mattvenn/ook-asic-radio/README.md

  

# 433 MHz OOK radio on Tiny Tapeout (sky130, ttsky26d)



A mixed-signal Tiny Tapeout project: two demo boards with the same chip talk over the air with
bare-wire dipole antennas and no external components. It should get to roughly 80 m in good conditions (estimate: the bench path loss plus the new transmitter's simulated power).

- **TX:** an on-chip ring oscillator at ~433 MHz, keyed on and off (OOK), with antiphase drivers into a dipole.
- **RX:** a 6-stage NMOS differential-pair limiting chain with a successive-detection log detector, and one comparator with an averaged, trimmed threshold. A digital Gold-code correlator detects the transmitter's code and toggles an LED.

> **Radio regulations.** This is an experimental, uncertified transmitter. Its free-running ring oscillator is not tuned: it can land anywhere in about 330–560 MHz (~448 MHz typical), mostly outside the narrow 433.05–434.79 MHz licence-exempt band, and its square-wave output has strong harmonics. That range includes frequencies used by aviation, emergency services and the 406 MHz distress beacons. Power is low (about +3 dBm, 2 mW, into the dipole), but transmitting over the air may need an amateur radio licence (the 70 cm band is 420–450 MHz in the US, 430–440 MHz in the UK and much of Europe), and where the chip lands outside the amateur band it may not be legal at all. Measure the frequency with an SDR first, keep transmissions short, and prefer the cabled link test ([docs/bringup.md](docs/bringup.md)). Receiving is fine. You are responsible for following your local rules.

Docs:
- [Interactive explainer](https://mattvenn.github.io/ook-asic-radio/docs/explainer.html): click through the link, TX and RX chains with simulated waveforms ([source](docs/explainer)).
- [docs/how_it_works.md](docs/how_it_works.md): **start here**: theory, specs, schematics and layout.
- [docs/verification.md](docs/verification.md): testing and verification, with links to every test.
- [PLAN.md](PLAN.md): the design plan and the measurements behind each decision.
- [docs/slicer.md](docs/slicer.md): how the receiver's comparator and trim servo work.
- [docs/info.md](docs/info.md): the datasheet (short test instructions).

## Layout of this repo
Follows the TT analog template flow used for `mattvenn/tt08-analog-r2r-dac-3v3`:

| Path | Contents |
|---|---|
| `info.yaml`, `docs/info.md`, `src/project.v` | TT project files; `src/project.v` is the LVS stub |
| `mag/` | Magic layout and the `make start / drc / lvs` flow (2x2 + VAPWR template) |
| `gds/`, `lef/` | Layout outputs |
| `xschem/`, `sim/` | Analog schematics, testbenches, ngspice runs |
| `verilog/rtl`, `verilog/test` | Digital macro `radio_digital` and its cocotb tests (vectors from the model) |
| `openlane/radio_digital` | Hardening config for the digital macro |
| `model/` | Bit-exact Python model and the RX performance studies |
| `bench/`, `stim/` | Phase-0 bench tools, measurements and recorded RF stimuli |
| `tools/osic` | Runs IIC-OSIC-TOOLS commands headless from this repo |

## Resources
- [Analog specs](https://tinytapeout.com/specs/analog/)
- [Tiny Tapeout](https://tinytapeout.com)
- [Zero to ASIC courses](https://zerotoasiccourse.com)
