mattvenn/ook-asic-radio/docs/sim_learnings.md

# xschem + ngspice (sky130) simulation learnings

Collected from asic-radio (ttsky26d) and mini-mosbius-configurator. These were
found the hard way; each one cost time at least once. Tool versions:
IIC-OSIC-TOOLS `hpretl/iic-osic-tools:2026.05` (ngspice 46, xschem 3.4.x),
sky130A, run headless in Docker.

## Speed

- **`.spiceinit` is read only from ngspice's current directory.** Keep one
  tracked file and copy it to wherever ngspice runs (for example `build/`). A
  wrapper script that does the copy on every run stops it drifting.
  ```
  set skywaterpdk
  set ng_nomodcheck
  set num_threads=8
  option noinit
  ```
- **`option klu` breaks `.noise`** in ngspice 46 ("Noise simulation is not
  (yet) supported with 'option KLU'"). Keep it out of the shared `.spiceinit`;
  put `.options klu` only in decks that are big transients with no noise
  analysis.
- **Never `set ngbehavior=hsa`.** It changes the default element scale
  factor. Bin selection then fails for the binned HV FET models
  (`sky130_fd_pr__nfet_g5v0d10v5` / `pfet_g5v0d10v5`, which the TT pad model
  uses), with "could not find a valid modelname".
- **Loading the model library is a fixed cost for every ngspice process.**
  The sky130 combined lib parse is ~15–25 s here and ~2 min reported elsewhere
  ([IIC-OSIC-TOOLS#262](https://github.com/iic-jku/IIC-OSIC-TOOLS/issues/262)).
  So sweep inside one process:
  ```
  foreach w 10 20 40
    alterparam w_dp = $w
    reset
    ac lin 1 433.92e6 433.92e6
    ...
    destroy all
  end
  ```
  `alterparam` needs `reset` to take effect. `destroy all` stops plots piling
  up in memory.
- **Don't run several ngspice processes in parallel blindly.** Each one starts
  `num_threads` OpenMP threads. Six processes on 8 cores gave a load average
  of 48, and nothing finished in 48 min. Run in sequence, or cut
  `num_threads`. Check with `uptime`.
- **`.save` only the vectors you measure in long transients.** For example,
  3 µs at 50 ps is 60k points × every node. With `.save v(det) v(out_p)
  v(out_n)` and one process at a time, it ran in ~47 s per case.
- **Floating nodes make it slow.** A node with no DC path made the operating
  point re-solve at every sweep point: 123 s against 25 s. Check that every
  node has a DC path to a source. Gates and capacitors don't count; MOSFET
  D-S-B and inductors do.
- **Avoid extreme resistor ratios.** 1e-12 Ω / 1e12 Ω ties hung ngspice for
  50+ min; 1 Ω / 1e9 Ω ran in seconds. ngspice also silently swaps a 0 Ω
  resistor for 1e-12.
- **"memory required ... is more than memory available" is about *free* RAM, not available RAM.** ngspice doesn't count the page cache. With 19 GiB available but 0.4 GiB free, an 80 ns / 2 ps transient saving every node died. `.save` only the measured vectors (it applies to `op` too, so list the ones the op echoes read).
- **Small probe first:** time a short run (e.g. 0.2 µs instead of 3 µs) and
  extrapolate before committing to a long one. **But the probe has to cover
  the hardest regime.** A 2 µs probe with the carrier still off predicted
  2.5 h per 400 µs. Once the carrier was on, the limiting stages switched
  hard and the run went ~5–10× slower.
- **Long runs: keep the PC awake and detach.** The PC suspended overnight;
  the job survived but made no progress. Use
  `systemd-inhibit --what=sleep:idle ...` around the job (asic-radio:
  `tools/longrun <name> <cmd>`, detached, logged, with a done marker).
- **`write` only happens at the end of a batch run:** a killed or crashed
  long run leaves nothing. Split very long runs into pieces when you can.

- **A failed `op` silently becomes a "transient op".** When gmin and source stepping both fail, ngspice ramps the sources in a pseudo-transient and reports whatever the circuit holds at the end: slow nodes (big RC) are unsettled and supply currents include charging current, with no error. Grep the log for `Transient op started` / `singular matrix` before trusting an op. In extracted netlists the usual cause is nets with only parasitic C (unconnected pin stubs): tie them to ground through 1 GΩ.
- **An `op` can also "converge" with KCL unbalanced at one node, and no warning.** On the 53k-node rc tile, the off op at tt 10 °C stopped with the TX enable NAND's output `ring` at 1.78125 V (VDD 1.8) and 4.1 µA in each of its on pull-ups that no device sinks: the supply current read 9.11 µA, true 0.908 (fs 50 °C: 1.517, true 0.945). Signs: the node on a 1/512 V grid, the only node far from its neighbours' run (the same netlist at 27 °C is fine), and tighter tolerances giving another impossible answer (`ring` above VDD, negative supply current). Find it by diffing all node voltages against a good run (another temperature, or the c-mode netlist), save the suspect devices' `@m…[id]`, and confirm with `.nodeset` on the node. `tb_tile.py` now nodesets `ring` and warns if it isn't at VDD ([verify_lna_lo.md](verify_lna_lo.md), follow-up 2026-11-08).
- **Getting values out of an op in `.control`:** `reset` reloads the circuit and drops `save` commands given before it, so `save` after `reset`. A deck's `.save` list limits both `write … all` and `$&v(…)` in `echo`: add the node there. One invalid vector in `save` (e.g. `@m…[ib]` on the sky130 BSIM4 fets) makes `write` fail with "no writable vector found" and leaves an old raw in place.

## Watching a running ngspice

- **Batch mode reports progress.** ngspice writes `Reference value : <x>`
  (sim time, or frequency for AC) with carriage returns. Log to a file, don't
  pipe to grep, then:
  ```
  tr '\r' '\n' < run.log | grep Reference | tail -1
  ```
  No Reference line yet means it's still loading models.
- `ps -o etime,time,pcpu,rss -C ngspice` shows CPU time and memory. Flat RSS
  says nothing about progress when you aren't saving many vectors.
- **Killing jobs:**
  - `pkill -f "<pattern>"` also matches the shell running the pkill if the
    pattern is in its command line. Kill by PID.
  - A Docker container outlives a killed wrapper shell: `docker ps`, then
    `docker kill <id>`.
- **Don't edit a shell script while it's running.** Bash reads scripts from
  disk as it goes. A killed child returns control, and bash carries on at the
  old byte offset in the *new* file. Here that re-launched the whole Docker
  job.

## xschem

- Netlist headless: `xschem -n -s -q -o build tb.sch`. **Check the netlist
  for `IS MISSING`**; the exit code doesn't tell you.
- **Property values can't contain `{}`.** Use ngspice `'expr'` quoting:
  `value='rl_dp'`, `W='w*(1+mm/2)'`.
- **A double quote inside a code block (`value="..."`) truncates the block**
  in the netlist. The usual sign is ngspice's "Missing .endc". Write `echo`
  without quotes: `echo $p $&avg`.
- **Subcircuit parameters:**
  - In the symbol, set `format="@name @pinlist @symname w=@w rl=@rl"` and
    `template="name=x1 w=20 rl=4k"`.
  - xschem puts the template defaults on the `.subckt` line. Instances
    override them (`w='w1'` can refer to a testbench `.param`).
  - Inside the subcircuit, use `'w'`.
- Ports and labels connect by name (`lab=`). A port symbol needs no wire.
- **No dots in top-level net names:** they clash with ngspice's `x1.node`
  hierarchy syntax.
- sky130 MOS symbols:
  - `W` is the *total* width (split over `nf` fingers); `mult` multiplies the
    device.
  - Narrow fingers carry noticeably less current per µm.
  - **Mirror ratios across fingers of different W:** each finger W is its own model bin
    (4.55 µm fingers give ~12 % more current per µm than 2 µm ones at L 2). Under
    `.spiceinit`'s `set skywaterpdk`, `W` total + `nf` also bins differently from the same
    fingers written as `W` per finger × `mult` (which is how magic extracts them): write
    folded devices that way. Run device sweeps from `build/`, so `.spiceinit` is read.
  - Instance names get the `X` spiceprefix: `M1` becomes `XM1`, and internal
    nodes are `x1.node`.
- Corners: put `corner.sym` in the schematic and rewrite the `.lib ... tt`
  line in the generated netlist to sweep `ss/ff/sf/fs`. That leaves the
  committed schematics at tt.

## ngspice control language traps

- **`print -i(v1) v(a)` merges into one expression** (`-i(v1) - v(a)`). Use
  `let x = -i(v1)` and print plain names.
- **Vectors belong to a plot.** After a new analysis, the old plot's vectors
  are no longer visible. Echo or compute what you need before running the
  next analysis.
- **Noise plot names count up** across analyses (`noise1` … `noise4`), so
  `setplot noise1` breaks. After `noise ... dec ...`, the current plot is the
  integrated one, so use `setplot previous` for the spectrum. A single-point
  `noise ... lin 1 f f` makes no integrated plot: the spectrum is already
  current.
- **`if $var = string` doesn't work** for string compares. Structure the loop
  so you don't need it (`alterparam $what = $&val` works).
- **Join echo output onto one line:** `echo "$a" NOEOL`, then
  `sed -z "s/ NOEOL\n/ /g"` on the output.
- **Temperature in a control loop:** `option temp = 60` *after* `reset`.
  `set temp = 60` is silently ignored, and an `option temp` before `reset`
  gets reset.
- **`meas ... rise=N` counts from the first saved point** (`tstart` of
  `tran`). Make sure edge N falls inside the run.
- **`destroy all` deletes vectors, including `meas` results.** Keep values
  you need later in control variables: `let x = vth` then `set xs = $&x`,
  then use `$xs` (even inside `alter @v[pulse] = [ $lo $hi ... ]`).
- **`write x_$v.raw` reads a variable called `v.raw`** ("no such variable", no file). `{$v}` fixes it in plain decks, but braces break xschem property values, so unroll the cases in a generated code block instead.
- `$&vec` puts a vector's value into a string; `{$t}` puts a loop variable
  into a node name: `v({$t}p)`.
- **Switch AC sources in one run instead of separate decks:**
  ```
  alter @vant_p[acmag]=0
  alter @vcmi[acmag]=1      * then: common-mode run, PSRR run, ...
  ```
- **Measures:** `meas tran x pp v(a) from= to=`; also `avg`, `rms`,
  `find v(a) at=`. An AC measure needs `let g = db(...)` first.
- **`trnoise` + clocked sources = "timestep too small"** when a source edge
  lands on trnoise's sample grid (a breakpoint every NT, e.g. 50 ps): two
  breakpoints a rounding error apart. Offset every pulse/PWL edge by NT/2
  (e.g. `pulse(0 1.8 25p ...)`). Also: a hard ternary in a B-source (`a ? 1
  : -1`) is better written as `tanh(k*x)` at ps timesteps.
- **`.options interp`** + `tran <tstep> ... <tmax>` saves output only on the
  tstep grid while the solver still steps at tmax. That's how 400 µs at 50 ps
  steps gives a 2 MB raw file.
- **`trnoise` isn't repeatable:** `.options seed`, `set rndseed` in .control
  and rndseed in .spiceinit were all ignored. For repeatable transient noise
  (so a signal can be found by difference), generate PWL sources in Python
  from a fixed seed. Per-sample σ = d / √(2T) for one-sided density d at
  sample period T.
- **ngspice-44.2** (`iic-osic-tools:2025.07`) has a bogus fatal error,
  `Pclm ... is not positive`; ngspice 46 (`2026.05`) is fine. Pin the image
  tag; `:latest` can resolve to an old cached image.
- The OSDI load errors from the image's global spiceinit are harmless.
- **ngspice 47 exits with status 1 after a Verilator/d_cosim run** (at the cosim teardown) even though the run
  finished: the log and the raw are complete. Judge such runs by the raw file and the log's last lines, not
  the exit code.
- **Parallel runs that share a generated file race.** Scripts that write a fixed netlist name (`build/tb_tx.spice`,
  xschem's `build/tb_radio_analog.spice`, a tied-off tile netlist) and then read it back can pick up another run's
  half-written copy: run them one at a time, stagger the starts, or write per-run names (and rewrite a shared file
  only when its content changes).
- **Extract a block in its surroundings before trusting its parasitic loss.** In asic-radio the same magic
  settings on the stand-alone `lna_chain` + `log_det` and on the whole tile gave chain gains 3.6 dB apart at
  434 MHz: the stand-alone flow put 4–20 fF more on each stage node. A block bench driven from an ideal source
  (−0.3 dB) showed neither; only the chain with the real loads did.
- **Near threshold, a mixed run's detection count depends on the burst's timing against the RTL's sample clock**
  (2026-11-06, asic-radio `lna-lo-shunt` item 5). `gen_det.py` starts every burst at the same instant (`LEAD`),
  and the slicer scores only 4 of the 8 sample alignments of a chip. So every seed at one level gets the same luck,
  and the count can be non-monotonic in level: low gain gave −88 dBm 7/20 but −90 dBm 16/20.
  - `sim/mixed/replay_corr.py` replays the RTL's detection from a finished run at all 8 alignments. At the RTL's 4 it
    matched the event pin 60/60; the other 4 are a burst 13 µs later. Averaged: 90 / 68 / 40 % at −86 / −88 / −90.
  - **Rule:** near threshold, quote detection averaged over burst timing (the replay's both parities, or bursts
    started at several offsets), not one fixed-timing seed set.
- **d_cosim (Verilator) can lose a slow analog edge at an `adc_bridge`** (ngspice 47, 2026-11-05, asic-radio
  `lna-lo-shunt`). The comparator output `comp` reached the RTL through `adc_bridge(in_low=0.6 in_high=1.2)`. In
  low gain the comparator has only 0.2–0.5 mV of input and lingers mid-swing (0.1–1.0 V) at a clock tick.
  After such a tick the RTL read `comp_in = 0` for ~2.3 ms (≈170 servo ticks) while `v(comp)` sat at 1.8 V, and
  the trim servo ran from 176 to 0. That can't happen on silicon.
  - ngspice's stock `scripts/src/verilator_shim.cpp` ignores UNKNOWN inputs (`if (val == UNKNOWN) return;`),
    which is a likely part of it.
  - It isn't fully root-caused: a single 0.9 V threshold alone still failed 5 of 15 runs.
  - Adding a `dac_bridge` probe on the digital node (`acprobe [comp_in] [comp_in_a] d2a`) cured 15 of 15 runs,
    and digital and analog then never disagreed. So it looks like a simulator event-handling artefact.
  - `sim/mixed/gen_mixed.py` now uses the single threshold and the probe.
  - **Rule:** when a slow analog net feeds d_cosim, save the digital node through a d2a and check it against the
    analog one.
  - **TODO:** make a minimal reproducible case for an ngspice bug report / PR. That means a tiny d_cosim model
    (a counter that steps up on 1 and down on 0, like the trim servo), a slow ramp or noisy near-threshold
    source into an `adc_bridge`, and the same deck with and without the probe. Start from `build/repro_dcosim/`
    on sim-0, which is not in git:
    - `mixed_-88_s3_lo_orig.cir` is the failing deck, with the first runaway at 3.66 ms.
    - `_th` is the 0.9 V threshold only, still failing.
    - `_lofx` and `_lofxp` are the fixed variants.
    - `det_-88_s3_lo.inc` is the det waveform. Run the decks from a directory one level below it, as the
      `.include ../det_…` line expects, with `radio_digital.so` (`sim/mixed/build_so.sh`).
    - Confirm the disagreement directly by re-running `_orig` with `comp_in` saved through a d2a only at
      `.save` time, if that doesn't itself cure it.

## Noise analysis recipes

- **Comparator/amp decision noise = `onoise_total` / DC gain**, not
  `inoise_total`. `inoise_total` integrates the input-referred density over
  the whole sweep. Above the amp's pole the gain is tiny, so that density
  explodes, and band-limiting looks like it *adds* noise (0.31 mV → 1.85 mV
  here, where the real figure went 83 µV → 28 µV).
- After `noise ... dec ...`, the *current* plot holds the totals
  (`onoise_total`, `inoise_total`); `setplot previous` is the spectrum.

- **NF from the noise analysis:**
  `NF = 10·log10(onoise² / (|G|² · 4kT·Rs))`. G is the AC gain from source
  EMF to the output; T = 300.15 K (ngspice's default 27 °C). The source
  resistor's own noise is included in onoise.
- **For a symmetric differential circuit fed by two antiphase sources**,
  `inoise_spectrum` referred to *one* of them equals the noise per volt of
  differential EMF. That gives a one-line NF inside a sweep.
- **Per-device noise contributions:** a summary on a single point,
  `noise v(out) vsrc lin 1 f f 1`, then `print all`.
  - The entries are `onoise_<dev>` in V/√Hz (square them to add).
  - MOSFETs give a total `onoise.m.x1.xm1.msky130...` plus sub-terms (`.id`
    thermal, `.1overf` flicker, `.rbpb`, ...). Don't sum the total and the
    sub-terms.
- **sky130 `nfet_01v8` flicker noise is still significant at hundreds of
  MHz** in the models (~40 % of a min-L input pair's noise at 434 MHz);
  `pfet_01v8` shows almost none. Even so, a wider or higher-current NMOS pair
  beat a PMOS pair on NF at RF.
- **Monte Carlo mismatch in sky130:** `.lib … sky130.lib.spice tt_mm` (also `ss_mm`, `fs_mm`, …) sets
  `MC_MM_SWITCH=1`: Vt (and R, MIM C) get an `AGAUSS` per device, scaled 1/sqrt(W·L·mult). Each
  `reset` in a control loop redraws. To find which devices matter, zero one type's term after the .lib:
  `.param sw_mm_vth0_sky130_fd_pr__pfet_01v8_lvt=0`. A_Vt in this PDK: nfet 3.4, nfet_lvt 5.5, pfet 5.9,
  **pfet_lvt 10.9 mV·µm**.
- **Monte Carlo draws repeat across processes unless seeded (ngspice 47).** Without a seed every ngspice
  run starts from the same AGAUSS sequence, so N parallel jobs give N copies of the same samples
  (asic-radio phase 2: "200" comparator samples were 8 × 25). `set rndseed` and `option seed` in .control
  are ignored; `.options seed=N` in the netlist works, but every `reset` re-seeds to N, so a reset loop then
  repeats one sample. What works: one sample per ngspice process, each with its own `.options seed`
  (`sim/comp_ct/tb_comp_ct.py`). Check for duplicate rows after any MC run.
- **A `meas` result lives in its analysis's plot.** After the next analysis, `$&off0` is gone ("no such
  variable"); copy it first with `set o0 = "$&off0"`. `$&` takes a vector name only: `let d = v(a)-v(b)`
  then `$&d`, not `$&v(a)-v(b)`.
- **trnoise doesn't repeat between runs in ngspice 47.** `.options seed=1`,
  `set rndseed=1` (in the deck or `.spiceinit`) and `setseed 1` all give
  different noise on each run. To share noise between runs (e.g. an on / off
  pair), write it once with numpy and read it with an XSPICE filesource:
  `anz %v([nzp nzn]) nzsrc` + `.model nzsrc filesource (file="nz.txt" ...)`
  (columns: time, then one per output), then `E` sources put it in series.
  The source doesn't add breakpoints, so cap the step (`tran ... tmax`) at the
  sample spacing.

## Python side

- Read raws with a small binary/ASCII raw reader (asic-radio
  `tools/rawread.py`). Keep plotting in the host venv (numpy, matplotlib),
  not the container.
- NumPy 2: `np.trapz` is gone, use `np.trapezoid`.
- Generate schematics from Python (asic-radio `tools/xsch.py`): place
  symbols, then put `lab_pin`s exactly on pin coordinates. It's repeatable,
  diffable, and parameter sweeps don't need GUI edits.

## Silicon vs sim (ring oscillators)

- **tt08/ttsky25b ring** (18 × inv_2 + nand2_2, extracted): 598 MHz at tt
  extracted, measured 518 MHz, so ×0.866. That's between tt (598) and ss
  (495). It isn't temperature (+0.5 % from 27 to 60 °C at 1.8 V) and it isn't
  VDD (good on the demoboards). Use it as the empirical sim → silicon factor
  for new rings.
- **Same chip, ring 2** (36 × inv_2 + nand2_2): ~285 MHz measured. Both rings
  re-extracted alone with magic 8.3.642 R+C (`layout/pex.sh` flow) give
  611 / 337 MHz tt, so silicon / extracted = 0.843 / 0.847: one factor at both
  lengths. Match the kind of extraction: 0.866 is against the whole-tile
  extraction (598, ring + wiring to the driver), ~0.845 against the ring cell
  alone.

## Silicon vs sim (mini-mosbius)

- The chip measured was an **ss** part: ring 11 % slow, inverter gain 17 %
  high, both explained by the corner. Fitting the corner took **both**
  circuits:
  - an inverter's trip point pins the N/P strength ratio (fs/sf);
  - a ring's frequency pins speed (barely separates fs from tt).
- Routed parasitics matter: real bus-wire capacitance took a ring from
  ~93 MHz down to ~38 MHz (measured ~30 MHz).
