mattvenn/ook-asic-radio/docs/layout.md

# Layout flow (KLayout pcells → DRC/LVS → PEX → re-simulation)

Developed on `tx_drv` first; the same steps apply to every analog block.

## Steps
1. **One-time setup:** `tools/osic bash tools/kpcell_setup.sh`.
   - The sky130 KLayout pcells in the PDK (Mabrains, `libs.tech/klayout/python/cells`) need gdsfactory 8.x, but the tools image has 9.x.
   - This installs gdsfactory 8.5 into `build/pyold`, which `layout/gen/lay.py` puts first on `sys.path`. The pip copy of `klayout` is removed so KLayout's own module wins.
2. **Generate:** `tools/osic klayout -b -r layout/gen/<block>.py` writes `layout/<block>.gds`.
   - `layout/gen/lay.py`:
     - `Fet` wraps a pcell (W total, split over nf) and reads its terminals from the geometry: met1 S/D strips, gate pads, guard ring outer/hole, diffusion;
     - `Block.via` fills DRC-safe cut arrays (per-axis enclosure for narrow strips);
     - `Block.stack` builds metal stacks; `Block.pin` adds pins.
3. **Check:** `tools/osic bash layout/check.sh <block>` (~10 s) runs:
   - magic DRC (full), the KLayout `sky130A_mr.drc` deck (feol + beol);
   - magic antenna check (flattened, own session) and a per-layer metal density report;
   - netgen LVS of the magic extraction against the xschem netlist (`top_subckt`, `lvs_netlist`).
   - Results in `build/lvs/<block>/`.
4. **Extract:** `tools/osic bash layout/pex.sh <block>` (magic, flattened; extresist + C to 0 fF).
   - `layout/pexfix.py` reorders the ports to the schematic's `.subckt` order (instances connect by position) and ties any substrate port to VSS.
   - Output: `layout/pex/<block>.spice`.
5. **Re-simulate:** `tools/pexswap.py` `swap(deck, [blocks])` removes the schematic subckt from a netlist and includes the extracted one.
   - `sim/tx/tb_tx.py --pex <corners>` does this for `tx_drv`; outputs are tagged `_pex`.

## Checklist (every block, and the top level)
From the IIC-JKU guides and our own lessons:
- the circuit designer's etiquette: <https://github.com/iic-jku/analog-circuit-design/blob/main/content/appendix/_app_circuit_designers_etiquette.qmd>
- the layout chapter: <https://github.com/iic-jku/design-complex-ic/blob/main/content/layout/_sec_layout.qmd>

**Before drawing**
- [ ] **Floorplan first, top-down** (their "common mistake": lots of cells, then a mess at assembly). Each block gets a target outline, pin sides and rail heights from the floorplan.
- [ ] **Unit devices in the schematic for anything matched:** same W and L, a ratio from multiples of a unit. Fix it in the schematic, not in layout.
- [ ] **Digital controls into analog blocks are buffered locally**, by an inverter on the block's own supply (`sc_phi1/2`, `rx_en`, `dbg_en`, `trim[7:0]`).
- [ ] **A defined off state:** no floating nodes when powered down. The block testbench covers off and start-up, not just on.

**Supplies, grounds, noise**
- [ ] **Noisy and quiet are separate.** TX (VAPWR + its VSS) and RX get their own supply/ground routing, joined only at the met4 straps / met5 PDN.
  - Guard rings and substrate ties of the RX go to the RX's own quiet ground, never to a TX return.
  - TX far from the RX input.
- [ ] **VDD and VSS run as a pair** (small loop): each met4 strap of one net next to a strap of the other, on both the left and the right of the tile.
- [ ] **Decouple to the right potential,** and check the bond-wire L + on-chip C resonance (`sim/chain/stability.sh`).
- [ ] **Hot spots:** the TX drivers dissipate ~50 mW. Keep matched devices far away or on a symmetry line through the hot spot.

**Devices**
- [ ] **PMOS grouped, NMOS grouped** (rows): the diffusion-to-nwell spacing is large.
- [ ] **Series devices of equal W share a diffusion** (multi-finger pcell, e.g. the NAND's series NMOS).
- [ ] **RF gates:** each gate finger's resistance < 1/gm. Watch finger width, and contact both ends for the LNA chain if needed.
- [ ] **Matching:**
  - identical units, the same orientation and the **same current direction** (no snaking);
  - dummies at the edges, **tied to a defined potential, never floating**;
  - common centroid for pairs, symmetric wiring parasitics;
  - no low-level metal over sensitive devices;
  - matched PMOS away from nwell edges (well-proximity effect).
- [ ] **Matched R and C arrays:** unit elements at a constant pitch, dummies tied off, common centroid for ratios.

**Wiring**
- [ ] **Measure the currents** in the block testbench, then size widths and **cut counts** (≥ 2× the tech-LEF limits; table below). The generator prints the cut check.
- [ ] **Label internal nets** (`Block.label`), so LVS and PEX name them (`y4`, not `a_4018_655#`).
- [ ] **No met5** (TT PDN). Power pins: met4, ≥ 1.2 µm, full height.
- [ ] **Good neighbour on density:** TT adds fill after submission, but the PDK rule is ≥ 40 % clear area per layer (li, met1–met3), so stay **well under 60 % metal** in any region.
  - No needless solid plates; rails only as wide as the current needs.
  - Mind the decaps: MIM fills met3/met4 over its whole area. `check.sh` reports density per layer and flags > 50 %.

**Checks (`layout/check.sh`)**
- [ ] Magic DRC 0, KLayout `sky130A_mr` DRC 0.
- [ ] **Antenna 0** (Magic `antennacheck`, flattened, in its own session; verified to catch a deliberate violation).
- [ ] LVS match, with pins equivalent.
- [ ] Density per layer under 50 %.
- [ ] PEX + block testbench: the extracted result is close enough to the schematic.

**Extraction for the final end-to-end run**
- Full RC per block is fine (~2 min). A full-chip RC run will be slow. Consider coupling-C-only for most of the chip, with RC only on the RF path.
- KLayout-PEX (`kpex`, sky130A supported) can cross-check magic's extraction.

## Verification policy: block tests, one end-to-end at the end
- **Per block, a small dedicated testbench** (`tb_<block>`): ideal stimulus, the block's real load, and measurement of just what the block must do.
  - Run it on the schematic and on the extracted layout (`pexswap`) and check the layout is close enough. That's seconds to minutes, not the whole chain.
- **Don't re-run the end-to-end testbenches (`tb_tx`, the joined RX, `tb_radio_analog`) per block.**
- **One end-to-end run on the fully extracted design right at the end**, after top-level integration.

## Pcell facts (sky130 g5v0d10v5, Mabrains)
- **Finger width:** the pcell's `w` is per finger. S/D strips sit at a 0.8 µm pitch (L 0.5); each is li + mcon + a 0.23 µm met1 strip.
- **Strips need widening for via1:** at 0.23 µm they're too narrow. Widen to 0.29 µm (via1 0.15 µm + 0.07 µm each side; 0.085 µm along the strip).
- **Gate pads:** met1, on one side (`gate_con_pos` top/bottom). From nf ≥ 2 they're staggered on two heights; finger 0 is nearest the diffusion.
- **Guard ring (`bulk='guard ring'`):** tap + li only, no metal. Add mcon + met1 yourself.
- **Wells and markers:** each pcell carries its own nwell/hvi. Draw one nwell over the PMOS row and one hvi over everything so neighbours merge (`nwell.9` needs the hv marker to cover the HV nwell).

## Power: how the TT PDN connects (checked 2026-10-08)
Sources: <https://tinytapeout.com/specs/analog/#power-pins>, tt-multiplexer `ol2/tt_top/pdn.tcl` + `build.py`, tt-support-tools `precheck/pin_check.py`.
- **Top-level grid:** horizontal **met5** stripes, 8.75 µm wide with 2.25 µm spacing, set pitch 57.12 µm (= branch pitch / 5).
  - Nets: vdpwr, vgnd, vapwr. Each set probably holds one stripe of each net; the order hasn't been confirmed.
  - The macro grid is `add_pdn_connect -layers met4 met5` on the `tt_um_*` macros. **Any met4 power-pin shape that crosses a same-net met5 stripe gets via4s automatically.**
- **Our power pins** (precheck + spec):
  - **met4**, ≥ 1.2 µm wide, vertical;
  - each rectangle starts within 10 µm of the bottom edge and reaches within 10 µm of the top (so it crosses every stripe);
  - **several pins per net are allowed**, with different sizes;
  - pins must not overlap or abut each other.
- **No met5 in our design** (reserved for the PDN). The 3.3 V supply needs the `_3v3` template and `uses_vapwr: true` (done).
- **The templates start with the straps on the left.** That's a convention, not a rule: **put VAPWR/VGND (and VDPWR) straps on both the left and the right of the tile**, and more if useful, for a lower-impedance connection to the PDN.
- **IR drop:** about 20 mA gives ~0.1 V drop through the PDN (spec). The TX takes ~11 mA average (two arms) from VAPWR in ~50% bursts, so strap count and width matter here.

### Block convention (so the top level is easy)
- **Rails:** every block has full-width horizontal rails: VAPWR (or VDPWR) along the top and VSS along the bottom, stacked **met1 + met2 + met3** with via arrays. Rail height is 2.5 µm for the TX driver.
- **Top level:** full-height vertical met4 straps (the power pins) on the tile's left and right edges, plus a mid strap if needed. They meet the blocks' met3 rails with via3 arrays where they cross, or through short met3 spurs.
- **Signal pins:** met2/met3 at block edges, the TX output on met3 (2.5 µm).

## Current limits: EM and IR (sky130, from the tech LEF)
Source: `$PDK_ROOT/sky130A/libs.ref/sky130_fd_sc_hd/techlef/sky130_fd_sc_hd__nom.tlef` (`DCCURRENTDENSITY` / `ACCURRENTDENSITY`, Tj = 90 °C; at ≤ 50 °C the lifetime is far longer, but keep ~2× margin anyway).

| layer | DC avg | AC RMS |
|---|---|---|
| met1, met2 | 2.8 mA/µm | 6.1 mA/µm |
| met3, met4 | 6.8 mA/µm | 14.9 mA/µm |
| met5 | 10.17 mA/µm | 22.34 mA/µm |
| mcon | 0.36 mA per cut | |
| via1 | **0.29 mA per cut** | |
| via2, via3 | 0.48 mA per cut | |
| via4 | 2.49 mA per cut | |

- **Vias are the weak point.** A 1 mA path through one via1 is 3.5× over. Size every layer change in a current path by cut count: cuts ≥ 2 × I / limit.
  - Use the RMS current for AC nets and the average for supply nets; the LEF only gives DC per cut, so treat it as the limit for both.
- **Sheet resistance:** met1/met2 ~0.125 Ω/□, met3/met4 ~0.047 Ω/□. Wide met3 is cheap and strong, so stack big currents onto met3.
- **Measure the currents with the block testbench** (0 V ammeters in the schematic subckt), then size. Don't guess.

### tx_drv currents (tb_tx_drv, tt, ideal 434 MHz drive, per arm)

| path | avg | RMS | peak |
|---|---|---|---|
| stage 5 PMOS source / VAPWR | 6.65 mA (DC) | 9.45 mA | 18.4 mA |
| stage 5 NMOS source / VSS | 2.29 mA | 3.62 mA | 11.9 mA |
| out | ~0 (AC) | 9.8 mA | 16.9 mA |
| y4 (stage 4 drains → stage 5 gates) | | ~1.45 mA each side | 7.4 mA |
| y3 and earlier | | ≪ 1 mA | |

### v1 layout lessons (one column per stage)
- **Under-sized connections:**
  - **Gate links** land with a single via1 on a 0.37 µm met1 riser, so y4 sees 5× over the via1 limit.
  - **Source strips:** the stage 5 PMOS inner source strips at 0.29 µm met1 are rated 0.81 mA and carry ~0.95 mA average.
  - **Output bar:** the 2 µm met2 out bar has too little RMS margin.
- **Measured cost:** the extracted layout loses 0.46 dB, edges are +30 ps and the in→out delay is +26 % (+5.35 vs +5.81 dBm).
- **Floorplan waste:** one column per stage makes every small stage as tall as the 10 µm-finger output stage. The empty space was filled with met1 plates to the rails.
  - Better: pack the PMOS and NMOS rows separately, with finger heights chosen so the rows are the same length.
  - Use one guard ring per row, and a met3 horizontal / met2 vertical routing channel between the rows.

## Simulation gotchas (layout-specific)
- **Save only what you measure** on extracted netlists. Thousands of R nodes × timepoints overflow ngspice's output memory ("memory required … more than memory available"). Use a `save` list in `.control` before `tran`.
- **Subckt source names:** in `meas`, use `let` to make vectors first: `meas` won't take expressions. Sources inside subckts are named `v.<inst>.<name>`, e.g. `i(v.xdp.vd5p)`.
- **xschem top-level subckt:** outside LVS mode it writes `**.subckt` / `**.ends` (commented) even with `top_subckt 1`. With `lvs_netlist 1` they're real.
- **Edge thresholds:** under the pad + dipole load, `out` doesn't reach 80 % of 3.3 V. Measure 20–80 % of the actual swing.

### v2 (current, 2026-10-08): packed rows + routing channel
- **Floorplan:** PMOS row (fingers ≤ 8 µm) and NMOS row (≤ 4.5 µm), one shared guard ring each (the PDK `guard_ring_gen` pcell, met1), a met3-track / met2-stub channel between them, rails 3 µm.
  - Per-net stub/track widths and drain-bar heights come from the measured currents; the generator prints a via1/via2 count check against 2× margin.
- **Result:** 40.9 × 27.6 µm (1129 µm², −19 % vs v1). DRC/LVS clean. Block test (tt) vs schematic: −0.32 dB, edges +30 ps, delay +35 %.
- **Left on the table** (not worth it yet): the NMOS row has a gap (each N is aligned under its P), and the small PMOS devices still hang from tall source straps. Possible fixes:
  - stack NAND/inv1/inv2 as a mini-cell in the top-left corner;
  - pack the NMOS row tight.

### v2 lessons
- **Magic interprets each GDS cell on its own.** A tap only becomes an HV n-well tap when nwell + hvi are in the same cell. The ring pcell has no well, so flatten it into the cell that has the wells (`lay.ring` does).
  - Symptoms: nwell.4 "nwells must contain N+ taps", LU.3, nwell.8 "HV to LV nwell".
- **Ringless (`bulk='None'`) nfet pcells leave notches in hvntm** (hvntm.2), and neighbours sit closer than its 0.7 µm spacing. Draw one hvntm rectangle over the whole NMOS row.
- **Overlapping via arrays from two `stack()` calls** (a bar running into a riser) give via2.1a/via2.2 errors in KLayout. Magic doesn't flag them, so let shapes abut instead of overlap.
- **A riser spanning rail to rail shorts `out` to both supplies.** LVS shows it as "(no pin, node is out)" for VAPWR/VSS.
- **Narrow met2 stubs:** via2 needs 0.04 µm met2 enclosure on two sides and 0.085 µm on the other two. That fits a 0.28 µm stub, with the track (met3) extended 0.1 µm past the end stubs.
- **Magic DRC locations:** `check.sh` now prints them in µm (`cif scale out`). Magic's `what -list` needs a `select area` first.
- **Magic's `antennacheck` can silently report nothing.** It is only trustworthy:
  - on a **flattened** cell: on the hierarchy it misses pcell gates driven by metal in the parent;
  - in a **fresh session**: after the LVS extraction in the same session it found nothing;
  - with **`antennacheck debug`**: otherwise violations only go to the feedback list.
  - Verified with a deliberate violation (`layout/gen/ant_test.py`: a 0.5 × 0.42 µm g5 gate on 300 µm² of met1, ratio 1033 > 400).
- **Net labels:** text on the metal's label purpose (e.g. 70/5) without a pin shape names the net in magic's extraction without making it a port.

## Row builder (`layout/gen/rows.py`) and the TX level shifters (2026-10-08)
- **`rows.build(block, P, N, nets, ...)`** is `tx_drv` v2's machinery made generic. A block generator just lists its devices (`Dev`: FET, strip roles, gate groups, drain net, rail) and nets (`Net`: stub/track widths, RMS current, io `L`/`R`/`riser`).
  - **Segments:** devices are grouped by oxide (thin / g5) and rail into columns. Each column gets its own rings, nwell, hvi/hvntm (HV only) and rail section.
  - **Segment gap:** 4.7 µm between columns, diffusion to diffusion (rings, wells, HV/LV nwell spacing 2.0 µm).
- **Channel routing lesson:** a P stub (going down to its track) and an N stub (going up) at the same x short in met2 if the P net's track is below the N net's. `tx_drv` avoided this by luck; `tx_ls` hit it (LVS: A shorted to ctrl_n).
  - Fix: plan every stub's x first, add a vertical constraint (P net above N net) for each overlapping pair, and assign tracks with the constrained left-edge algorithm. Nets still share tracks when allowed.
  - `tx_drv` got 0.45 µm shorter from the better sharing.
- **Parameter variants:** a generator writes `layout/ref/<variant>.spice` (the xschem netlist with the parameters substituted and evaluated). `check.sh` and `pex.sh` use it when present.
  - Even the default variant needs one: netgen can't evaluate `W='0.42*kn'` and reports "property errors".
- **Viewer links:** `python3 tools/gds_links.py` rewrites `layout/README.md` with a TT GDS viewer link per block (they work once pushed).

| block | size | DRC / antenna / LVS | block test (tt), schematic → extracted |
|---|---|---|---|
| `tx_drv` | 40.9 × 26.7 µm | clean | −0.32 dB into the dipole |
| `tx_ls` (kn 10, kp 4, wpi/wni 9/3) | 13.8 × 19.0 µm | clean | A edges ~100 → ~190 ps; in→A rise 392 → 660 ps; **A duty 37.3 → 28.4 %** |
| `tx_ls_en` (all ~minimum) | 12.9 × 12.5 µm | clean | delay 1.1 → 3.4 ns (irrelevant: the enables switch at chip rate) |

- **Fixed (mostly): the main shifter's duty cycle.** The slow path was in → ctrl → **ctrl_n** (dac_drive's tiny hvt P 1 / N 0.42 inverter driving M10's thick gate + the ctrl_n wiring). kp 6 didn't help (extracted 27.8 %).
  - **M8/M7 upsized to 4 / 1.68** (`xschem/gen/tx.py`). tt extracted: A duty 28.4 → **35.8 %** (schematic 41.8 %); arm output duty 38.6 / 43.7 % (schematic 44.1 / 47.6 %), about −0.4 dB of fundamental vs schematic.
  - Judge the rest in `tx_top`, with the shifter right against the drivers' inputs.
- **`tx_ring`** (`layout/gen/tx_ring.py`): std cells (PDK GDS copied in): one row of 22 `inv_2` + `nand2_2` + 4 taps, 34.5 × 4.2 µm.
  - Stage straps on met1 (mcon on the li pins), the `out` return on met2, `en` on met3 from the left edge. Block rails 1 µm (m1–m3) over the cells' rails.
  - **LVS with std cells:** `check.sh` loads the hd spice library on the schematic side (netgen tcl).
  - The reference (`layout/ref/tx_ring.spice`) drops the schematic's `cw` caps: they're a wiring estimate, not devices.
  - **Block test** (`sim/tx/tb_tx_ring.py`, into the main level shifter, tt): schematic (cw 3.2 fF) 485.4 MHz → **extracted 508.5 MHz** (+4.8 %, less wiring than the ttsky25b calibration). Silicon estimate ×0.866 → **~440 MHz** (target 433.92), out duty 47.9 %. Keep 22 inverters.
  - Density reads 51–55 % on m1–m3, because the 4.2 µm-tall block is half rails; it averages out inside `tx_top`.
  - **Folded (v2, 2026-10-08):** two rows that share the middle VDD rail. Row 0 has inv 1–12 left → right. Row 1 is rotated R180 (`pya.DTrans.R180` placed at `(x + w, 2H)`) and has inv 13–22 + nand right → left.
    - With a tap at each end, the pins line up vertically: inv12 Y / inv13 A at the turn, and nand Y / inv1 A at the left. Both crossings are short met2 verticals.
    - The middle rail is m1 + m3, with m2 only between the two verticals. The VSS rails (bottom, top) are joined by a met2 strap at the right edge. `out` and `en` pins are on met3 at the left edge.
    - Result: 17.9 × 7.0 µm (was 34.5 × 4.2). `out` 10.6 → 3.3 fF, `en` 11.5 → 1.6 fF.
    - **Frequency:** extracted tt 508.5 → **529.9 MHz** (~459 MHz on silicon; the long `out` wire had been acting as ~7 fF of load). Within the untrimmed spread the RX band covers. To get back to ~433, use 24 inverters (~422).
- **`r2r`** (trim DAC, **reused** from tt08-analog-r2r-dac-3v3): the magic sources are copied unchanged into `layout/src/r2r/`; `layout/gen/r2r.sh` writes `layout/r2r.gds`. 71.8 × 54.1 µm (3,882 µm²; the area estimate had 3,866), pins on met1 along the bottom (b0..b7, out, VGND).
  - Clean against `xschem/r2r.sch`, which was drawn to match the layout device for device: DRC 0, antenna 0, LVS match. Density m1 27 %.
  - **Block test** (`sim/dac/tb_r2r.py`, tt): extracted output error ≤ 0.021 LSB; Rout 10.65 kΩ (schematic 10.64); the 127→128 carry into 1 pF settles to 0.1 LSB in 30.6 ns (schematic 24.6), irrelevant at the servo's µs steps.
  - `check.sh`'s "feedback N" counts magic's extraction warnings too (2 here, from flattening); the antenna count is the 'Antenna violation' lines.
- **Row builder: pass devices.** A strip role can now be any net name, so both sides of a transmission gate can be signals.
  - With several strip nets on a device, all its stubs are packed side by side in natural x order across the device, up to DGAP/2 into the gaps. Bars and straps extend to their stubs.
  - Single-drain devices keep the old placement (`tx_ls` identical; in `tx_drv` only the NAND's in/en tracks swapped).
  - `build()` leaves `b.rows` (rails, tracks, track x spans) for generators that add more (caps, wiring).
- **`lay.write_ref(name, sch, params, drop)`:** a parameter-substituted LVS/PEX reference from any xschem cell (netgen can't evaluate `W='wcs'`, `m='nca'`).
- **`avg_sc`** (`layout/gen/avg_sc.py`; v2 77.4 × 30.4 µm = 2.35k µm², v1 74.5 × 43.6 = 3.25k):
  - **Why v2:** in steady state, any charge a clock leaves on `cs` or `out` per cycle shifts the average by ΔQ/Cs. Cavg doesn't dilute it, and Cs is only 0.1 pF. v1's phi/phib wiring imbalance (~0.19 fF on both `cs` and `out`) × 1.8 V / Cs ≈ 3.4 mV: the ±4 mV static offset seen in its block test.
  - **Symmetric channel** (fixed track order, `rows.build(order=...)`), top to bottom: `phi2b phi1b | shield (VDD) | in out cs | shield (VSS) | phi1 phi2`.
    - phib (P gates) on top, phi (N gates) at the bottom, mirrored. Each TG's P and N stubs sit at the same x, so a signal stub crosses phib going up exactly as its partner crosses phi going down. Gate stubs cross no signal track.
    - The shields stop sideways coupling from phi1b into `in`, and from phi1/phi2 into `cs`. They rise to VDD and VSS right of the ring.
    - **Nothing crosses the channel.** `cs` and `out` leave on met4 risers right of the ring, where only the `in`/`out`/`cs` tracks reach. The phi pins rise on met4 at the left end, over the inverters, where only clock tracks run. (v1's `cs` and `out` risers crossed the phi tracks.)
    - phi2's inverter is flipped, so its rail strip, not its phi2b drain, faces S1's `in` strip.
  - **Extracted clock coupling, v1 → v2:**

    | Node | phi − phib imbalance, v1 | v2 |
    |---|---|---|
    | `cs`, phi1 − phi1b | +0.197 fF | −0.002 fF |
    | `cs`, phi2 − phi2b | −0.042 | +0.011 |
    | `out`, phi2 − phi2b | −0.194 | +0.004 |

    - Expected offset from wiring: ~0.1–0.2 mV (was ~3–4).
    - `in` still sees phi2 0.42 against phi2b 0.11 fF. That's harmless for the offset: phi2 only switches while S1 is open, and `in` is the LPF's continuously driven node, so it's a ~0.2 mV ripple decaying with the LPF τ (11 µs), not a held charge. (v1: phi2b 0.63 / phi2 0.11.)
    - Device charge injection, which the TGs balance only roughly (N 0.5 / P 1), isn't in these numbers. That needs the block test.
  - **Floorplan:** the Cavg pair is on the left, full height. The switch column is at the right with Cs hanging under its VSS rail (the plate abuts the rail). The VSS rail's met3 runs left into both Cavg bottom plates (bridging the 2 µm gap is DRC-clean in magic and KLayout). The `out` met4 strip runs along the bottom of the Cavg plates. The switches don't go under the caps: the row builder's tracks and rails are met3, the bottom-plate layer.
  - **Pins:** `phi1` and `phi2` on the top edge (met4). `in` and `out` on the right edge (met3), adjacent, for `comp_ct` (`inn`, `inp`, both on its left edge). Mirror or rotate the cell at the top level as the floorplan needs. Keep top-level clock wiring off the Cavg top plates (`out`).
  - Checks: DRC (magic and KLayout) 0, antenna 0, LVS match; m3 density 84 % (the MIM plates, now with no empty area around them).
  - **Block test** (`sim/avg_sc/tb_avg_sc.py --pex`, tt; `OSIC=$PWD/tools/osic-mac` on the Mac), schematic → v1 → v2:

    | Quantity | Schematic | v1 extracted | v2 extracted |
    |---|---|---|---|
    | τ | 0.458 ms | 0.434 ms | 0.423 ms |
    | hold drift, 20 cycles | −0.015 mV | ±1.7–1.9 mV | **+0.070 mV** |
    | static offset (drift / (1 − (1 − a)^20) ≈ drift / 0.46) | — | ~4 mV | **~0.15 mV** |

    - τ is 2.5 % shorter than in v1: `cs` carries a little more wiring C (the riser and track extension).
- **`comp_ct`** (`layout/gen/comp_ct.py`, v2 2026-10-08: **73.5 × 42.0 µm, 3.08k µm²**; v1 was 100.5 × 49.9, 5.0k):
  - **Matching:** the input pair, trim pair and PMOS mirror are split into halves placed A B B A (1D common centroid, same orientation), with rail-tied dummies either side.
  - **N row order:** core first (main pair, then the trim pair on the same d1/d2), then bias, stage 2, inverter. Mp3/Mip sit over Mn3/Min (`Dev.xmin`), so o2/out only exist at the right end of the channel.
    - v1 had the trim pair at the far right: d1/d2 ran ~90 µm and paralleled out/o2. Extracted **d2–out 7.4 fF and d1–o2 6.2 fF**, both positive feedback. v2: 0 / 0 fF.
  - **Bias devices folded into 4.55 µm fingers** (the row height) instead of 2 µm units: Mt1 4 × 4.55 (was 10 × 2), Mn3 2 × 4.55 (was 5 × 2); Mta stays 2 × 2 µm each.
    - Different W bin from Mb's 2 µm: 4.55 µm fingers give ~12 % more current per µm, so the total W is 0.91 × the units'. Against 10 / 5 units: +0.2 % tt, +3.5 % ss, −3.0 % ff, −3.4 % sf, +3.9 % fs.
    - **Schematic as W per finger × mult** (`W='0.455*mt1' mult=4`), the way magic extracts it. **W total with `nf` simulates differently under `.spiceinit`'s `set skywaterpdk`**: W 18.2 nf 4 gave 10.6 µA, not 9.8 (trim step 0.0590 instead of 0.0650). A finger sweep run without `.spiceinit` hid this.
  - **Dummies in the schematic too:** `Mdn*`/`Mdp*` in `xschem/gen/comp.py`, every terminal on the rail. Netgen doesn't ignore layout dummies.
  - **Passives: a band below the VSS rail, as wide as the rows (18.8 µm tall):**
    - Rdeg (30 × 9.0 µm xhigh) and Rr1+Rr2 (32 × 8.5 µm; a multiple of 4 so the middle link, `vref`, is a bottom one) in one p-tap ring.
    - Cl (now **2 × 22 × 11**, `MF=2`, same area) and Cref (10²) **over the ring**; their VSS met3 bottom plates shield the resistors. Order: Cl_a | risers | Cref | Cl_b.
    - Resistor ends run on **met2 lanes under the caps** to one column of met4 risers (sa, sb, VDD, vref) at x ≈ 24–27, where the sa/sb/vref tracks already are. Cref's top plate joins the vref riser on met4. Cl's two top plates rise straight to `d2`.
  - **Checks:** DRC (magic + KLayout) 0, antenna 0, LVS match; density ≤ 33 % per layer (m3, the MIM plates).
  - **Block test** (`sim/comp_ct/tb_comp_ct.py [--pex]`, tt): offset +0.795 → +0.560 mV, trim 0.0649 → 0.0656 mV/LSB, ±1 mV response 1.12/0.07 → 0.76/0.15 µs (schematic → extracted). v1 extracted: +0.56 mV, 0.0655, 0.71/0.16. The faster extracted rise isn't the out→d2 coupling (now 0); not chased.
  - **v3, trim redesign H135 (2026-10-13, [verify_supply_mc.md](verify_supply_mc.md) 2.2): same footprint and pins except inp.**
    Mirror halves 2/1 → 4/2 (Mp1/Mp2 W 8 L 2), trim halves W 1 → 4 (M3/M4 W 8), Rdeg 0.85 MΩ (30 × 3.8 µm), vref
    tap `links[15]` → `links[7]` (1.35 V: lref1 68 / lref2 204; the generator asserts a bottom link).
    - **`rows.build` lines each N device up behind the P device in the same list position**, so a longer P
      device pushes the rest of the N row. L 2 edge dummies on the mirror pushed the whole block 1 µm east: the
      mirror dummies are W 4 **L 1** (schematic `Mdp1` too).
    - **Same-net stubs side by side:** with the L 2 mirror pitch a P drain stub (d1 / d2) comes down right
      beside the N drain stub going up to the same track: met2 0.1 apart, via2 cuts 0.05–0.15 apart.
      `merge_stubs()` bridges them on met2 and keeps one cut. (Its first version also cleared the second cut
      of a pair on one merged stub; `Block.clear` takes cuts within 0.1, so it took both: LVS open.)
    - The resistor band keeps its old depth (lanes 14.65 below the rail): the shorter Rdeg would otherwise
      lift the bottom edge, and trim / ibias / out are placed from the bbox's lower-left.
    - **inp pin:** the met4 riser now runs straight up over the VDD rail to a met4 pin on the N edge (own x
      16.70), instead of turning east on met3 to x 37.85 through a gap in the rail. The router tags every metal
      polygon touching a pin as that pin, so `avg` had landed on the near end of the met3 run and left ~22 µm
      of it as a dead-end stub (STATUS 5a). Route `avg` 12.2 → 7.6 µm.
    - Checks: DRC (magic + KLayout) 0, antenna 0, LVS match. **Block test** (CM 1.0 V, sch → pex): balance code
      183.9 → 184.1 (tt), step 0.1344 → 0.1359 mV/LSB, within 1 code / 1.2 % at tt / ss / ff / sf / fs; ±1 mV
      response 0.36–0.46 µs. Extracted with magic 8.3.642.
    - The committed v2 GDS's bottom edge was −30.915; regenerated (v2 or v3) it is −30.925: the guard-ring
      pcell in the 2026.09 image draws 0.01 µm wider.
- **Row builder additions (for `comp_ct`):**
  - **`rows.dummy(fet, rail)`:** all strips and the gate on the rail. The gate strap joins the ring at a row end, or a met1 jumper in the gap to a neighbouring dummy (so dummies go at row ends or in adjacent pairs).
  - **Strip groups:** a run of one net's strips with no other signal net between gets its own bar and stub. A pair half `tail | d | tail` has two tail groups; one tail bar across `d` had shorted tail, d1 and d2.
  - **`b.rows['xs']`** spans and the `land()` pattern (in comp_ct.py): extend a track to a riser only where no other net on that track is near.
- **`lay.write_ref`** understands SPICE suffixes (`L='rdeg/7.37k'`).
- **ngspice:** element names are case-insensitive, so `VD` (supply) and `Vd` (a differential source) collide: "device already exists, bail out".
- **Earlier note on the duty cycle:** Its skewed core (weak cross-coupled PMOS pull-up) is sensitive to the ~4.7 fF of wiring on A/B, comparable to its devices' own capacitance.
  - The schematic at kp 6 gives 36.3 %; the extracted run is pending.
  - What matters is the duty at the arms' outputs, so judge it with the level shifter + drivers together, not A alone.

## bias_gen (2026-10-08)
`layout/gen/bias_gen.py`, 80.2 × 49.1 µm. DRC (magic + KLayout), antenna, LVS clean. Block test `sim/bias/tb_bias_gen.py [--pex]` (the tb_bias deck): extracted ib_chain −0.08 %, ib_det / ib_comp / vcm within 0.01 % of the schematic at VDD 1.7 / 1.8 / 1.9 V and 10 / 27 / 50 °C; start-up and re-enable identical; en = 0 leakage 0.24 → 0.50 nA.
- **Floorplan:** two bands.
  - **Bottom:** small devices (rows.py), a transition zone (met3 tracks → met2 lanes, the vcm riser and vref drop on met4), the resistors (p-tap ring on VSS) under the first Cvref unit, the second Cvref unit.
  - **Top:** the mirror array sitting on the middle VDD rail, under Cc + 2 × Cvcm.
  - **Rails:** VSS at the bottom **and the top** (the MIM bottom plates abut them, joined by a met1 strap on the left edge), VDD in the middle (the small block's rail). Not the usual "VDD on top"; the top level must land a VDD strap on the middle rail (met3, x 0–27.7).
  - Pins: en (left, met3), ib_chain / ib_det / ib_comp (right, met2), vcm (right, met3).
- **Mirror array:** 3 rows × 20 slots ABBA (A = pr, B = ib_chain; one drain strip = 2 units), point-symmetric, so the two centroids coincide; ib_det (1 slot) and ib_comp (1 finger) at the end of row 2. met1/met2 only, so MIMs can sit over it:
  - pr (diode) drain strips run straight into the met1 gate bar; rows 1 and 2 face each other and share a gate bar.
  - Sources into met1 VDD bars that join the n-tap ring; output drains to met2 buses; met2 spines join them.
  - Rows 1 / 2 pads must be 0.75 apart (poly heads poly.2 / npc.2), not 0.3.
- **Dummies are devices to netgen.** The array-end dummy fingers (all terminals on VDD) aren't dropped by netgen. They are now in the schematic (`Mdum`, m = 5), as `comp_ct` did. Magic's antenna run reports one "feedback" entry per dummy (no violation).
- **A poly resistor split into segments gets one pair of contact heads per segment.** The fitted R(L) = 526 Ω + 470.9 Ω/µm · L (high_po 0p69) is per device. Rref as two segments of one 10 kΩ device extracted **5 % high** (all currents −5 %). Now two 5 kΩ halves in the schematic. Doesn't matter for xhigh (ends ≈ 0) or a ratio of equal segments.
- **0p69 segments side by side:** the rpm marker is 1.27 wide around a 0.91 psdm. Markers must merge (pitch ≤ 1.27) or sit 0.84 apart (pitch ≥ 2.11), and at the wide pitch magic flags a 0.18 µm rpm sliver (rpm.1). Used pitch 1.2 with one psdm rectangle over both segments (psdm.1).
- **Same-net stubs:** rows.py doesn't merge two met2 stubs of one net that come within 0.14 (met2.2 in both DRCs). Mirroring M1/M2's strip roles moved them apart.
- **Area / density:** met3 is 73 % (five MIM plates). The resistors could move under the top caps (~550 µm² less) if area gets tight.
- **Shrink option (not taken, 2026-10-08):** the block is cap-limited (the 5 MIM units are ~3k of 3.9k µm²). The mirror is big because a 60 µA reference is copied 1:1 to the chain in 1 µA units (123 fingers). A 10 µA reference (Rref ~60 kΩ high_po, same tracking) with 10 / 2 / 1 µA outputs (23 units; the chain's local mirror takes the ×6) plus smaller caps (Cc has PM 90°; Cvcm / Cvref poles have room) could bring bias_gen to ~1.5–2k µm² and save ~100 µA. Needs bias_gen + lna_chain schematic changes and re-verification. Only shrinking both caps and mirror saves area.

## log_det (2026-10-09; compacted to 2 x 3, 2026-10-08)
- **`layout/gen/log_det.py`:** two rows of three `det_cell`s plus an end column. The cells are another agent's, copied in via `copy_tree` and unchanged.
  - **Rows:** the top row (t1 t2 t3) is as drawn. The bottom row (t4 t5 t6) is mirrored in y, so both rows share one VSS rail (met1–3) in the middle.
    - The inputs face out: the top row's along the top edge, the bottom row's along the bottom. t1 and t6 sit on opposite corners.
  - **Bus joins (end column):** the out/vb buses (met2) of both rows run on into the column.
    - out is joined by a met2 riser, which carries on down to Rdet's bottom end and the Cdet drop.
    - vb is joined by a met1 riser, because it crosses the out buses.
  - **End section** (bottom of the column, own p-tap ring, met1 + psdm bridged to t6's ring):
    - Mbias as a diode, its drain up to the bottom vb bus in met2;
    - **Rs_b drawn exactly like the cells' Rs** (high-po 0.35, 2 segments), so the vb replica matches;
    - Rdet (0.69, 3 segments, one RPM).
  - **Cdet** (22²) is over the column, top-aligned, its bottom plate 1.2 µm clear of the cells' met3 (their rail ends at the column).
    - Its top plate drops on a met4 strip to a met3 island 1.2 µm below the bottom plate, over the end section.
    - The bottom plate's met3 continues as a 1.2 µm strip down the right edge: the **VDD pin** (via3 from the top level, outside capm). Rdet's top end reaches it in met2.
  - **Pins:** `det` / `ibias_det` on the top row's buses at the left edge; VSS on the shared rail (met3) at the left edge.
- **Size:** **87.3 × 31.0 µm (2.7k µm²)**, was 137.4 × 39.0 (5.4k bbox, an L shape with ~2.5k µm² empty above the cells).
- **Tiling:** neighbouring cells' ring implants end 0.2 µm apart (KLayout psdm.1); `log_det` bridges psdm across each boundary in both rows. The rows' rings are 1.2 µm apart across the shared rail, so no bridge is needed there.
- **Checks:** DRC (magic + KLayout) 0, antenna 0, LVS match. The reference strips the `det_cell` instances' parameters, since netgen compares instance properties otherwise.
  - met3 density is 50 % (flagged): the 12 Cc plates + Cdet in a tight box. It's inherent to the cap content; there's no needless metal.
- **Block test** (`sim/logdet/tb_log_det.py`, tt): idle det 1.5197 → 1.4888 V; 100 mV on t6: −1.56 → −1.46 mV. This is the same as the 1 × 6 layout (1.4890 V, −1.46 mV).
- **Open:** the high-po fits have a per-device end term (0.35: 963 Ω, 0.69: 526 Ω). With Rs in 2 segments and Rdet in 3, the layout's Rs/Rdet are ~10 % high, which is the idle shift.
  - Harmless (the averaging reference absorbs it). For an exact match, draw them in the schematic as series segments.

## lna_chain (U fold, 2026-10-09)
- **`layout/gen/lna_chain.py`:** the chain folded in two for the tile floorplan. **145.36 × 70.47 µm**, placed **R180 at (13.14, 6.5)** (`layout/floorplan/pins.md`).
  - **Front row** (tile bottom): the input section as before, then amp_dp (st1) and amp_dpc (st2). The stages are mirrored top-bottom, so their in / out wiring runs along the moat.
    - Cin_p / Cin_n's pad-side tabs sit right over ua[0] / ua[1] (`TILE_RIGHT`, `UA`).
    - The drop columns from the Cin top plates go to amp_dp's lower / upper input by pin height.
    - The input section's VSS rail stops short of amp_dp's VDD rail; a met1 link takes it up to amp_dp's VSS.
  - **Moat** (14 µm): a p-tap ring tied to VSS only at the VSS column, with an n-well / n-tap stripe on VDD inside it. The rows' own rails don't touch it.
  - **Back row** (tile top): st3–st6 rotated 180, flowing back. Their in / out wiring and the taps are on the log_det edge. st5 / st6 sit across the moat from the Cin plates; st3 / st4 from st2 / st1.
  - **Turn** (tile-west end): o2 runs ~35 µm on met2 from st2's outputs to st3's inputs. nb runs beside it, and the o1 tap comes along the moat. Then the VSS (met1) and VDD (met3) columns: the only places the two rows' rails meet, under the tile's VDPWR / VGND straps.
- **Checks:** DRC (magic + KLayout) 0, antenna 0, LVS match.
- **Isolation (extraction):** 0 aF from out / o5 / o4 (wires and stage internals) into inp / inn / g1 / o1 / stage 1; o3 → o1 12 aF (its budget is ~5 fF). The budget is ≤ 0.1 fF from the output (ss 10 °C); see docs/history.md.
- **Gain and stability** (`sim/chain/stability.sh`, 2 nH, no Ccpl, the whole chain extracted). The straight chain is re-extracted with today's `pex.sh` as the reference:

| | straight: 434 MHz / peak | folded: 434 MHz / peak | kick growth |
|---|---|---|---|
| tt | 76.65 / 77.83 dB | **76.21 / 77.46 dB** | 2e-9 |
| ss 10 °C | 80.78 / 81.89 dB | **80.31 / 81.48 dB** | 3e-9 |

  - The −0.44 / −0.47 dB is the turn: o2 carries +6 fF (st2: 12.84 → 12.44 dB). The o1 tap adds +14 fF on st1's 1 kΩ (−0.09 dB). Stages 3–6 are unchanged.
- **Fold variants tried** (per-stage gain at 434 MHz, tt; total vs straight):
  - **v1:** both rows' wiring on the outer edges. Turn ~50 µm, −0.83 dB.
  - **v2:** both rows' wiring along the moat. Turn ~21 µm, but each back-row tap needs a ~17 µm met4 drop to the log_det edge (+5.5 fF each, with p–n coupling between the drops), so −1.32 dB.
  - **v3 (kept):** front row along the moat, back row on the outer edge. −0.44 dB.
- **Top level:** the tap wires to log_det load the stages the same way.
  - Tap x positions in the tile: o1 / o2 at ~17, o3 52, o4 85, o5 117, out 149.
  - log_det wants t1/t4 at ~69–80, t2/t5 ~90–101, t3/t6 ~111–122.
  - o2 → t2 (~75 µm) and o3 → t3 (~60 µm) would each cost st2 / st3 a few tenths of a dB. Worth a look when the tile is assembled (log_det orientation, or tap order).
- **ua[2]** (debug, x 98) comes up under Cin_n: route it outside the chain, not across it. A floating debug wire over st5 and Cin_n would bridge output to input.

## Pin moves for the floorplan (layout 5, 2026-10-09)
Every block re-laid out to `layout/floorplan/pins.md` (circuits unchanged; each DRC / antenna / LVS clean and its `tb_<block> --pex` unchanged or better). Where the pins went, and how:

| block | pins | how |
|---|---|---|
| lpf_rc | in S (met2), out E top corner (met3) | in drops through a gap in the VSS rail's met2 |
| dbg_tg | a, b S; en E | b's met2 bar on down through the rail; a down the W edge on met3 (x 1.0 vs 3.7: en's track runs east and blocks a drop further in) |
| log_det | det S (met2), ibias_det E (met2) | det hops the bottom row's vb bus on met3, then met2 down the edge (met3 there breaks capm.11 next to t4's Cc) |
| bias_gen | ib_chain, ib_det N (met2); vcm N (**met4**); ib_comp E top corner; en S (met2) | met2 through gaps in the top VSS rail's met2; vcm straight up from the Cvcm top-plate strip; ib_comp hops ib_det's column on met1 |
| comp_ct (MYR90) | inp, inn N (met3); ibias, trim E (**met4**); out S east corner (**met4**) | met4 risers from the input tracks, met3 under the VDD rail; out / trim / ibias tracks run east to three met4 columns (outermost stops first, so nothing crosses) |
| avg_sc | in S (met2) | down the E edge on met2 (met3: out's track and Cs's capm; met4: out's riser); phi1/2 were already on N |
| ctrim_1p (new) | trim S + E (met4), VGND W + N (met3) | one 22.035 µm MIM; L of met4 strips to the top plate (12 % met4, not a sheet) |
| r2r | none | placed MYR90 instead: out can't reach the N edge on met1 (a VGND rail) |

Lessons:
- **Draw the whole floorplan with every net before moving pins.** Two of these blocks (comp_ct, r2r) were better flipped than re-routed, and the engine's net list had comp inp/inn swapped and Ctrim in series: check nets against `xschem/gen/top.py`.
- **`Block.clear(layers, box)`** (`lay.py`) cuts a gap in a rail for a pin to drop through: whole cuts within 0.1 µm of the box are removed (no slivers), and the metal's **pin shapes** too. **Magic reads a pin shape (datatype 16) as metal**: a rail's pin box left over a cleared gap gave met3 spacing errors KLayout didn't see.
- **Clear before you draw** in the gap: `clear()` cuts everything already drawn there, including your own new wire.
- **`rows.py` `Net(io='L'/'R', pin=False)`:** the track still runs to its edge (and reserves the span in the channel), but gets a label, not a pin, so the generator can route on to a pin elsewhere. A track only exists from its stubs to the edge: a via further in needs `land()` (comp_ct) or its own met3.
- **capm.11:** unrelated met3 within 1.34 µm of a capm is a magic error. Near MIM caps, drop pins on met2 (under the plate) or met4, not met3.
- **`tools/floorplan_blocks.py`** now prefers a label sitting on a pin shape: generators label internal wires with the pin's name (for readable extraction), and the first-found label used to win.
- Committed extracted netlists can be stale: re-extract the old GDS with today's `pex.sh` before calling a difference a regression (dbg_tg: the committed PEX gave −78.9 dB isolation, the old GDS today −73.6, the new one −73.5).

## TX corner re-floorplanned, tx_ls kn 14 / kp 8 (2026-10-10, branch tx-ls-swap)
- **Simulate a driving block with its real load extracted.** tx_ls and tx_drv were each fine on their own (`tb_tx_ls --pex`, `tb_tx_drv --pex` −0.32 dB); together in the tile, ~9-13 fF on a / b cost 1.5 dB because the shifter's A rise had no margin. `sim/top/tb_tile_tx.py` drops / keeps extracted C per net to find which net it is.
- **Cross-coupled level shifter sizing has a window:** the pull-ups (kp) set the rising edge; too strong and it latches (fs corner first), too weak a pull-down (kn) relative to kp skews it at ss 10 °C. Check every corner for "not switching", not only P / duty.
- **Placement** (`floorplan.json`): ring 17.5, 140.5 R270 (out on top), xls 26.5, 141.0 MYR90 (18.5 × 15.85), xlse_n 13.0, 124.0 R270, xlse_p 39.5, 124.0 MYR90 (2.5 µm from xdbg). tx_ls kn 14 / kp 8 folds into nearly the old footprint (19.0 × 14.25 → 18.5 × 15.85).

| net | old route | new route | extracted C old → new |
|---|---|---|---|
| ring | 30 µm | 22 µm | 10.9 → 8.6 fF |
| a / b | 8 / 29 µm | 34 / 35 µm | 8.9 / 12.9 → 13.5 / 13.7 fF |
| enh_p / enh_n | 35 / 4 µm | 6 / 4 µm | 11.6 / 7.0 → 7.1 / 7.0 fF |

## Top level (2026-10-09)
Flow: `tools/osic-mac klayout -b -r layout/gen/decap.py` (only when the decaps change) →
`tools/osic-mac klayout -b -r layout/gen/top.py` (writes `build/top/tt_um_mattvenn_radio_place.gds`, `build/top/pins.json`)
→ `tools/osic-mac python3 layout/gen/route.py [net ...]` (writes `build/top/tt_um_mattvenn_radio.gds`,
`build/top/route_report.json`; ~35 s for all nets) → `tools/osic-mac bash layout/check_top.sh [precheck klayout magic antenna lvs]`
(KLayout DRC ~15 s; magic DRC + LVS ~5 min; antenna ~2 min). History and numbers: `docs/history.md` "Top level".

**Router (`layout/gen/route.py`)**
- A* on a 0.2 µm grid over met1–met4. Obstacles are the real placed geometry, bloated per net by half its width plus
  the spacing, so routes are DRC-clean by construction. Via pads are checked on both layers; met3/met4 pads are
  blocked at 0.5 µm because a stack's middle pad must meet the 0.24 µm² min area.
- Every shape has a tag: a block pin's polygon is `inst.pin`, a strap `NET@w|m|e`, a route its net name. A net may
  touch only its own tags.
- Per net (`layout/gen/top_nets.py`): width, layers, preferred directions, keep-out boxes, `avoid` (cost near other
  nets), `follow` (pairs), ordered waypoints (with a layer), `anchors` / `late` (power trees), and `cell` (draw into
  tx_top).
- **Lessons (each one was a DRC or LVS failure first):**
  - **MIM bottom plates (capm.2b_a / capm.11):** other met3 stays 1.2 µm from `capm ∩ met3` grown by 0.14. The halo
    is a keep-out for every net, the plate's own too: a wire that runs near its plate without touching it fails.
    Near a pin that *is* a plate, a 1.3 µm carve lets its net come in on met3.
  - **No via2 within 0.1 µm of a capm (capm.8, magic only), and no via3 within 0.08 µm of a capm edge (capm.5).**
    KLayout's deck missed both; magic caught them.
  - **capm under a top plate is a keep-out (`~cap`) passable only by the top plate's net, never a terminal.**
    Otherwise another net drops a via3 onto the bottom plate between the top-plate strips.
  - **Keep-outs aren't metal:** a route can "end" on a halo and leave an open. Terminals come only from real pin
    shapes, and a wire end must lie inside the pin (a sliver otherwise: m3.1 / m4.1).
  - **Metal wider than 3 µm needs 0.4 µm spacing (m3.3cd / m4.5ab).** A rail merged with a supply wire becomes
    "wide": every net keeps 0.4 µm from wide foreign metal.
  - **Same-net notches** (a via pad beside a wire or a pin): close them by growing and shrinking the net with its own
    pins, then drop any fill that's under minimum width once clipped against foreign metal.
  - **Fixed geometry (the TT bus) is checked against foreign metal**, and placed first so the maze-routed nets avoid
    it. Its first version shorted uio_oe[7] to the west VGND strap.
  - **A power tree must not start at its own terminals** (0-length "routes": the RX supplies were never drawn).
    Use `anchors` (straps) and connect each terminal to the nearest point.
  - **Nets drawn inside a subcell (tx_top) reach the strap last (`late`),** so the subcell is connected on its own
    and matches hierarchically.
- **Antenna:** long top-level met3 into the macro's input gates (TT inputs, comp_in) needs a met4 jumper just before
  the macro (x 274–275.4, west of the mid straps).

**TT bus:** 42 wires from the top-edge pins to the macro's west edge.
- Only met2 is free over a MIM decap, so a single-layer staircase must be planar.
- The working layout is a two-layer channel above xdeca part 2 (y 213.75–225.4):
  - the 24 western pins: met4 drop, met2 track (0.48 pitch), met2 column over the MOS-only top of xdeca part 1,
    met3 into the pin;
  - the 18 eastern ones: met3 tracks (0.65 pitch, for the via3 pads), met4 columns. The 6 whose macro pins are level
    with the channel run straight in.
- The enables leave the macro below the TT pins and run west along the bottom of xdeca part 2, below the bus.

**Decaps (`layout/gen/decap.py`):**
- MOS rows on comb met1 rails, MIM over them (a VGND met3 sheet, met4 top-plate bus); via stacks only in the edge
  bands, so met2 stays free for crossing routes.
- **A met4 bus must not cross a strap of another net:** it shorted VAPWR/VDPWR/VGND in the first try. Found with a
  metal-connectivity trace of the placed tile.

**Extraction for the end-to-end decks:** `layout/pex_tile.sh {lvs|c|rc}`.
- It flattens first (otherwise each block's substrate `VSUBS` floats in ngspice) and strips the macro.
- It labels the macro-pin wire ends with the `radio_analog` port names, so the result drops into
  `tb_radio_analog` (`sim/top/tb_tile.py`).
- rc takes 11 s: 85k R, 18k C.
