mattvenn/ook-asic-radio/docs/power.md

# Power delivery: benchmark of the routed tile (2026-10-09)

What the supplies look like from each block, measured on the routed tile as of the 20:00 build
(`build/top/tt_um_mattvenn_radio.gds`), before any power changes. Scripts: `sim/power/`
(how to re-run: bottom of this page). Proposals: last section.

## How TT feeds the tile (from tt-multiplexer)
Source: github.com/TinyTapeout/tt-multiplexer, `ol2/tt_top/` (`pdn.tcl`, `build.py`,
`odb_power.py`, `odb_route.py` ModulePowerStrapper), `py/tt/elements.py`, `pg/sky130/`.
Model: `sim/power/pdn.py`.
- **VDPWR and VAPWR are switched** by full-height power-gate cells on the tile's **west** side:
  `tt_pg_1v8_*_2` (9.2 µm) and `tt_pg_3v3_2` (13.8 µm, next to the tile). Each gate's output
  (met4 column) feeds **two met5 stripes drawn across the tile** to our met4 pins: one 8.75 µm at
  mid ± 5.5 µm, one 19.75 µm at mid ∓ 57.12 µm. Every same-net met4 pin they cross gets via4s.
  Which supply gets which pair (pin order) and whether the tile sits N or FS are not known: case A
  = VDPWR at y 118.4 / 55.8, VAPWR at 107.4 / 170.0; case B swapped.
- **VGND** comes from the global met5 grid: 8.75 µm stripes at y 27.2 / 84.3 / 141.4 / 198.6 (the
  middle stripe of each vdpwr / vgnd / vapwr set; the switched stripes take the gaps).
- **Gate on-resistance** (ngspice, the gates' power PMOS, tt, 20 mA, 10–50 °C,
  `sim/power/pg_rdson.spice`): 1v8 hp 0.76–0.78 Ω (ll 0.89–0.91 Ω), **3v3 1.93–2.17 Ω**.
- **Assumed** (not from TT): package + bond wire 0.5 Ω + 2 nH per supply, 1 nF of chip grid C at
  each gate input (`common.UP`).
- So the VAPWR east straps and the macro's stripes get their current along ~500 µm of met5 from
  the west, and each VDPWR / VAPWR strap has only **two** landings.

## Method (and why not magic's rc extraction)
magic's `extresist` (the rc mode of `layout/pex_tile.sh`) is not usable for the supply nets: it
builds its resistor network toward device terminals only and folds large parts of the net into the
port node (avg_sc's and comp_ct's ground terminals came out on the VGND port itself, the straps came
out ideal). No tolerance / threshold / simplify setting changes it, and its FastHenry export is the
same network. Other magic traps on the way (all handled in `sim/power/pdn_gds.py`): several
differently named ports on one net make it write the whole net once per port; same-name labels
short the strap ends together; the std cells' substrate labels and the p-taps merge VGND with an
ideal substrate; a KLayout-flattened GDS crashes ext2spice.

So:
1. **Extraction copy** (`pex_power.sh` / `pdn_gds.py`): the tile without the macro, plus the gates'
   output columns, the met5 stripes and via4s, one port per supply. magic rc gives the devices,
   the signal parasitics, every C on the supplies, and each device terminal's position.
2. **Supply mesh** (`mesh.py`): KLayout traces each supply net (li … met5, mcon … via4), rasterized
   at 0.5 µm; R between cells from the PDK sheet R, cut R × cut count between layers.
3. **ngspice** solves everything: DC R per block (`r_mesh.py`), IR drop with the real currents
   (`ir_rx.py`), and the AC runs on a **stitched** tile (`stitch.py`: magic's devices + C, the
   mesh at 1 µm, the PDN model) (`z_ac.py`).
- **Probe points:** a block's local supply = the mesh nodes at its devices' current-carrying supply
  terminals (MOS drain / source, R / C ends; not bulk), assigned to the block by position.
- **Mesh check:** 0.5 vs 1 µm agree within ~5 % except the long thin RX ground route, where 1 µm
  is ~30 % low (avg_sc 47 vs 67 Ω): the coarse cells bridge neighbouring wires. DC numbers are 0.5 µm;
  the AC runs (1 µm) are that much optimistic on RX ground.
- **Cross-check:** `tools/power_r.py` (same idea, straps ideal) agrees once the straps / met5 / gate
  path is added (RX VGND avg_sc 61 → 67, comp_ct 55 → 57, bias 27 → 31 Ω).
- Not modelled: substrate coupling (the substrate is one node tied to the VGND port), the macro.

## Benchmark (case A)
R: from the block's device terminals to its gate output (VDPWR, VAPWR) / the VGND grid, mean over
terminals, 0.5 µm mesh; add the gate (0.77 / 2.0 Ω). IR: RX operating point (3.0 mA VDPWR), drop
below the gate output / rise above the grid. |Z|: between the block's local VDD and VSS, 1 µm mesh
with the decaps, device C and PDN. TX→RX: |ΔV| between the RX block's local VDD and VSS per A drawn
at a TX driver at 434 MHz.

| block | R VDD (Ω) | R VSS (Ω) | IR VDD / VSS (mV) | \|Z\| 77 kHz | \|Z\| 434 MHz | TX→RX at 434 MHz (Ω) |
|---|---|---|---|---|---|---|
| chain | 6.0 | 7.1 | 15.6 / 20.4 | 22.6 | 20.8 | 0.025 |
| log_det | 28.7 | 13.6 | 2.3 / 0.5 | 52.2 | 50.9 | **0.59** |
| avg_sc | 27.7 | **66.8** | 2.1 / 3.5 | 74.5 | 64.7 | 0.038 |
| comp_ct | 26.6 | **56.8** | 2.1 / 3.5 | 81.0 | 71.1 | 0.037 |
| bias | 13.6 | 30.9 | 2.5 / 3.1 | 56.2 | 46.9 | 0.034 |
| r2r | – | 35.2 | – / 6.2 | | | |
| dbg_tg | 31.7 | 26.2 | 14.4 / 0.4 | 63.7 | 62.6 | 0.58 |
| tx_ring | 7.3 | 1.9 | | 17.9 | 16.9 | |
| tx_drv_p | 3.0 (VAPWR) | 2.5 | | 12.0 | 10.8 | |
| tx_drv_n | 1.6 (VAPWR) | 2.1 | | 10.2 | 8.9 | |
| VAPWR decap | 10.9 (worst 19.9) | 7.5 | | | | |
| VDPWR decap | 18.7 | 10.0 | | | | |

- **TX IR (both arms, 6.65 mA average / 18.4 mA peak each on VAPWR):** tx_drv_p VAPWR drop 29 mV
  average, 79 mV peak (+ 27 / up to 75 mV in the 3v3 gate); VGND rise 9.5 / 49 mV. tx_drv_n:
  19 / 53 mV. Both arms at peak at once is pessimistic (they alternate).
- **The supply impedance at every block is resistive and flat to 500 MHz**: |Z| ≈ R VDD + R VSS.
  The decaps sit behind 10–20 Ω of mesh, so they do almost nothing at the blocks.
- **TX → RX:** per A drawn at a driver, log_det's supply moves 0.59 Ω × 9.45 mA RMS ≈ **5.5 mV at
  434 MHz** (the detector rectifies its supply too); the chain, comp_ct, avg_sc ≤ 0.04 Ω (≤ 0.4 mV).
  The arms are in anti-phase, so the 434 MHz supply current partly cancels: the keyed transient
  will give the real figure.

**Case B** (the stripe pairs swapped) changes little: VGND identical; RX VDPWR R +0.7 Ω (chain 6.0
→ 7.9 Ω), RX VDPWR IR drop 2 → 5 mV (chain 15.6 → 21.3 mV); the TX drivers' VAPWR R 3.0 / 1.6 →
2.5 / 1.1 Ω, TX average drop 29 / 19 → 22 / 13 mV. The benchmark uses case A (worse for the TX).

### TX keyed (transient, `tran_tx.py`)
tx_en keyed at 5 ns, RX biased on as well, 30 ns, last 10 ns, case A:

| block | local VDD−VSS p-p (mV) | of which 434 MHz (mV) |
|---|---|---|
| tx_drv_p | 63.2 | 6.3 |
| tx_drv_n | 37.3 | 1.8 |
| log_det | 11.6 | 0.50 |
| dbg_tg | 11.9 | 0.47 |
| tx_ring | 8.9 | 0.29 |
| chain / avg_sc / comp_ct / bias | 6.6–7.2 | 0.19–0.26 |

- The arms' anti-phase currents cancel most of the 434 MHz on the shared supply: the RX blocks see
  0.2–0.5 mV at 434 MHz (the AC run's per-arm estimate, 5.5 mV at log_det, is the no-cancellation
  bound). The p-p is mostly the keying step ringing.
- The whole chip rings ~355 mV p-p against the board ground (vdpwr, vapwr and VGND together): the
  assumed 2 nH package with 1 nF of chip grid C, undamped; common mode, not across any block.
  Depends on the package assumptions, not on our layout.

### EM (`em.py`, both arms at their average current, 0.5 µm mesh, case A)
| path | worst | limit | |
|---|---|---|---|
| **via4, west VAPWR strap (x 2.5) at the y 107 stripe** | **5.2 mA/cut** | 2.49 | **2.1× over** |
| **met4, west VAPWR strap (1.2 µm)** | **13.8 mA/µm** | 6.8 | **2.0× over** |
| **met3, VAPWR_TX at the drivers (54, 120)** | 10.5 mA/µm | 6.8 | 1.5× over |
| via3 at the west VAPWR strap | 0.53 mA/cut | 0.48 | 1.1× over |
| mcon (VAPWR) | 0.24 mA/cut | 0.36 | 67 % |
| VGND worst: via3 at (30.5, 120) | 0.30 mA/cut | 0.48 | 62 % |

Most of the TX's VAPWR current enters through the west strap's single via4 column under one met5
stripe and runs along the 1.2 µm met4 strap. These are average currents: the RMS (9.45 mA per arm)
is higher. (Partly covered mesh cells at a 1.2 µm strap's edges read high; the strap as a whole
carries ~13 mA, ~11 mA/µm, so the overstress is real.)

## Proposals (for Matt to pick; estimates, not yet simulated)
The weak spots, in order: **(1) TX VAPWR EM at the west strap (a reliability fail), (2) RX ground
57–67 Ω and RX VDPWR 27–32 Ω (flat to 500 MHz), (3) the decaps doing nothing at the blocks.**

| # | change | effect (estimate) |
|---|---|---|
| 1 | **West VAPWR strap 1.2 → ≥ 4 µm** (2 via4 columns per landing), VAPWR_TX met3 at the drivers ≥ 3 µm, more via3 there | EM: via4 2.6 mA/cut → still over; with the strap ≥ 6 µm (3 columns) ~1.7 mA/cut (68 %); met4 ~2.8 mA/µm. TX VAPWR R −1 Ω (~−13 mV avg). **Needed.** |
| 2 | **Wider RX trunks** (VDPWR_RX / VGND_RX 1 → 4 µm, met3 + met4 stacked where free) | The trunks are most of the RX R: avg_sc / comp_ct VGND 57–67 → ~15–20 Ω, VDPWR 27 → ~8–10 Ω; chain IR 36 → ~12 mV. |
| 3 | **Extra met4 VDPWR / VGND strap pair in the middle of the analog** (a met4-free column, e.g. x ~150, between log_det and Ctrim) | Halves the trunk length for log_det / comp_ct / avg_sc / bias: ~−50 % on their R (with 2: ~−75 %). Needs the met5 stripes to land on it (they cross the whole tile: free). |
| 4 | **Join the RX side to the mid straps** across decap parts 1 / 3 below the macro-pin band | comp_ct / bias / r2r get a second, short path: their R ~−40 %. |
| 5 | **Decap at the load**: wire each decap part straight to the block it serves (TX: the VAPWR decap rails onto VAPWR_TX at the drivers; RX: VDPWR decap onto the chain / det rails) | Today \|Z\| at the blocks is the mesh R (flat). A 20 pF part within ~1 Ω of tx_drv: \|Z\| at 434 MHz 11 → ~6 Ω at the driver. For RX, only useful with 2 or 3 (otherwise the decap sits behind the same R). |
| 6 | **More via cuts** on the RX trunks' layer changes | Small (vias are a few Ω of the 30–60); do with 2. |

Suggested set: **1 (must) + 2 + 3**, then 5 for the TX. Each can be checked on this flow before the
top-level session commits it (the mesh run takes ~30 min per supply set).

## What-ifs (2026-10-10, case A, 0.5 µm mesh, the extraction copy only)
`pex_power.sh` takes `VAR=<tag> STRAP_W='{"<old x0>": [x0, x1]}'` (straps widened in the copy, kept
0.3 µm from other nets' met4 / via3 / MIM; check `magic.log` for "shorted" before simulating); `mesh.py`
takes `IDEAL=1` (strap R = 0) and `TRUNK=k` (top-level routing outside the blocks ×k), `MESH_TAG`.
- **W**: west VAPWR 0.3–5.3, VDPWR 5.8–10.5, VGND 12.0–15.1 (10.8 shorts VDPWR in the copy), east
  VAPWR 481.0–489.22. **ideal**: W with every strap ideal. **W+trunk3**: W with the routing ×3.

| block (R mean, Ω) | VDPWR base / W / ideal / W+trunk3 | VGND base / W / ideal / W+trunk3 |
|---|---|---|
| chain | 6.0 / 5.7 / 5.5 / 5.6 | 7.1 / 7.0 / 6.7 / 7.0 |
| log_det | 28.6 / 27.9 / 27.4 / 23.2 | 13.6 / 13.5 / 13.3 / 11.7 |
| avg_sc | 27.7 / 28.5 / 28.0 / 21.6 | 66.8 / 67.3 / 66.0 / 64.7 |
| comp_ct | 26.6 / 25.6 / 25.1 / 18.6 | 56.8 / 56.4 / 55.1 / 54.0 |
| bias | 13.6 / 13.4 / 12.8 / 11.0 | 30.9 / 31.0 / 29.6 / 29.3 |
| tx_drv_p (VAPWR) | 3.0 / 2.4 / 2.1 / 1.9 | 2.5 / 2.4 / 2.2 / 1.8 |
| tx_drv_n (VAPWR) | 1.5 / 0.8 / 0.6 / 0.8 | 2.0 / 2.0 / 1.8 / 1.5 |

TX average VAPWR drop at tx_drv_p: 29 → 20 (W) → 16 (ideal) → 17 mV (W+trunk3). Chain IR unchanged
(~15 / 20 mV). EM with W: west strap via4 210 → 62 %, met4 202 → 51 %; still over: **VAPWR_TX met3
at (56.5, 120.5) 18.7 mA/µm = 275 %** (285 % with the routing ×3): that point is inside tx_drv_p's
outline, its top met3 VAPWR rail where the route feeds in, so wider routes don't help: feed the rail
at several points along it or widen / stack it there (cells at a rail edge read somewhat high, but it
is far from 2× margin). Also via3 at the west strap 107 %.

**Findings**
- **Wider straps fix the TX** (VAPWR R and the strap / via4 EM) but **do nothing for the RX**: even
  ideal straps leave avg_sc / comp_ct at 55–66 Ω to VGND.
- **The RX ground resistance is in the path, not in any one wire**: the lowest-R path from avg_sc to
  the grid winds through other blocks' rails (bias met3 ~14 Ω, decap part 3 met1 ~10 Ω, the chain,
  comp_ct) and the 1 µm routes (~55 Ω), ~150 Ω in series (67 Ω with the parallel paths). Scaling the
  top-level routes ×3 doesn't help VGND (its R is inside block bboxes: rails used as the trunk).
- **No full-height column for a new strap in the RX area**: every x in 16–239 hits block met4 / MIM.
  Removing decap frees full-height columns only in decap part 1 (x 239.5–242.5 for 3 µm, 251.5–273.5
  for 6 µm), next to the mid straps the RX already reaches: small gain.

**Recommendation**
1. **TX (do):** west VAPWR strap ≥ 5 µm (as W); feed tx_drv_p's (and tx_drv_n's) top VAPWR rail at
   several points along it (or widen / stack it where the route enters); ≥ 2× the via3 at the west
   strap; west VDPWR / VGND as wide as W.
2. **RX (do):** a **dedicated VGND_RX (and VDPWR_RX) trunk**, ≥ 4 µm, met3 + met4 stacked where free,
   from the mid VGND / VDPWR straps straight to avg_sc, comp_ct, lpf, log_det, Ctrim / r2r, so their
   current no longer runs through bias / decap rails. Make room by trimming decap (parts 1, 3, 4).
   Not yet simulated: needs the route geometry (top-level session), then this flow re-runs on it.
3. A strap in decap part 1 (x ~251–273, 6 µm): only if 2 can't reach the mid straps.

## After the fix (2026-10-10, branch power-fix, case A, 0.5 µm mesh)
The routed tile with the fixes from `docs/handoff_power_fix.md` (steps 1 and 2), branch `power-fix`
(final: `VDPWR_TX` widened, see below). Picture of the new power routing: `docs/images/power_fix_routing.png`
(`tools/power_routing_draw.py`). DRC 0, LVS match, precheck pass; magic reported no shorts in the
extraction copy. Raw results: `sim/power/results/2026-10-10/*_A_fix*`.
- **Straps:** west VAPWR 0.3–5.3, VDPWR 5.8–10.5, VGND 12.0–15.1, east VAPWR 481.0–489.22.
- **TX feeds (fixed geometry in tx_top):** before, xdrv_p's current ran up xdrv_n's 3 µm rail and into
  xdrv_p's rail at its top corner (the met3 hot spot), and `VGND_TX` landed on xdrv_n's VSS rail at
  one end. Now each driver's rails are fed along their length. `VAPWR_TXF`: xdrv_n from a met3 sheet
  with via3 into the 5 µm strap; xdrv_p from a met3 bar under the west straps, a met4 bus (y
  99.4–106.2) and a met4 strip over its rail. `VGND_TXF`: a met4 bus straight off the west VGND
  strap (y 106.8–112.8) across both VSS rails, via3 onto them, met4 strips over their upper halves.
- **RX trunks:** one net per block (`VGND_RX_<block>`, `VDPWR_RX_<block>`), 3–4 µm (Ctrim VGND and bias
  VDPWR 2 µm) from the mid straps; dbg_tg's (2 µm) from the west straps. Another block's rail is
  foreign to each, so no block's current runs through another block. The mid VGND trunks start from
  `VGND_RXL`, a met4 bar off the mid VGND strap's top end and a 6 µm met4 column down xdeca part 1's
  MOS-only top (a wide via doesn't fit on the 1.2 µm mid strap). No decap removed.

| block | R VDD (Ω) base → fix | R VSS (Ω) base → fix | RX IR VDD / VSS (mV) base → fix |
|---|---|---|---|
| chain | 6.0 → 5.7 | 7.1 → 7.0 | 15.6 / 20.4 → 14.9 / 19.9 |
| log_det | 28.7 → 17.9 | 13.6 → 10.7 | 2.3 / 0.5 → 1.1 / 1.5 |
| avg_sc | 27.7 → **11.9** | 66.8 → **14.2** | 2.1 / 3.5 → 0.7 / 1.4 |
| comp_ct | 26.6 → **8.9** | 56.8 → **8.2** | 2.1 / 3.5 → 0.8 / 1.3 |
| bias | 13.6 → 5.2 | 30.9 → 23.6 | 2.5 / 3.1 → 0.9 / 2.5 |
| r2r | – | 35.2 → 24.1 | – / 6.2 → – / 6.4 |
| dbg_tg | 31.7 → 15.4 | 26.2 → 19.1 | |
| tx_drv_p | 3.0 → **0.77** (VAPWR) | 2.5 → **0.81** | |
| tx_drv_n | 1.6 → **0.36** (VAPWR) | 2.1 → **0.86** | |
| tx_ring | 7.3 → **1.8** | 1.9 → 2.5 | |
| tx_ls | 16.7 → **3.5** | 2.7 → 1.8 | |
| tx_lse_n / _p | 16.1 / 15.5 → 3.2 / 3.4 | 3.0 / 3.9 → 2.9 / 3.9 | |
| VAPWR decap | 10.9 → 8.5 | 7.5 → 3.8 | |

- **TX IR (both arms):** VAPWR drop at tx_drv_p 29 → 5.6 mV average, 79 → 16 mV peak (tx_drv_n 19 →
  2.8 / 53 → 7.9); VGND rise 9.5 → 2.9 mV average, 49 → 15 mV peak.
- **tx_ring / tx_ls VDPWR:** moving dbg_tg to its own trunk took away a parallel path they had through
  the old 1 µm `VDPWR_RX` net (tx_ring 7.3 → 12.8 Ω in between); `VDPWR_TX` widened 0.8 → 2 µm fixes it
  and more (tx_ring 1.8 Ω, tx_ls 3.5 Ω).
- bias VGND, r2r and log_det VDPWR improved less: their trunks are short, so most of what is left is
  in the blocks' own rails.

**|Z| (`z_ac.py`, 1 µm mesh, Ω between the block's local VDD and VSS) and TX → RX at 434 MHz (Ω per A
at a driver):**

| block | \|Z\| 77 kHz base → fix | \|Z\| 434 MHz base → fix | TX→RX base → fix |
|---|---|---|---|
| chain | 22.6 → 21.7 | 20.8 → 20.0 | 0.025 → 0.015 |
| log_det | 52.2 → **33.8** (\*) | 50.9 → **32.6** (\*) | 0.59 → **0.068** |
| avg_sc | 74.5 → **24.9** | 64.7 → **23.7** | 0.038 → 0.069 |
| comp_ct | 81.0 → **24.3** | 71.1 → **23.1** | 0.037 → 0.069 |
| bias | 56.2 → 26.8 | 46.9 → 25.6 | 0.034 → 0.069 |
| dbg_tg | 63.7 → 34.7 | 62.6 → 33.7 | 0.58 → 0.27 |
| tx_ring | 17.9 → **14.8** | 16.9 → **13.8** | |
| tx_drv_p / _n | 12.0 / 10.2 → 11.6 / 11.4 | 10.8 / 8.9 → 10.3 / 10.1 | |

(\*) `z_ac.py` probes one terminal per block (the one nearest the middle of its terminals). For log_det
that pick moved between runs (VDD probe `pD_m3_222_91`, then `pD_m0_220_101`, after the re-route): 22.7 Ω
in the previous run, 33.8 now, with its DC R unchanged (17.9 / 10.7 Ω).
Read log_det's |Z| as 23–34 Ω.

- RX |Z| is 2–3× lower; the TX → RX coupling into log_det (the worst path, ~5.5 mV per arm before the
  arms' cancellation) is 8.5× lower (~0.65 mV). avg_sc / comp_ct / bias went 0.04 → 0.069 Ω (they
  share the trunk tree now): still < 0.7 mV without cancellation.
- Still flat to 500 MHz (|Z| ≈ R VDD + R VSS): the decaps sit behind the mesh. Proposal 5 (decap
  at the load) was not part of this fix.

**EM (both arms at their average current):** every line under 50 % except the VAPWR mcon.

| path | base | fix |
|---|---|---|
| VAPWR via4 (west strap) | 210 % | 42 % |
| VAPWR met4 (west strap) | 202 % | 29 % |
| VAPWR met3 (at the drivers) | 155 % | 30 % |
| VAPWR via3 | 110 % | 15 % |
| VGND via3 | 62 % | 7 % |
| VGND met3 | 40 % | 11 % |
| VAPWR mcon (inside tx_drv, (56, 111)) | 67 % | 71 % (real ~9 %) |

The mcon line is a modelling artefact: `em.py` injects each device terminal's current at one mesh
point (here 36 terminals per driver, two in the worst 0.5 µm cell, ~1.5 cuts). In the cell the source
current spreads along the finger: tx_drv's stage-5 PMOS has 22 mcon per source strip, so all 6.65 mA
through its 18 fingers is 0.74 mA per inner strip, ~0.034 mA per cut (~9 %, ~13 % at the RMS).
`em.py` now flags mcon / via1 lines over 50 % as point injection.

**End-to-end deck** (`tb_tile.py sch lvs`, connectivity only, on the final layout): RX 2.99 mA, all off
0.910 µA, det idle 1.49 V, det at −60 dBm 1.097 V, TX 680 MHz / +3.07 dBm: the same as the pre-fix
layout in this mode (1.097 V, 679 MHz; no wiring C, so the ring runs fast and det reads low; with C
they were 1.202 V and 532 MHz). The c / rc runs on the final layout are still to do.

**Open:** optionally a wider mid VGND strap (~3 µm fits: the mid
gap is 8.1 µm below y 162, 6.9 µm above) to replace `VGND_RXL`; decap at the load (proposal 5).

## Re-running
```
tools/osic-mac bash -c 'CASE=A bash sim/power/pex_power.sh'    # extraction copy + magic rc (~30 s)
tools/osic-mac python3 sim/power/mesh.py A 0.5                 # supply meshes (and 1.0 for the AC runs)
python3 sim/power/r_mesh.py A                                  # DC R per block (~25 min, VGND is slow)
python3 sim/power/ir_rx.py A                                   # IR at the RX op and the TX currents
python3 sim/power/z_ac.py A                                    # |Z| per block, TX -> RX (~30 min)
```
