mattvenn/ook-asic-radio/bench/data/baseline_coax_20261007_123910.png

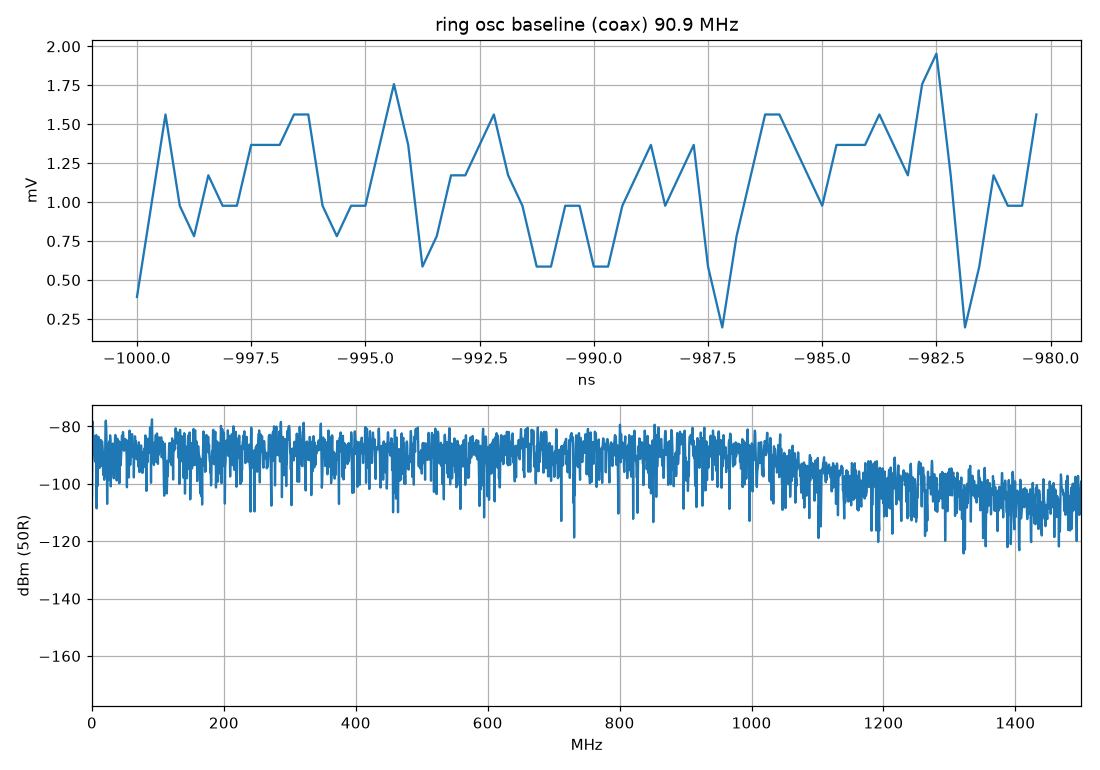
bench/data/baseline_coax_20261007_123910.png
