mattvenn/ook-asic-radio/bench/data/baseline_coax_20261007_125620.png

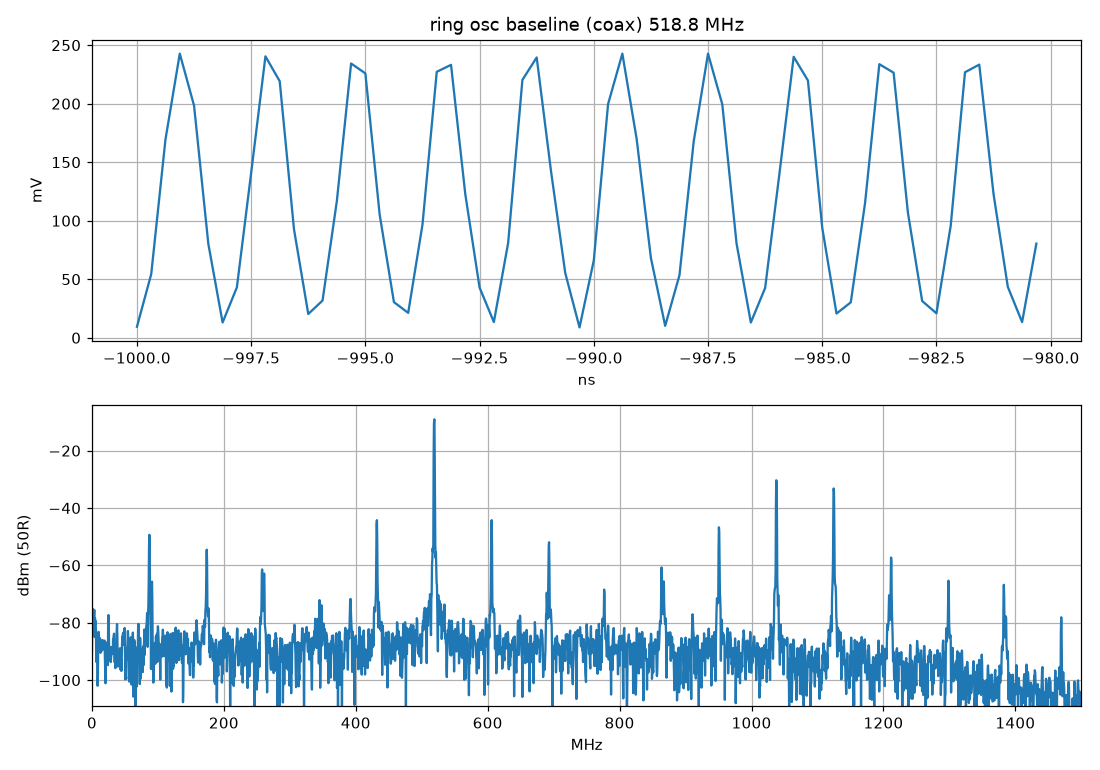
bench/data/baseline_coax_20261007_125620.png
