mattvenn/ook-asic-radio/bench/data/baseline_probe_20261007_123047.png

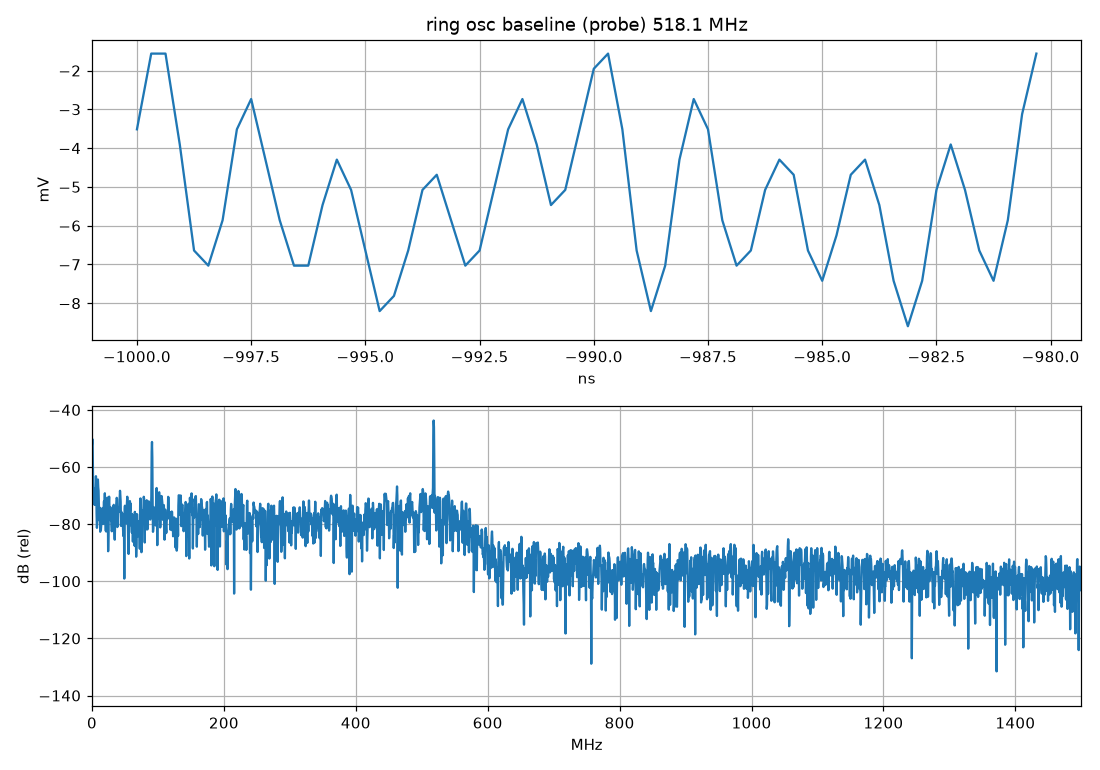
bench/data/baseline_probe_20261007_123047.png
