mattvenn/ook-asic-radio/bench/data/baseline_probe_20261007_123354.png

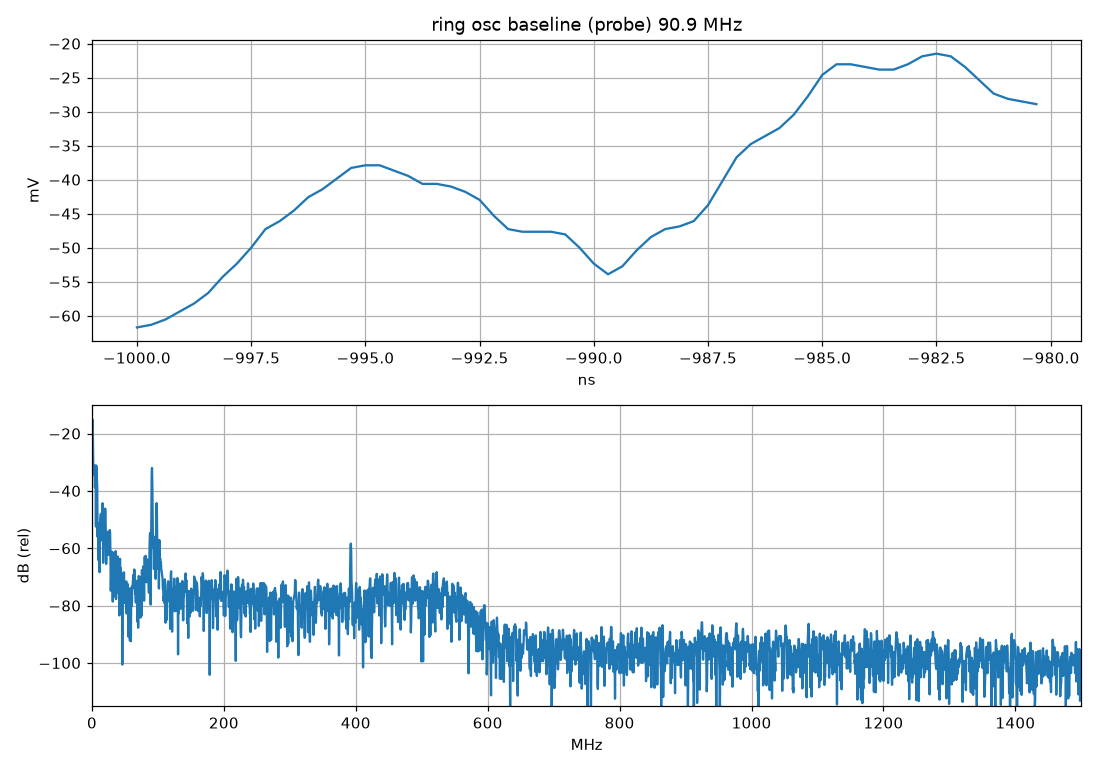
bench/data/baseline_probe_20261007_123354.png
