mattvenn/ook-asic-radio/bench/data/drift_20261007_133134.png

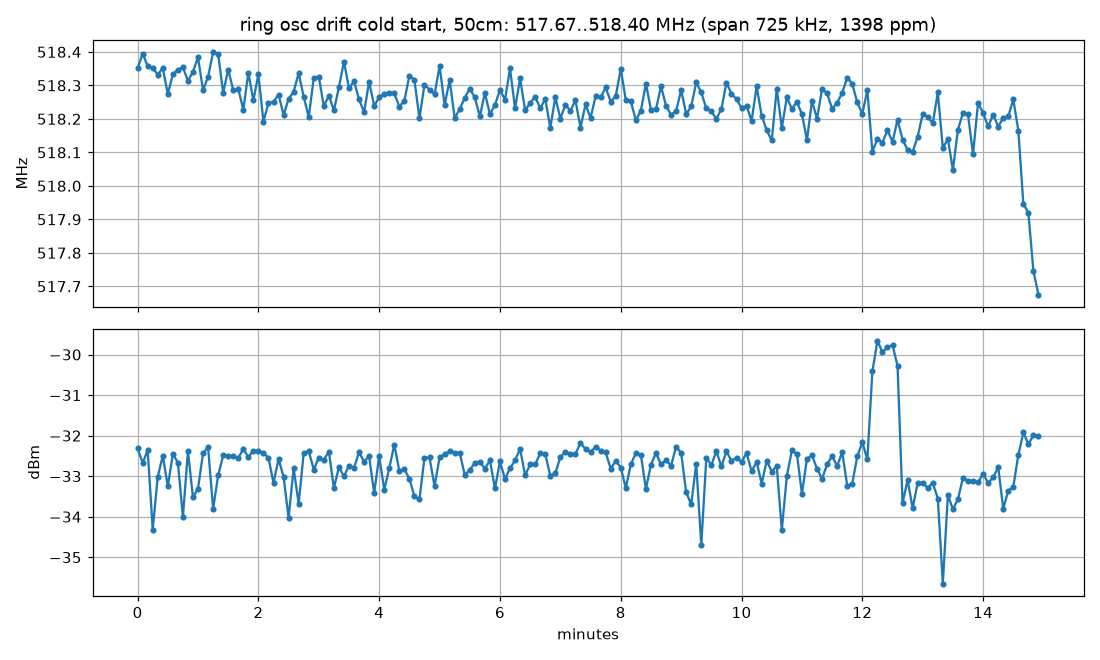
bench/data/drift_20261007_133134.png
