mattvenn/ook-asic-radio/bench/data/drift_20261007_134656.png

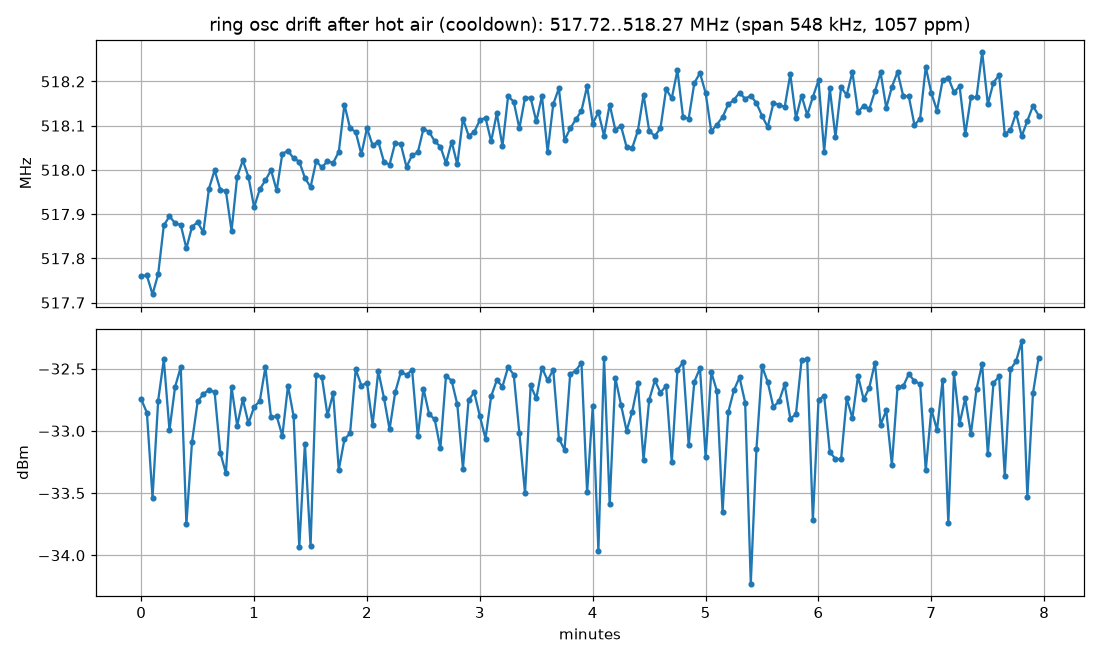
bench/data/drift_20261007_134656.png
