mattvenn/ook-asic-radio/bench/data/drift_combined.png

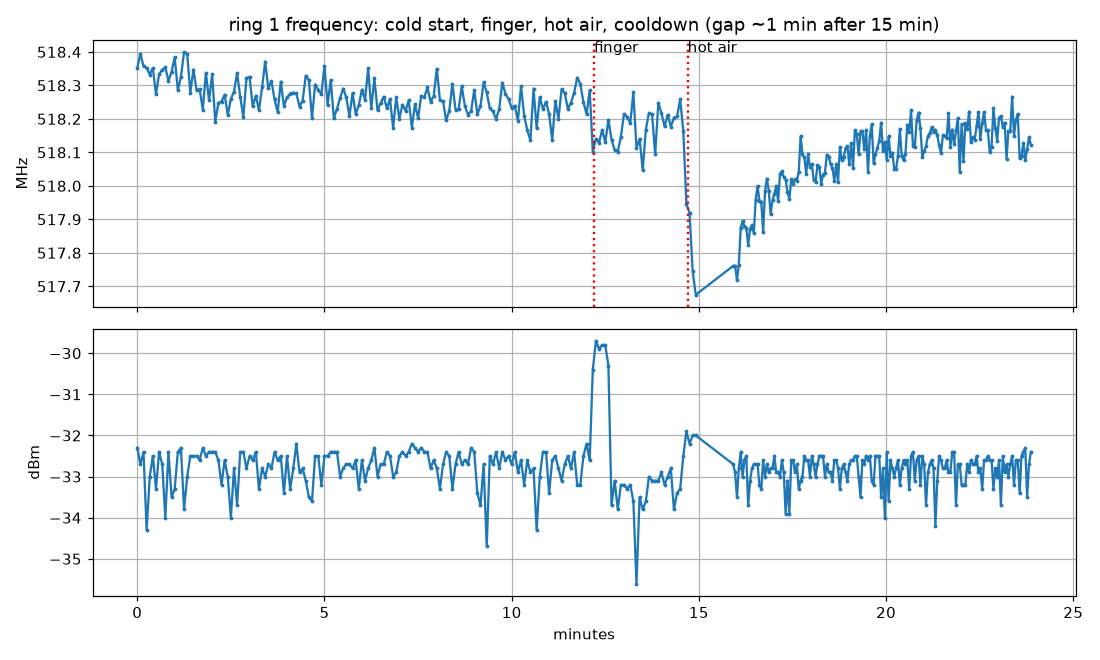
bench/data/drift_combined.png
