mattvenn/ook-asic-radio/bench/data/keying_1000Hz_20261007_140035.png

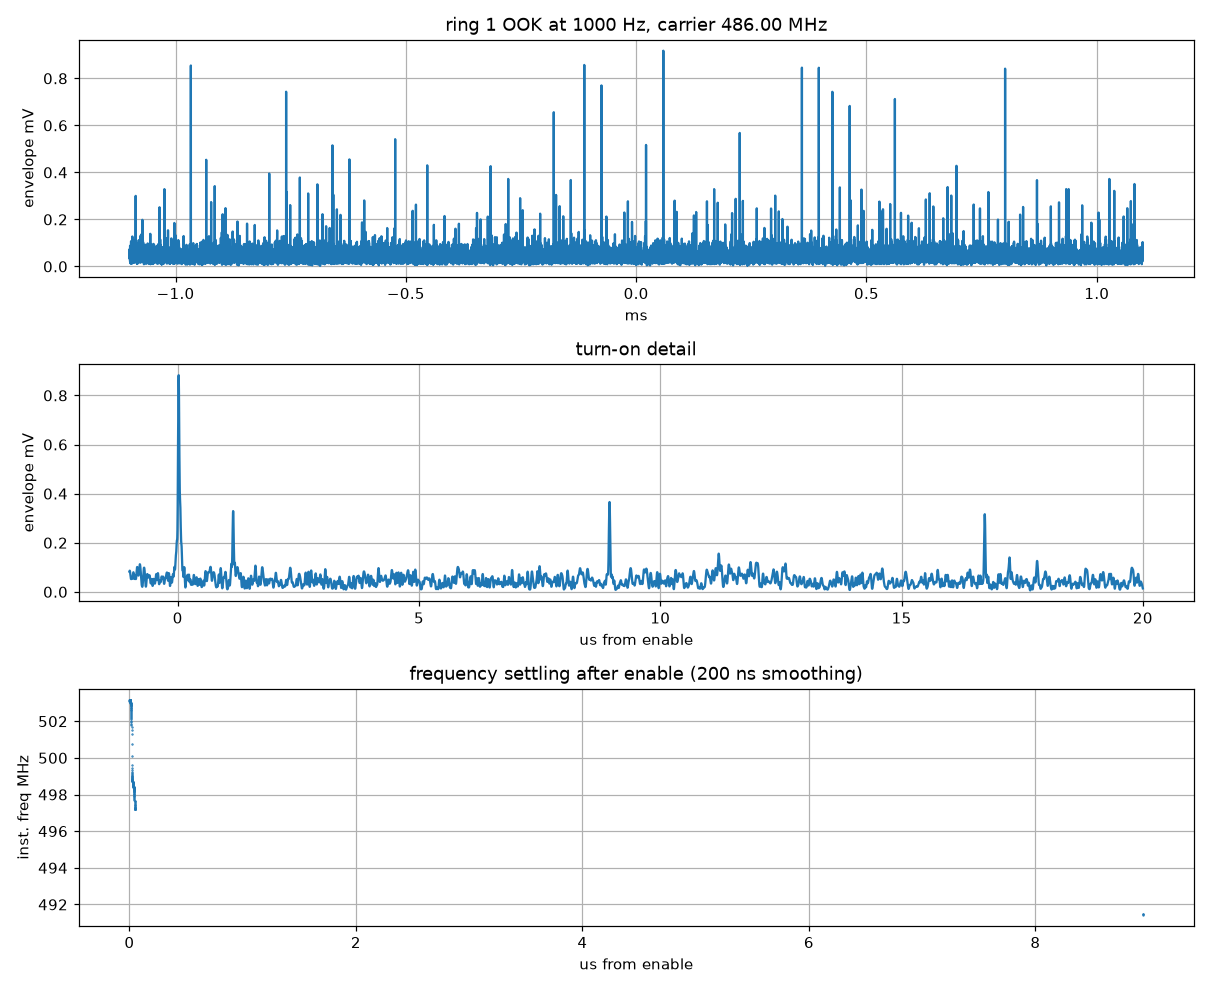
bench/data/keying_1000Hz_20261007_140035.png
