mattvenn/ook-asic-radio/bench/data/keying_turnon_detail.png

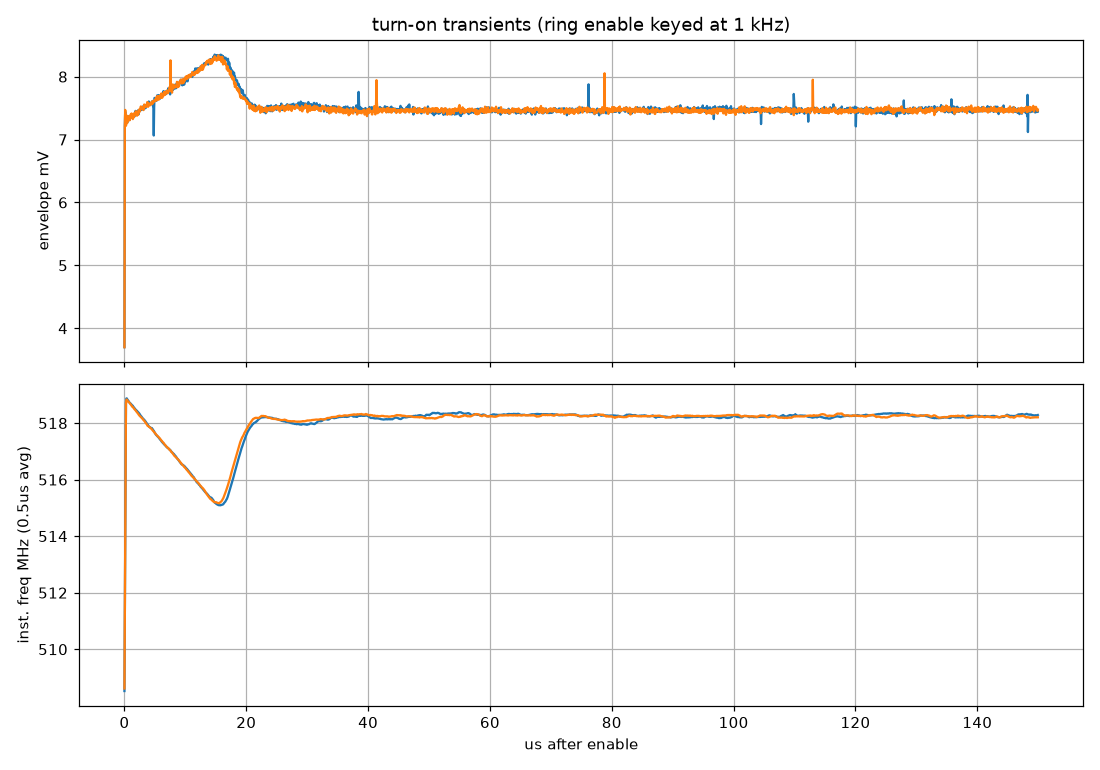
bench/data/keying_turnon_detail.png
