mattvenn/ook-asic-radio/bench/data/ota_150cm_20261007_153728.png

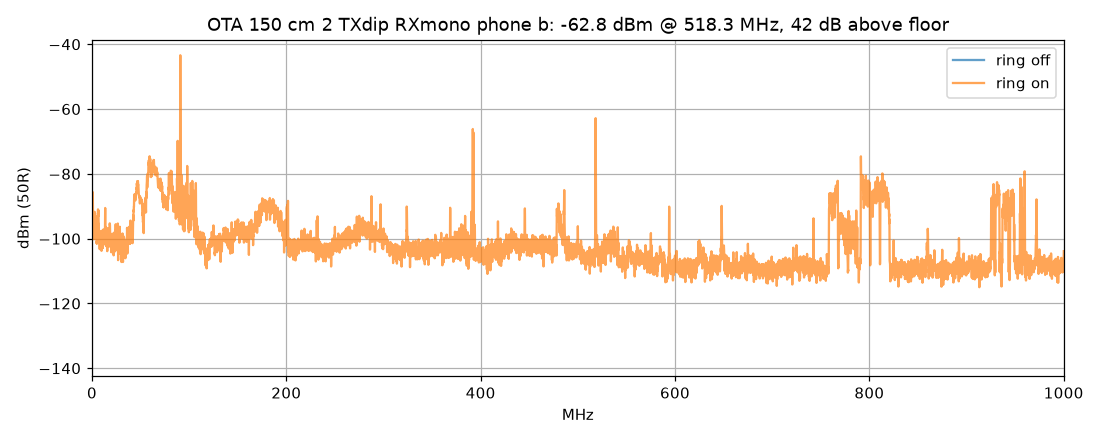
bench/data/ota_150cm_20261007_153728.png
