mattvenn/ook-asic-radio/bench/data/ota_150cm_20261007_154714.png

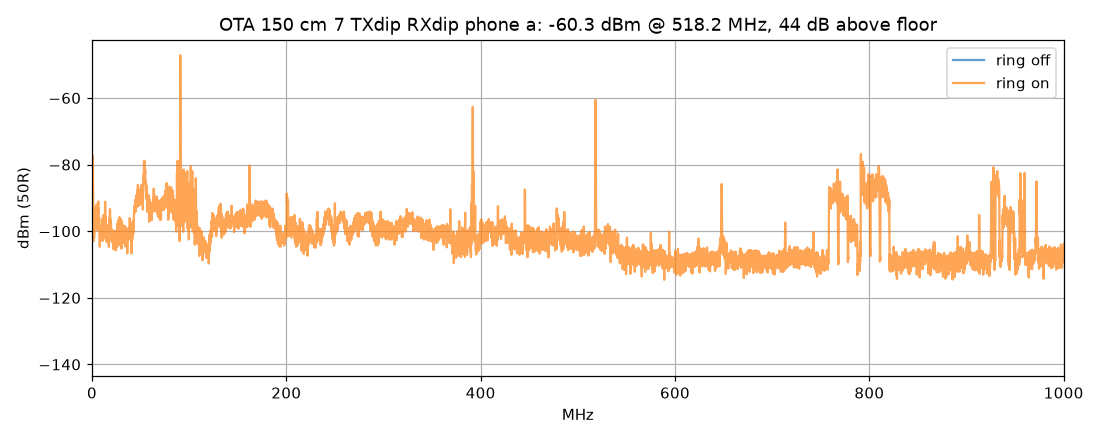
bench/data/ota_150cm_20261007_154714.png
