mattvenn/ook-asic-radio/bench/data/packet_2m_20261007_144253.png

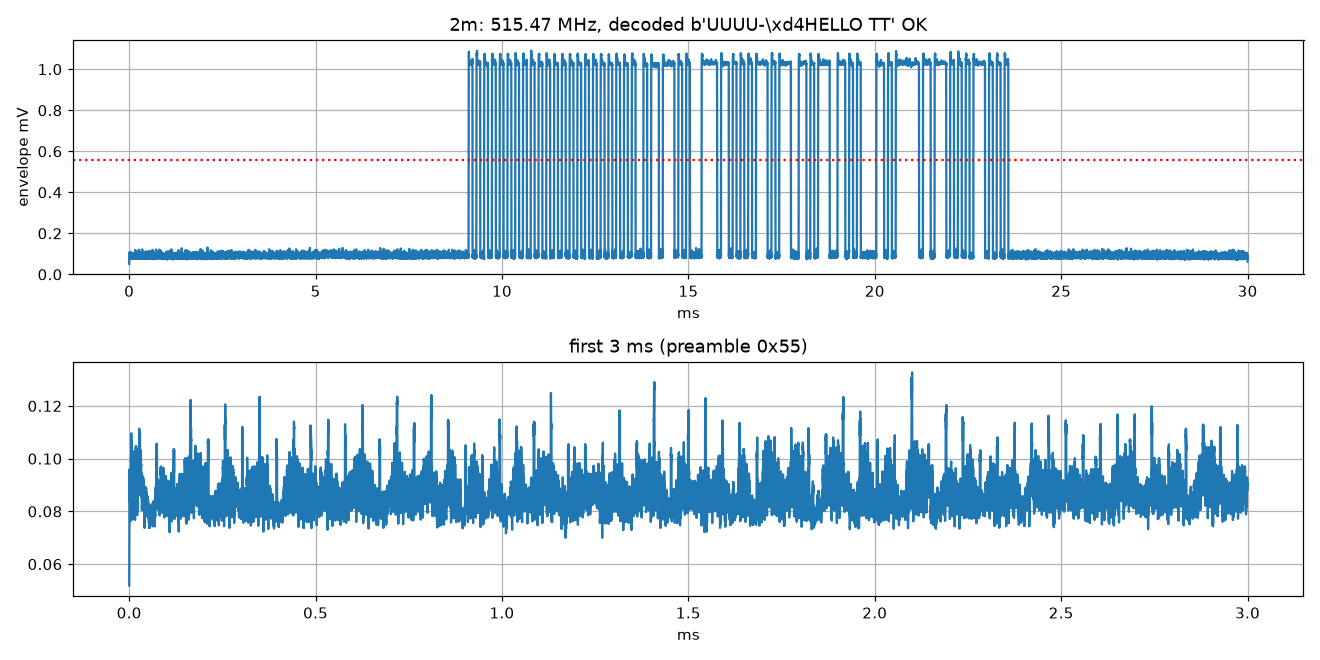
bench/data/packet_2m_20261007_144253.png
