mattvenn/ook-asic-radio/bench/data/packet_4m_20261007_144717.png

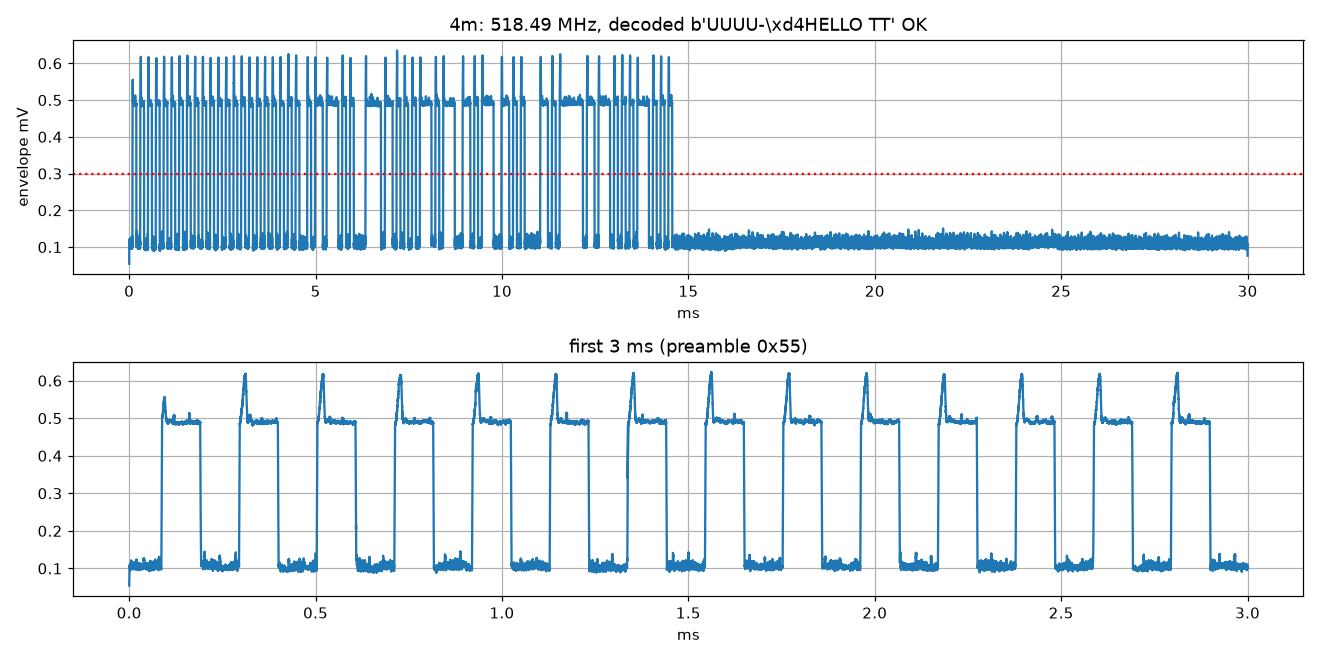
bench/data/packet_4m_20261007_144717.png
