mattvenn/ook-asic-radio/bench/data/packet_50cm_20261007_144053.png

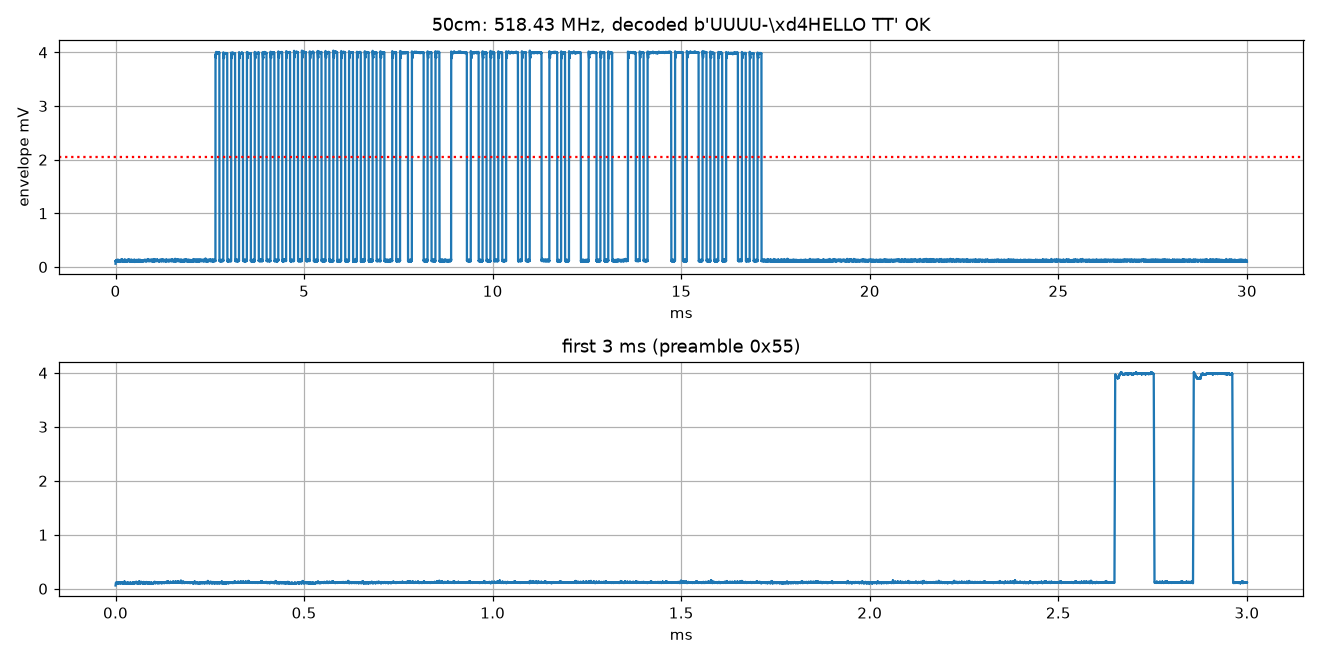
bench/data/packet_50cm_20261007_144053.png
