mattvenn/ook-asic-radio/bench/data/phasenoise_20261007_140315.png

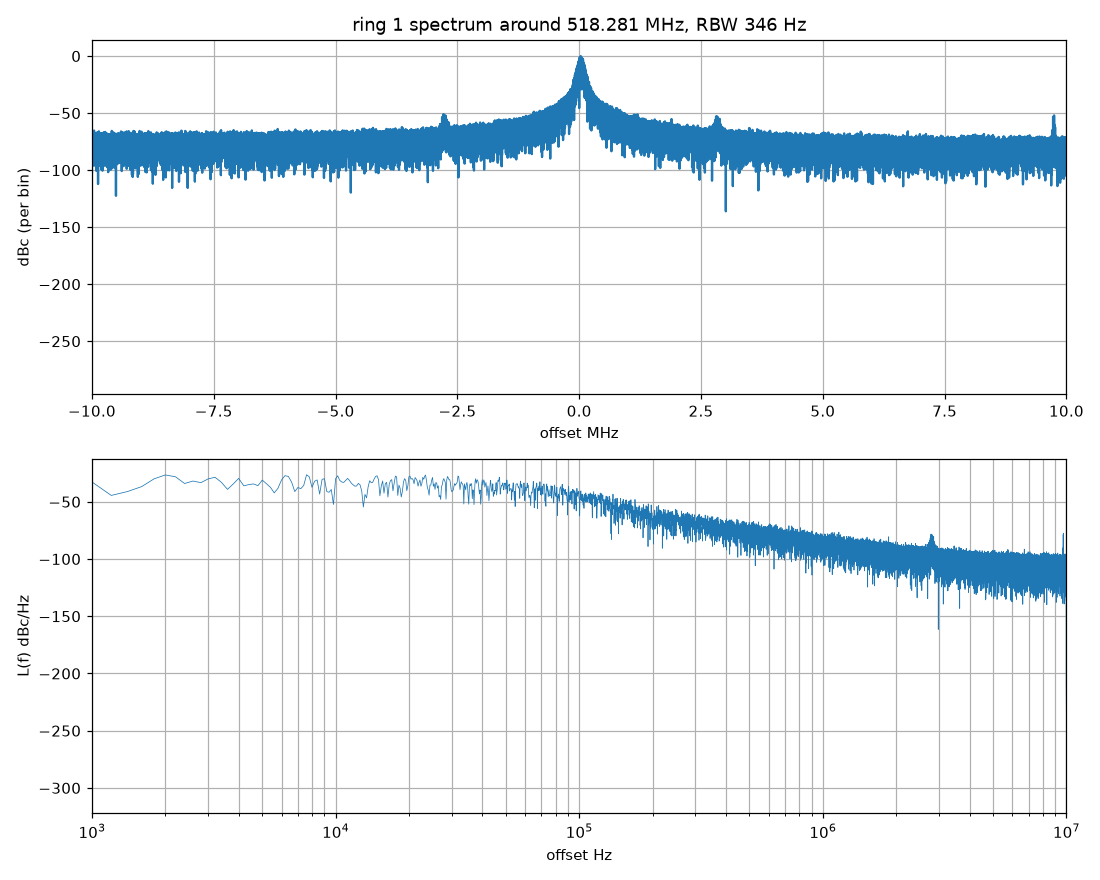
bench/data/phasenoise_20261007_140315.png
