mattvenn/ook-asic-radio/bench/data/rx_model.png

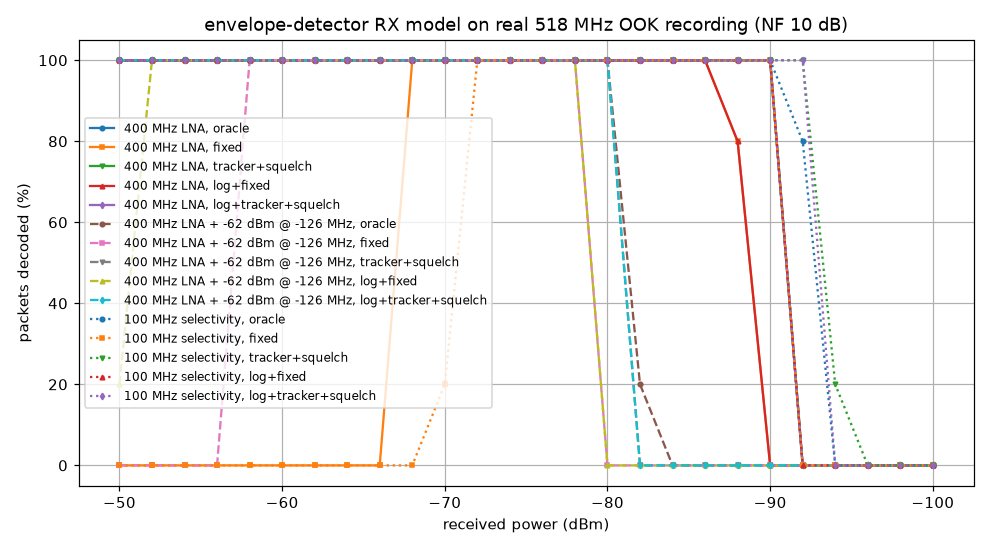
bench/data/rx_model.png
