mattvenn/ook-asic-radio/bench/data/sweep1/ota_20cm_20261007_130621.png

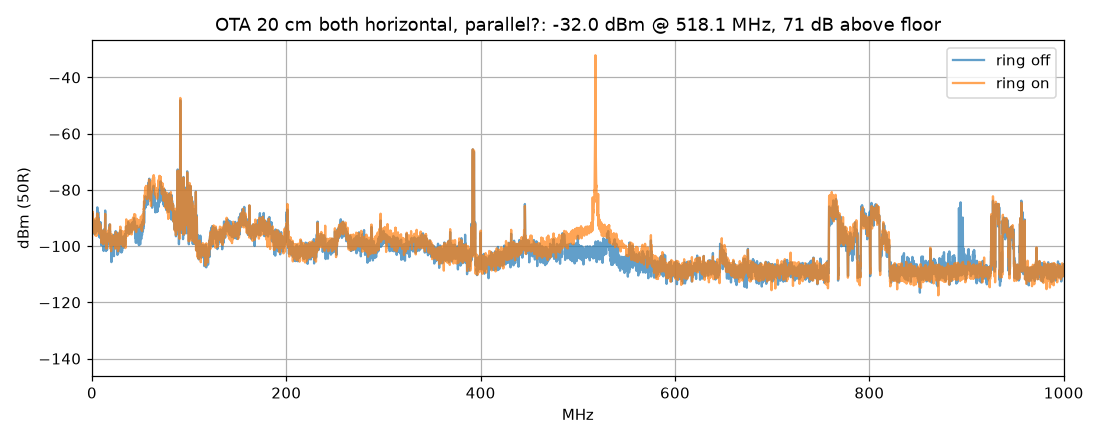
bench/data/sweep1/ota_20cm_20261007_130621.png
