mattvenn/ook-asic-radio/bench/data/sweep1/ota_50cm_20261007_130910.png

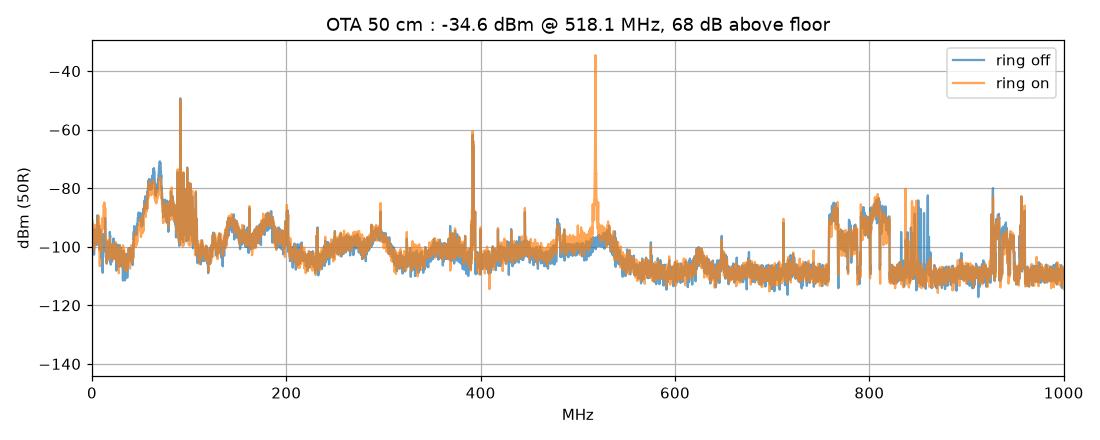
bench/data/sweep1/ota_50cm_20261007_130910.png
