mattvenn/ook-asic-radio/bench/data/sweep1/ota_100cm_20261007_131046.png

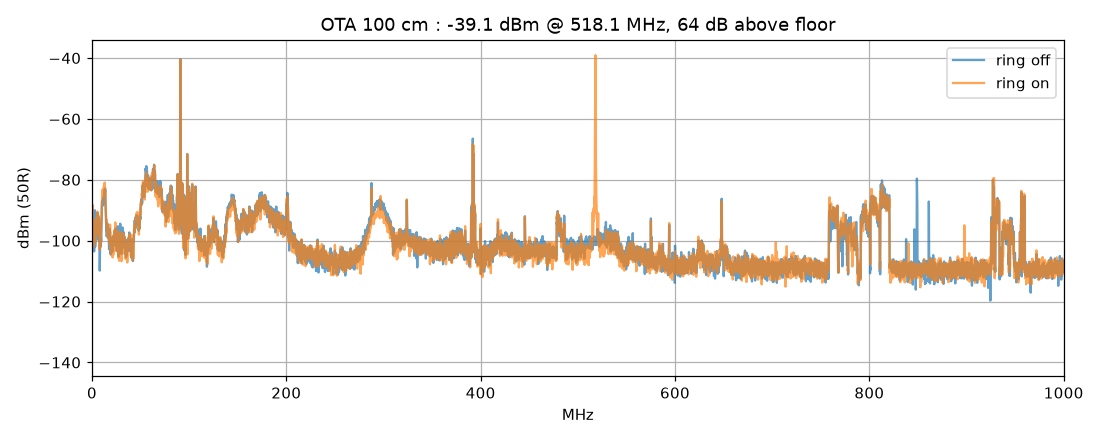
bench/data/sweep1/ota_100cm_20261007_131046.png
