mattvenn/ook-asic-radio/bench/data/sweep1/ota_200cm_20261007_131219.png

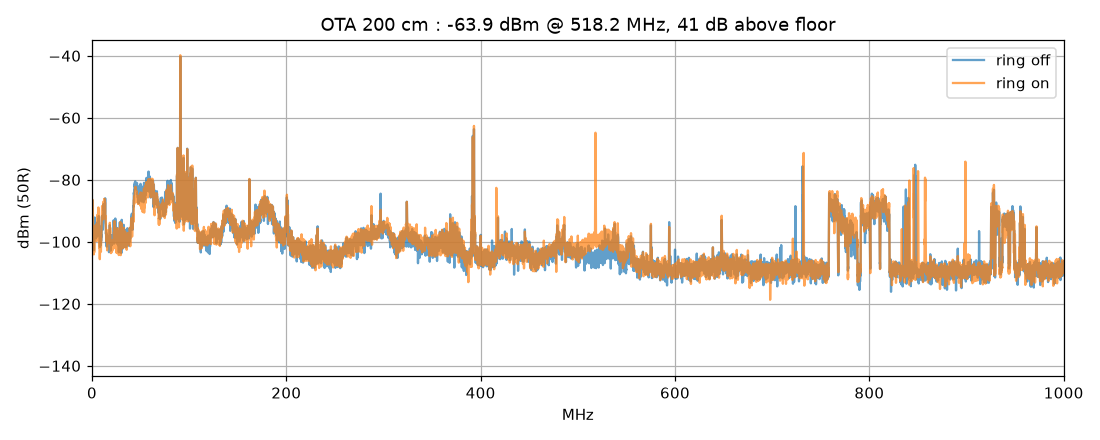
bench/data/sweep1/ota_200cm_20261007_131219.png
