mattvenn/ook-asic-radio/bench/data/sweep2/ota_10cm_20261007_132616.png

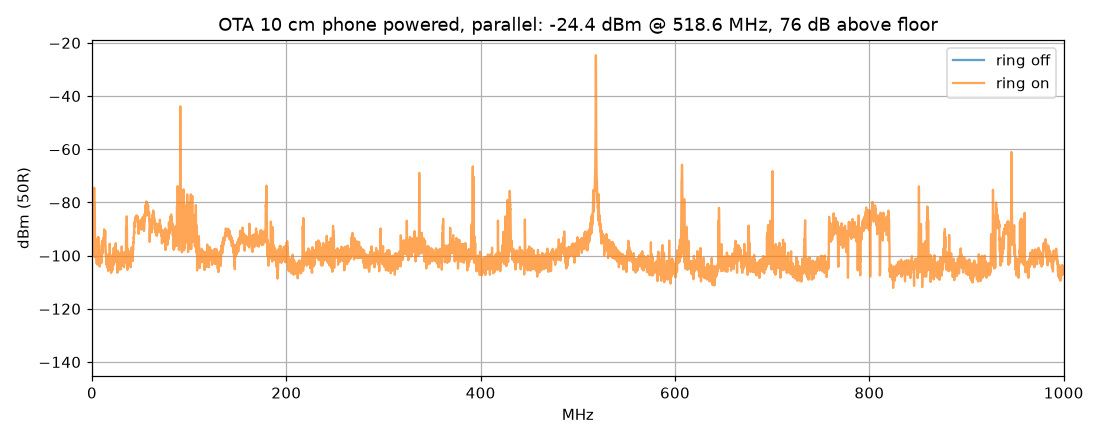
bench/data/sweep2/ota_10cm_20261007_132616.png
