mattvenn/ook-asic-radio/bench/data/sweep2/ota_20cm_20261007_132656.png

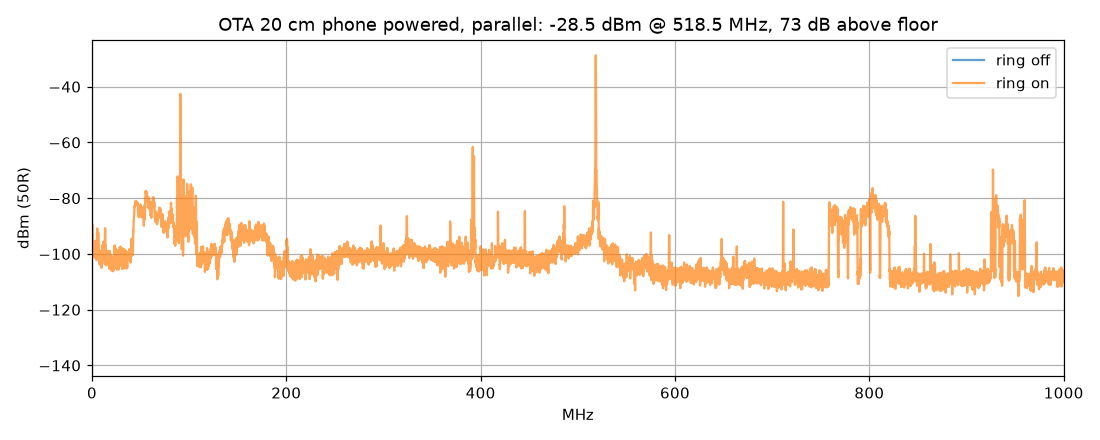
bench/data/sweep2/ota_20cm_20261007_132656.png
