mattvenn/ook-asic-radio/bench/data/sweep2/ota_50cm_20261007_132729.png

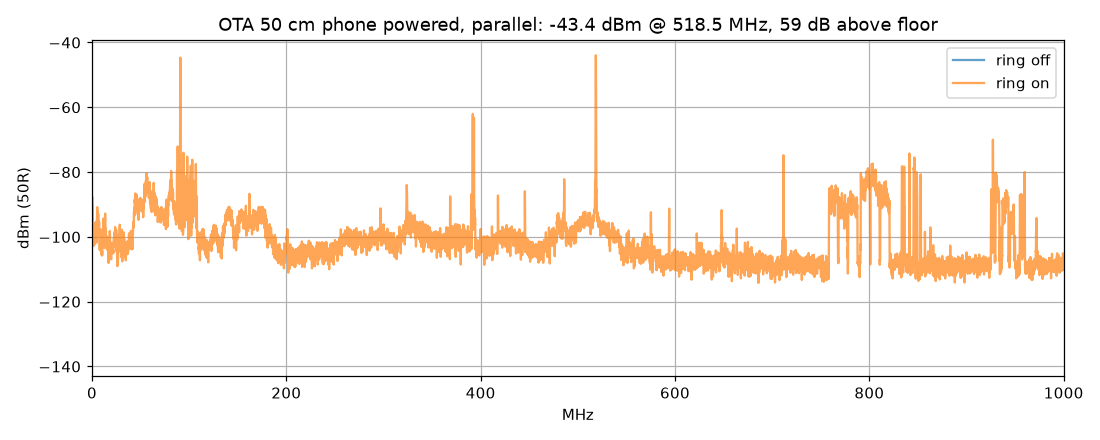
bench/data/sweep2/ota_50cm_20261007_132729.png
