mattvenn/ook-asic-radio/bench/data/sweep2/ota_100cm_20261007_132801.png

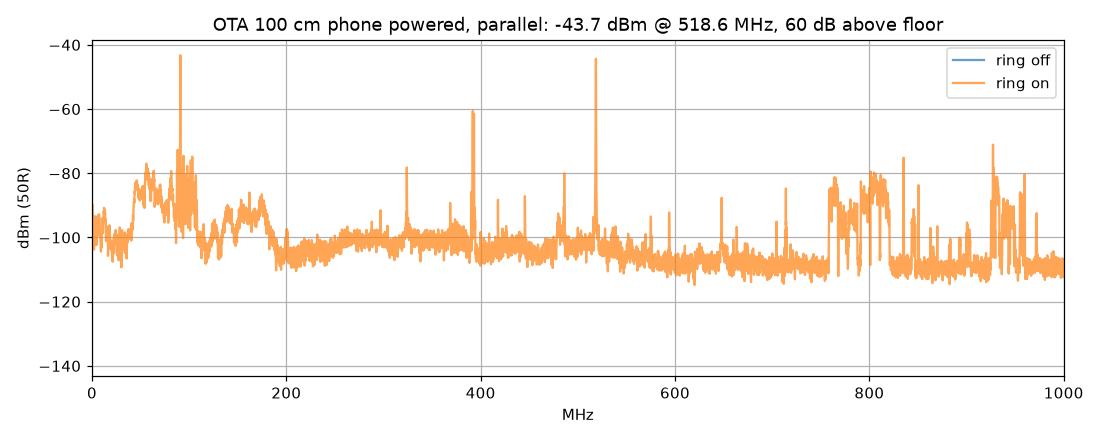
bench/data/sweep2/ota_100cm_20261007_132801.png
