mattvenn/ook-asic-radio/bench/data/sweep2/ota_200cm_20261007_132830.png

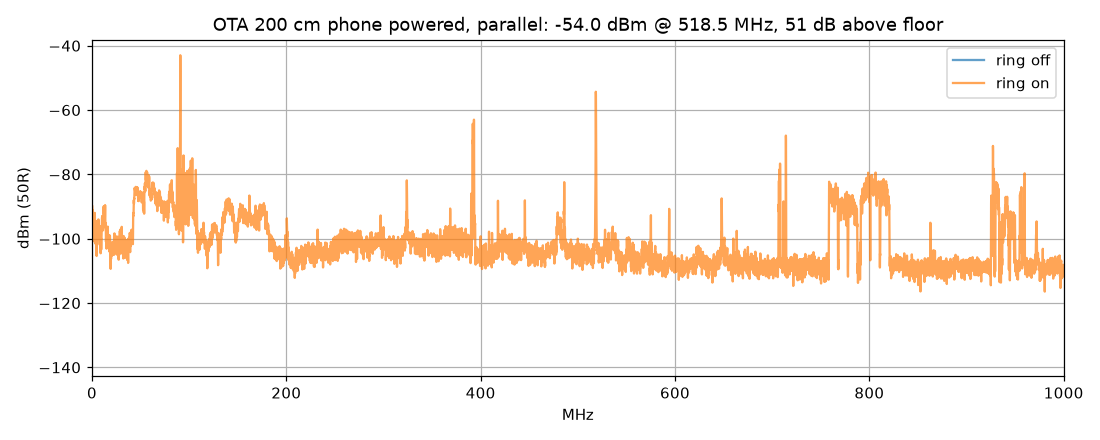
bench/data/sweep2/ota_200cm_20261007_132830.png
