mattvenn/ook-asic-radio/docs/explainer/brand_header.jpg

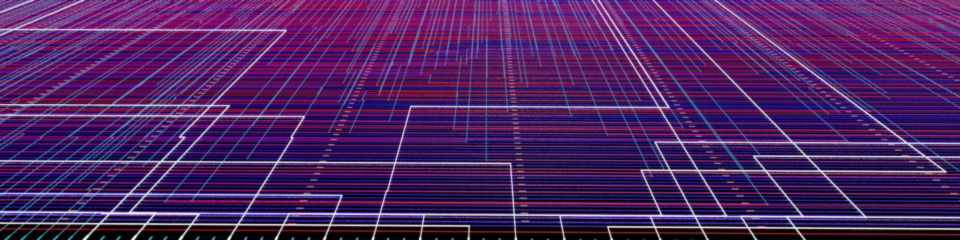
docs/explainer/brand_header.jpg
