mattvenn/ook-asic-radio/docs/explainer/layout.jpg

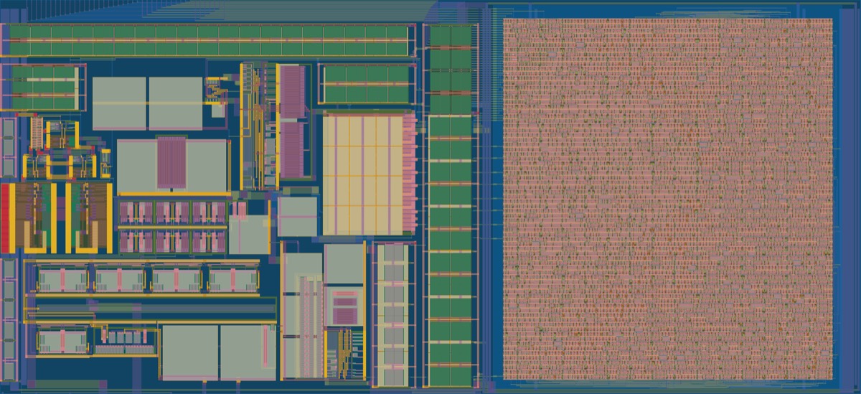
docs/explainer/layout.jpg
