mattvenn/ook-asic-radio/docs/explainer/yt_c53n4mH_RYg.jpg

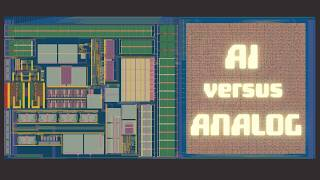
docs/explainer/yt_c53n4mH_RYg.jpg
