mattvenn/ook-asic-radio/docs/explainer/yt_fUDIhpx34Qk.jpg

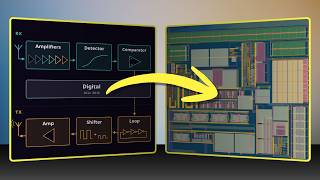
docs/explainer/yt_fUDIhpx34Qk.jpg
