mattvenn/ook-asic-radio/model/e2e_real.png

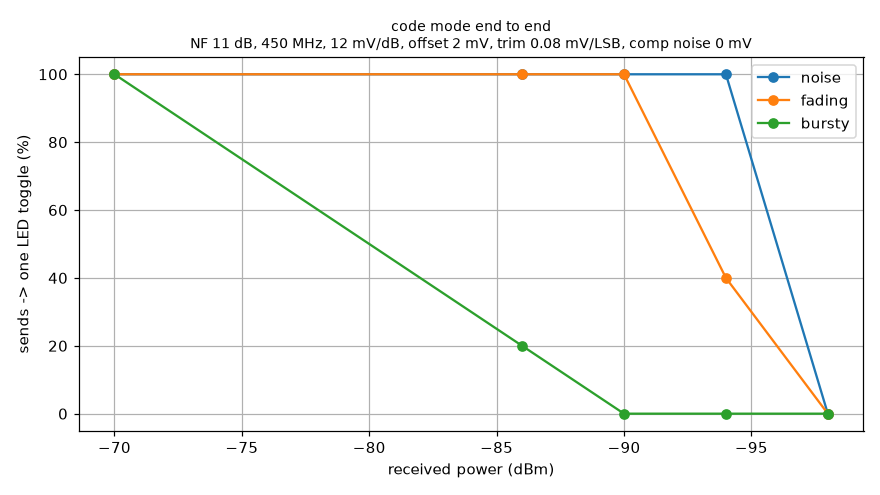
model/e2e_real.png
