mattvenn/ook-asic-radio/sim/plots/mixed_-70.png

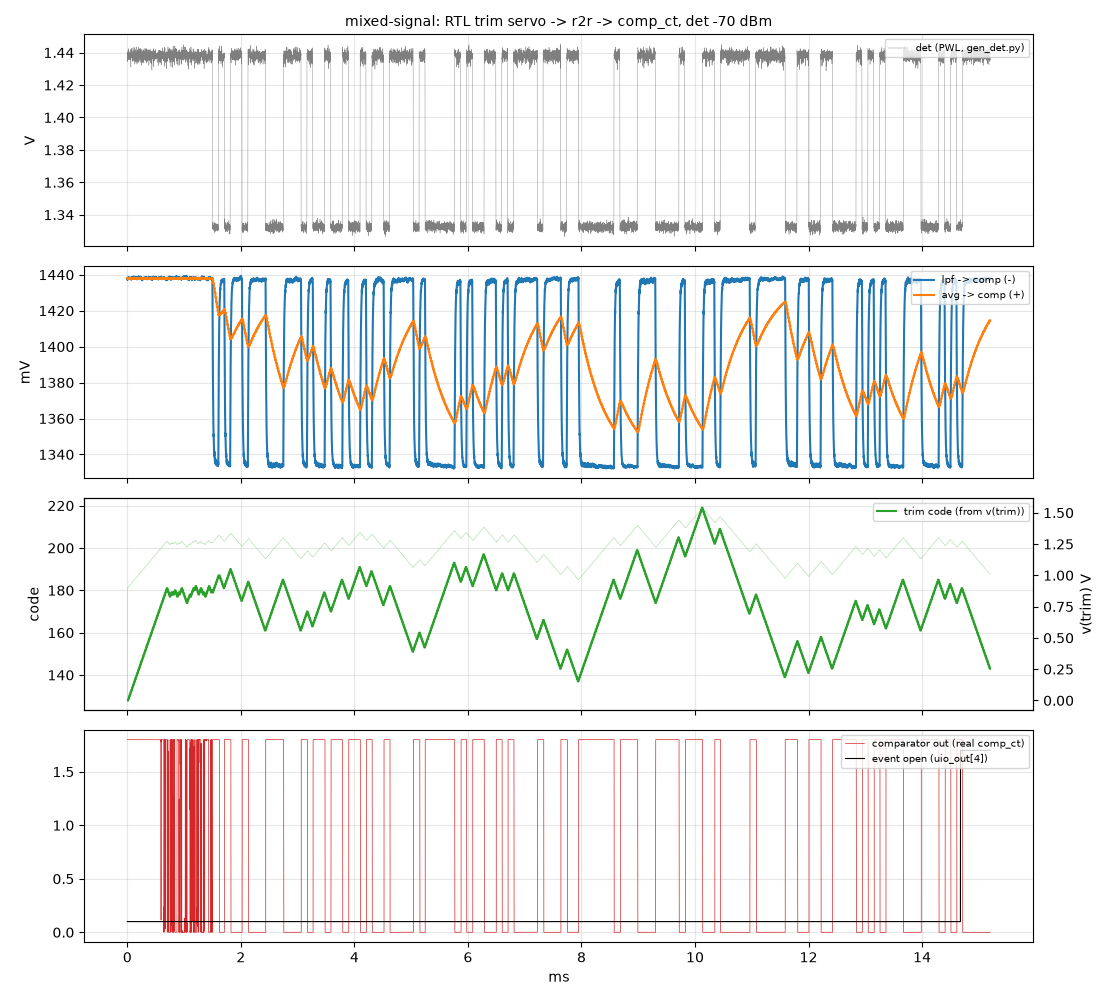
sim/plots/mixed_-70.png
