mattvenn/ook-asic-radio/sim/plots/mixed_-90.png

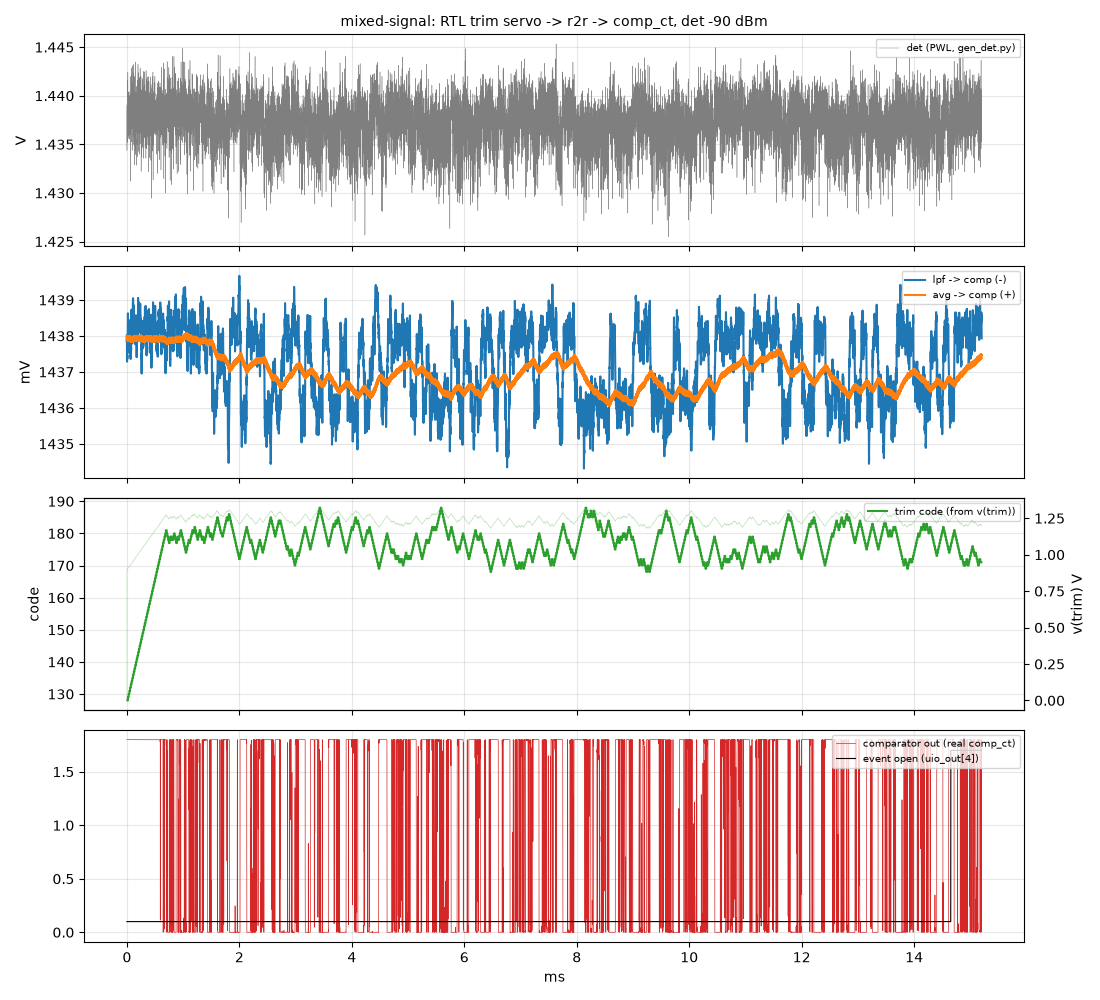
sim/plots/mixed_-90.png
