mattvenn/ook-asic-radio/sim/plots/mixed_-92_pex.png

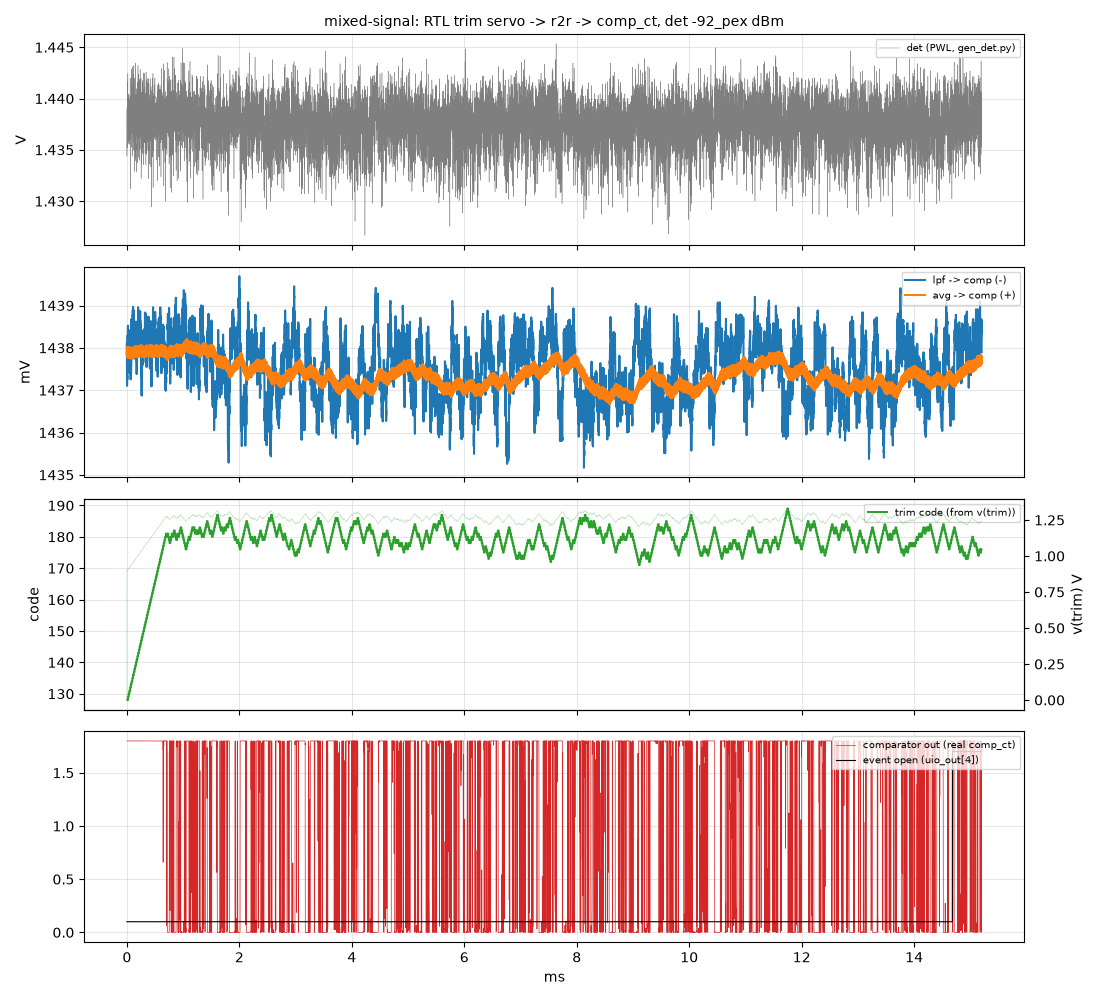
sim/plots/mixed_-92_pex.png
