mattvenn/ook-asic-radio/sim/plots/mixed_-94.png

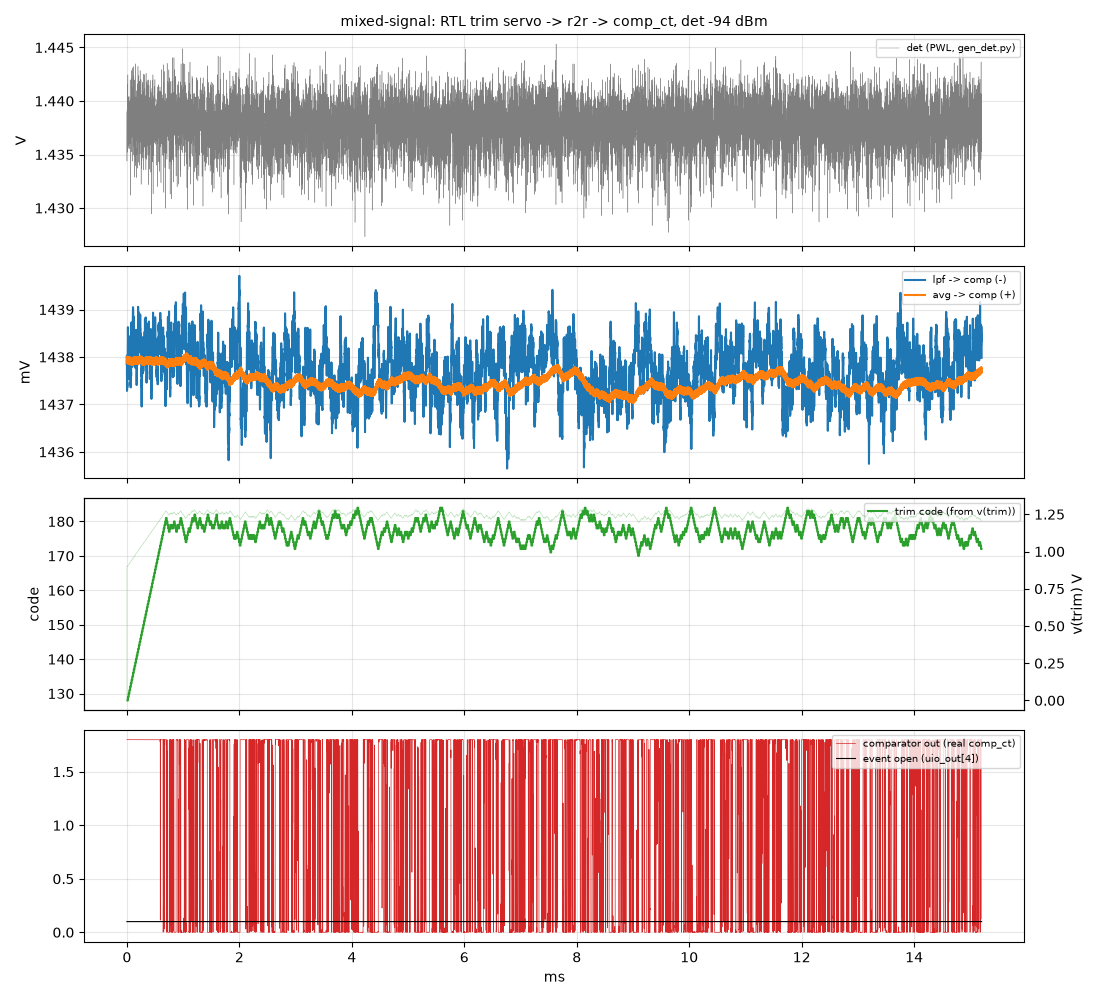
sim/plots/mixed_-94.png
