mattvenn/ook-asic-radio/sim/plots/mixed_-94_pex.png

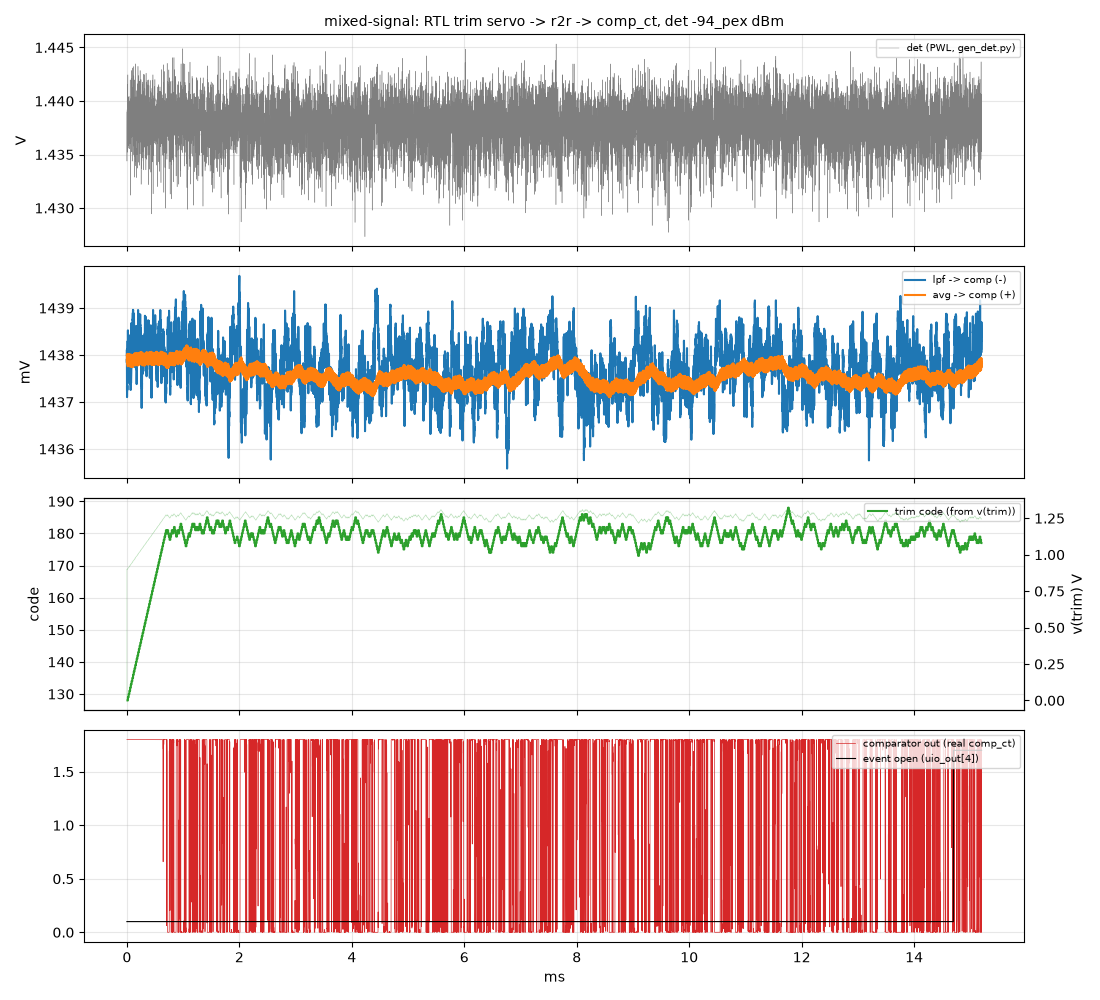
sim/plots/mixed_-94_pex.png
