mattvenn/ook-asic-radio/sim/plots/radio_digital.png

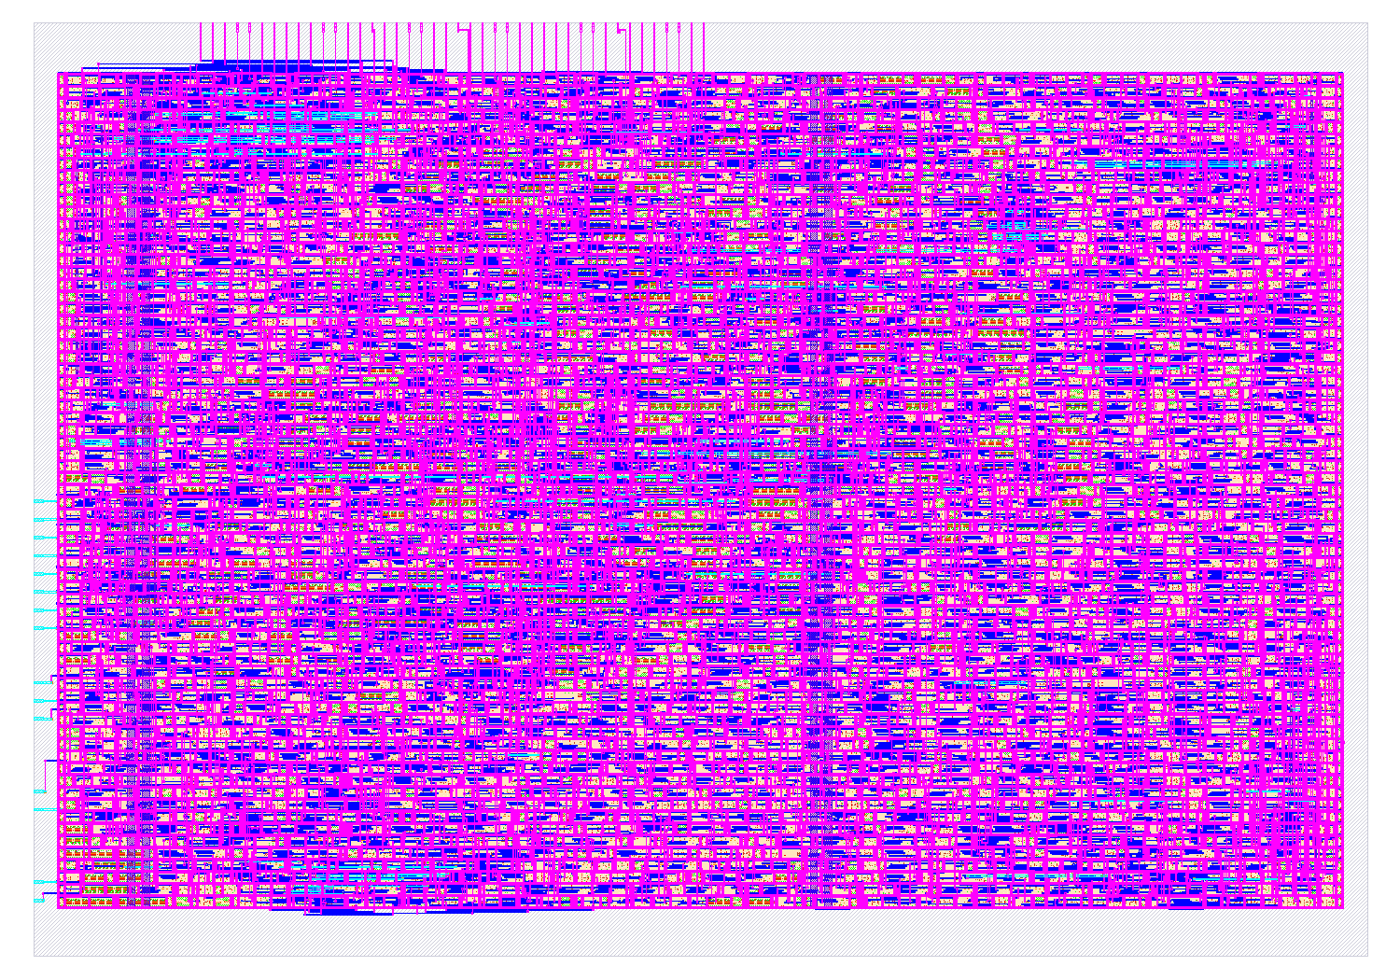
sim/plots/radio_digital.png
