mattvenn/ook-asic-radio/sim/plots/rx_bb.png

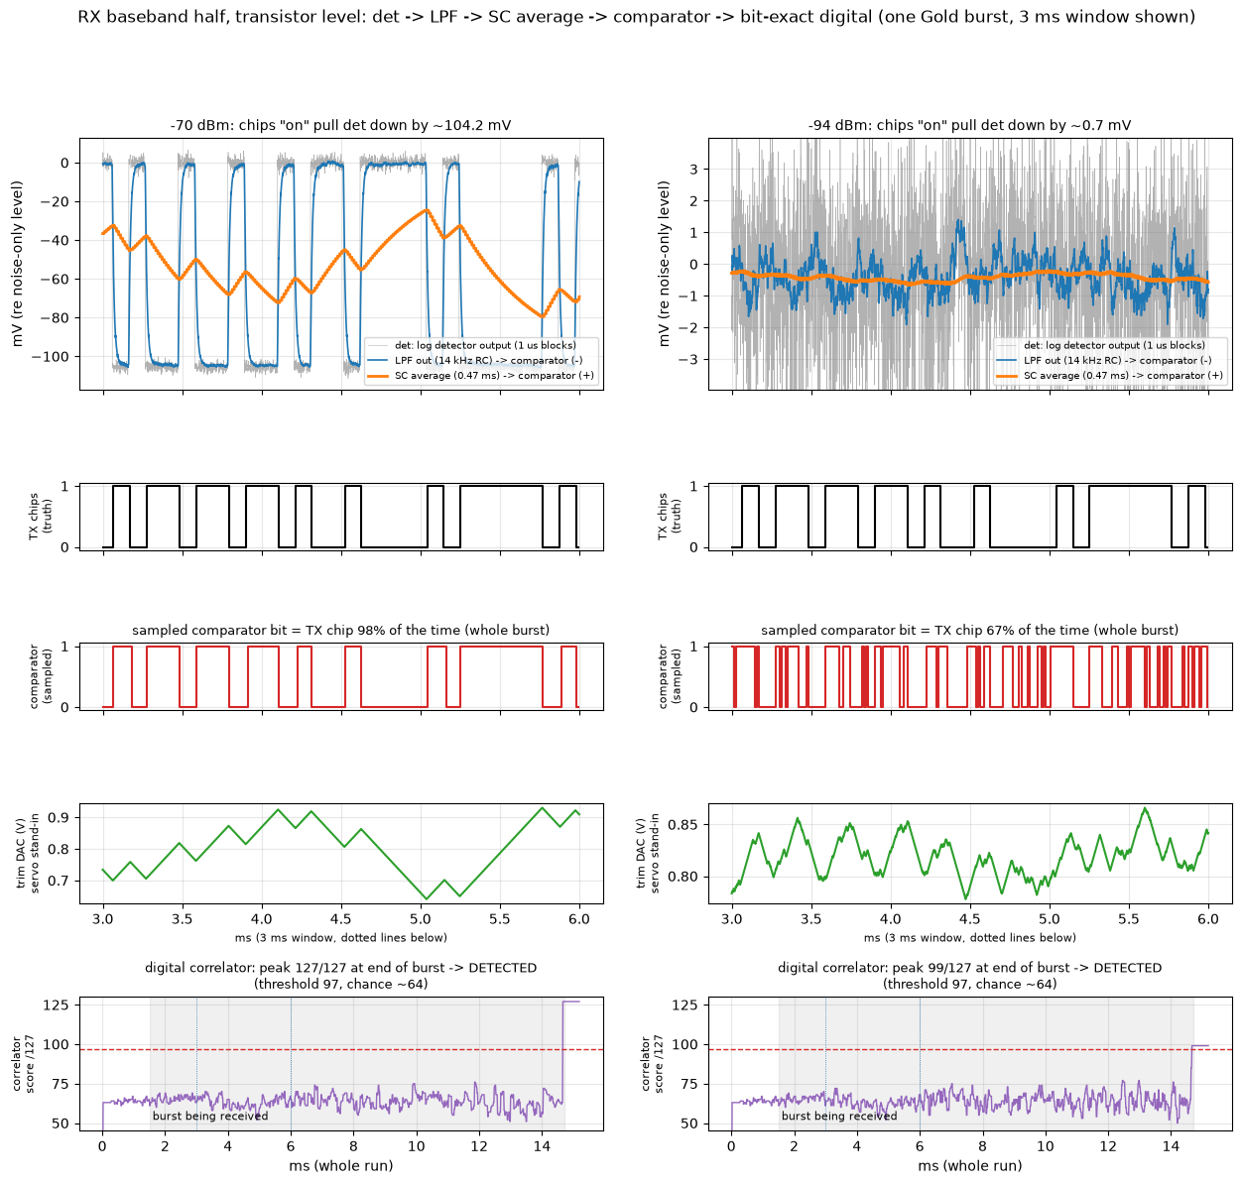
sim/plots/rx_bb.png
