mattvenn/ook-asic-radio/sim/plots/rx_rf.png

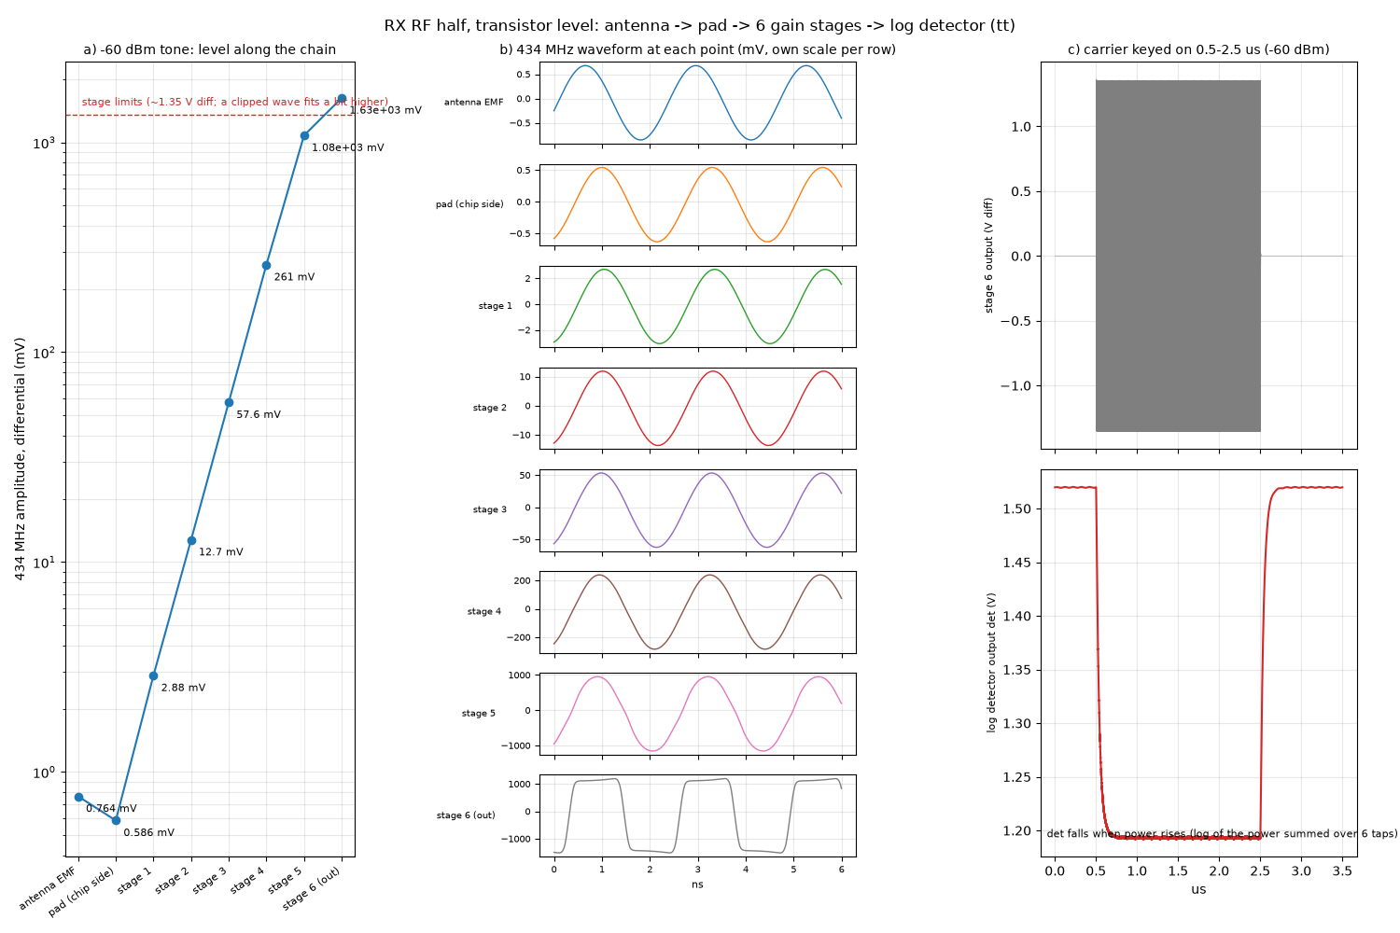
sim/plots/rx_rf.png
