mattvenn/ook-asic-radio/sim/plots/tb_input.png

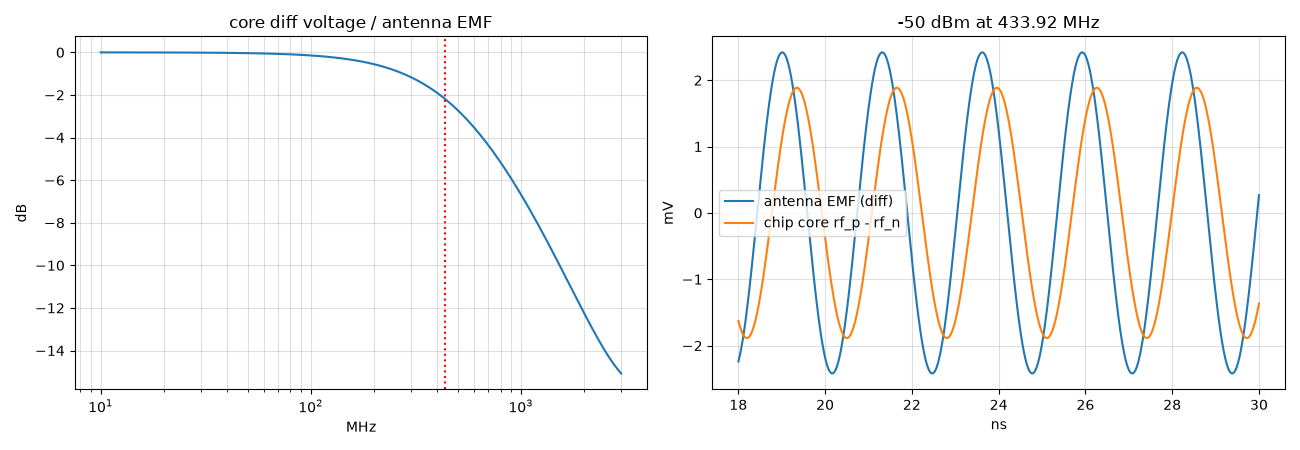
sim/plots/tb_input.png
