mattvenn/ook-asic-radio/sim/plots/tb_lna.png

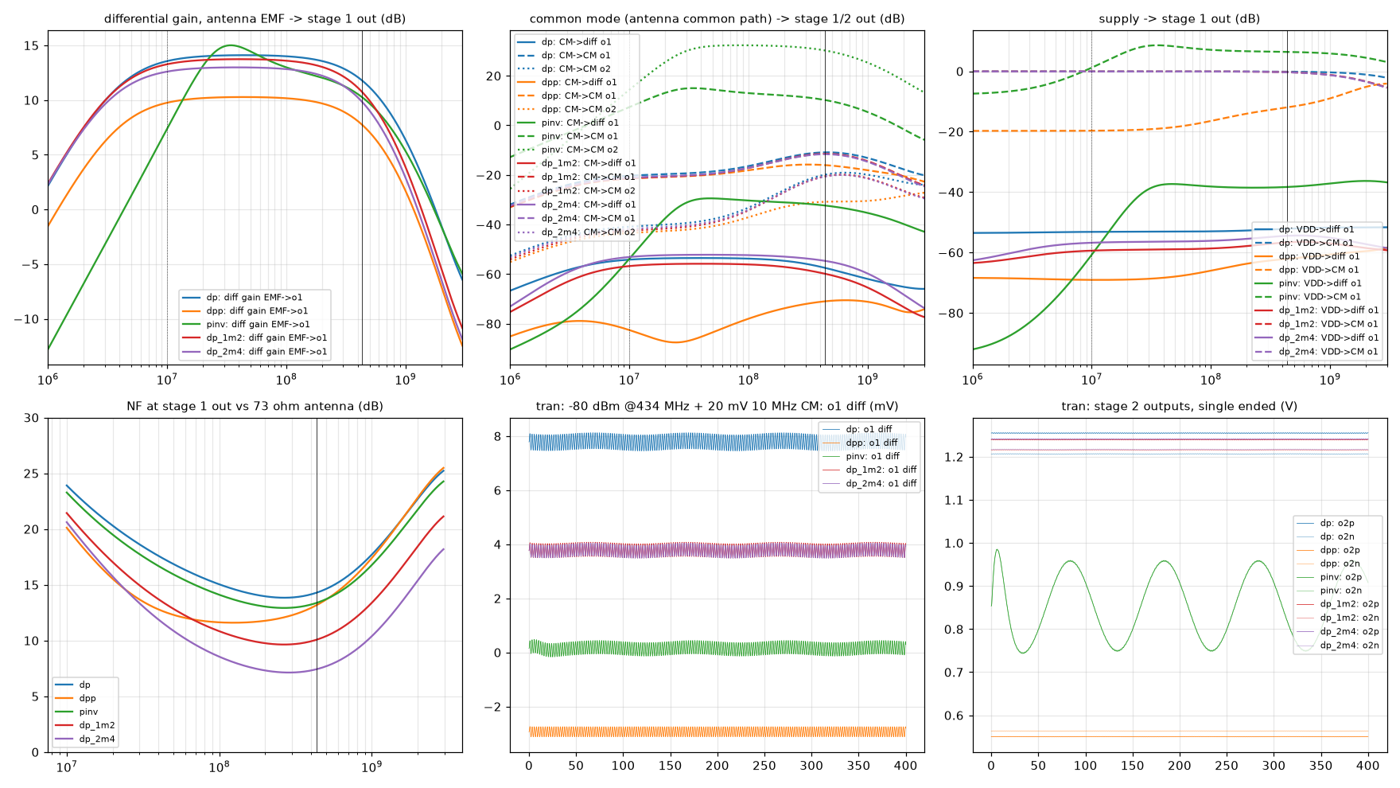
sim/plots/tb_lna.png
