mattvenn/ook-asic-radio/sim/plots/tx_drv_layout.png

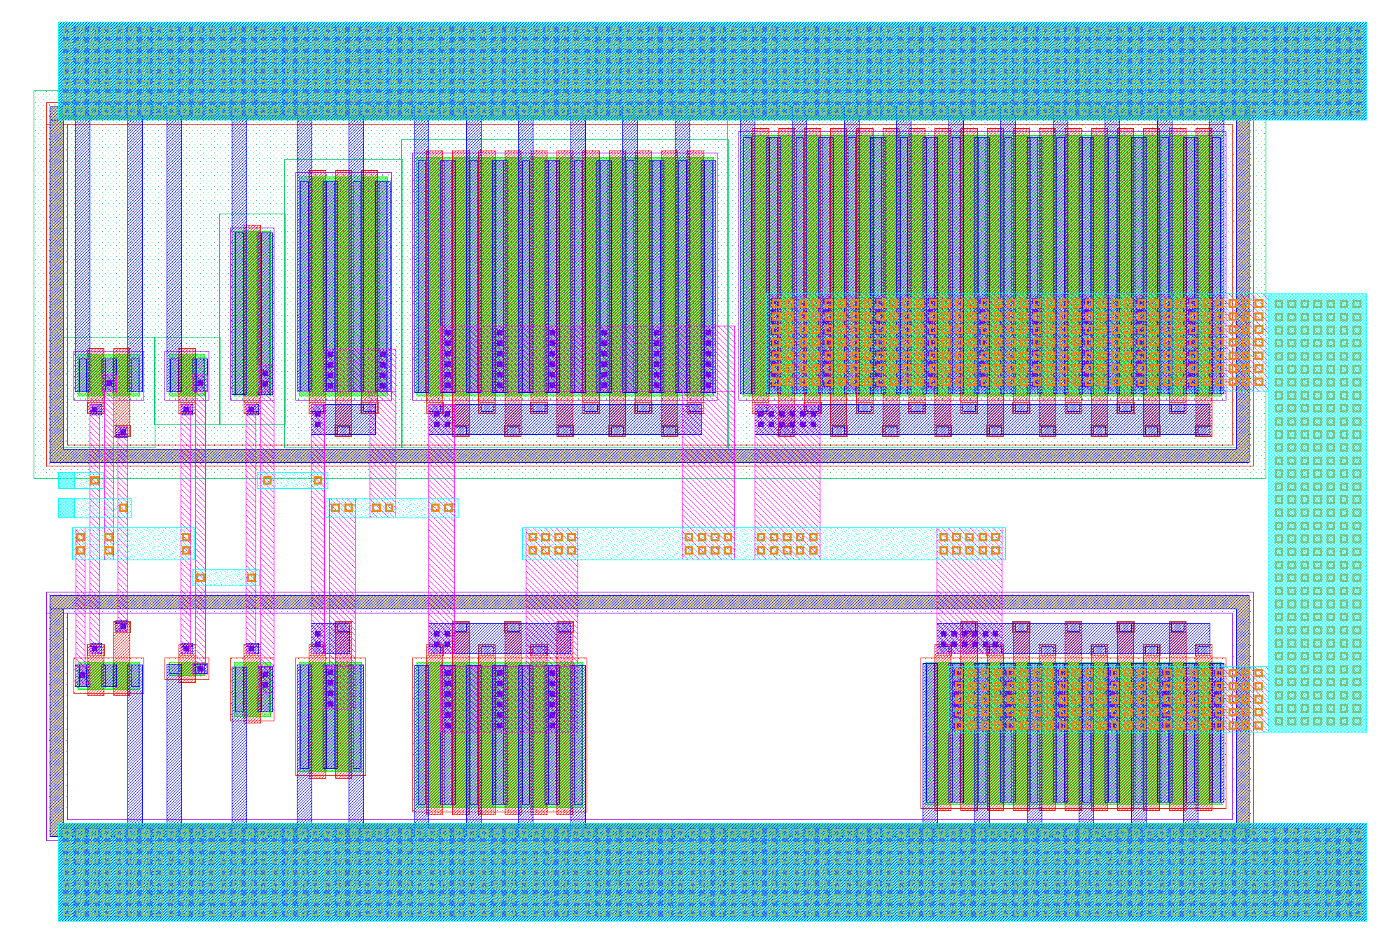
sim/plots/tx_drv_layout.png
