mattvenn/ook-asic-radio/docs/verify_2026-10-13.md

# Full verification, 2026-10-13/14 (sim-0)

Phase 4.2 of [plan_verify_gaps.md](plan_verify_gaps.md): a complete re-run of every check in
[verification.md](verification.md), including the ones added in phases 1–3 (verify_supply_mc.md,
verify_system_2.md), on branch `comp-trim` after the tile rebuild. What changed since the last full run
([verify_2026-10-11.md](verify_2026-10-11.md)):

- **comp_ct trim redesign H135** (finding 1, [verify_supply_mc.md](verify_supply_mc.md) 2.2): mirror
  W 8 L 2, trim pair W 8, Rdeg 0.85 MΩ, vref 1.35 V. Same footprint and pins except inp.
- **inp dead-end stub fixed** (STATUS 5a): inp's met4 riser runs straight to a met4 pin where `avg`
  arrives; three top-level routes move (avg, trim, ib_comp).
- **decap_vapwr parts written flattened** (phase 4.1); geometry identical.

Run on sim-0 (28 CPUs, IIC-OSIC-TOOLS 2026.09, ngspice 47, magic 8.3.642 for every extraction) through a
small job scheduler (`sim/rerun/sched.py`, job list `sim/rerun/jobs_2026-10-13.py`: 267 jobs, ~410
thread-hours, 16:25 → 06:25). **261 jobs OK, 0 failed, 0 skipped**, plus 6 adopted by a restarted
scheduler (checked by their logs). Every result below is compared with 2026-10-11 / -12.

## Summary

| Area | Result |
|---|---|
| Digital (RTL, GL, formal, pinout, TT top level, vectors, e2e model) | ✅ identical: RTL / GL 15/15, TT 4/4 + 4/4, formal PASS (`raw_rx` the intended FAIL), vectors bit-identical, e2e default as documented |
| Layout signoff (tile + 24 blocks) | ✅ tile: TT precheck pass, KLayout + magic DRC 0, LVS match, antenna 7 (in the macro, as before). Every block DRC 0 / LVS match; the decap hvi.5 flags are gone. GitHub: gds, docs and **lvs** (fixed, first passing run) pass |
| Analog blocks, schematic and extracted | ✅ all match, except **amp_dp / amp_dpc extracted −0.23 / −0.45 dB**: their committed netlists (2026-10-08) came from the older image's magic; re-extracted with 8.3.642 (committed now) |
| comp_ct (changed) | ✅ as designed: sch / pex balance code 183.9 / 184.1 at CM 1.0 V, step 0.134 / 0.136 mV/LSB, within 1 code / 1.2 % at 5 corners |
| Comparator Monte Carlo (committed schematic, 8 corners × 200) | ✅ **100 % of chips at −92 dBm at every corner except sf 10 °C CM 1.45 V (99.5 %)**, offset σ 2.1–2.9 mV, no duplicate samples, highest code 238 |
| Corners, temperatures, supply (RX) | ✅ chain, detector and current identical; comparator columns moved by design (step 0.122–0.150 mV/LSB, flat) |
| TX (5 corners, temperature, 9 supply points, extracted) | ✅ identical, incl. the known `tx_ls_en` failures at 1.71 / 3.6 V. Two marginal points at 1.71 / 3.3 V (ss, fs extracted) 0.4 dB lower |
| Mixed signal (RTL servo + transistor baseband) | ✅ **−92 dBm: schematic 6/6, extracted 6/6** (base + 5 seeds). −94 dBm (information): schematic 2/6, extracted 2/6 (was 3/5, 4/5 + base): the cost of H135's coarser step. Servo settles at 0.66–0.69 ms (burst at 1.5 ms). Bit-swap check fails as it must |
| Overload (−10 dBm then −90 dBm) | ⚠️ **new: dead time 0.25–0.3 ms** (was < 0.1 ms): the servo has further to climb back to its new balance (code ~179). Gaps ≥ 0.3 ms detect, at the old times |
| Extracted tile (lvs / c / rc, corners, CW) | ✅ identical (RX 2.985 mA, det idle 1.491 V, −60 dBm 1.206 V, TX +3.13 dBm at 519.3 MHz rc) |
| Joined RX (schematic, −90 / −70 / −10 dBm) | ✅ swing 1.43 / 100.8 / 887.6 mV (model 1.80 / 105.6 / 852.3), as before; −10 dBm comparator edges within 1 µs |
| Extracted-tile pair, −92 dBm | ✅ det off − on 1.41 mV (was 1.36; model 1.14), now at trim code 181 (was 117) |
| Power-up, pad overload, power-off states | ✅ identical |
| Power delivery (R, IR, EM, \|Z\|, TX transient) | ✅ identical; avg_sc VGND R 14.21 → 14.36 Ω |

**Sensitivity: −92 dBm for ≥ 99 % of chips at every corner (was 2/3 to 3/4 of chips); −94 dBm is now a
best case** (typical chip 27/48 in e2e, against 43/48). New finding #13: overload recovery 0.25–0.3 ms.

## Digital

| Check | Result | Expected |
|---|---|---|
| RTL cocotb (`verilog/test`) | 15/15 | 15/15 |
| Gate level (hardened netlist) | 15/15 (16 min) | 15/15 |
| TT top level (`test/`) RTL / GL | 4/4, 4/4 | 4/4, 4/4 |
| Formal `prove` / `raw_rx` | PASS / FAIL (the intended loopback trace) | same |
| Pinout check | OK (30 TT pins, info.yaml = schematic = macro) | OK (the checker now follows wires: commit c7e9eea) |
| `export_vectors.py` | bit-identical to `verilog/test/vectors/` | identical |
| `e2e.py` default | noise −94 5/5, −98 0/5; fading −90 5/5, −94 3/5; bursty −70 5/5, −86 3/5; 0 false toggles | same |
| `e2e.py`, H135 step, tt (0.127 mV/LSB, 48 trials) | −94 27/48, −92 48/48 | (new) |
| `e2e.py`, H135 p95 step at fs 50 °C (0.135) | −94 1/48, −92 45/48 (pass ≥ 44) | (new) |

## Layout signoff

| Check | Result |
|---|---|
| Tile `check_top.sh` (on `build/top` and on `gds/`) | precheck PASS, KLayout 0, magic 0, LVS "Circuits match uniquely", antenna 7 (macro) |
| `check.sh`, all 24 leaf blocks | DRC 0 (magic, KLayout), antenna 0, LVS match. decap_vapwr_p1–p5 clean on their own now |
| `pex.sh`, 14 blocks + comp_ct; `pex_tile.sh` lvs / c / rc | done (magic 8.3.642); tile rc 17,994 C, 84,733 R, no missing ports (was 17,968 C) |
| GitHub actions on `comp-trim` | gds (TT precheck) ✅, docs ✅, **lvs ✅**: the first passing lvs run (it had failed since ≥ 2026-10-07: PDK hash volare didn't have, the TT template's mag/ flow, the pinout parser) |

Re-extracted block netlists that differ only in node names / ordering (same test results) were not
committed. **amp_dp / amp_dpc were**: the committed ones dated from 2026-10-08 (the 2026.05 image's
magic), and with the committed netlists the tests give exactly the 2026-10-11 numbers (15.81 / 14.14 dB).

## Analog per block (tt)

| Block | Schematic | Extracted | 2026-10-11 extracted | |
|---|---|---|---|---|
| amp_dp | 14.74 dB, 1.525 mA | **15.58 dB**, 1.510 mA | 15.81 dB, 1.533 mA | ⚠️ re-extraction |
| amp_dpc | 13.59 dB, 0.723 mA | **13.69 dB**, 0.716 mA | 14.14 dB, 0.720 mA | ⚠️ re-extraction |
| det_cell | idle 1.7498 V, drop 6.64 mV at 100 mV | idle 1.7515 V, 5.57 mV | 1.7515 V, 5.92 mV | ✅ (5.57 with the netlist committed 2026-10-13) |
| log_det | idle 1.5197 V | 1.4888 V, −1.46 mV at 100 mV | 1.4888 V | ✅ |
| lpf_rc | 14.75 kHz, −89.4 dB at 434 MHz | 14.65 kHz, −106.9 dB | same | ✅ |
| avg_sc | τ 0.458 ms, drift −0.015 mV | τ 0.423 ms, +0.070 mV | same | ✅ |
| r2r | 0.000 LSB, 24.6 ns | ≤ 0.021 LSB, 30.6 ns | same | ✅ |
| bias_gen | ib_chain 59.36 µA | 59.31 µA (−0.08 %) | same | ✅ |
| dbg_tg | Ron 0.53 / 4.11 / 1.13 kΩ | 0.57 / 4.14 / 1.15 kΩ, off −73.5 dB | same | ✅ |
| tx_ring | 485.5 MHz | 530.1 MHz | same | ✅ |
| tx_ls | A duty 43.4 %, arms 45.7 / 50.5 % | 36.4 %, 41.4 / 48.3 % | same | ✅ |
| tx_ls_en | delay 1112 / 1380 ps | 3574 / 3808 ps | same | ✅ |
| tx_drv | | P_dip +5.49 dBm | same | ✅ |
| **comp_ct (H135)** | offset −7.51 mV at mid-trim, 0.1344 mV/LSB, code 183.9 | −7.63 mV, 0.1359, code 184.1 | (old design: +0.56 mV, 0.0656) | ✅ as designed |

Also: chain stability (tt, ss 10 °C, ss 10 °C at 1.89 V) stable to 0.1 fF, 1 fF rings (growth ~0.99),
85.2 dB at ss 10 °C 1.89 V; decap AC VAPWR 50.06 pF, VDPWR 29.91 pF, flat to 434 MHz, ±10 %; bias OTA loop
PM 90–91.5°. All as before.

## Corners, temperatures, supply

- **RX** (`rx_corners.sh`, 5 corners × 10 / 50 °C, ideal and real bias, −20 / 27 / 85 °C, VDPWR 1.71 / 1.8 /
  1.89 V): current 2.84–2.91 mA, gain at 434 MHz 73.3–81.2 dB, NF 9.4–12.0 dB, det idle 1.499–1.535 V, slope
  10.0–14.1 mV/dB: identical. **Comparator** (H135): offset at mid-trim −5.7…−9.0 mV (the designed-in
  offset), trim span about −14 / +6…+10 mV, step 0.136–0.147 mV/LSB at 10 / 50 °C (was 0.089–0.130). sf at
  CM 1.55 V still has no threshold (known).
- **Extracted tile, rc, corners** (fs 50 / ss 10 / ff 50 °C): det idle 1.500 / 1.502 / 1.475 V, det at
  −60 dBm 1.236 / 1.178 / 1.261 V, TX 530 / 427 / 588 MHz at +2.91 / +3.45 / +2.29 dBm: identical. rc at
  50 °C +2.67 dBm.
- **TX**: schematic +4.14 / +4.26 / +4.14 / +4.23 / +4.14 dBm (tt ss ff sf fs), single-ended −2.2…−2.6;
  extracted +3.66…+3.85, single-ended −2.6…−3.3; tile TX +4.41…+4.55 dBm at 10 °C, +3.75…+3.89 at 50 °C.
  Supply tables (9 points, schematic and extracted ring + driver) identical to verify_supply_mc 2.1
  (ss 1.71 / 3.6 V fails in both, fs fails extracted), except extracted ss / fs at 1.71 / 3.3 V: +1.79 /
  +1.77 dBm (was +2.22 / +2.21), the marginal `tx_ls_en` points (finding #2). The supply is 1.8 / 3.3 V
  (measured 1.80–1.81 / 3.30 V), so none of the 1.71 V points occur.
- **Analog top over supply** (`tb_tile.py --vdd --vapwr`, 6 points): identical to verify_supply_mc, including
  the ss 1.71 / 3.6 V TX failure.

## Mismatch

| | Result | Before |
|---|---|---|
| comp_ct, committed schematic (`tb_comp_ct.py --mc 200 --step`), tt / ss / fs / ss 10 / fs 50 / ff 50 °C, CM 1.5 | 100 % at ≤ 0.19 mV/LSB, offset σ 2.1–2.5 mV, code 170–182 ± 16–20, max code 238; no duplicate rows | (H135 candidate: same) |
| comp_ct, sf 10 / sf 27 °C, CM 1.45 V | 99.5 % / 100 %, code 135 / 148 | (H135 candidate: 99 %) |
| avg_sc, tt 27 °C | settled offset −0.024 ± 0.143 mV, a 0.0280 | −0.04 ± 0.13 |
| lna_chain (20 samples) | gain 75.9–77.0 dB (nominal 76.7) | 76.3–77.3 |

## Mixed signal

| Level | Schematic | Extracted baseband | Before (sch / pex) |
|---|---|---|---|
| −70 dBm | 14.675 ms | | 14.674 |
| −90 dBm | 14.650 ms | | 14.649 |
| −92 dBm, base + 5 seeds | **6/6** (14.642–14.673 ms) | **6/6** (14.645–14.680 ms) | 6/6, 6/6 |
| −94 dBm, base + 5 seeds (information) | 2/6 | 2/6 | 3/6, 5/6 |
| −70 dBm, trim_out[1:0] swapped | PIN ORDER PROBLEM (as it must) | | same |

Pin order OK in every run. The servo now settles at code 177–180 (dither ±8, σ 2.6–4.6 LSB), reached at
0.66 ms schematic / 0.69 ms extracted, 0.8 ms before the burst. The RTL's reset code (128) stays.

**Overload** (`--overload=<gap>`: a −10 dBm burst, then −90 dBm after the gap):

| gap ms | 0.1 | 0.25 | 0.3 | 0.4 | 0.5 | 1 | 2 | 5 |
|---|---|---|---|---|---|---|---|---|
| weak burst event, ms | **missed** | **missed** | 28.173 | 28.275 | 28.380 | 28.875 | 29.887 | 32.866 |
| before | 27.967 | 28.119 | | | 28.377 | 28.872 | 29.887 | 32.864 |

After the strong burst the servo is pulled down to code ~62 and climbs back at one code per 13 µs to ~179;
until it is close enough the weak burst isn't seen. **Dead time 0.25–0.3 ms, was < 0.1 ms** (finding #13).

## Extracted tile and joined RX

| Run | Result | Before |
|---|---|---|
| `tb_tile.py` lvs | 2.987 mA, TX +3.07 dBm at 680 MHz | 2.99 mA, +3.07, 680 |
| `tb_tile.py` c | 2.987 mA, 0.910 µA off, det 1.4915 V, −60 dBm 1.207 V, +3.38 dBm 537 MHz | identical |
| `tb_tile.py` rc | 2.985 mA, det 1.491 V, −60 dBm 1.206 V, +3.13 dBm 519.3 MHz | identical |
| CW, tile (sch / c / rc), det drop at −100 / −90 / −80 / −70 dBm | sch 0.53 / 5.20 / 41.94 / 173.14; c 0.71 / 6.96 / 52.79 / 172.84; rc 0.72 / 7.00 / 53.05 / 173.36 mV | identical |
| CW, block extractions (`cw_drop.py`) | pex 0.31 / 3.14 / 27.71 / 133.69 mV; log region −2.20…−1.39 dB; lna_chain −0.25, log_det −1.98 dB | identical (finding #5 open) |
| Tile scan | comp flips between codes **180 / 181** | 116 / 117 (old trim) |
| Tile pair −92 dBm, 30 µs, shared noise | det off − on 1.41 mV (2–30 µs), LPF 0.90 mV; model 1.14 | 1.36 / 0.87 |
| Joined RX −90 dBm (schematic) | det swing 1.43 mV, model 1.80 (4.1 h) | ~1.33 |
| Joined RX −70 dBm | 100.8 mV, model 105.6 (4.3 h) | matches the committed plot |
| Joined RX −10 dBm | det 1.4512 → 0.5637 V; comparator rises 60.15 / 269.22 µs, falls 191.26 / 392.65 µs | 0.563 V; 60.34 / 269.29, 190.54 / 392.28 |

The joined runs took ~4 h each on the 28-CPU pod at 2 threads (14.3 h for −70 dBm on the old 8-CPU quota).

## Power-up, pad overload, power-off

- Fast ramp (10 µs, c, tt / ss 10 / ff 50 °C): LPF settled 1.49–1.50 ms after `rx_en`, avg 2.65–2.66 ms,
  |tx_p| 48 / 286 / 16 mV, end current 2.985 / 3.017 / 2.945 mA. Slow ramp (10 ms): vcm 95 % at 6.26 ms, LPF
  0.64–0.67 ms, avg 2.08–2.09 ms (ff 50 °C similar). Schematic fast ramp done. All as 2026-10-12.
- One supply missing: VDPWR only 0.910 / 0.907 / 1.015 µA; VAPWR only ≤ 16 nA, tx_p = tx_n = 3.3 V
  (finding #7, unchanged).
- Pad overload: 0 dBm ±0.296 V at the pads, +6 dBm ±0.59 V (1.156 V differential), 11.65 mA; vcm 1.2012 V
  before and after; det back within 2 mV 0.3 µs after key-off. As before.

## Power delivery (case A)

R per block (VDPWR / VGND, Ω): chain 5.70 / 6.96, tx_drv_p 0.77 / 0.81, comp_ct 8.85 / 8.23, **avg_sc 11.87 /
14.36** (was 14.21: +1 %, the reroute / continuous VDD rail in comp_ct). IR at tx_drv_p VAPWR 5.6 mV avg / 18.7
peak, VGND 2.7 / 16.3. EM: VAPWR via4 42.4 %, met4 28.8 %, mcon 71.2 % (point-injection artefact); VGND
40.1 / 39.8 %. |Z| flat to 500 MHz, TX → log_det 0.068 Ω. TX keyed transient: tx_drv_p 29.21 mV p-p
(1.43 mV at 434 MHz), tx_drv_n 19.55, RX blocks 7.4–7.7 / 0.21–0.22 mV, det 3.47 mV at 434 MHz (was 3.39). All
as power.md "After the fix".

## Open items from this run

- **Finding #13 (new): overload recovery 0.25–0.3 ms** after a −10 dBm burst (was < 0.1 ms), from H135's
  balance point being further from where an overload pulls the servo. A strong nearby transmitter blinds the
  receiver for ~0.3 ms after it stops. Recorded, not fixed (a faster servo after a long one-sided run, or a
  reset code nearer 179, would shorten it; both are RTL changes).
  - **Restated 2026-11-06** (`docs/verify_lna_lo.md`, item 2 overload follow-up): there is no dead time. A replay of
    the detection score shows a gradual ~2–3 dB desensitisation for ~1 ms after the strong burst, recovered by
    ~5 ms. The 0.25–0.3 ms edge was single-run coin flips with the −90 dBm burst at threshold.
- amp_dp / amp_dpc extracted netlists updated to magic 8.3.642 (−0.23 / −0.45 dB in their block tests); the
  block-vs-tile extraction disagreement (finding #5) is otherwise unchanged.
- Not run: the closed loop through the extracted RF chain (finding #8, ~10 000 s per µs).
- Scheduler lessons (in `sim/rerun/sched.py`): `tools/osic`'s exit status is unreliable here (judge by the
  output files); a short job that gates a long one needs a high priority; long jobs need reserved threads;
  scripts that rewrite a shared netlist at start need staggered starts, not locks.
