mattvenn/ook-asic-radio/docs/verify_2026-10-11.md

# Full verification, 2026-10-11 (sim-0)

A complete re-run of every check in [verification.md](verification.md) on `main` @ 91786fa, the tile as
committed: 20-inverter TX ring, power fix merged. Run on sim-0, a k8s pod inside the IIC-OSIC-TOOLS
**2026.09** image. The previous runs used 2026.05. Everything passes except the two items under
"What moved". New checks this time: TX over temperature, the mixed-signal run on the extracted baseband,
overload recovery, the joined RX on the extracted tile, and the post-power-fix TX transient.

## Summary

| Area | Result |
|---|---|
| Digital (RTL, GL, model vectors, e2e) | ✅ all identical to the documented results |
| Layout signoff (tile + every block) | ✅ tile DRC 0 / LVS match / precheck pass. ⚠️ standalone magic DRC flags hvi.5 on 4 decap parts (not in the tile) |
| Analog blocks, schematic and extracted | ✅ all 14 testbenches match the docs |
| Corners and temperatures | ✅ RX matches. TX over temperature (new): +3.75…+4.55 dBm schematic, +2.67…+3.73 dBm extracted tile |
| Mixed signal (RTL + transistor baseband) | ✅ −92 dBm detects on schematic and extracted. ⚠️ −94 dBm schematic no longer detects (ngspice 47, at the edge) |
| Extracted tile (`tb_tile` lvs / c / rc) | ✅ matches the docs. First c / rc runs on the post-power-fix layout |
| Joined RX −90 dBm, schematic | ✅ after diagnosis. The low swing was the plot script's window choice, not the circuit |
| Joined RX on the extracted tile | ✅ 30 µs on/off pair at −92 dBm: det on − off 0.84 mV vs ~1.1 expected (±0.5 mV noise) |
| Overload (−10 dBm) | ✅ new: the comparator follows the keying, no latch-up, ~1.3 ms averager recovery |
| Power (R, IR, EM, \|Z\|, TX transient) | ✅ R / IR / EM / \|Z\| identical to power.md "After the fix". TX transient (first post-fix run): p-p at the drivers halved |

Sensitivity stands at **−92…−93 dBm** (tt), worst case −92 dBm (fs 50 °C). The −94 dBm mixed-signal
pass in the docs was at the edge and should not be quoted.

## Tools and machine

| | 2026.05 image (docs) | 2026.09 image (this run) |
|---|---|---|
| ngspice | (older) | 47 |
| magic | 8.3.642 | 8.3.684 (**not used for extraction**, see below) |
| KLayout | 0.30.x | 0.30.12 |
| netgen | | 1.5.323 |
| Icarus | | 14.0 (devel) |

- **magic 8.3.684 drops node-to-substrate C from `ext2spice`.** For example, tx_drv `out` drops from
  78 to 29 fF, comp_ct `inp` from 28 to 8.7 fF, and lpf_rc `out` loses all 25 fF. magic computes the C
  but doesn't write it. Every extracted result would look better than it is. All extractions in this
  run use magic 8.3.642, built locally (`~/.local/magic642`, `OSIC_MAGIC=<bin dir>`). The bad
  8.3.684 extractions are kept in `build/verify/pex_m684/`. DRC is the same on both (checked on
  decap_vapwr_p1).
- **KLayout 0.30.12:** the rebuilt tile differs from the committed `gds/` only by ≤5 nm slivers in
  lna_chain, comp_ct and bias_gen (rounding). LEF is identical. DRC is clean on both. The export was
  reverted.
- **ngspice 47:** small shifts. RX corner gains are within ±0.6 dB of the documented ranges. The −94 dBm
  mixed-signal run flips from detected to not detected (see below).
- **Wrappers:** inside the image there is no docker. `tools/osic` and `tools/osic-mac` now exec
  `tools/osic-inimage` when `$IIC_OSIC_TOOLS_VERSION` is set. `tools/longrun` falls back to `nohup`
  without systemd. 
- **sim-0 has an 8-CPU quota** (`/sys/fs/cgroup/cpu.max`), although `nproc` says 30. With 8 ngspice
  running, cgroup throttling cut throughput ~10×: the joined runs dropped from ~21 to ~2 µs/h. Keep it
  to **≤ 3 ngspice at once**.

## Digital

| Check | Result | Reference | |
|---|---|---|---|
| RTL cocotb | 15/15 | 15/15 | ✅ |
| Gate level cocotb | 15/15 | 15/15 | ✅ |
| `export_vectors.py` regenerated | bit-identical to `verilog/test/vectors/` | identical | ✅ |
| `e2e.py` default | noise −94 dBm 5/5, −98 0/5; fading −90 5/5, −94 3/5; bursty −70 5/5, −86 3/5; 0 false toggles (75 wrong-code sends, 9 signal-free) | same | ✅ |
| `e2e.py` tt / fs 50 °C | −92 dBm 12/12 / 12/12; −94 dBm 11/12 / 8/12 | STATUS.md | ✅ |

## Layout signoff

| Check | Result | |
|---|---|---|
| Tile build | 111/111 nets routed | ✅ |
| Tile precheck, KLayout DRC, magic DRC | pass, 0, 0 | ✅ |
| Tile LVS | Circuits match uniquely | ✅ |
| Tile antenna (magic) | 7, all on gates inside the digital macro (known) | ✅ known |
| Export vs committed `gds/` / `lef/` | LEF identical; GDS ≤5 nm slivers (KLayout 0.30.12); reverted | ⚠️ benign |
| Every leaf block: `check.sh` LVS, antenna, KLayout DRC | all clean | ✅ |
| Every leaf block: magic DRC | 0, **except decap_vapwr_p1–p4: hvi.5 (96 / 216 / 36 / 36)** | ⚠️ |
| `pex.sh` every block, `pex_tile.sh` lvs / c / rc | done (magic 8.3.642). rc: 17,968 C, 84,733 R, no missing ports | ✅ |

The decap hvi.5 flags (HVI-to-HVI spacing < 0.7 µm, e.g. at (16, 145–156) in p1) only appear when the
part's GDS is checked on its own with `gds maskhints yes`. The tile's magic DRC, run the same way, is 0,
and the TT precheck passes. Magic 8.3.642 reports the same. Likely cause: per-device hvi in the
standalone part that isn't flattened (`lay.py` `write(flatten=True)`, as for the TX blocks in 13c28aa).
The tile is unaffected. verification.md's "every block layout is DRC clean" needs this caveat, or the
decap parts need the flatten.

## Analog per block (tt)

| Block | Schematic | Extracted | Docs | |
|---|---|---|---|---|
| amp_dp | 14.74 dB at 434 MHz, 1.525 mA | 15.81 dB, 1.533 mA | | ✅ |
| amp_dpc | 13.59 dB, 0.723 mA | 14.14 dB, 0.720 mA | | ✅ |
| det_cell | idle 1.7498 V; drop 6.64 mV at 100 mV | 1.7515 V; 5.92 mV | | ✅ |
| log_det | idle 1.5197 V | 1.4888 V | 1.52 → 1.49 V | ✅ |
| lpf_rc | 14.75 kHz; −89.4 dB at 434 MHz | 14.65 kHz; −106.9 dB | | ✅ |
| avg_sc | τ 0.458 ms; drift −0.015 mV / 20 cycles | τ 0.423 ms; +0.070 mV | τ 0.42 ms | ✅ |
| comp_ct | offset +0.795 mV; 0.0649 mV/LSB | +0.560 mV; 0.0656 mV/LSB | +0.56 mV; 0.066 | ✅ |
| r2r | error 0.000 LSB; settles 24.6 ns | ≤ 0.021 LSB; 30.6 ns | ≤ 0.02 LSB | ✅ |
| bias_gen | ib_chain 59.36 µA | 59.31 µA (−0.08 %) | within 0.1 % | ✅ |
| dbg_tg | Ron 0.53 / 4.11 / 1.13 kΩ | 0.57 / 4.14 / 1.15 kΩ; off −73.5 dB at 434 MHz | | ✅ |
| tx_ring | 485.5 MHz | 530.1 MHz (~459 MHz on silicon) | 530 / ~459 | ✅ |
| tx_ls | A duty 43.4 %; arms 45.7 / 50.5 % | 36.4 %; 41.4 / 48.3 % | same | ✅ |
| tx_ls_en | delay 1112 / 1380 ps | 3574 / 3808 ps | | ✅ |
| tx_drv | P_dip +5.81 dBm | +5.49 dBm (−0.32 dB) | −0.32 dB | ✅ |

| Other analog | Result | |
|---|---|---|
| Chain stability (`stability.sh`) | tt stable up to 0.1 fF of coupling, ss 10 °C up to 0.2 fF | ✅ |
| Decaps (`decap_ac.sh`) | VAPWR 50.06 pF, VDPWR 29.91 pF, flat from 1 MHz to 434 MHz, ±10 % scale | ✅ |
| Bias OTA loop | 15 corner/temperature points: PM 90.0–91.5°, DC 28–35 dB, fu 0.76–2.2 MHz | ✅ |

## Corners and temperatures

**RX** (`rx_corners.sh`, 5 corners × 10 / 50 °C): I 2.84–2.91 mA, gain at 434 MHz 73.3–81.2 dB, NF
9.4–12.0 dB, det idle 1.499–1.535 V, slope 10.0–14.1 mV/dB, trim 0.089–0.130 mV/LSB at the DAC ends.
sf at comparator CM 1.55 V has no threshold, as documented in history.md (det stays ≤ ~1.45 V in
operation). e2e at fs 50 °C: −92 dBm 12/12. ✅

**TX corners** (`tb_tx.py`, dipole, antiphase):

| | tt | ss | ff | sf | fs |
|---|---|---|---|---|---|
| f (MHz) schematic | 485.5 | 401.6 | 547.6 | 462.5 | 502.1 |
| P schematic (dBm) | +4.14 | +4.26 | +4.14 | +4.23 | +4.14 |
| P, extracted tx_drv (dBm) | +3.66…+3.85 across the five corners | | | | |

Schematic matches the docs (+4.14…+4.26). With the extracted driver it is ~0.4 dB lower. Single-ended
(monopole) is −2.3…−2.6 dBm schematic, −2.6…−3.3 dBm extracted. Both arms are low when off.

**TX over temperature (new):**

| | 10 °C | 27 °C | 50 °C |
|---|---|---|---|
| schematic, 5 corners (dBm) | +4.41…+4.55 | +4.14…+4.26 | +3.75…+3.89 |
| extracted tile, c (dBm) | +3.73 | +3.38 | +2.89 |
| extracted tile, rc (dBm) | +3.47 | +3.13 | +2.67 |

About −0.03 dB/°C. The frequency barely moves with temperature (tt 483.9 → 487.2 MHz schematic). On the
extracted tile, P-arm duty is 30–32 % and N-arm 45–47 %: the known lopsided level shifter.

## Mixed signal (RTL in ngspice + transistor-level baseband)

| Level | Baseband | Event opens | Pin-order check | Servo (last half) | |
|---|---|---|---|---|---|
| −70 dBm | schematic | 14.674 ms | OK (1169 steps) | mean 104, 69–151 | ✅ same as before |
| −90 dBm | schematic | 14.649 ms | OK (1171) | mean 108, 96–121 | ✅ new |
| −92 dBm | schematic | 14.663 ms | OK (1172) | mean 108, 99–119 | ✅ new |
| −94 dBm | schematic | **no event** | 1173 steps, just outside 1169 ± 3 | mean 108, 100–117 | ❌ was detected (14.67 ms) |
| −94 dBm | **extracted** (new) | 14.694 ms | OK | mean 114.5 | ✅ |
| −92 dBm | **extracted** (new) | 14.672 ms | OK | 103–124 | ✅ |

- −94 dBm is the detection edge. The stimulus is identical (fixed seed). With ngspice 47 the schematic
  comparator path lands just below the edge, while the extracted baseband (comp offset +0.56 mV vs +0.80
  mV schematic) lands just above. The model agrees that −94 dBm is marginal (fading 3/5, fs 50 °C 8/12).
- The extra ladder steps at every level are all ±1: the comparator toggling near clock edges, not
  bit-order errors.
- **Quote −92 dBm for mixed signal.** It passes on both schematic and extracted. Plots:
  `sim/plots/mixed_{-90,-92,-92_pex,-94_pex}.png`. `mixed_-94.png` is kept from the
  earlier run (detected, older ngspice); how_it_works.md now shows −92 dBm.

## Extracted tile (`tb_tile.py`)

| Mode | RX mA | all off µA | det idle V | det −60 dBm V | TX | |
|---|---|---|---|---|---|---|
| sch | 2.974 | 0.908 | 1.521 | 1.206 | +4.14 dBm, 485.5 MHz | ✅ |
| lvs | 2.99 | 0.910 | 1.49 | 1.097 | +3.07 dBm, 680 MHz | ✅ (no wiring C) |
| c | 2.986 | 0.910 | 1.4915 | 1.207 | +3.38 dBm, 537 MHz | ✅ |
| rc | 2.985 | 0.910 | 1.491 | 1.206 | +3.13 dBm, 519.3 MHz | ✅ |
| docs (rc, pre-fix) | 2.985 | 0.910 | 1.491 | 1.203 | +3.18 dBm, 520 MHz | |

These are the first c / rc runs on the post-power-fix layout (power.md listed them as still to do).
Within 0.05 dB and 3 mV of the pre-fix layout.

## Joined RX (whole receiver at transistor level, RF noise)

### −90 dBm, schematic (new level)
`plot_joined.py` reported an on/off LPF swing of 0.63 mV against 1.80 mV from the model. Diagnosis:

1. **Window choice (the cause).** `plot_joined.py` skipped 40 µs after every window start, including
   the first off chip (20–60 µs → empty) and the last (372–400 µs → empty). That left the off level to
   one 64 µs window. Per chip the det swing is **1.81 mV** for chip 1 (model 1.80) and ~1.4 mV for
   chip 2, which sits on a slow +3 mV wander. With 10 µs blocks: 1.28 ± 0.48 mV (1σ). Fixed in
   `plot_joined.py` (df17a26): det now skips 2 µs after each edge, and the LPF settle applies only
   after key edges. It now reads 1.33 mV det swing.
2. **Noise bandwidth:** the chain's ENBW is 407–454 MHz (model 450). Not the cause.
3. **Noise-free CW through the real chain** (det drop vs model):

   | Level | real | model |
   |---|---|---|
   | −100 dBm | 0.55 mV | 0.77 mV |
   | −90 dBm | 5.42 mV | 6.27 mV |
   | −80 dBm | 43.5 mV | 47.3 mV |
   | −70 dBm | 177.0 mV | 175.0 mV |

   Square law holds. The real chain is ~0.6 dB less sensitive at low level. No deterministic drift
   (0.15 mV over 60 µs).
4. **Wander:** two noise-only runs (seeds 777 / 778, 200 ps noise step) give 10 µs det block sd 0.79 /
   0.88 mV and LPF sd 0.51 / 0.65 mV (model ~0.67 / 0.59). The joined run's off-chip sd is 1.37 mV
   (n = 14). Same order, so chip 2's wander is RF noise, not a defect.
5. **Device (flicker) noise**, ngspice `.noise` at det: 35 µV/√Hz at 10 Hz, 5.1 at 1 kHz, 1.9 at
   10 kHz. That is 0.45 mV rms after the LPF and 0.34 mV rms in LPF − average. The model budgets 0.3 mV
   comparator noise. e2e with 0.45 mV: −92 and −94 dBm still 5/5.

**Conclusion:** false alarm. The circuit matches the model within ~0.5 dB, and the e2e sensitivity
(−92…−93 dBm) stands. The committed `rx_joined.png` (−70 dBm) is unchanged.

### Joined RX on the extracted tile (new)
The full 400 µs run on the extracted tile (c mode) ran at ~2 µs/h, about 8 days in total, so it was
stopped. A short replacement was run: two 30 µs runs at **−92 dBm**, keyed on at 1 µs, one with the
signal and one without, with the same noise seed (now `sim/top/tb_tile_joined.py pair`). The on − off
difference in det / LPF shows whether the signal survives the extracted layout at the right size.
30 µs is under a third of one 104 µs chip, so this checks signal level, not detection; the
mixed-signal runs check detection. The comparator can't discriminate here: the LPF falls from 1.49 to
1.42 V as the RF noise floor pulls det down, and the 0.42 ms averager can't follow in 30 µs.

| window | det off − on | LPF off − on |
|---|---|---|
| 1–5 µs | +0.02 mV | +0.11 mV |
| 5–10 µs | +2.37 mV | +0.44 mV |
| 10–20 µs | +0.86 mV | +1.14 mV |
| 20–30 µs | +0.14 mV | +0.90 mV |
| **2–30 µs mean** | **+0.84 mV** | |

**Result: ✅ consistent.** The model expects ~1.1 mV at −92 dBm (1.80 mV at −90 dBm, square law). The
shared seed removes the noise-only term, but the signal × noise cross term remains. (Correction,
2026-10-12: ngspice 47 doesn't repeat trnoise between runs, with `.options seed`, `set rndseed` or
`setseed`, so these two runs probably had independent noise and the ±0.5 mV is optimistic. The `pair`
mode now feeds both runs one noise file; the rerun on 2026-10-12 gives 1.36 mV over 2–30 µs, windows
1.13–1.56 mV: [verify_system_2.md](verify_system_2.md).) It wanders by a
few mV over 5–10 µs, as in the joined runs, so 28 µs gives about ±0.5 mV. The signal reaches det and
the LPF on the extracted tile with the expected sign and size. This is not a precise gain measurement.
The off run hit "timestep too small" at exactly 30 µs, after writing 3000 of 3001 points, so its data
is complete. Analysis: `tb_tile_joined.py --no-run pair -92` (the original `build/` scripts were lost with the pod; rebuilt 2026-10-12).

## Overload, −10 dBm (new)

The joined deck with the same keyed on/off/on stimulus at −10 dBm:
- The comparator follows the keying: rising at 60.34 / 269.29 µs, falling at 190.54 / 392.28 µs (26
  and 20 µs after key-off).
- det saturates at 0.563 V and recovers in ~10 µs. The LPF reaches 0.57 V and recovers in ~45 µs.
- The averager is pulled from 1.439 to 1.304 V over the run, ~70 mV per burst. With τ 0.42 ms it
  recovers in ~1.3 ms, so a weak burst right after a very strong one may need that long before the
  threshold is back (not simulated).
- No latch-up and no stuck state.

## Power delivery (`sim/power/`, case A)

| Check | Result | power.md "After the fix" | |
|---|---|---|---|
| R per block (`r_mesh.py`) | e.g. chain 5.70 / 6.96 Ω, tx_drv_p 0.77 / 0.81, avg_sc 11.87 / 14.21 | identical | ✅ |
| TX IR, both arms | VAPWR at tx_drv_p 5.6 mV avg / 18.7 peak worst; VGND 2.7 / 16.3 | 5.6 / 16 | ✅ |
| EM, VAPWR | via4 42.4 %, met3 29.6 %, met4 28.8 %, mcon 71.2 % (point-injection artefact, real ~9 %) | 42 / 30 / 29 / 71 | ✅ |
| EM, VGND | worst mcon 40.1 %, m1 39.8 % | < 50 % | ✅ |
| \|Z\| (`z_ac.py`) | identical to the table, flat to 500 MHz; TX→RX at log_det 0.068 Ω | identical | ✅ |

**TX keyed transient (`tran_tx.py`), first run after the power fix** (local VDD−VSS, last 10 ns):

| block | p-p (mV) before → now | 434 MHz (mV) before → now |
|---|---|---|
| tx_drv_p | 63.2 → **29.2** | 6.3 → **1.43** |
| tx_drv_n | 37.3 → 19.5 | 1.8 → 0.49 |
| log_det | 11.6 → 7.7 | 0.50 → 0.21 |
| dbg_tg | 11.9 → 9.2 | 0.47 → 0.15 |
| tx_ring | 8.9 → 6.9 | 0.29 → 0.19 |
| chain / avg_sc / comp_ct / bias | 6.6–7.2 → 7.4–7.6 | 0.19–0.26 → 0.21–0.22 |

det sees 3.39 mV at 434 MHz (was 4.89). The LPF removes this (−107 dB at 434 MHz extracted). The whole
chip still rings ~352 mV p-p in common mode against board ground. That comes from the assumed 2 nH
package with undamped grid C, not the layout.

## Open items from this run
- Coverage gaps found in review (supply, mismatch, extracted-chain detection, pinout, ...): [plan_verify_gaps.md](plan_verify_gaps.md).
- Decap parts p1–p4: standalone magic DRC flags hvi.5 (noted in verification.md). Tile signoff is
  unaffected; flatten them next time the layout changes.
- The tile extractions `layout/pex/radio_analog_{lvs,c,rc}.spice` are not committed (derived, ~4 MB;
  `layout/pex_tile.sh` regenerates them with magic 8.3.642).
