mattvenn/ook-asic-radio/sim/logdet/noise_tran_results.txt

RESULT none 1.43904 0.618748
RESULT -100 1.43866 0.620591
RESULT -97 1.43842 0.621748
RESULT -94 1.43797 0.623943
RESULT -91 1.43716 0.627856
RESULT -88 1.43566 0.634997
RESULT -85 1.43287 0.64805
RESULT -80 1.42194 0.69681
RESULT -75 1.39346 0.810365
