mattvenn/ook-asic-radio/docs/handoff_power_fix.md

# Handoff: fix the tile's power delivery (wider straps, TX rail feed, dedicated RX trunks)

Prompt for a new session (written 2026-10-10 by the power-measurement session). Paste it as is.

---

The routed tile has been benchmarked for power delivery (`docs/power.md`). It **fails EM on the TX
supply** and the **RX blocks sit 27–67 Ω from their supplies**. Your job: make the layout changes
below, check them (LVS / DRC first), then re-run the power flow and compare with the saved
baseline. Commit and push as you go (small commits; other sessions push to `main` too).

## Read first
- `docs/agent_start.md` (rules), `STATUS.md`.
- **`docs/power.md`**: the benchmark, the method, the what-ifs and the recommendation. All numbers
  below come from there.
- `docs/handoff_toplevel.md`: how the tile is built (blocks, straps, nets, routing intent).
- `docs/layout.md`: "Power: how the TT PDN connects", "Current limits: EM and IR" (the EM table).

## Rules for this job
- **Work in a separate git worktree on its own branch** (`git worktree add ../ook-asic-radio-power -b
  power-fix`): other sessions share the main checkout. Merge only when Matt says.
- **LVS (and DRC) before any simulation.** A what-if in the power session shorted VDPWR to VGND and
  an hour of runs was wasted. `layout/check_top.sh`; for the power flow's extraction copy also
  `grep shorted build/power/ext_*/magic.log`.
- Don't move blocks or change circuits: if a change needs that, write it down for Matt.
- Run slow jobs in the background and end the turn; one ngspice job at a time. Measured run times
  (not guesses): extraction ~30 s, mesh ~1 min, DC R per variant ~25 min (the VGND mesh), IR ~15 min,
  EM ~10 min. **About 45–50 min per variant.** Say this, not less.

## Where things are
- **Straps:** `layout/floorplan/floorplan.json` "straps" (x, w), generated by
  `layout/floorplan/mk_layout5.js` (don't hand-edit floorplan.json); drawn in `layout/gen/top.py`
  (strap loop and the met3 bars, `STRAP_Y0/Y1`, `BAR`).
- **Supply routes:** `layout/gen/top_nets.py`: `VAPWR_TX` (w 2.5, m3/m4), `VGND_TX` (w 2.0),
  `VDPWR_TX`, `VDPWR_RX` / `VGND_RX` (**w 1.0**, any strap via `STRAPS`), `VAPWR_DEC` / `VGND_DEC`.
  Constants that depend on the west / mid strap positions: `XSTRAP = 15.6` (first met4 drop clear
  of the west VGND strap) and the antenna jumper `XJ0, XJ1 = 274.0, 275.4` (west of the mid straps).
- **Router:** `layout/gen/route.py`. **Decaps:** `layout/gen/decap.py` (parts and rails).
- Build: `tools/osic-mac klayout -b -r layout/gen/top.py`, then `tools/osic-mac python3 layout/gen/route.py`
  → `build/top/tt_um_mattvenn_radio.gds`; checks `layout/check_top.sh`.

## The changes (in this order)

### 1. TX supply: must do (EM fail today)
| item | now | change | evidence (what-if W, docs/power.md) |
|---|---|---|---|
| west VAPWR strap | x 2.5, 1.2 µm | **x 0.3–5.3 (5 µm)**: 3 via4 columns per met5 landing | via4 210 → 62 %, met4 202 → 51 % of the EM limit; tx_drv_p avg drop 29 → 20 mV |
| tx_drv_p / _n top VAPWR rail | fed at one point | **feed it at several points along its length** (or widen / stack it where the route enters) | met3 at (56.5, 120.5), inside tx_drv_p: 275–285 % of the limit; wider routes don't help |
| via3, VAPWR at the west strap | | **≥ 2× the cuts** | 107 % at (4.5, 82.5) |
| west VDPWR / VGND straps | 1.2 µm | VDPWR **x 5.8–10.5**, VGND **x 12.0–15.1** | VGND 10.8 shorted to VDPWR metal in the copy: 12.0 is the limit |
| east VAPWR strap | x 488.02, 1.2 µm | **x 481.0–489.22** | free met4 west of it |
Target: every EM line in `em.py` under 50 % of the limit (≥ 2× margin, `docs/layout.md`).

### 2. RX supply: the real RX improvement
- Now: VGND avg_sc 67 Ω, comp_ct 57, r2r 35, bias 31; VDPWR log_det / avg_sc / comp_ct / dbg_tg
  27–32 Ω; flat to 500 MHz, so the decaps (behind it) do nothing at the blocks.
- Cause: **not the straps** (ideal straps leave it unchanged) **and not just the route width** (routing
  ×3 barely moves VGND): the RX ground current winds through other blocks' rails (bias met3 ~14 Ω,
  decap part 3 met1 ~10 Ω, the chain, comp_ct) and the 1 µm routes, ~150 Ω in series.
- **Change: dedicated VGND_RX and VDPWR_RX trunks, ≥ 4 µm, met3 + met4 stacked where free, from the
  mid straps (x ~278) straight to avg_sc, comp_ct, lpf, log_det, Ctrim / r2r and bias**, so no block's
  current runs through another block's rails. Trim decap parts 1, 3, 4 where the trunks need room
  (Matt agreed decap can go). Avoid met4 over MIM top plates; keep the lpf / avg / trim analog nodes'
  shielding intent from `docs/handoff_toplevel.md`.
- Expected (estimate, not simulated): RX R to roughly a quarter (avg_sc / comp_ct VGND ~15–20 Ω).

### 3. Only if 2 can't reach the mid straps
A 6 µm VGND / VDPWR strap pair in decap part 1 (full-height met4 is free there only if decap goes:
x 251.5–273.5; x 239.5–242.5 for 3 µm). Every other full-height column in the analog hits block
met4 / MIM.

## Verify
1. `layout/check_top.sh`: LVS clean, magic + KLayout DRC 0, power-pin precheck (each strap ≥ 1.2 µm,
   within 10 µm of the tile's top and bottom, no overlaps).
2. Power flow on the new GDS (case A; B only if A changes a lot):
   ```
   tools/osic-mac bash -c 'CASE=A VAR=fix bash sim/power/pex_power.sh'; grep -c shorted build/power/ext_A_fix/magic.log
   tools/osic-mac python3 sim/power/mesh.py A_fix 0.5
   python3 sim/power/r_mesh.py A_fix && python3 sim/power/ir_rx.py A_fix && python3 sim/power/em.py A_fix
   ```
   Compare with the baseline in `sim/power/results/2026-10-10/` (`r_mesh_A.json`, `ir_A.json`,
   `em_A.txt`). Optional: `sim/power/z_ac.py` (|Z| per block, 1 µm mesh, ~30 min) and
   `sim/power/tran_tx.py` (TX keyed, long).
3. The end-to-end decks still pass on the new extraction (`sim/top/tb_tile.py`, the other session's
   flow): bias, det idle, TX power.
4. Write the result into `docs/power.md` (a "After the fix" table next to the benchmark), one line in
   STATUS.md; save the raw results in `sim/power/results/<date>/`.

## Known limits of the power flow
- magic's extresist can't do supply nets (it lumps them into the port); the flow uses its own mesh
  of the traced metal, solved in ngspice. Details in docs/power.md "Method".
- The TT PDN outside the tile is modelled from tt-multiplexer (`sim/power/pdn.py`); the package
  (0.5 Ω, 2 nH, 1 nF chip C) is a guess. Substrate coupling isn't modelled.
- The 1 µm mesh (AC runs) reads RX ground ~30 % low; DC numbers use 0.5 µm.
