mattvenn/ook-asic-radio/docs/images/power_fix_routing.png

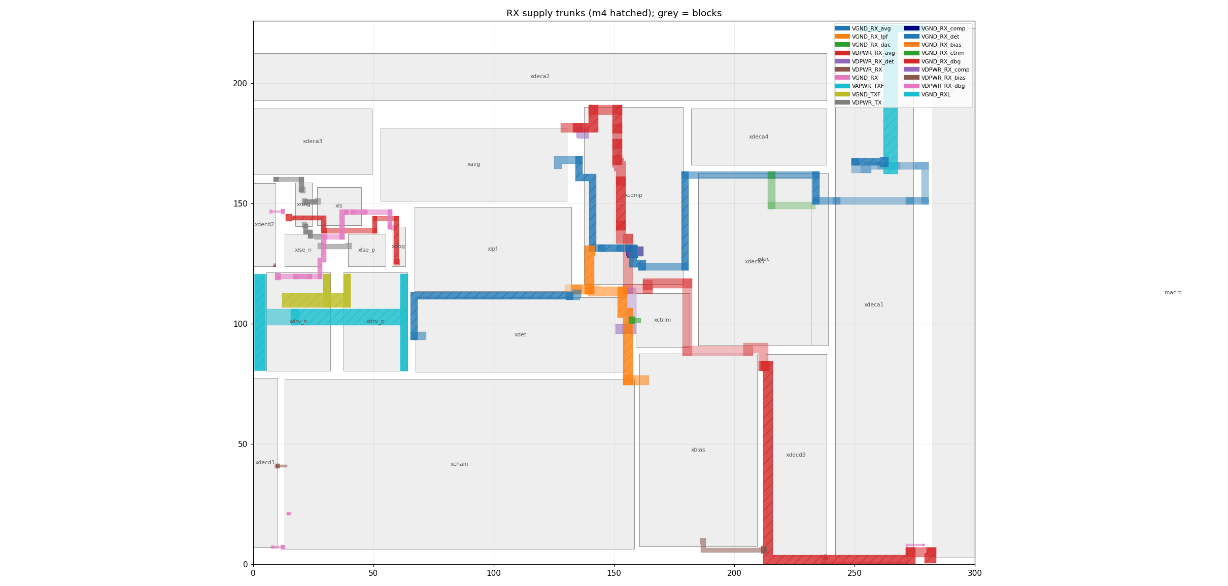
docs/images/power_fix_routing.png
