mattvenn/ook-asic-radio/layout/ref/lna_chain.spice

* lna_chain: xschem/lna_chain.sch with {'w1': 80, 'rl1': 1000.0, 'mt1': 20, 'w2': 20, 'rl2': 4000.0, 'mt2': 6, 'cs': 6e-13, 'cin': 2e-12, 'rb': 20000.0, 'mm': 0} (layout/gen/lna_chain.py)
** sch_path: /Users/mattvenn/asic/ook-asic-radio-shunt/xschem/lna_chain.sch
.subckt lna_chain inp inn ibias vcm lna_lo_n outp outn o1p o1n o2p o2n o3p o3n o4p o4n o5p o5n VDD VSS
*.PININFO VDD:B VSS:B ibias:B vcm:B lna_lo_n:B inp:B inn:B outp:B outn:B o1p:B o1n:B o2p:B o2n:B o3p:B o3n:B o4p:B o4n:B o5p:B
*+ o5n:B
XMref ibias ibias VSS VSS sky130_fd_pr__nfet_01v8 L=0.5 W=6 nf=2
XCin_p g1p inp sky130_fd_pr__cap_mim_m3_1 W=31.1588 L=31.1588
XRb_p g1p vcm VSS sky130_fd_pr__res_high_po_0p35 L=19.1327 mult=1
XCin_n g1n inn sky130_fd_pr__cap_mim_m3_1 W=31.1588 L=31.1588
XRb_n g1n vcm VSS sky130_fd_pr__res_high_po_0p35 L=19.1327 mult=1
xa1 g1p g1n ibias o1p o1n VDD VSS amp_dp
xa2 o1p o1n ibias o2p o2n VDD VSS amp_dpc
xa3 o2p o2n ibias o3p o3n VDD VSS amp_dpc
xa4 o3p o3n ibias o4p o4n VDD VSS amp_dpc
xa5 o4p o4n ibias o5p o5n VDD VSS amp_dpc
xa6 o5p o5n ibias outp outn VDD VSS amp_dpc
xsh o2p o2n lna_lo_n VDD VSS lna_shunt
.ends

* expanding   symbol:  amp_dp.sym # of pins=7
** sym_path: /Users/mattvenn/asic/ook-asic-radio-shunt/xschem/amp_dp.sym
** sch_path: /Users/mattvenn/asic/ook-asic-radio-shunt/xschem/amp_dp.sch


* expanding   symbol:  amp_dpc.sym # of pins=7
** sym_path: /Users/mattvenn/asic/ook-asic-radio-shunt/xschem/amp_dpc.sym
** sch_path: /Users/mattvenn/asic/ook-asic-radio-shunt/xschem/amp_dpc.sch


* expanding   symbol:  lna_shunt.sym # of pins=5
** sym_path: /Users/mattvenn/asic/ook-asic-radio-shunt/xschem/lna_shunt.sym
** sch_path: /Users/mattvenn/asic/ook-asic-radio-shunt/xschem/lna_shunt.sch

* amp_dp: xschem/amp_dp.sch with {'w': 80, 'l': 0.15, 'rl': 1000.0, 'wt': 6, 'mt': 20, 'mm': 0} (lay.write_ref)
** sch_path: /foss/designs/ook/xschem/amp_dp.sch
.subckt amp_dp inp inn nb outp outn VDD VSS
*.PININFO VDD:B VSS:B nb:B inp:B inn:B outp:B outn:B
XRl_p outn VDD VSS sky130_fd_pr__res_high_po_1p41 L=3.13504 mult=1
XMp outn inp tail VSS sky130_fd_pr__nfet_01v8 L=0.15 W=80 nf=4
XRl_n outp VDD VSS sky130_fd_pr__res_high_po_1p41 L=3.13504 mult=1
XMn outp inn tail VSS sky130_fd_pr__nfet_01v8 L=0.15 W=80 nf=4
XMtail tail nb VSS VSS sky130_fd_pr__nfet_01v8 L=0.5 W=6 nf=2 m=20
.ends

* amp_dpc: xschem/amp_dpc.sch with {'w': 20, 'l': 0.15, 'rl': 4000.0, 'wt': 6, 'mt': 6, 'mm': 0, 'cs': 6e-13} (lay.write_ref)
** sch_path: /foss/designs/ook/xschem/amp_dpc.sch
.subckt amp_dpc inp inn nb outp outn VDD VSS
*.PININFO VDD:B VSS:B nb:B inp:B inn:B outp:B outn:B
XRl_p outn VDD VSS sky130_fd_pr__res_high_po_0p69 L=7.37736 mult=1
XMp outn inp sp VSS sky130_fd_pr__nfet_01v8 L=0.15 W=20 nf=4
XMtail_p sp nb VSS VSS sky130_fd_pr__nfet_01v8 L=0.5 W=6 nf=2 m=3
XRl_n outp VDD VSS sky130_fd_pr__res_high_po_0p69 L=7.37736 mult=1
XMn outp inn sn VSS sky130_fd_pr__nfet_01v8 L=0.15 W=20 nf=4
XMtail_n sn nb VSS VSS sky130_fd_pr__nfet_01v8 L=0.5 W=6 nf=2 m=3
XCs_a sn sp sky130_fd_pr__cap_mim_m3_1 W=12.0678 L=12.0678
XCs_b sp sn sky130_fd_pr__cap_mim_m3_1 W=12.0678 L=12.0678
.ends

.subckt lna_shunt a b g VDD VSS
XRh_a sa a VSS sky130_fd_pr__res_high_po_1p41 L=0.62 mult=1
XRh_b b sb VSS sky130_fd_pr__res_high_po_1p41 L=0.62 mult=1
XMsw sb gi sa VDD sky130_fd_pr__pfet_01v8 L=0.15 W=18 nf=6
XRg g gi VSS sky130_fd_pr__res_xhigh_po_0p35 L=2.71039 mult=1
XMcap VDD gi VDD VDD sky130_fd_pr__pfet_01v8 L=5 W=5 nf=1
.ends
