mattvenn/ook-asic-radio/layout/pex/amp_dp.spice

* amp_dp: magic R+C extraction of layout/amp_dp.gds (layout/pex.sh)
.subckt amp_dp inp inn nb outp outn VDD VSS
X0 outn.t5 inp.t9 tail VSS.t86 sky130_fd_pr__nfet_01v8 ad=0.75 pd=5.3 as=0.7375 ps=5.295 w=5 l=0.15
X1 outn.t9 inp.t5 tail VSS.t90 sky130_fd_pr__nfet_01v8 ad=0.75 pd=5.3 as=0.75 ps=5.3 w=5 l=0.15
X2 tail nb.t29 VSS.t21 VSS.t20 sky130_fd_pr__nfet_01v8 ad=0.45 pd=3.3 as=0.45 ps=3.3 w=3 l=0.5
X3 VSS.t75 nb.t2 tail VSS.t74 sky130_fd_pr__nfet_01v8 ad=0.45 pd=3.3 as=0.45 ps=3.3 w=3 l=0.5
X4 tail nb.t19 VSS.t41 VSS.t40 sky130_fd_pr__nfet_01v8 ad=0.45 pd=3.3 as=0.9 ps=6.6 w=3 l=0.5
X5 tail nb.t21 VSS.t37 VSS.t36 sky130_fd_pr__nfet_01v8 ad=0.45 pd=3.3 as=0.45 ps=3.3 w=3 l=0.5
X6 VSS.t3 nb.t38 tail VSS.t2 sky130_fd_pr__nfet_01v8 ad=0.45 pd=3.3 as=0.45 ps=3.3 w=3 l=0.5
X7 VSS.t23 nb.t28 tail VSS.t22 sky130_fd_pr__nfet_01v8 ad=0.45 pd=3.3 as=0.45 ps=3.3 w=3 l=0.5
X8 VSS.t71 nb.t4 tail VSS.t70 sky130_fd_pr__nfet_01v8 ad=0.45 pd=3.3 as=0.45 ps=3.3 w=3 l=0.5
X9 tail nb.t1 VSS.t77 VSS.t76 sky130_fd_pr__nfet_01v8 ad=0.45 pd=3.3 as=0.45 ps=3.3 w=3 l=0.5
X10 tail nb.t11 VSS.t57 VSS.t56 sky130_fd_pr__nfet_01v8 ad=0.45 pd=3.3 as=0.45 ps=3.3 w=3 l=0.5
X11 VSS.t63 nb.t8 tail VSS.t62 sky130_fd_pr__nfet_01v8 ad=0.45 pd=3.3 as=0.45 ps=3.3 w=3 l=0.5
X12 outp.t13 inn.t11 tail VSS.t102 sky130_fd_pr__nfet_01v8 ad=0.75 pd=5.3 as=0.75 ps=5.3 w=5 l=0.15
X13 tail nb.t37 VSS.t5 VSS.t4 sky130_fd_pr__nfet_01v8 ad=0.45 pd=3.3 as=0.45 ps=3.3 w=3 l=0.5
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
R814 VSS.n763 VSS.n121 177.3
R815 VSS.n774 VSS.n121 177.3
R816 VSS.n774 VSS.n116 177.3
R817 VSS.n781 VSS.n116 177.3
R818 VSS.n781 VSS.n109 177.3
R819 VSS.n792 VSS.n109 177.3
R820 VSS.n792 VSS.n104 177.3
R821 VSS.n799 VSS.n104 177.3
R822 VSS.n799 VSS.n97 177.3
R823 VSS.n808 VSS.n97 177.3
R824 VSS.n808 VSS.n92 177.3
R825 VSS.n815 VSS.n92 177.3
R826 VSS.n815 VSS.n83 177.3
R827 VSS.n825 VSS.n83 177.3
R828 VSS.n825 VSS.n78 177.3
R829 VSS.n832 VSS.n78 177.3
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
