mattvenn/ook-asic-radio/layout/pex/amp_dpc.spice

* amp_dpc: magic R+C extraction of layout/amp_dpc.gds (layout/pex.sh)
.subckt amp_dpc inp inn nb outp outn VDD VSS
X0 outn.t0 inp.t1 sp VSS.t32 sky130_fd_pr__nfet_01v8 ad=0.75 pd=5.3 as=0.75 ps=5.3 w=5 l=0.15
X1 sp nb.t7 VSS.t10 VSS.t9 sky130_fd_pr__nfet_01v8 ad=0.45 pd=3.3 as=0.45 ps=3.3 w=3 l=0.5
X2 VSS.t20 nb.t2 sn VSS.t19 sky130_fd_pr__nfet_01v8 ad=0.45 pd=3.3 as=0.45 ps=3.3 w=3 l=0.5
X3 sp inp.t0 outn.t3 VSS.t33 sky130_fd_pr__nfet_01v8 ad=1.5 pd=10.6 as=0.75 ps=5.3 w=5 l=0.15
X4 VSS.t4 nb.t10 sp VSS.t3 sky130_fd_pr__nfet_01v8 ad=0.45 pd=3.3 as=0.45 ps=3.3 w=3 l=0.5
X5 sn nb.t1 VSS.t22 VSS.t21 sky130_fd_pr__nfet_01v8 ad=0.45 pd=3.3 as=0.45 ps=3.3 w=3 l=0.5
X6 sp sn sky130_fd_pr__cap_mim_m3_1 l=12.07 w=12.07
X7 sn nb.t5 VSS.t14 VSS.t13 sky130_fd_pr__nfet_01v8 ad=0.45 pd=3.3 as=0.9 ps=6.6 w=3 l=0.5
X8 sp nb.t9 VSS.t6 VSS.t5 sky130_fd_pr__nfet_01v8 ad=0.45 pd=3.3 as=0.45 ps=3.3 w=3 l=0.5
X9 VDD.t0 outp.t3 VSS.t0 sky130_fd_pr__res_high_po_0p69 l=7.38
X10 VSS.t12 nb.t6 sp VSS.t11 sky130_fd_pr__nfet_01v8 ad=0.9 pd=6.6 as=0.45 ps=3.3 w=3 l=0.5
X11 VSS.t24 nb.t0 sn VSS.t23 sky130_fd_pr__nfet_01v8 ad=0.9 pd=6.6 as=0.45 ps=3.3 w=3 l=0.5
X12 VSS.t16 nb.t4 sn VSS.t15 sky130_fd_pr__nfet_01v8 ad=0.45 pd=3.3 as=0.45 ps=3.3 w=3 l=0.5
X13 sn sp sky130_fd_pr__cap_mim_m3_1 l=12.07 w=12.07
X14 sp nb.t11 VSS.t2 VSS.t1 sky130_fd_pr__nfet_01v8 ad=0.45 pd=3.3 as=0.9 ps=6.6 w=3 l=0.5
X15 VDD.t1 outn.t4 VSS.t29 sky130_fd_pr__res_high_po_0p69 l=7.38
X16 outp.t0 inn.t3 sn VSS.t25 sky130_fd_pr__nfet_01v8 ad=0.75 pd=5.3 as=1.5 ps=10.6 w=5 l=0.15
X17 sn inn.t2 outp.t4 VSS.t26 sky130_fd_pr__nfet_01v8 ad=0.75 pd=5.3 as=0.75 ps=5.3 w=5 l=0.15
X18 sn nb.t3 VSS.t18 VSS.t17 sky130_fd_pr__nfet_01v8 ad=0.45 pd=3.3 as=0.45 ps=3.3 w=3 l=0.5
X19 VSS.t8 nb.t8 sp VSS.t7 sky130_fd_pr__nfet_01v8 ad=0.45 pd=3.3 as=0.45 ps=3.3 w=3 l=0.5
X20 outp.t2 inn.t1 sn VSS.t27 sky130_fd_pr__nfet_01v8 ad=0.75 pd=5.3 as=0.75 ps=5.3 w=5 l=0.15
X21 outn.t2 inp.t3 sp VSS.t30 sky130_fd_pr__nfet_01v8 ad=0.75 pd=5.3 as=1.5 ps=10.6 w=5 l=0.15
X22 sp inp.t2 outn.t1 VSS.t31 sky130_fd_pr__nfet_01v8 ad=0.75 pd=5.3 as=0.75 ps=5.3 w=5 l=0.15
X23 sn inn.t0 outp.t1 VSS.t28 sky130_fd_pr__nfet_01v8 ad=1.5 pd=10.6 as=0.75 ps=5.3 w=5 l=0.15
R0 outp.n2 outp.n0 20.4066
R1 outp.n2 outp.n1 20.1386
R2 outp.n3 outp.t3 11.3995
R3 outp outp.n3 7.78383
R4 outp.n1 outp.t4 3.6005
R5 outp.n1 outp.t0 3.6005
R6 outp.n0 outp.t1 3.6005
R7 outp.n0 outp.t2 3.6005
R8 outp.n3 outp.n2 1.2505
R9 inn.n0 inn.t2 1283.29
R10 inn.n2 inn.t0 1283.29
R11 inn.n0 inn.t3 1058.42
R12 inn.n1 inn.t1 1058.36
R13 inn inn.n2 12.977
R14 inn.n2 inn.n1 0.0609839
R15 inn.n1 inn.n0 0.0609839
R16 nb.n1 nb.t0 408.575
R17 nb.n11 nb.t10 408.567
R18 nb.n9 nb.t8 408.567
R19 nb.n7 nb.t6 408.567
R20 nb.n5 nb.t4 408.567
R21 nb.n3 nb.t2 408.567
R22 nb.n12 nb.t11 341.096
R23 nb.n10 nb.t9 341.087
R24 nb.n8 nb.t7 341.087
R25 nb.n6 nb.t5 341.087
R26 nb.n4 nb.t3 341.087
R27 nb.n2 nb.t1 341.087
R28 nb.n13 nb.n0 3.28141
R29 nb.n7 nb.n6 2.22362
R30 nb.n1 nb.n0 1.5005
R31 nb.n13 nb.n12 1.5005
R32 nb nb.n13 0.412462
R33 nb.n0 nb 0.345258
R34 nb.n3 nb.n2 0.108027
R35 nb.n4 nb.n3 0.108027
R36 nb.n5 nb.n4 0.108027
R37 nb.n6 nb.n5 0.108027
R38 nb.n8 nb.n7 0.108027
R39 nb.n9 nb.n8 0.108027
R40 nb.n10 nb.n9 0.108027
R41 nb.n11 nb.n10 0.108027
R42 nb.n2 nb.n1 0.0992903
R43 nb.n12 nb.n11 0.0992903
R44 outn.n2 outn.n0 20.4065
R45 outn.n2 outn.n1 20.1388
R46 outn.n3 outn.t4 11.4026
R47 outn outn.n3 10.5922
R48 outn.n0 outn.t1 3.6005
R49 outn.n0 outn.t2 3.6005
R50 outn.n1 outn.t3 3.6005
R51 outn.n1 outn.t0 3.6005
R52 outn.n3 outn.n2 1.2505
R53 VDD.n0 VDD.t0 8.00396
R54 VDD.n0 VDD.t1 8.00313
R55 VDD VDD.n0 1.28484
R56 inp.n0 inp.t0 1283.35
R57 inp.n1 inp.t2 1283.29
R58 inp.n2 inp.t3 1058.36
R59 inp.n0 inp.t1 1058.36
R60 inp inp.n2 8.78697
R61 inp.n1 inp.n0 0.0609839
R62 inp.n2 inp.n1 0.0609839
R63 VSS.n239 VSS.n238 585
R64 VSS.n238 VSS.n236 585
R65 VSS.n406 VSS.n405 585
R66 VSS.n407 VSS.n406 585
R67 VSS.n230 VSS.n229 585
R68 VSS.n237 VSS.n230 585
R69 VSS.n418 VSS.n417 585
R70 VSS.n417 VSS.n416 585
R71 VSS.n227 VSS.n226 585
R72 VSS.n415 VSS.n226 585
R73 VSS.n423 VSS.n422 585
R74 VSS.n424 VSS.n423 585
R75 VSS.n219 VSS.n218 585
R76 VSS.n225 VSS.n219 585
R77 VSS.n435 VSS.n434 585
R78 VSS.n434 VSS.n433 585
R79 VSS.n216 VSS.n215 585
R80 VSS.n432 VSS.n215 585
R81 VSS.n440 VSS.n439 585
R82 VSS.n441 VSS.n440 585
R83 VSS.n208 VSS.n207 585
R84 VSS.n214 VSS.n208 585
R85 VSS.n451 VSS.n450 585
R86 VSS.n450 VSS.n449 585
R87 VSS.n205 VSS.n204 585
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
R971 VSS.n781 VSS.n742 11.5205
R972 VSS.n751 VSS.n742 11.5205
R973 VSS.n751 VSS.n750 11.5205
R974 VSS.n750 VSS.n749 11.5205
R975 VSS.n749 VSS.n4 11.5205
R976 VSS.n834 VSS.n4 11.5205
R977 VSS.n409 VSS.n234 11.5205
R978 VSS.n409 VSS.n232 11.5205
R979 VSS.n413 VSS.n232 11.5205
R980 VSS.n413 VSS.n223 11.5205
R981 VSS.n426 VSS.n223 11.5205
R982 VSS.n426 VSS.n221 11.5205
R983 VSS.n430 VSS.n221 11.5205
R984 VSS.n430 VSS.n212 11.5205
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
