mattvenn/ook-asic-radio/layout/pex/comp_ct.spice

* comp_ct: magic R+C extraction of layout/comp_ct.gds (layout/pex.sh)
.subckt comp_ct inp inn trim ibias out VDD VSS
X0 a_12386_n3066# a_12186_n5170# VSS.t71 sky130_fd_pr__res_xhigh_po_0p35 l=8.5
X1 a_11186_n3066# a_11386_n5170# VSS.t47 sky130_fd_pr__res_xhigh_po_0p35 l=8.5
X2 rdeg25 rdeg26 VSS.t0 sky130_fd_pr__res_xhigh_po_0p35 l=3.85
X3 rdeg1 rdeg2 VSS.t11 sky130_fd_pr__res_xhigh_po_0p35 l=3.85
X4 d1 inp.t3 tail VSS.t118 sky130_fd_pr__nfet_01v8_lvt ad=0.75 pd=5.3 as=1.5 ps=10.6 w=5 l=1
X5 a_10386_n3066# a_10186_n5170# VSS.t62 sky130_fd_pr__res_xhigh_po_0p35 l=8.5
X6 rdeg21 rdeg20 VSS.t46 sky130_fd_pr__res_xhigh_po_0p35 l=3.85
X7 a_9186_n3066# a_8986_n5170# VSS.t37 sky130_fd_pr__res_xhigh_po_0p35 l=8.5
X8 rdeg15 rdeg16 VSS.t21 sky130_fd_pr__res_xhigh_po_0p35 l=3.85
X9 a_7986_n3066# vref VSS.t34 sky130_fd_pr__res_xhigh_po_0p35 l=8.5
X10 tail ibias.t11 VSS.t99 VSS.t98 sky130_fd_pr__nfet_01v8 ad=0.6825 pd=4.85 as=1.365 ps=9.7 w=4.55 l=2
X11 d2 inn.t3 tail VSS.t67 sky130_fd_pr__nfet_01v8_lvt ad=0.75 pd=5.3 as=1.5 ps=10.6 w=5 l=1
X12 rdeg11 rdeg10 VSS.t18 sky130_fd_pr__res_xhigh_po_0p35 l=3.85
X13 a_7186_n3066# a_6986_n5170# VSS.t1 sky130_fd_pr__res_xhigh_po_0p35 l=8.5
X14 VDD.t20 VDD.t17 VDD.t19 VDD.t18 sky130_fd_pr__pfet_01v8_lvt ad=1.2 pd=8.6 as=0 ps=0 w=4 l=1
X15 rdeg5 rdeg6 VSS.t15 sky130_fd_pr__res_xhigh_po_0p35 l=3.85
X16 d1 inp.t1 tail VSS.t120 sky130_fd_pr__nfet_01v8_lvt ad=0.75 pd=5.3 as=1.5 ps=10.6 w=5 l=1
X17 sb ibias.t5 VSS.t111 VSS.t110 sky130_fd_pr__nfet_01v8 ad=0.3 pd=2.3 as=0.6 ps=4.6 w=2 l=2
X18 VSS.t101 ibias.t10 tail VSS.t100 sky130_fd_pr__nfet_01v8 ad=0.6825 pd=4.85 as=0.6825 ps=4.85 w=4.55 l=2
X19 rdeg29 sb VSS.t3 sky130_fd_pr__res_xhigh_po_0p35 l=3.85
X20 a_11986_n3066# a_12186_n5170# VSS.t93 sky130_fd_pr__res_xhigh_po_0p35 l=8.5
X21 a_11186_n3066# a_10986_n5170# VSS.t41 sky130_fd_pr__res_xhigh_po_0p35 l=8.5
X22 rdeg25 rdeg24 VSS.t53 sky130_fd_pr__res_xhigh_po_0p35 l=3.85
X23 rdeg1 sa VSS.t12 sky130_fd_pr__res_xhigh_po_0p35 l=3.85
X24 d2 inn.t1 tail VSS.t69 sky130_fd_pr__nfet_01v8_lvt ad=0.75 pd=5.3 as=1.5 ps=10.6 w=5 l=1
X25 a_9986_n3066# a_10186_n5170# VSS.t38 sky130_fd_pr__res_xhigh_po_0p35 l=8.5
X26 rdeg19 rdeg20 VSS.t24 sky130_fd_pr__res_xhigh_po_0p35 l=3.85
X27 rdeg15 rdeg14 VSS.t22 sky130_fd_pr__res_xhigh_po_0p35 l=3.85
X28 VSS.t80 VSS.t77 VSS.t79 VSS.t78 sky130_fd_pr__nfet_01v8_lvt ad=1.5 pd=10.6 as=0 ps=0 w=5 l=1
X29 VSS.t105 ibias.t8 tail VSS.t104 sky130_fd_pr__nfet_01v8 ad=1.365 pd=9.7 as=0.6825 ps=4.85 w=4.55 l=2
X30 d1 vref sa VSS.t49 sky130_fd_pr__nfet_01v8_lvt ad=1.2 pd=8.6 as=1.2 ps=8.6 w=4 l=1
X31 rdeg9 rdeg10 VSS.t19 sky130_fd_pr__res_xhigh_po_0p35 l=3.85
X32 d2 trim.t1 sb VSS.t65 sky130_fd_pr__nfet_01v8_lvt ad=1.2 pd=8.6 as=1.2 ps=8.6 w=4 l=1
X33 rdeg5 rdeg4 VSS.t16 sky130_fd_pr__res_xhigh_po_0p35 l=3.85
X34 VSS.t84 VSS.t81 VSS.t83 VSS.t82 sky130_fd_pr__nfet_01v8_lvt ad=1.2 pd=8.6 as=0 ps=0 w=4 l=1
X35 out.t0 o2 VDD.t1 VDD.t0 sky130_fd_pr__pfet_01v8 ad=0.6 pd=4.6 as=0.6 ps=4.6 w=2 l=0.15
X36 a_9986_n3066# a_9786_n5170# VSS.t39 sky130_fd_pr__res_xhigh_po_0p35 l=8.5
X37 a_8786_n3066# a_8986_n5170# VSS.t35 sky130_fd_pr__res_xhigh_po_0p35 l=8.5
X38 a_7986_n3066# a_7786_n5170# VSS.t58 sky130_fd_pr__res_xhigh_po_0p35 l=8.5
X39 o2 d2 VDD.t3 VDD.t2 sky130_fd_pr__pfet_01v8_lvt ad=1.2 pd=8.6 as=1.2 ps=8.6 w=4 l=1
X40 VDD.t16 VDD.t13 VDD.t15 VDD.t14 sky130_fd_pr__pfet_01v8_lvt ad=1.2 pd=8.6 as=0 ps=0 w=4 l=1
X41 a_6786_n3066# a_6986_n5170# VSS.t29 sky130_fd_pr__res_xhigh_po_0p35 l=8.5
X42 d1 d1 VDD.t11 VDD.t10 sky130_fd_pr__pfet_01v8_lvt ad=1.2 pd=8.6 as=1.2 ps=8.6 w=4 l=2
X43 a_12786_n3066# VSS.t95 VSS.t94 sky130_fd_pr__res_xhigh_po_0p35 l=8.5
X44 a_11986_n3066# a_11786_n5170# VSS.t57 sky130_fd_pr__res_xhigh_po_0p35 l=8.5
X45 rdeg29 rdeg28 VSS.t2 sky130_fd_pr__res_xhigh_po_0p35 l=3.85
X46 VSS.t76 VSS.t73 VSS.t75 VSS.t74 sky130_fd_pr__nfet_01v8_lvt ad=1.5 pd=10.6 as=0 ps=0 w=5 l=1
X47 a_10786_n3066# a_10986_n5170# VSS.t42 sky130_fd_pr__res_xhigh_po_0p35 l=8.5
X48 rdeg23 rdeg24 VSS.t26 sky130_fd_pr__res_xhigh_po_0p35 l=3.85
X49 a_9586_n3066# a_9786_n5170# VSS.t59 sky130_fd_pr__res_xhigh_po_0p35 l=8.5
X50 rdeg19 rdeg18 VSS.t25 sky130_fd_pr__res_xhigh_po_0p35 l=3.85
X51 vref VSS.t50 sky130_fd_pr__cap_mim_m3_1 l=10 w=10
X52 a_8786_n3066# a_8586_n5170# VSS.t31 sky130_fd_pr__res_xhigh_po_0p35 l=8.5
X53 d2 d1 VDD.t9 VDD.t8 sky130_fd_pr__pfet_01v8_lvt ad=1.2 pd=8.6 as=1.2 ps=8.6 w=4 l=2
X54 rdeg13 rdeg14 VSS.t23 sky130_fd_pr__res_xhigh_po_0p35 l=3.85
X55 VSS.t113 ibias.t4 sb VSS.t112 sky130_fd_pr__nfet_01v8 ad=0.6 pd=4.6 as=0.3 ps=2.3 w=2 l=2
X56 a_7586_n3066# a_7786_n5170# VSS.t56 sky130_fd_pr__res_xhigh_po_0p35 l=8.5
X57 VSS.t92 VSS.t89 VSS.t91 VSS.t90 sky130_fd_pr__nfet_01v8 ad=0.6 pd=4.6 as=0 ps=0 w=2 l=2
X58 rdeg9 rdeg8 VSS.t20 sky130_fd_pr__res_xhigh_po_0p35 l=3.85
X59 a_6786_n3066# VDD.t12 VSS.t54 sky130_fd_pr__res_xhigh_po_0p35 l=8.5
X60 tail inn.t0 d2 VSS.t70 sky130_fd_pr__nfet_01v8_lvt ad=1.5 pd=10.6 as=0.75 ps=5.3 w=5 l=1
X61 VDD.t24 VDD.t21 VDD.t23 VDD.t22 sky130_fd_pr__pfet_01v8_lvt ad=1.2 pd=8.6 as=0 ps=0 w=4 l=1
X62 a_12786_n3066# a_12586_n5170# VSS.t64 sky130_fd_pr__res_xhigh_po_0p35 l=8.5
X63 rdeg27 rdeg28 VSS.t28 sky130_fd_pr__res_xhigh_po_0p35 l=3.85
X64 tail ibias.t9 VSS.t103 VSS.t102 sky130_fd_pr__nfet_01v8 ad=0.6825 pd=4.85 as=0.6825 ps=4.85 w=4.55 l=2
X65 a_11586_n3066# a_11786_n5170# VSS.t63 sky130_fd_pr__res_xhigh_po_0p35 l=8.5
X66 rdeg3 rdeg4 VSS.t9 sky130_fd_pr__res_xhigh_po_0p35 l=3.85
X67 rdeg23 rdeg22 VSS.t27 sky130_fd_pr__res_xhigh_po_0p35 l=3.85
X68 a_10786_n3066# a_10586_n5170# VSS.t43 sky130_fd_pr__res_xhigh_po_0p35 l=8.5
X69 a_9586_n3066# a_9386_n5170# VSS.t30 sky130_fd_pr__res_xhigh_po_0p35 l=8.5
X70 rdeg17 rdeg18 VSS.t44 sky130_fd_pr__res_xhigh_po_0p35 l=3.85
X71 o2 ibias.t3 VSS.t115 VSS.t114 sky130_fd_pr__nfet_01v8 ad=0.6825 pd=4.85 as=1.365 ps=9.7 w=4.55 l=2
X72 a_8386_n3066# a_8586_n5170# VSS.t32 sky130_fd_pr__res_xhigh_po_0p35 l=8.5
X73 sa ibias.t7 VSS.t107 VSS.t106 sky130_fd_pr__nfet_01v8 ad=0.3 pd=2.3 as=0.6 ps=4.6 w=2 l=2
X74 tail inp.t0 d1 VSS.t121 sky130_fd_pr__nfet_01v8_lvt ad=1.5 pd=10.6 as=0.75 ps=5.3 w=5 l=1
X75 rdeg13 rdeg12 VSS.t4 sky130_fd_pr__res_xhigh_po_0p35 l=3.85
X76 tail inp.t2 d1 VSS.t119 sky130_fd_pr__nfet_01v8_lvt ad=1.5 pd=10.6 as=0.75 ps=5.3 w=5 l=1
X77 a_7586_n3066# a_7386_n5170# VSS.t55 sky130_fd_pr__res_xhigh_po_0p35 l=8.5
X78 rdeg7 rdeg8 VSS.t13 sky130_fd_pr__res_xhigh_po_0p35 l=3.85
X79 VSS.t109 ibias.t6 sa VSS.t108 sky130_fd_pr__nfet_01v8 ad=0.6 pd=4.6 as=0.3 ps=2.3 w=2 l=2
X80 tail inn.t2 d2 VSS.t68 sky130_fd_pr__nfet_01v8_lvt ad=1.5 pd=10.6 as=0.75 ps=5.3 w=5 l=1
X81 VSS.t88 VSS.t85 VSS.t87 VSS.t86 sky130_fd_pr__nfet_01v8_lvt ad=1.2 pd=8.6 as=0 ps=0 w=4 l=1
X82 a_12386_n3066# a_12586_n5170# VSS.t72 sky130_fd_pr__res_xhigh_po_0p35 l=8.5
X83 d2 trim.t0 sb VSS.t66 sky130_fd_pr__nfet_01v8_lvt ad=1.2 pd=8.6 as=1.2 ps=8.6 w=4 l=1
X84 a_11586_n3066# a_11386_n5170# VSS.t60 sky130_fd_pr__res_xhigh_po_0p35 l=8.5
X85 rdeg27 rdeg26 VSS.t52 sky130_fd_pr__res_xhigh_po_0p35 l=3.85
X86 rdeg3 rdeg2 VSS.t10 sky130_fd_pr__res_xhigh_po_0p35 l=3.85
X87 out.t1 o2 VSS.t6 VSS.t5 sky130_fd_pr__nfet_01v8 ad=0.3 pd=2.6 as=0.3 ps=2.6 w=1 l=0.15
X88 d1 vref sa VSS.t48 sky130_fd_pr__nfet_01v8_lvt ad=1.2 pd=8.6 as=1.2 ps=8.6 w=4 l=1
X89 a_10386_n3066# a_10586_n5170# VSS.t40 sky130_fd_pr__res_xhigh_po_0p35 l=8.5
X90 rdeg21 rdeg22 VSS.t51 sky130_fd_pr__res_xhigh_po_0p35 l=3.85
X91 a_9186_n3066# a_9386_n5170# VSS.t36 sky130_fd_pr__res_xhigh_po_0p35 l=8.5
X92 rdeg17 rdeg16 VSS.t45 sky130_fd_pr__res_xhigh_po_0p35 l=3.85
X93 VSS.t117 ibias.t2 o2 VSS.t116 sky130_fd_pr__nfet_01v8 ad=1.365 pd=9.7 as=0.6825 ps=4.85 w=4.55 l=2
X94 d2 d1 VDD.t5 VDD.t4 sky130_fd_pr__pfet_01v8_lvt ad=1.2 pd=8.6 as=1.2 ps=8.6 w=4 l=2
X95 d1 d1 VDD.t7 VDD.t6 sky130_fd_pr__pfet_01v8_lvt ad=1.2 pd=8.6 as=1.2 ps=8.6 w=4 l=2
X96 a_8386_n3066# vref VSS.t33 sky130_fd_pr__res_xhigh_po_0p35 l=8.5
X97 d2 VSS.t7 sky130_fd_pr__cap_mim_m3_1 l=11 w=22
X98 rdeg11 rdeg12 VSS.t17 sky130_fd_pr__res_xhigh_po_0p35 l=3.85
X99 ibias.t1 ibias.t0 VSS.t97 VSS.t96 sky130_fd_pr__nfet_01v8 ad=0.6 pd=4.6 as=0.6 ps=4.6 w=2 l=2
X100 a_7186_n3066# a_7386_n5170# VSS.t61 sky130_fd_pr__res_xhigh_po_0p35 l=8.5
X101 d2 VSS.t8 sky130_fd_pr__cap_mim_m3_1 l=11 w=22
X102 rdeg7 rdeg6 VSS.t14 sky130_fd_pr__res_xhigh_po_0p35 l=3.85
R0 trim.n0 trim.t1 166.048
R1 trim.n0 trim.t0 165.815
R2 trim trim.n0 1.91105
R3 ibias.n24 ibias.n23 152
R4 ibias.n31 ibias.n30 152
R5 ibias.n17 ibias.n16 152
R6 ibias.n43 ibias.n42 152
R7 ibias.n55 ibias.n54 152
R8 ibias.n67 ibias.n66 152
R9 ibias.n31 ibias.n3 109.918
R10 ibias.n32 ibias.n31 109.918
R11 ibias.n17 ibias.n11 109.918
R12 ibias.n18 ibias.n17 109.918
R13 ibias.n43 ibias.n37 109.918
R14 ibias.n44 ibias.n43 109.918
R15 ibias.n55 ibias.n49 109.918
R16 ibias.n56 ibias.n55 109.918
R17 ibias.n67 ibias.n61 109.918
R18 ibias.n68 ibias.n67 109.918
R19 ibias.n13 ibias.t8 92.6225
R20 ibias.n63 ibias.t2 92.6225
R21 ibias.n24 ibias.n7 87.2466
R22 ibias.n25 ibias.n24 87.2466
R23 ibias.n0 ibias.t0 77.8556
R24 ibias.n39 ibias.t6 61.895
R25 ibias.n51 ibias.t4 61.895
R26 ibias.n0 ibias.t1 57.7449
R27 ibias.n24 ibias.t10 54.828
R28 ibias.n31 ibias.t11 54.828
R29 ibias.n17 ibias.t9 54.828
R30 ibias.n67 ibias.t3 54.828
R31 ibias.n23 ibias.n8 27.1064
R32 ibias.n23 ibias.n6 27.1064
R33 ibias.n30 ibias.n4 27.1064
R34 ibias.n30 ibias.n2 27.1064
R35 ibias.n16 ibias.n12 27.1064
R36 ibias.n16 ibias.n10 27.1064
R37 ibias.n42 ibias.n38 27.1064
R38 ibias.n42 ibias.n36 27.1064
R39 ibias.n54 ibias.n50 27.1064
R40 ibias.n54 ibias.n48 27.1064
R41 ibias.n66 ibias.n62 27.1064
R42 ibias.n66 ibias.n60 27.1064
R43 ibias.n43 ibias.t7 24.1005
R44 ibias.n55 ibias.t5 24.1005
R45 ibias.n33 ibias.n32 23.0645
R46 ibias.n45 ibias.n44 23.0645
R47 ibias.n57 ibias.n56 23.0645
R48 ibias.n69 ibias.n68 23.0645
R49 ibias.n27 ibias.n3 23.0638
R50 ibias.n13 ibias.n11 23.0638
R51 ibias.n19 ibias.n18 23.0638
R52 ibias.n39 ibias.n37 23.0638
R53 ibias.n51 ibias.n49 23.0638
R54 ibias.n63 ibias.n61 23.0638
R55 ibias.n20 ibias.n7 22.3436
R56 ibias.n26 ibias.n25 22.3436
R57 ibias.n8 ibias.n7 11.9359
R58 ibias.n25 ibias.n6 11.9359
R59 ibias.n32 ibias.n2 11.3247
R60 ibias.n4 ibias.n3 11.3247
R61 ibias.n18 ibias.n10 11.3247
R62 ibias.n12 ibias.n11 11.3247
R63 ibias.n44 ibias.n36 11.3247
R64 ibias.n38 ibias.n37 11.3247
R65 ibias.n56 ibias.n48 11.3247
R66 ibias.n50 ibias.n49 11.3247
R67 ibias.n68 ibias.n60 11.3247
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
R754 VDD.n314 VDD.n313 185
R755 VDD.n313 VDD.n312 185
R756 VDD.n1060 VDD.n1059 185
R757 VDD.n1059 VDD.n1058 185
R758 VDD.n317 VDD.n316 185
R759 VDD.n1057 VDD.n317 185
R760 VDD.n1040 VDD.n319 185
R761 VDD.n1056 VDD.n319 185
R762 VDD.n329 VDD.n327 185
R763 VDD.n327 VDD.n318 185
R764 VDD.n1045 VDD.n1044 185
R765 VDD.n1046 VDD.n1045 185
R766 VDD.n328 VDD.n326 185
R767 VDD.n1047 VDD.n326 185
R768 VDD.n1037 VDD.n1036 185
R769 VDD.n1036 VDD.n325 185
R770 VDD.n1035 VDD.n331 185
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
