mattvenn/ook-asic-radio/layout/ref/comp_ct.spice

* comp_ct: xschem/comp_ct.sch with {'w1': 20, 'l1': 1, 'mt1': 10, 'rdeg': 850000.0, 'mta': 2, 'lref1': 68, 'lref2': 204, 'wcl': 22} (lay.write_ref)
** sch_path: /foss/designs/ook-asic-radio/xschem/comp_ct.sch
.subckt comp_ct inp inn trim ibias out VDD VSS
*.PININFO VDD:B VSS:B ibias:B inp:B inn:B trim:B out:B
XMb ibias ibias VSS VSS sky130_fd_pr__nfet_01v8 L=2 W=2 nf=1
XMt1 tail ibias VSS VSS sky130_fd_pr__nfet_01v8 L=2 W=4.55 nf=1 m=4
XM1 d1 inp tail VSS sky130_fd_pr__nfet_01v8_lvt L=1 W=20 nf=4
XM2 d2 inn tail VSS sky130_fd_pr__nfet_01v8_lvt L=1 W=20 nf=4
XMp1 d1 d1 VDD VDD sky130_fd_pr__pfet_01v8_lvt L=2 W=8 nf=1
XMp2 d2 d1 VDD VDD sky130_fd_pr__pfet_01v8_lvt L=2 W=8 nf=1
XM3 d1 vref sa VSS sky130_fd_pr__nfet_01v8_lvt L=1 W=8 nf=1
XMta_sa sa ibias VSS VSS sky130_fd_pr__nfet_01v8 L=2 W=2 nf=1 m=2
XM4 d2 trim sb VSS sky130_fd_pr__nfet_01v8_lvt L=1 W=8 nf=1
XMta_sb sb ibias VSS VSS sky130_fd_pr__nfet_01v8 L=2 W=2 nf=1 m=2
XRdeg sa sb VSS sky130_fd_pr__res_xhigh_po_0p35 L=115.332 mult=1
XRr1 vref VDD VSS sky130_fd_pr__res_xhigh_po_0p35 L=68 mult=1
XRr2 VSS vref VSS sky130_fd_pr__res_xhigh_po_0p35 L=204 mult=1
XCref vref VSS sky130_fd_pr__cap_mim_m3_1 W=10 L=10
XCl d2 VSS sky130_fd_pr__cap_mim_m3_1 W=22 L=11 m=2
XMp3 o2 d2 VDD VDD sky130_fd_pr__pfet_01v8_lvt L=1 W=4 nf=1
XMn3 o2 ibias VSS VSS sky130_fd_pr__nfet_01v8 L=2 W=4.55 nf=1 m=2
XMip out o2 VDD VDD sky130_fd_pr__pfet_01v8 L=0.15 W=2 nf=1
XMin out o2 VSS VSS sky130_fd_pr__nfet_01v8 L=0.15 W=1 nf=1
XMdn1 VSS VSS VSS VSS sky130_fd_pr__nfet_01v8_lvt L=1 W=5 nf=1 m=2
XMdn2 VSS VSS VSS VSS sky130_fd_pr__nfet_01v8_lvt L=1 W=4 nf=1 m=2
XMdn3 VSS VSS VSS VSS sky130_fd_pr__nfet_01v8 L=2 W=2 nf=1
XMdp1 VDD VDD VDD VDD sky130_fd_pr__pfet_01v8_lvt L=1 W=4 nf=1 m=2
XMdp2 VDD VDD VDD VDD sky130_fd_pr__pfet_01v8_lvt L=1 W=4 nf=1
.ends
