mattvenn/ook-asic-radio/layout/pex/det_cell.spice

* det_cell: magic R+C extraction of layout/det_cell.gds (layout/pex.sh)
.subckt det_cell inp inn vb out VSS
X0 a_337_2520# vb.t0 VSS.t1 sky130_fd_pr__res_xhigh_po_0p35 l=6.78
X1 a_737_2520# a_537_760# VSS.t2 sky130_fd_pr__res_xhigh_po_0p35 l=6.78
X2 a_3159_2520# a_3359_760# VSS.t14 sky130_fd_pr__res_xhigh_po_0p35 l=6.78
X3 out.t0 gp sp VSS.t6 sky130_fd_pr__nfet_01v8 ad=0.3 pd=2.6 as=0.3 ps=2.6 w=1 l=0.15
X4 a_2525_2072# VSS.t11 VSS.t10 sky130_fd_pr__res_high_po_0p35 l=4.54
X5 a_3559_2520# vb.t1 VSS.t15 sky130_fd_pr__res_xhigh_po_0p35 l=6.78
X6 a_1371_2072# sp VSS.t3 sky130_fd_pr__res_high_po_0p35 l=4.54
X7 sn gn out.t1 VSS.t7 sky130_fd_pr__nfet_01v8 ad=0.3 pd=2.6 as=0.3 ps=2.6 w=1 l=0.15
X8 gn inn.t0 sky130_fd_pr__cap_mim_m3_1 l=6.965 w=6.965
X9 a_337_2520# a_537_760# VSS.t0 sky130_fd_pr__res_xhigh_po_0p35 l=6.78
X10 a_737_2520# gp VSS.t8 sky130_fd_pr__res_xhigh_po_0p35 l=6.78
X11 a_2525_2072# sn VSS.t9 sky130_fd_pr__res_high_po_0p35 l=4.54
X12 a_3159_2520# gn VSS.t12 sky130_fd_pr__res_xhigh_po_0p35 l=6.78
X13 a_3559_2520# a_3359_760# VSS.t13 sky130_fd_pr__res_xhigh_po_0p35 l=6.78
X14 a_1371_2072# VSS.t5 VSS.t4 sky130_fd_pr__res_high_po_0p35 l=4.54
X15 gp inp.t0 sky130_fd_pr__cap_mim_m3_1 l=6.965 w=6.965
R0 inn inn.t0 0.023984
R1 inp inp.t0 0.023984
R2 out.n1 out.t0 138.561
R3 out.n0 out.t1 138.561
R4 out out.n1 3.09894
R5 out.n0 out 2.94269
R6 out.n1 out.n0 0.313
R7 vb.n24 vb.n19 50.6672
R8 vb.n7 vb.n2 50.6672
R9 vb.n31 vb.n18 17.8167
R10 vb.n14 vb.n1 17.8167
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
R996 VSS.n640 VSS.n639 9.3005
R997 VSS.n641 VSS.n580 9.3005
R998 VSS.n643 VSS.n642 9.3005
R999 VSS.n644 VSS.n579 9.3005
R1000 VSS.n646 VSS.n645 9.3005
R1001 VSS.n647 VSS.n574 9.3005
R1002 VSS.n649 VSS.n648 9.3005
R1003 VSS.n650 VSS.n573 9.3005
R1004 VSS.n652 VSS.n651 9.3005
R1005 VSS.n653 VSS.n568 9.3005
R1006 VSS.n655 VSS.n654 9.3005
R1007 VSS.n656 VSS.n567 9.3005
R1008 VSS.n658 VSS.n657 9.3005
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
