mattvenn/ook-asic-radio/layout/pex/log_det.spice

* log_det: magic R+C extraction of layout/log_det.gds (layout/pex.sh)
.subckt log_det t1p t1n t2p t2n t3p t3n t4p t4n t5p t5n t6p t6n ibias_det det VDD VSS
X0 a_3359_2025# a_3159_265# VSS.t4 sky130_fd_pr__res_xhigh_po_0p35 l=6.78
X1 a_9069_5501# a_8869_3741# VSS.t33 sky130_fd_pr__res_xhigh_po_0p35 l=6.78
X2 a_8869_2025# a_8669_265# VSS.t34 sky130_fd_pr__res_xhigh_po_0p35 l=6.78
X3 det_cell_4.gn t4n.t0 sky130_fd_pr__cap_mim_m3_1 l=6.965 w=6.965
X4 a_5537_5053# det_cell_3.sp VSS.t22 sky130_fd_pr__res_high_po_0p35 l=4.54
X5 a_11691_2025# a_11891_265# VSS.t43 sky130_fd_pr__res_xhigh_po_0p35 l=6.78
X6 det_cell_2.gn a_7325_265# VSS.t29 sky130_fd_pr__res_xhigh_po_0p35 l=6.78
X7 a_4503_5501# a_4703_3741# VSS.t45 sky130_fd_pr__res_xhigh_po_0p35 l=6.78
X8 det_cell_1.gn t3n.t0 sky130_fd_pr__cap_mim_m3_1 l=6.965 w=6.965
X9 VSS.t56 a_10857_713# VSS.t40 sky130_fd_pr__res_high_po_0p35 l=4.54
X10 a_9703_5053# det_cell_1.sp VSS.t37 sky130_fd_pr__res_high_po_0p35 l=4.54
X11 a_3159_5501# a_3359_3741# VSS.t4 sky130_fd_pr__res_xhigh_po_0p35 l=6.78
X12 a_2525_5053# VSS.t17 VSS.t16 sky130_fd_pr__res_high_po_0p35 l=4.54
X13 det_cell_4.gp t4p.t0 sky130_fd_pr__cap_mim_m3_1 l=6.965 w=6.965
X14 a_3559_5501# ibias_det.t2 VSS.t18 sky130_fd_pr__res_xhigh_po_0p35 l=6.78
X15 a_4703_2025# a_4903_265# VSS.t20 sky130_fd_pr__res_xhigh_po_0p35 l=6.78
X16 a_8669_5501# a_8869_3741# VSS.t34 sky130_fd_pr__res_xhigh_po_0p35 l=6.78
X17 a_8869_2025# a_9069_265# VSS.t33 sky130_fd_pr__res_xhigh_po_0p35 l=6.78
X18 VSS.t52 a_6691_713# VSS.t24 sky130_fd_pr__res_high_po_0p35 l=4.54
X19 a_13240_1578# VSS.t60 VSS.t59 sky130_fd_pr__res_high_po_0p35 l=4.54
X20 a_7325_5501# a_7525_3741# VSS.t28 sky130_fd_pr__res_xhigh_po_0p35 l=6.78
X21 ibias_det.t6 a_11891_265# VSS.t42 sky130_fd_pr__res_xhigh_po_0p35 l=6.78
X22 a_7725_5501# ibias_det.t3 VSS.t26 sky130_fd_pr__res_xhigh_po_0p35 l=6.78
X23 a_1371_5053# det_cell_5.sp VSS.t13 sky130_fd_pr__res_high_po_0p35 l=4.54
X24 VSS.t2 a_5537_713# VSS.t1 sky130_fd_pr__res_high_po_0p35 l=4.54
X25 det_cell_3.gn t2n.t0 sky130_fd_pr__cap_mim_m3_1 l=6.965 w=6.965
X26 det_cell_0.gn a_11491_265# VSS.t6 sky130_fd_pr__res_xhigh_po_0p35 l=6.78
X27 det_cell_1.gp t3p.t0 sky130_fd_pr__cap_mim_m3_1 l=6.965 w=6.965
X28 det_cell_0.sn a_10857_713# VSS.t36 sky130_fd_pr__res_high_po_0p35 l=4.54
X29 det_cell_0.sn det_cell_0.gn det.t8 VSS.t35 sky130_fd_pr__nfet_01v8 ad=0.3 pd=2.6 as=0.3 ps=2.6 w=1 l=0.15
X30 ibias_det.t8 a_7725_265# VSS.t26 sky130_fd_pr__res_xhigh_po_0p35 l=6.78
X31 det_cell_2.gp a_4903_265# VSS.t49 sky130_fd_pr__res_xhigh_po_0p35 l=6.78
X32 VSS.t54 a_9703_713# VSS.t38 sky130_fd_pr__res_high_po_0p35 l=4.54
X33 det_cell_1.sn det_cell_1.gn det.t4 VSS.t35 sky130_fd_pr__nfet_01v8 ad=0.3 pd=2.6 as=0.3 ps=2.6 w=1 l=0.15
X34 det_cell_4.sn a_2525_713# VSS.t21 sky130_fd_pr__res_high_po_0p35 l=4.54
X35 det_cell_4.sn det_cell_4.gn det.t6 VSS.t12 sky130_fd_pr__nfet_01v8 ad=0.3 pd=2.6 as=0.3 ps=2.6 w=1 l=0.15
X36 a_11491_5501# a_11691_3741# VSS.t44 sky130_fd_pr__res_xhigh_po_0p35 l=6.78
X37 a_13860_1728# a_14160_266# VSS.t55 sky130_fd_pr__res_high_po_0p69 l=5.29
X38 a_537_2025# a_737_265# VSS.t10 sky130_fd_pr__res_xhigh_po_0p35 l=6.78
X39 det_cell_5.gn t1n.t0 sky130_fd_pr__cap_mim_m3_1 l=6.965 w=6.965
X40 ibias_det.t0 a_4503_265# VSS.t3 sky130_fd_pr__res_xhigh_po_0p35 l=6.78
X41 det_cell_5.sn det_cell_5.gn det.t2 VSS.t12 sky130_fd_pr__nfet_01v8 ad=0.3 pd=2.6 as=0.3 ps=2.6 w=1 l=0.15
X42 a_337_5501# a_537_3741# VSS.t11 sky130_fd_pr__res_xhigh_po_0p35 l=6.78
X43 a_3359_2025# a_3559_265# VSS.t19 sky130_fd_pr__res_xhigh_po_0p35 l=6.78
X44 det_cell_2.sn det_cell_2.gn det.t11 VSS.t0 sky130_fd_pr__nfet_01v8 ad=0.3 pd=2.6 as=0.3 ps=2.6 w=1 l=0.15
X45 a_737_5501# det_cell_5.gp VSS.t9 sky130_fd_pr__res_xhigh_po_0p35 l=6.78
X46 det.t5 det_cell_4.gp det_cell_4.sp VSS.t8 sky130_fd_pr__nfet_01v8 ad=0.3 pd=2.6 as=0.3 ps=2.6 w=1 l=0.15
X47 a_10857_5053# VSS.t41 VSS.t40 sky130_fd_pr__res_high_po_0p35 l=4.54
X48 VSS.t46 a_1371_713# VSS.t14 sky130_fd_pr__res_high_po_0p35 l=4.54
X49 det_cell_3.sn det_cell_3.gn det.t0 VSS.t0 sky130_fd_pr__nfet_01v8 ad=0.3 pd=2.6 as=0.3 ps=2.6 w=1 l=0.15
X50 VDD.t1 a_14160_266# VSS.t53 sky130_fd_pr__res_high_po_0p69 l=5.29
X51 a_6691_5053# VSS.t25 VSS.t24 sky130_fd_pr__res_high_po_0p35 l=4.54
X52 a_4903_5501# det_cell_3.gp VSS.t49 sky130_fd_pr__res_xhigh_po_0p35 l=6.78
X53 det.t1 det_cell_5.gp det_cell_5.sp VSS.t8 sky130_fd_pr__nfet_01v8 ad=0.3 pd=2.6 as=0.3 ps=2.6 w=1 l=0.15
X54 a_7525_2025# a_7325_265# VSS.t28 sky130_fd_pr__res_xhigh_po_0p35 l=6.78
X55 a_13860_1728# det.t12 VSS.t57 sky130_fd_pr__res_high_po_0p69 l=5.29
X56 a_9069_5501# det_cell_1.gp VSS.t32 sky130_fd_pr__res_xhigh_po_0p35 l=6.78
X57 ibias_det.t10 a_337_265# VSS.t7 sky130_fd_pr__res_xhigh_po_0p35 l=6.78
X58 a_5537_5053# VSS.t23 VSS.t1 sky130_fd_pr__res_high_po_0p35 l=4.54
X59 det_cell_0.gp a_9069_265# VSS.t32 sky130_fd_pr__res_xhigh_po_0p35 l=6.78
X60 a_10857_5053# det_cell_1.sn VSS.t36 sky130_fd_pr__res_high_po_0p35 l=4.54
X61 a_4503_5501# ibias_det.t9 VSS.t3 sky130_fd_pr__res_xhigh_po_0p35 l=6.78
X62 det_cell_2.gp t5p.t0 sky130_fd_pr__cap_mim_m3_1 l=6.965 w=6.965
X63 det_cell_4.gn a_3159_265# VSS.t47 sky130_fd_pr__res_xhigh_po_0p35 l=6.78
X64 a_4903_5501# a_4703_3741# VSS.t20 sky130_fd_pr__res_xhigh_po_0p35 l=6.78
X65 a_9703_5053# VSS.t39 VSS.t38 sky130_fd_pr__res_high_po_0p35 l=4.54
X66 a_3159_5501# det_cell_5.gn VSS.t47 sky130_fd_pr__res_xhigh_po_0p35 l=6.78
X67 det_cell_3.gp t2p.t0 sky130_fd_pr__cap_mim_m3_1 l=6.965 w=6.965
X68 ibias_det.t11 a_8669_265# VSS.t30 sky130_fd_pr__res_xhigh_po_0p35 l=6.78
X69 a_2525_5053# det_cell_5.sn VSS.t21 sky130_fd_pr__res_high_po_0p35 l=4.54
X70 a_12848_266# ibias_det.t12 ibias_det.t13 VSS.t58 sky130_fd_pr__nfet_01v8 ad=0.3 pd=2.6 as=0.3 ps=2.6 w=1 l=0.15
X71 a_8669_5501# ibias_det.t4 VSS.t30 sky130_fd_pr__res_xhigh_po_0p35 l=6.78
X72 a_3559_5501# a_3359_3741# VSS.t19 sky130_fd_pr__res_xhigh_po_0p35 l=6.78
X73 det_cell_2.sn a_6691_713# VSS.t5 sky130_fd_pr__res_high_po_0p35 l=4.54
X74 det_cell_0.gp t6p.t0 sky130_fd_pr__cap_mim_m3_1 l=6.965 w=6.965
X75 a_11691_2025# a_11491_265# VSS.t44 sky130_fd_pr__res_xhigh_po_0p35 l=6.78
X76 a_7325_5501# det_cell_3.gn VSS.t29 sky130_fd_pr__res_xhigh_po_0p35 l=6.78
X77 a_11891_5501# ibias_det.t5 VSS.t42 sky130_fd_pr__res_xhigh_po_0p35 l=6.78
X78 det.t7 det_cell_0.gp det_cell_0.sp VSS.t31 sky130_fd_pr__nfet_01v8 ad=0.3 pd=2.6 as=0.3 ps=2.6 w=1 l=0.15
X79 a_7725_5501# a_7525_3741# VSS.t27 sky130_fd_pr__res_xhigh_po_0p35 l=6.78
X80 a_1371_5053# VSS.t15 VSS.t14 sky130_fd_pr__res_high_po_0p35 l=4.54
X81 det_cell_0.gn t6n.t0 sky130_fd_pr__cap_mim_m3_1 l=6.965 w=6.965
X82 det_cell_4.gp a_737_265# VSS.t9 sky130_fd_pr__res_xhigh_po_0p35 l=6.78
X83 det.t3 det_cell_1.gp det_cell_1.sp VSS.t31 sky130_fd_pr__nfet_01v8 ad=0.3 pd=2.6 as=0.3 ps=2.6 w=1 l=0.15
X84 a_4703_2025# a_4503_265# VSS.t45 sky130_fd_pr__res_xhigh_po_0p35 l=6.78
X85 det_cell_2.sp a_5537_713# VSS.t22 sky130_fd_pr__res_high_po_0p35 l=4.54
X86 det_cell_5.gp t1p.t0 sky130_fd_pr__cap_mim_m3_1 l=6.965 w=6.965
X87 a_13240_1578# a_12848_266# VSS.t50 sky130_fd_pr__res_high_po_0p35 l=4.54
X88 ibias_det.t7 a_3559_265# VSS.t18 sky130_fd_pr__res_xhigh_po_0p35 l=6.78
X89 det.t13 VDD.t0 sky130_fd_pr__cap_mim_m3_1 l=22.035 w=22.035
X90 a_11491_5501# det_cell_1.gn VSS.t6 sky130_fd_pr__res_xhigh_po_0p35 l=6.78
X91 det_cell_0.sp a_9703_713# VSS.t37 sky130_fd_pr__res_high_po_0p35 l=4.54
X92 det.t10 det_cell_2.gp det_cell_2.sp VSS.t48 sky130_fd_pr__nfet_01v8 ad=0.3 pd=2.6 as=0.3 ps=2.6 w=1 l=0.15
X93 VSS.t51 a_2525_713# VSS.t16 sky130_fd_pr__res_high_po_0p35 l=4.54
X94 a_11891_5501# a_11691_3741# VSS.t43 sky130_fd_pr__res_xhigh_po_0p35 l=6.78
X95 det_cell_2.gn t5n.t0 sky130_fd_pr__cap_mim_m3_1 l=6.965 w=6.965
X96 det.t9 det_cell_3.gp det_cell_3.sp VSS.t48 sky130_fd_pr__nfet_01v8 ad=0.3 pd=2.6 as=0.3 ps=2.6 w=1 l=0.15
X97 a_7525_2025# a_7725_265# VSS.t27 sky130_fd_pr__res_xhigh_po_0p35 l=6.78
X98 a_337_5501# ibias_det.t1 VSS.t7 sky130_fd_pr__res_xhigh_po_0p35 l=6.78
X99 a_737_5501# a_537_3741# VSS.t10 sky130_fd_pr__res_xhigh_po_0p35 l=6.78
X100 a_537_2025# a_337_265# VSS.t11 sky130_fd_pr__res_xhigh_po_0p35 l=6.78
X101 det_cell_4.sp a_1371_713# VSS.t13 sky130_fd_pr__res_high_po_0p35 l=4.54
X102 a_6691_5053# det_cell_3.sn VSS.t5 sky130_fd_pr__res_high_po_0p35 l=4.54
R0 t6n t6n.t0 0.023984
R1 t6p t6p.t0 0.023984
R2 t5n t5n.t0 0.023984
R3 t5p t5p.t0 0.023984
R4 t4n t4n.t0 0.023984
R5 t4p t4p.t0 0.023984
R6 t3n t3n.t0 0.023984
R7 t3p t3p.t0 0.023984
R8 t2n t2n.t0 0.023984
R9 t2p t2p.t0 0.023984
R10 t1n t1n.t0 0.023984
R11 t1p t1p.t0 0.023984
R12 VDD.n0 VDD.t1 11.6952
R13 VDD.n0 VDD 0.33715
R14 VDD VDD.t0 0.0240052
R15 VDD VDD.n0 0.00196103
R16 det.n1 det.t5 138.561
R17 det.n2 det.t6 138.561
R18 det.n3 det.t10 138.561
R19 det.n4 det.t11 138.561
R20 det.n5 det.t7 138.561
R21 det.n6 det.t8 138.561
R22 det.n14 det.t1 138.561
R23 det.n13 det.t2 138.561
R24 det.n12 det.t9 138.561
R25 det.n11 det.t0 138.561
R26 det.n10 det.t3 138.561
R27 det.n9 det.t4 138.561
R28 det.n0 det 10.9143
R29 det.n7 det.t12 7.24093
R30 det.n5 det 3.09894
R31 det.n3 det 3.09894
R32 det det.n10 3.09894
R33 det det.n12 3.09894
R34 det det.n14 3.09894
R35 det.n1 det.n0 3.03644
R36 det det.n6 2.94269
R37 det det.n4 2.94269
R38 det det.n2 2.94269
R39 det.n9 det 2.94269
R40 det.n11 det 2.94269
R41 det.n13 det 2.94269
R42 det.n7 det.t13 2.35496
R43 det.n8 det 2.29894
R44 det.n8 det.n7 1.44425
R45 det.n6 det.n5 0.313
R46 det.n4 det.n3 0.313
R47 det.n2 det.n1 0.313
R48 det.n10 det.n9 0.313
R49 det.n12 det.n11 0.313
R50 det.n14 det.n13 0.313
R51 det det.n8 0.313
R52 det.n0 det 0.063
R53 ibias_det.n102 ibias_det.t12 415.777
R54 ibias_det.n102 ibias_det.t13 133.436
R55 ibias_det.n106 ibias_det.n105 50.6672
R56 ibias_det.n123 ibias_det.n122 50.6672
R57 ibias_det.n140 ibias_det.n139 50.6672
R58 ibias_det.n157 ibias_det.n156 50.6672
R59 ibias_det.n174 ibias_det.n173 50.6672
R60 ibias_det.n191 ibias_det.n190 50.6672
R61 ibias_det.n7 ibias_det.n2 50.6672
R62 ibias_det.n24 ibias_det.n19 50.6672
R63 ibias_det.n41 ibias_det.n36 50.6672
R64 ibias_det.n58 ibias_det.n53 50.6672
R65 ibias_det.n75 ibias_det.n70 50.6672
R66 ibias_det.n92 ibias_det.n87 50.6672
R67 ibias_det.n117 ibias_det.n116 17.8167
R68 ibias_det.n134 ibias_det.n133 17.8167
R69 ibias_det.n151 ibias_det.n150 17.8167
R70 ibias_det.n168 ibias_det.n167 17.8167
R71 ibias_det.n185 ibias_det.n184 17.8167
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
R600 VSS.n2798 VSS.n2797 585
R601 VSS.n2800 VSS.n679 585
R602 VSS.n679 VSS.n678 585
R603 VSS.n2802 VSS.n2801 585
R604 VSS.n2803 VSS.n2802 585
R605 VSS.n664 VSS.n663 585
R606 VSS.n675 VSS.n664 585
R607 VSS.n2811 VSS.n2810 585
R608 VSS.n2810 VSS.n2809 585
R609 VSS.n2812 VSS.n659 585
R610 VSS.n665 VSS.n659 585
R611 VSS.n2814 VSS.n2813 585
R612 VSS.n2815 VSS.n2814 585
R613 VSS.n646 VSS.n645 585
R614 VSS.n649 VSS.n646 585
R615 VSS.n2823 VSS.n2822 585
R616 VSS.n2822 VSS.n2821 585
R617 VSS.n2824 VSS.n640 585
R618 VSS.n640 VSS.n638 585
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
