mattvenn/ook-asic-radio/layout/pex/tx_ls.spice

* tx_ls: magic R+C extraction of layout/tx_ls.gds (layout/pex.sh)
.subckt tx_ls in A B VDD VAPWR VSS
X0 ctrl_n ctrl VDD.t7 VDD.t6 sky130_fd_pr__pfet_01v8_hvt ad=0.3 pd=2.3 as=0.6 ps=4.6 w=2 l=0.15
X1 B.t2 ctrl_n VSS.t3 VSS.t2 sky130_fd_pr__nfet_g5v0d10v5 ad=0.441 pd=3.24 as=0.882 ps=6.48 w=2.94 l=0.5
X2 B.t0 A.t5 VAPWR.t1 VAPWR.t0 sky130_fd_pr__pfet_g5v0d10v5 ad=0.252 pd=1.98 as=0.504 ps=3.96 w=1.68 l=0.5
X3 A.t1 B.t5 VAPWR.t5 VAPWR.t4 sky130_fd_pr__pfet_g5v0d10v5 ad=0.252 pd=1.98 as=0.504 ps=3.96 w=1.68 l=0.5
X4 VAPWR.t3 A.t4 B.t1 VAPWR.t2 sky130_fd_pr__pfet_g5v0d10v5 ad=0.504 pd=3.96 as=0.252 ps=1.98 w=1.68 l=0.5
X5 VAPWR.t7 B.t4 A.t0 VAPWR.t6 sky130_fd_pr__pfet_g5v0d10v5 ad=0.504 pd=3.96 as=0.252 ps=1.98 w=1.68 l=0.5
X6 ctrl_n ctrl VSS.t9 VSS.t8 sky130_fd_pr__nfet_01v8 ad=0.504 pd=3.96 as=0.504 ps=3.96 w=1.68 l=0.15
X7 VSS.t7 ctrl A.t3 VSS.t6 sky130_fd_pr__nfet_g5v0d10v5 ad=0.882 pd=6.48 as=0.441 ps=3.24 w=2.94 l=0.5
X8 VSS.t5 ctrl_n B.t3 VSS.t4 sky130_fd_pr__nfet_g5v0d10v5 ad=0.882 pd=6.48 as=0.441 ps=3.24 w=2.94 l=0.5
X9 ctrl in.t1 VDD.t5 VDD.t4 sky130_fd_pr__pfet_01v8 ad=0.9 pd=6.6 as=0.45 ps=3.3 w=3 l=0.15
X10 ctrl in.t0 VSS.t1 VSS.t0 sky130_fd_pr__nfet_01v8 ad=0.9 pd=6.6 as=0.9 ps=6.6 w=3 l=0.15
X11 VDD.t3 in.t2 ctrl VDD.t2 sky130_fd_pr__pfet_01v8 ad=0.45 pd=3.3 as=0.45 ps=3.3 w=3 l=0.15
X12 ctrl in.t3 VDD.t1 VDD.t0 sky130_fd_pr__pfet_01v8 ad=0.45 pd=3.3 as=0.9 ps=6.6 w=3 l=0.15
X13 A.t2 ctrl VSS.t11 VSS.t10 sky130_fd_pr__nfet_g5v0d10v5 ad=0.441 pd=3.24 as=0.882 ps=6.48 w=2.94 l=0.5
X14 VDD.t9 ctrl ctrl_n VDD.t8 sky130_fd_pr__pfet_01v8_hvt ad=0.6 pd=4.6 as=0.3 ps=2.3 w=2 l=0.15
R0 A.n3 A.t4 345.05
R1 A.n3 A.t5 277.462
R2 A.n2 A.n0 155.024
R3 A.n2 A.n1 30.5091
R4 A.n0 A.t0 17.0541
R5 A.n0 A.t1 17.0541
R6 A.n4 A.n3 7.07613
R7 A.n1 A.t3 5.81683
R8 A.n1 A.t2 5.81683
R9 A.n4 A.n2 3.63187
R10 A A.n4 0.19179
R11 B.n0 B.t4 345.05
R12 B.n0 B.t5 277.462
R13 B.n3 B.n1 154.357
R14 B.n3 B.n2 31.1758
R15 B.n1 B.t1 17.0541
R16 B.n1 B.t0 17.0541
R17 B.n4 B.n0 6.7145
R18 B.n2 B.t3 5.81683
R19 B.n2 B.t2 5.81683
R20 B.n4 B.n3 3.4105
R21 B B.n4 0.14996
R22 in.n0 in.t2 961.957
R23 in.n2 in.t0 743.442
R24 in.n0 in.t1 737.083
R25 in.n1 in.t3 737.023
R26 in in.n2 3.49886
R27 in.n2 in.n1 2.99947
R28 in.n1 in.n0 0.0609839
R29 VAPWR.n163 VAPWR.n9 247.951
R30 VAPWR.n166 VAPWR.n29 247.951
R31 VAPWR.n104 VAPWR.n56 247.951
R32 VAPWR.n100 VAPWR.n54 247.951
R33 VAPWR.n7 VAPWR.t5 230.542
R34 VAPWR.n198 VAPWR.t7 230.542
R35 VAPWR.n137 VAPWR.t1 230.542
R36 VAPWR.n52 VAPWR.t3 230.542
R37 VAPWR.n54 VAPWR.n53 185
R38 VAPWR.n55 VAPWR.n54 185
R39 VAPWR.n114 VAPWR.n113 185
R40 VAPWR.n113 VAPWR.n112 185
R41 VAPWR.n51 VAPWR.n50 185
R42 VAPWR.n50 VAPWR.t2 185
R43 VAPWR.n119 VAPWR.n118 185
R44 VAPWR.n120 VAPWR.n119 185
R45 VAPWR.n42 VAPWR.n41 185
R46 VAPWR.n121 VAPWR.n42 185
R47 VAPWR.n135 VAPWR.n134 185
R48 VAPWR.n134 VAPWR.n133 185
R49 VAPWR.n39 VAPWR.n38 185
R50 VAPWR.n132 VAPWR.n38 185
R51 VAPWR.n141 VAPWR.n140 185
R52 VAPWR.n141 VAPWR.n36 185
R53 VAPWR.n142 VAPWR.n2 185
R54 VAPWR.n143 VAPWR.n142 185
R55 VAPWR.n196 VAPWR.n3 185
R56 VAPWR.n144 VAPWR.n3 185
R57 VAPWR.n195 VAPWR.n4 185
R58 VAPWR.n145 VAPWR.n4 185
R59 VAPWR.n194 VAPWR.n5 185
R60 VAPWR.n30 VAPWR.n5 185
R61 VAPWR.n153 VAPWR.n6 185
R62 VAPWR.t4 VAPWR.n153 185
R63 VAPWR.n190 VAPWR.n8 185
R64 VAPWR.n154 VAPWR.n8 185
R65 VAPWR.n189 VAPWR.n9 185
R66 VAPWR.n165 VAPWR.n9 185
R67 VAPWR.n100 VAPWR.n99 185
R68 VAPWR.n69 VAPWR.n68 185
R69 VAPWR.n95 VAPWR.n67 185
R70 VAPWR.n102 VAPWR.n67 185
R71 VAPWR.n94 VAPWR.n72 185
R72 VAPWR.n93 VAPWR.n73 185
R73 VAPWR.n75 VAPWR.n74 185
R74 VAPWR.n89 VAPWR.n77 185
R75 VAPWR.n88 VAPWR.n78 185
R76 VAPWR.n87 VAPWR.n79 185
R77 VAPWR.n81 VAPWR.n80 185
R78 VAPWR.n83 VAPWR.n82 185
R79 VAPWR.n62 VAPWR.n61 185
R80 VAPWR.n105 VAPWR.n104 185
R81 VAPWR.n167 VAPWR.n166 185
R82 VAPWR.n166 VAPWR.n165 185
R83 VAPWR.n28 VAPWR.n27 185
R84 VAPWR.n154 VAPWR.n28 185
R85 VAPWR.n152 VAPWR.n151 185
R86 VAPWR.t4 VAPWR.n152 185
R87 VAPWR.n32 VAPWR.n31 185
R88 VAPWR.n31 VAPWR.n30 185
R89 VAPWR.n147 VAPWR.n146 185
R90 VAPWR.n146 VAPWR.n145 185
R91 VAPWR.n35 VAPWR.n34 185
R92 VAPWR.n144 VAPWR.n35 185
R93 VAPWR.n126 VAPWR.n37 185
R94 VAPWR.n143 VAPWR.n37 185
R95 VAPWR.n46 VAPWR.n44 185
R96 VAPWR.n44 VAPWR.n36 185
R97 VAPWR.n131 VAPWR.n130 185
R98 VAPWR.n132 VAPWR.n131 185
R99 VAPWR.n45 VAPWR.n43 185
R100 VAPWR.n133 VAPWR.n43 185
R101 VAPWR.n123 VAPWR.n122 185
R102 VAPWR.n122 VAPWR.n121 185
R103 VAPWR.n49 VAPWR.n48 185
R104 VAPWR.n120 VAPWR.n49 185
R105 VAPWR.n59 VAPWR.n57 185
R106 VAPWR.n57 VAPWR.t2 185
R107 VAPWR.n111 VAPWR.n110 185
R108 VAPWR.n112 VAPWR.n111 185
R109 VAPWR.n58 VAPWR.n56 185
R110 VAPWR.n56 VAPWR.n55 185
R111 VAPWR.n29 VAPWR.n25 185
R112 VAPWR.n171 VAPWR.n24 185
R113 VAPWR.n172 VAPWR.n23 185
R114 VAPWR.n173 VAPWR.n22 185
R115 VAPWR.n157 VAPWR.n20 185
R116 VAPWR.n177 VAPWR.n19 185
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
