mattvenn/ook-asic-radio/macros/radio_digital/radio_digital.nl.v

module radio_digital (clk,
    comp_in,
    dbg_en,
    lna_lo_n,
    rst_n,
    rx_en,
    sc_phi1,
    sc_phi2,
    tx_en,
    tx_en_n,
    trim_out,
    ui_in,
    uio_in,
    uio_oe,
    uio_out,
    uo_out);
 input clk;
 input comp_in;
 output dbg_en;
 output lna_lo_n;
 input rst_n;
 output rx_en;
 output sc_phi1;
 output sc_phi2;
 output tx_en;
 output tx_en_n;
 output [7:0] trim_out;
 input [7:0] ui_in;
 input [7:0] uio_in;
 output [7:0] uio_oe;
 output [7:0] uio_out;
 output [7:0] uo_out;

 wire _0000_;
 wire _0001_;
 wire _0002_;
 wire _0003_;
 wire _0004_;
 wire _0005_;
 wire _0006_;
 wire _0007_;
 wire _0008_;
 wire _0009_;
 wire _0010_;
 wire _0011_;
 wire _0012_;
 wire _0013_;
 wire _0014_;
 wire _0015_;
 wire _0016_;
 wire _0017_;
 wire _0018_;
 wire _0019_;
 wire _0020_;
 wire _0021_;
 wire _0022_;
 wire _0023_;
 wire _0024_;
 wire _0025_;
 wire _0026_;
 wire _0027_;
 wire _0028_;
 wire _0029_;
 wire _0030_;
 wire _0031_;
 wire _0032_;
 wire _0033_;
 wire _0034_;
 wire _0035_;
 wire _0036_;
 wire _0037_;
 wire _0038_;
 wire _0039_;
 wire _0040_;
 wire _0041_;
 wire _0042_;
 wire _0043_;
 wire _0044_;
 wire _0045_;
 wire _0046_;
 wire _0047_;
 wire _0048_;
 wire _0049_;
 wire _0050_;
 wire _0051_;
 wire _0052_;
 wire _0053_;
 wire _0054_;
 wire _0055_;
 wire _0056_;
 wire _0057_;
 wire _0058_;
 wire _0059_;
 wire _0060_;
 wire _0061_;
 wire _0062_;
 wire _0063_;
 wire _0064_;
 wire _0065_;
 wire _0066_;
 wire _0067_;
 wire _0068_;
 wire _0069_;
 wire _0070_;
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
 sky130_fd_sc_hd__decap_3 PHY_EDGE_ROW_70_Left_146 ();
 sky130_fd_sc_hd__decap_3 PHY_EDGE_ROW_70_Right_70 ();
 sky130_fd_sc_hd__decap_3 PHY_EDGE_ROW_71_Left_147 ();
 sky130_fd_sc_hd__decap_3 PHY_EDGE_ROW_71_Right_71 ();
 sky130_fd_sc_hd__decap_3 PHY_EDGE_ROW_72_Left_148 ();
 sky130_fd_sc_hd__decap_3 PHY_EDGE_ROW_72_Right_72 ();
 sky130_fd_sc_hd__decap_3 PHY_EDGE_ROW_73_Left_149 ();
 sky130_fd_sc_hd__decap_3 PHY_EDGE_ROW_73_Right_73 ();
 sky130_fd_sc_hd__decap_3 PHY_EDGE_ROW_74_Left_150 ();
 sky130_fd_sc_hd__decap_3 PHY_EDGE_ROW_74_Right_74 ();
 sky130_fd_sc_hd__decap_3 PHY_EDGE_ROW_75_Left_151 ();
 sky130_fd_sc_hd__decap_3 PHY_EDGE_ROW_75_Right_75 ();
 sky130_fd_sc_hd__decap_3 PHY_EDGE_ROW_7_Left_83 ();
 sky130_fd_sc_hd__decap_3 PHY_EDGE_ROW_7_Right_7 ();
 sky130_fd_sc_hd__decap_3 PHY_EDGE_ROW_8_Left_84 ();
 sky130_fd_sc_hd__decap_3 PHY_EDGE_ROW_8_Right_8 ();
 sky130_fd_sc_hd__decap_3 PHY_EDGE_ROW_9_Left_85 ();
 sky130_fd_sc_hd__decap_3 PHY_EDGE_ROW_9_Right_9 ();
 sky130_fd_sc_hd__tapvpwrvgnd_1 TAP_TAPCELL_ROW_0_152 ();
 sky130_fd_sc_hd__tapvpwrvgnd_1 TAP_TAPCELL_ROW_0_153 ();
 sky130_fd_sc_hd__tapvpwrvgnd_1 TAP_TAPCELL_ROW_0_154 ();
 sky130_fd_sc_hd__tapvpwrvgnd_1 TAP_TAPCELL_ROW_0_155 ();
 sky130_fd_sc_hd__tapvpwrvgnd_1 TAP_TAPCELL_ROW_0_156 ();
 sky130_fd_sc_hd__tapvpwrvgnd_1 TAP_TAPCELL_ROW_0_157 ();
 sky130_fd_sc_hd__tapvpwrvgnd_1 TAP_TAPCELL_ROW_0_158 ();
 sky130_fd_sc_hd__tapvpwrvgnd_1 TAP_TAPCELL_ROW_0_159 ();
 sky130_fd_sc_hd__tapvpwrvgnd_1 TAP_TAPCELL_ROW_0_160 ();
 sky130_fd_sc_hd__tapvpwrvgnd_1 TAP_TAPCELL_ROW_0_161 ();
 sky130_fd_sc_hd__tapvpwrvgnd_1 TAP_TAPCELL_ROW_0_162 ();
 sky130_fd_sc_hd__tapvpwrvgnd_1 TAP_TAPCELL_ROW_0_163 ();
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
