mattvenn/ook-asic-radio/(commit log)

2026-10-07 Phase 0 bench work, models and plan for the TT sky130 radio
    - bench/: demo-board and scope tools, ring-osc OOK measurements (power,
    path loss, drift, keying, phase noise, recorded packets, antenna test)
    - model/: bit-exact Gold-code TX/RX digital model, comparator/slicer
    studies, end-to-end sensitivity check
    - test/vectors/: cocotb vectors and timing contract from the model
    - sim/: first ngspice checks (inverter LNA stage, TX driver strength)
    - docs/slicer.md, PLAN.md
    [antenna_test.csv, drift_20261007_133134.csv, drift_20261007_134656.csv, ota.csv]
2026-10-07 Restructure to the TT analog template (ttsky26d, 2x2 + VAPWR)
    Follow the mattvenn/tt08-analog-r2r-dac-3v3 flow (mag/ make start/drc/lvs,
    lvs workflow, openlane macro, verilog/rtl+test, xschem pad model), updated
    to the current ttsky26d template (workflows @ttsky26d, yaml_version 6,
    uses_vapwr) and the 2x2_3v3 tile definition from tt-support-tools main.
    info.yaml pinout, LVS stub, README and datasheet filled in; cocotb vectors
    moved to verilog/test/vectors.
    [pad_model.sch]
2026-10-07 PLAN.md: record open question on the analog-pin current limit
2026-10-07 PLAN.md: 3.3 V TX driver allowed (4 mA limit is electromigration/RMS); root xschemrc
2026-10-07 PLAN.md: 3.3 V TX driver allowed (4 mA limit is electromigration/RMS)
2026-10-07 tb_input: antenna -> pad_model -> core testbench (xschem, generated)
    Generated xschem testbench in the mini-mosbius style (corner.sym, root
    xschemrc, netlists in build/). Core sees -2.2 dB of the dipole EMF at
    433.92 MHz: ~3.8 mVpp differential at -50 dBm.
    [tb_input.sch]
2026-10-07 STATUS.md handoff; xsch.py MOSFET/symbol/port helpers
2026-10-07 radio_digital RTL + cocotb tests (bit-exact vs model); size ~54% of tile
    From the RTL agent: rd_gold/rd_corr/rd_rx/rd_tx + top, 13 cocotb tests
    matching model vectors exactly. yosys: 716 FFs, ~24.3k um^2 cells
    (~40.5k placed) - needs reduction (clock-gated phase regs, 2 phases).
    Report in verilog/RTL_REPORT.md; STATUS.md updated.
    [pin_order.cfg]
2026-10-07 LNA first-stage experiment: dp vs pinv vs dpp, NF/CM/PSRR, sweeps
    NMOS diff pair chosen (tentative): CM rejection rules out pseudo-diff
    inverters; PMOS pair loses on NF and gain. NF 10.1 dB at 1.26 mA (W 80),
    7.4 dB at 2.5 mA (W 160), tt, pad included.
    [lna_dp.sch, lna_dpp.sch, lna_pinv.sch, tb_lna_dp.sch, tb_lna_dpp.sch, tb_lna_pinv.sch]
2026-10-07 LNA input matching experiment: off-chip series L per arm (~18 nH) gives ~3 dB NF
    On-chip low-Q spiral is a loss; off-chip shunt L ~1 dB. Pad model is rough,
    so the match is a board-level, bench-tuned choice.
2026-10-07 RX gain chain: 5 diff-pair stages, cap-degenerated stages 2-5, 66.6 dB at 434 MHz
    Stage 1 amp_dp (1.2 mA), stages 2-5 amp_dpc (split tail + Cs, DC coupled):
    flat 65-67 dB over 330-560 MHz, FM -23 dB, 10 MHz -96 dB, NF 11 dB,
    2.56 mA. Level sweep shows ~13 dB tap spacing for successive detection.
    write_symbol() gains subckt params; tb front end shared via frontend.py.
    [amp_dp.sch, amp_dpc.sch, lna_chain.sch, tb_chain.sch, tb_lna_dp.sch, tb_lna_dpp.sch, tb_lna_pinv.sch]
2026-10-07 STATUS: upper-side rejection is half pad, half chain; measure before shaping
2026-10-07 Log detector (successive detection) + 6-stage chain; sim speed fixes and learnings doc
    det_cell/log_det: per-tap full-wave rectifiers summed into rdet||cdet;
    CW log-linear -80..-10 dBm at ~12.6 mV/dB; with repeatable PWL noise the
    detector moves 1.07 mV for -94 dBm (~11-14 mV/dB at the noise floor).
    Chain taps exposed; 6th stage moves the noise floor into the log range.
    Tracked .spiceinit (klu, threads, no hsa) copied by tools/osic;
    docs/sim_learnings.md collects xschem/ngspice lessons.
    Claude-Session: https://claude.ai/code/session_01KqF5gVHdyVCY8Do9kTrPsx
    [det_cell.sch, lna_chain.sch, log_det.sch, tb_logdet.sch]
2026-10-07 e2e with the simulated chain: -94 dBm holds; comparator noise budget <= 0.5 mV rms
    model/e2e.py takes NF, RF bandwidth, detector slope and offset/trim/noise in mV;
    AfeModel gains optional comparator noise (default 0, vectors unchanged).
    NF 11 dB / 450 MHz / 12 mV/dB still decodes -94 dBm in noise; 0.6 mV comparator
    noise starts losing it, 1 mV costs ~2-4 dB.
    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
2026-10-07 Post-detection LPF: passive xhigh-poly 1 MOhm + 10.9 pF MIM, 14.4 kHz
    e2e (--bv) shows 10-20 kHz cutoffs perform alike at -94 dBm, so on-chip RC
    spread is fine. lpf_rc + tb_lpf generated from xschem/gen/lpf.py.
    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
    [lpf_rc.sch, tb_lpf.sch]
2026-10-07 Comparator (continuous, trimmed) + switched-cap averaging reference
    comp_ct: lvt NMOS pair + mirror, 1 pF dominant pole, PMOS CS, inverter;
    degenerated trim pair vs on-chip VDD/2. Offset +0.5..1.8 mV over CM
    0.55-1.6 V, trim 0.087 mV/LSB, decision noise 28 uV rms, 0.36 us at 1 mV.
    avg_sc: 0.25 p / 9.1 p MIM on sc_phi1/2, tau 0.47 ms, offset <= 0.04 mV.
    .spiceinit drops KLU (breaks .noise); learnings doc updated.
    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
    [avg_sc.sch, comp_ct.sch, tb_avg.sch, tb_comp.sch]
2026-10-07 Whole-RX transient: RF half + baseband half, transistor level, with plots
    RF: -60 dBm through pad and 6 stages (0.76 mV EMF -> 1.6 V limited), keyed
    carrier -> det step. Baseband: one Gold burst with RF noise through
    lpf_rc -> avg_sc -> comp_ct and a trim-servo stand-in; sampled bits into
    the bit-exact digital. -70 dBm: 98 % chips, score 127; -94 dBm: 67 %,
    score 99/127 (threshold 97) -> detected.
    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
    [tb_rx_bb.sch]
2026-10-07 Ring frequency calibration: ttsky25b ring re-simulated across corners
    Extracted ring 1: tt 598, ss 495, ff 678 MHz; measured 518 -> x0.866 of tt
    (between tt and ss); temperature +0.5 % 27->60 C, VDD good on boards.
    Rule: design the 433 MHz ring to ~500 MHz extracted-tt (~23 std-cell stages).
    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
2026-10-07 Fully joined RX transient (antenna -> comparator, RF noise) set up for an overnight run
    sim/rx/joined.sh: tb_logdet + lpf_rc + avg_sc + comp_ct, keyed chips, trnoise,
    option interp; edges offset 25 ps off the trnoise grid. plot_joined.py compares
    with the split model. Learnings doc: trnoise breakpoint collision, interp.
    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
2026-10-08 tools/longrun: detached long jobs with systemd-inhibit; learnings on probes, suspend, end-only writes
    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
2026-10-08 TX ring sizing: calibrated schematic (3.2 fF/stage = extracted), 22 inv + nand -> 494 MHz tt (~428 MHz silicon)
    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
2026-10-08 TX chain first pass: real ring -> skewed level shifter -> thick buffers -> antiphase drivers -> pad -> dipole
    +3.3..+4.0 dBm into 73 ohm across tt/ss/ff (+4.2 dB over the old 1.8 V driver),
    arm phase within 1.2 deg, on/off in ns, 10 mA on VAPWR, only 0.2 mA step on
    VDPWR (old bench chirp came from 1.8 V droop). Ring 484 MHz tt -> ~419 on silicon.
    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
2026-10-08 Joined RX run matches split model; TX as xschem blocks (tx_ring/ls/drv/top, tb_tx), NAND-gated arms, 5 corners
    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
    [tb_tx.sch, tx_drv.sch, tx_ls.sch, tx_ring.sch, tx_top.sch]
2026-10-08 RTL: tx_en_n arm enable + single-ended strap (uio_in[3] with magic); cocotb 14/14; RX corner sweep scripts
    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
    [pin_order.cfg]
2026-10-08 ua[4] debug: det via debug-only transmission gate (dbg_tg, tb_dbg); dbg_en strap in RTL + test
    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
    [dbg_tg.sch, pin_order.cfg, tb_dbg.sch]
2026-10-08 Real PDK passives in chain + detector; bias_gen (I = VDD/3 / high_po R, tracks the loads); RX corners 10-50 C done
    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
    [amp_dp.sch, amp_dpc.sch, bias_gen.sch, det_cell.sch, lna_chain.sch, log_det.sch, tb_bias.sch]
2026-10-08 Trim DAC: r2r schematic matching the reused tt08 layout, tb_dac (exact transfer, 10.6k Rout, ripple cancels vs VDD/2)
    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
    [r2r.sch, tb_dac.sch]
2026-10-08 VAPWR feed + decap sweep: TX power unaffected; ~50 pF keeps 434 MHz ripple off the 3.3 V net
    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
2026-10-08 Analog top (radio_analog), TT top schematic, radio_digital black box, tb_radio_analog; mm as subckt param
    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
    [lna_chain.sch, radio_analog.sch, tb_chain.sch, tb_logdet.sch, tb_radio_analog.sch, tt_um_mattvenn_radio.sch]
2026-10-08 rd_gold: LFSR steps as wires (Yosys pre-synth check false positive); LibreLane config.json; cocotb 15/15
    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
2026-10-08 Digital re-harden with LibreLane: 300x210 clean (DRC/LVS/antenna 0, timing met); pin order matched to the 3x2 template
    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
    [pin_order.cfg]
2026-10-08 Area estimate from the real radio_analog netlist (per-block max(devices, MIM)); 3x2 with the 300x210 macro is ~120% full
    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
2026-10-08 Cap shrink (LPF 2.95M/3.7p, avg 0.1p/3.7p, cdet 1p; cin kept 2p): re-verified LPF, avg, detector, whole analog; area 98% of the space left beside the digital
    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
    [avg_sc.sch, log_det.sch, lpf_rc.sch, tb_logdet.sch, tb_lpf.sch]
2026-10-08 Mixed-signal analysis: pin-order checks + servo plot (1 ms probe: converges 128 -> ~114 in 0.25 ms)
    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
2026-10-08 Trim rdeg 2 MOhm (step ~0.075-0.107 mV/LSB); decap_vapwr/decap_vdpwr blocks in radio_analog; area 85% of what's left; chain stability script (not run)
    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
    [decap_vapwr.sch, decap_vdpwr.sch, radio_analog.sch]
2026-10-08 STATUS: clock gating + GL 15/15, mixed-signal servo results (-70/-94 detected, pin order verified), next steps
    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
2026-10-08 Layout flow on tx_drv: KLayout pcells -> DRC/LVS -> PEX -> block test; tx_drv v2 clean
    - layout/gen/lay.py: sky130 pcells (Mabrains, gdsfactory 8.5 via tools/kpcell_setup.sh),
    terminal discovery from pcell geometry, DRC-safe via arrays, stacks, row guard rings,
    EM cut counts
    - layout/gen/tx_drv.py v2: packed P/N rows, shared rings, met3/met2 routing channel,
    widths and cuts sized from measured currents; 40.9 x 27.6 um, magic + klayout DRC 0, LVS match
    - layout/check.sh (DRC + LVS), layout/pex.sh + pexfix.py (R+C extraction, schematic port order)
    - tools/pexswap.py: swap a schematic subckt for its extracted layout in any deck
    - sim/tx/tb_tx_drv.py: block testbench (schematic vs --pex):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
2026-10-08 Layout checklist (IIC-JKU guides), antenna + density checks, net labels
    - docs/layout.md: checklist for every block and the top level (floorplan first,
    noisy/quiet separation, paired supplies, matching, EM cut sizing, density as a
    good neighbour, antenna), plus antenna/label lessons
    - layout/check.sh: magic antennacheck (flattened, own session, debug; proven by
    layout/gen/ant_test.py), per-layer density report; LVS optional without a schematic
    - lay.Block.label: net names without pins; tx_drv labels y0..y4 (named in PEX/LVS)
    - tx_drv: antenna 0, density m1 46 % / m2 39 % / m3 33 %, DRC/LVS clean
2026-10-08 Re-verify rdeg 2 MOhm (local trim step 0.062-0.076 mV/LSB all corners, e2e -94 8-11/12), decaps 50/30 pF, chain stability (<=0.1 fF out->in coupling at ss 10C)
    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
    [tb_radio_analog.sch]
2026-10-08 rows.py builder (channel routing with stub constraints, LV/HV columns); tx_ls + tx_ls_en layouts; GDS viewer links
    - layout/gen/rows.py: generic row cell builder from tx_drv v2: segments by oxide/rail
    (LV/HV columns, own rings/wells/rails), stubs planned first, vertical constraints
    (P stub over N stub) + constrained left-edge track assignment
    - tx_drv rebuilt on it (40.9 x 26.7 um), tx_ls (13.8 x 19.0) and tx_ls_en (12.9 x 12.5):
    magic/klayout DRC 0, antenna 0, LVS match (layout/ref/<variant>.spice, params substituted)
    - check.sh / pex.sh take layout/ref/<block>.spice when present
    - sim/tx/tb_tx_ls.py: level shifter block test (schematic vs --pex). tt:
    tx_ls A duty 37.3 % sch -> 28.4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
2026-10-08 Mixed-signal -94 dBm with rdeg 2 MOhm: burst detected, servo dither 0.24 mV
    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
2026-10-08 lpf_rc layout: poly R serpentine under two MIMs; DRC/antenna/LVS clean, PEX matches
    - layout/gen/passives.py: PolyRes (series segments of the PDK res_poly pcell;
    netgen adds series L) and mim (cap_mim_m3_1 with a met4 strip contact
    instead of a full met4 plate)
    - layout/gen/lpf_rc.py: 16 x 25 um xhigh-0.35 segments in a VSS p-tap ring,
    2 x 30x30 MIM over them on separate bottom plates abutting the VSS rail
    (met1+2+3); 65.2 x 35.0 um. Writes layout/ref/lpf_rc.spice (lr/nc substituted)
    - check.sh: magic DRC 0, KLayout DRC 0, antenna 0, LVS match; met3 89 %
    (MIM plates; density to be revisited with the decaps)
    - sim/lpf_rc/tb_lpf_rc.py [--pex] [corner]: schematic vs extracted within 0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
2026-10-08 tx_ls: upsize the ctrl_n inverter (M8/M7 1/0.42 -> 4/1.68); extracted A duty 28 -> 36 %
    The slow edge was in -> ctrl -> ctrl_n -> M10 -> B -> M11 -> A: dac_drive's tiny
    ctrl_n inverter driving M10's thick gate plus the ctrl_n wiring. A stronger
    cross-coupled pull-up (kp 6) didn't help (27.8 %).
    tt, schematic -> extracted: A duty 41.8 -> 35.8 %, arm output duty 44.1/47.6 ->
    38.6/43.7 %. tx_ls / tx_ls_en relaid out: DRC, antenna, LVS clean.
    tb_tx_ls also measures the duty at the arms' outputs.
    Claude-Session: https://claude.ai/code/session_01YTUyXVmLVLiNWv8HEB4Knj
    [tx_ls.sch]
2026-10-08 tx_ring layout (std cells, 34.5 x 4.2 um): clean; extracted 508.5 MHz tt -> ~440 MHz silicon
    - layout/gen/tx_ring.py: one row of 22 inv_2 + nand2_2 + taps (PDK GDS), met1 stage
    straps, met2 'out' return, met3 'en'; 1 um rails; LVS reference without the cw caps
    - check.sh: netgen loads the sky130_fd_sc_hd spice library on the schematic side
    when the reference uses std cells
    - sim/tx/tb_tx_ring.py: ring frequency into the main level shifter, schematic (cw)
    vs extracted: 485.4 -> 508.5 MHz (+4.8 %); x0.866 -> ~440 MHz (target 433.92)
    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
2026-10-08 dbg_tg layout: rows.py cell + own b route; DRC/antenna/LVS clean, PEX compared
    - layout/gen/dbg_tg.py: inverter (en -> enb) and pass pair on rows.py (PMOS row
    over NMOS row, VDD / VSS rails met1+2+3). rows.py routes one signal net per
    device, so a goes through its channel and the generator routes b itself:
    met2 from each pass device's outer strip end, over the ring, to a bar
    outside the rings (the pin); rails extended to the new edge.
    5.7 x 16.3 um; density all layers <= 39 %. Writes layout/ref/dbg_tg.spice.
    - sim/dbg_tg/tb_dbg_tg.py [--pex] [corner]: Ron at 0.2/0.9/1.6 V and off
    isolation pad (b, 50 Ohm) -> det (a, 8k || 5p).
    tt: Ron 0.53/4.11/1.13 k (sch) vs 0.46/4.06/1.01 k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
2026-10-08 r2r: reuse the tt08 layout as a block (layout/src/r2r -> layout/r2r.gds); clean; block test
    - layout/src/r2r/: the tt08-analog-r2r-dac-3v3 magic sources, unchanged (r2r, start/bit/
    end modules, res_high_po_1p41 L 45 unit); layout/gen/r2r.sh writes the GDS
    - check.sh: DRC 0, antenna 0, LVS match vs xschem/r2r.sch; pex extracted
    - sim/dac/tb_r2r.py: DC error <= 0.021 LSB extracted, Rout 10.65 kOhm, 127->128 into
    1 pF settles in 30.6 ns (schematic 24.6)
    - layout/README.md: viewer link
    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
2026-10-08 avg_sc layout (74.5 x 43.6 um): clean; rows.py pass devices; lay.write_ref
    - rows.py: strip roles may be any net (transmission gates); multi-net devices pack
    their stubs side by side; build() exposes b.rows for generators that add caps/wiring.
    tx_ls unchanged, tx_drv only swaps the NAND's in/en tracks (still clean)
    - lay.write_ref: parameter-substituted LVS/PEX reference from any xschem cell
    - layout/gen/avg_sc.py: switches via rows.py, Cs + 2 Cavg MIMs (passives.mim) under
    the VSS rail; DRC/antenna/LVS clean
    - sim/avg_sc/tb_avg_sc.py: 20-cycle short form. tt: tau 0.458 -> 0.434 ms extracted;
    hold drift +-1.8 mV / 20 cycles (phi/phib coupling imbalance, ~4 mV static offset,
    within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
2026-10-08 rows.py: deterministic channel track order (ties by net name)
    assign_tracks sorted nets by span start only; equal starts fell back to set
    order, which follows Python's per-process string hashing. tx_drv came out
    one of two channel variants (~1 run in 4 the other). Ties now go by net
    name. tx_drv, tx_ls, tx_ls_en, dbg_tg and avg_sc regenerate identical to
    the committed GDS (XOR, 2 runs each).
2026-10-08 comp_ct layout: ABBA pairs + dummies, passives below the rail; clean; block test
    - rows.py: rail-tied dummies (rows.dummy); strip groups (a net's contiguous run per
    bar/stub: a pair half tail|d|tail no longer shorts); b.rows['xs'] track spans
    - comp_ct: input pair, trim pair and PMOS mirror split ABBA with dummies; Rdeg and the
    Rr1/Rr2 divider (one serpentine, vref at the middle link) in a p-tap ring, Cl and
    Cref MIMs, all rising on met4 to their tracks. 100.5 x 49.9 um; DRC/antenna/LVS clean
    - xschem: matching dummies in comp_ct (all terminals on the rail) so LVS sees them
    - lay.write_ref: SPICE suffixes in expressions
    - sim/comp_ct/tb_comp_ct.py (tt, sch -> pex): offset +0.80 -> +0.5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
    [comp_ct.sch]
2026-10-08 det_cell layout: MIMs packed over the resistors; DRC/antenna/LVS clean
    - layout/gen/det_cell.py: p half left, n half mirrored right, one p-tap ring
    (VSS); VSS rail at the bottom (met1+2+3); out / vb buses (met2, full width,
    pins both edges for abutting in log_det); Rb 4 x 6.78 um xhigh, Rs 2 x 4.54
    um high-poly, NMOS in the middle; the two ~7x7 um MIMs packed over the
    resistors, top plates dropping (met3) through the gap between them.
    20.8 x 16.1 um; met3 44 %. Writes layout/ref/det_cell.spice.
    - Rs is 2 segments: one more ~963 Ohm model end term than the schematic
    (~10.96k vs 10k, ~-10 % rectified current, inside the poly's +-15 %
    spread). A lone 0.35 um segment fails magic rp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
2026-10-08 bias_gen layout (80.2 x 49.1 um): clean; extracted currents within 0.1 %
    Mirror array (123 PMOS units, 3 rows ABBA common centroid, met1/met2 only)
    under Cc + 2 x Cvcm; small devices via rows.py (pass-device roles for the
    OTA pair and Mn); resistors under one Cvref unit, reached by met2 lanes and
    met1 columns. VSS rails top and bottom (MIM plates), VDD in the middle.
    DRC (magic + KLayout), antenna, LVS clean.
    Block test sim/bias/tb_bias_gen.py [--pex] (tb_bias deck): extracted
    ib_chain -0.08 %, ib_det / ib_comp / vcm within 0.01 % at VDD 1.7-1.9 V,
    10-50 C; start-up / re-enable identical.
    Schematic: Cvcm / Cvref as 2 x 22 um MIM units (<= 30 um, like Cc);
    5 array dummies Mdum; Rref as two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
    [bias_gen.sch]
2026-10-08 amp_dpc layout: mirrored halves, MIMs over the devices; DRC/antenna/LVS clean
    - layout/gen/amp_dpc.py: chain stage 2..6 (w 20 nf 4, Rl 4k high_po_0p69,
    split tails 3 x W6/L0.5 per side, 2 x 0.3 pF MIM). Mirrored about the
    centre: tails + pairs in one p-tap ring, the loads as an adjacent pair in
    the centre (merged RPM: a lone 0.69 segment fails magic rpm.1), one psdm
    over both loads. Each MIM's bottom plate is its half's source (met3 tab to
    a drop column; no via2 under capm); top plates by met4 strips to the far
    edge (one high, one low). met1 channel for in/out tracks, met2 verticals.
    30.5 x 21.2 um; met3 64 % (packed MIMs). Writes layout/ref/amp_dpc.spice.
    - passives.PolyRes: a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
2026-10-08 tx_ring: fold into two rows (17.9 x 7.0 um), no long feedback wire; clean; 529.9 MHz extracted tt
    Row 1 rotated R180 shares the middle VDD rail; the turn and nand->inv1 feedback are short met2
    verticals. out 10.6 -> 3.3 fF. ~459 MHz on silicon (x0.866), within the RX band; 24 inv -> ~422.
    tb_tx_ring.py takes OSIC from the environment.
2026-10-08 amp_dp layout (stage 1): 5 um gate fingers, ABBA pair; clean; tb fingers mode
    - layout/gen/amp_dp.py: pair W 80 drawn as 16 x 5 um fingers per side (the
    schematic's 4 x 20 um fingers would be ~530 Ohm of gate each vs 1/gm ~110
    Ohm), 4 groups of 8 in A B B A; tail 40 x 3 um fingers (the reference
    diode's finger width); Rl 1k high_po_1p41 either side. Bars, links and cuts
    sized for 1.2 mA tail / 0.6 mA per side at 2x the LEF limits (generator
    prints the check). inp / inn leave left on met3, outputs on met3 tracks to
    the right. 36.4 x 20.7 um, every layer <= 37 %.
    - sim/amp_dp/tb_amp_dp.py [--pex | --fingers] [corner]; tb_amp_dpc.py gets
    --fingers too: the schematic with the pair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
2026-10-08 log_det layout on the shared det_cell: 6 cells + vb replica/Rdet/Cdet; clean; block test
    - layout/gen/log_det.py: det_cell x6 (copied in, abutting), end section in the same frame
    (Mbias diode, Rs_b drawn as the cells' Rs so the replica matches, Rdet 0.69 x3 with one
    RPM), Cdet above on a VDD rail with its riser over the end section; psdm bridged across
    the cell boundaries (psdm.1). DRC/antenna/LVS clean
    - sim/logdet/tb_log_det.py (tt, sch -> pex): idle det 1.5197 -> 1.4890 V (high-po per-
    segment end term), 100 mV on t6 -1.56 -> -1.46 mV
    - STATUS / docs/layout.md: log_det done, lna_chain left
    Claude-Session: https://claude.ai/c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
2026-10-08 lna_chain layout: input caps + amp_dp + 5 x amp_dpc in a line; clean
    - layout/gen/lna_chain.py: reads the amp_dp / amp_dpc layouts in as subcells
    (pcell name clashes renamed on read). Input section on the left: Cin_p /
    Cin_n (2 pF, 31.2 um MIMs) side by side, Mref and the Rb pair (single 20k
    segments, side by side) in a p-tap ring under them; the top plates drop on
    met3 to amp_dp's inputs, the pad-side plates are pins on the top edge.
    Then the six stages in a straight line (output far from input), 2 um gaps
    carrying out -> in, nb, the VSS rail and the VDD band; taps o1..o5 pinned
    in the gaps.
    - 268.1 x 35.3 um bounding box (9.5k um2); the stages are 21.2 um tall, the
    input ca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
2026-10-08 rows.py: optional Dev.xmin (P row) to place a device further right without pushing its N partner
    Regenerated avg_sc, dbg_tg, tx_drv, bias_gen, tx_ls, tx_ls_en: XOR 0 against the committed GDS.
2026-10-08 rows.py: optional fixed track order (build/assign_tracks order=), checked against the stub constraints; empty tracks reserved for generator-drawn shields
    Default path unchanged: tx_drv, tx_ls, tx_ls_en, dbg_tg, bias_gen, comp_ct regenerate XOR-identical.
2026-10-08 avg_sc v2: mirrored phi/phib channel with VDD/VSS shields, nothing crossing it; 2.35k um2 (was 3.25k); in/out pins right, phi top
    Extracted clock-coupling imbalance on cs/out 0.19 -> <= 0.011 fF (the ~4 mV offset source).
    DRC (magic, klayout) 0, antenna 0, LVS match. tb_avg_sc --pex not re-run.
2026-10-08 comp_ct v2: 73.5 x 42.0 um (3.08k um2, was 5.0k); trim pair beside the main pair, out/o2 -> d1/d2 coupling 7.4/6.2 fF -> 0
    - N row: core (main + trim pairs) first, then bias / stage 2 / inverter; Mp3/Mip over Mn3/Min (Dev.xmin)
    - Mt1 / Mn3 folded into 4.55 um fingers (W per finger x mult, bin-corrected: 0.91 x the units' W)
    - Cl as 2 x 22 x 11 MIMs + Cref over the resistor ring (30 + 32 segments); ends on met2 lanes to one riser column
    - DRC (magic + KLayout) 0, antenna 0, LVS match; tb_comp_ct tt sch -> pex: +0.795 -> +0.560 mV, 0.0649 -> 0.0656 mV/LSB
    - tb_comp_ct takes OSIC from the environment
    [comp_ct.sch]
2026-10-08 lna_chain: extracted netlist (layout/pex.sh): 200 devices, 8.7k R, 224 C; no late-to-early stage coupling C
    Claude-Session: https://claude.ai/code/session_01T3xf24zE2LZDfcXEryhkgZ
2026-10-08 Floorplan spec for the interactive floorplan page: tile pins from the 3x2 analog DEF, block bboxes + pin labels from the GDS, ranked rules (half-duplex: chain input vs macro first), area budget, star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
2026-10-08 docs/history.md: chain stability with the extracted stages and the laid-out chain
    Budget unchanged at <= 0.1 fF asymmetric out -> in coupling (ss 10 C), for
    the extracted stages as for the schematic; the fully extracted lna_chain is
    stable with no peaking and no late-to-early wiring coupling. Pass criterion,
    decks and caveats (substrate not modelled) recorded.
    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
2026-10-08 Floorplan page: engine, UI, placer and variants A-C
    - layout/floorplan/page/: engine.js (GDS orientations, pins, nets, ranked-rule
    checks, floorplan.json export/import), page.html (the artifact UI: drag,
    rotate/mirror, flylines, live checklist, area, straps, variants in the
    artifact's shared store), place.js (anneals variants A-C, fills decap,
    picks strap lanes), check.js (the same checklist from the command line).
    - tools/floorplan_page.py builds the single-file page; blocks.json gains
    lna_chain and per-cell met4/MIM obstruction boxes (floorplan_blocks.py).
    - layout/floorplan/variants.json: the seeded variants.
    - docs/floorplan_spec.md: the straight lna_chain fits nowhere in the t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
2026-10-09 Floorplan page: full-screen button
    Claude-Session: https://claude.ai/code/session_01EtsNGa6Q78QGdCW4FsyR1N
2026-10-09 Floorplan page: the real straight lna_chain, no fold proposal; real avg_sc pin labels
    lna_chain is one 268.1 x 35.3 um block with its GDS pins and the rule
    zones (input, stage 1, stages 4-6) inside it. avg_sc uses its GDS label
    positions. The variants in the store lose the two fold parts, so the chain
    waits in the parking row; variants.json mirrors the store. The fitted view
    includes the parking row.
    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
2026-10-09 Floorplan page: block diagram view (RX and TX signal paths), toggled with the layout
    Shows how the blocks join: RX pads -> lna_chain stages -> log_det taps -> lpf_rc
    -> avg_sc / comp_ct -> macro, with bias, trim and debug branches; TX from the
    macro through tx_ring, tx_ls, tx_ls_en to tx_drv and ua[0]/ua[1]. Wires carry the
    open variant's Manhattan lengths; clicking a block opens it in the layout.
    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
2026-10-09 Floorplan page: reshape the digital macro at constant area (49,400 um2)
    Width slider / field in the macro's Selection panel (220-480 um, height =
    49400 / width); the top-right corner stays put, the estimated pin spread
    scales with the edges, and floorplan.json carries the new w x h with a
    re-harden note.
    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
2026-10-09 Reassign the analog pins: RX ua[0]/ua[1], debug ua[2], TX ua[3]/ua[4]; trim_out side on the floorplan page
    Pin map (was TX 0/1, RX 2/3, debug 4): info.yaml, xschem/gen/top.py and the
    regenerated tt_um_mattvenn_radio.sch, comments in src/project.v,
    radio_digital.v, test_radio.py and the dbg/lpf/tb_input generators, PLAN,
    STATUS, the floorplan spec and PIN_ORDER.md (its west-edge order was chosen
    for the old map). The floorplan page's nets, pad labels and block diagram
    follow the new map.
    Floorplan page: the macro's r2r trim drive (trim_out[7:0]) can sit on its
    west (as hardened), south, north or east edge per variant; exported as
    macro_pins in floorplan.json (a pin_order.cfg change and re-ha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
    [tb_dbg.sch, tt_um_mattvenn_radio.sch]
2026-10-09 Floorplan page: moved pins (floorplanning), and pinfit.js to put pins on facing edges
    A variant can move any block's pins (v.pins[inst][pin] = {x, y} in the
    block's own frame); moved pins are ringed on the canvas, listed in the
    block's Selection panel with a reset, and exported as pins_moved in
    floorplan.json. pinfit.js moves the interface pins of the macro, bias_gen,
    comp_ct, avg_sc, lpf_rc, r2r, Ctrim, dbg_tg, log_det and the chain's
    vcm / ibias to the edge facing their connections. On Matt layout 2 it
    takes the analog path from 658 to 205 um and bias from 227 to 7 um.
    Claude-Session: https://claude.ai/code/session_01EtsNGa6Q78QGdCW4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
2026-10-09 Floorplan: chosen layout (Matt layout 3, refined) with block positions and pin positions
    layout/floorplan/floorplan.json and pins.md: every block's placement and its
    pins by edge in its own frame (moved pins marked), for the block re-layouts
    and the macro re-harden (450.5 x 109.66, placed MY). From the page's
    'Matt layout 3 (Claude)': log_det MX at 60 um past stage 1, comp_ct and r2r in
    the band, avg_sc / Ctrim at the chain's output end, dbg_tg by ua[2], TX
    spacing fixed, decap refilled, pins on facing edges. Checks: no fails except
    the VAPWR decap area (47 %); rule 1 and 4 warn.
    Tools: page/refine.js (anneal around fixed blocks, facing-pin cost, decap
    refill; --decap-only) and page/pinrepo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
2026-10-09 sim/logdet/taps.py: successive detection tap by tap (tb_logdet, tt)
    0 V probe on each det_cell drain; 434 MHz tone -110..0 dBm. Each cell rises
    over ~15 dB and flattens when its tap limits (out -67.5, o5 -55, o4 -42.5,
    o3 -30, o2 -17.5, o1 -5 dBm), ~21 uA each; sum -13.3 mV/dB from -80 to -10 dBm.
    Plot: sim/plots/logdet_taps.png.
2026-10-09 PLAN.md: stretch goal: shared TX/RX antenna pins (half-duplex)
2026-10-09 Floorplan: MIM-only decap on top of r2r (+7 pF on VAPWR)
    r2r is met1-only, so a 65.3 x 52.1 um cap_mim_m3_1 decap can sit on top of
    it. The page allows a MIM-only decap rectangle on a block flagged for it,
    counts it at 2.06 fF/um2, treats it as a strap obstruction and excludes it
    from the area budget. Matt layout 3 (Claude): VAPWR ~24 -> ~30.6 pF; the
    right-edge straps move to x 488.0 / 489.7 / 491.4 to clear it.
    floorplan.json and pins.md regenerated.
    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
2026-10-09 README: RX is an NMOS diff-pair limiting chain + successive-detection log detector
2026-10-09 Handoff prompt for the pin moves and the macro re-harden; pinfit: facing edges, corners, no crossings
    docs/handoff_pins_reharden.md: instructions for the next session (new DIE_AREA
    and pin_order.cfg for radio_digital, with a trial-harden risk check first;
    per-block pin moves for lna_chain, bias_gen, log_det, lpf_rc, avg_sc, comp_ct,
    r2r, dbg_tg, Ctrim).
    pinfit.js: a pin goes on the edge facing its target, >= 1 um from corners, and
    pins on an edge take the order of what they connect to (no crossed buses: the
    42 TT pins and trim_out[7:0] now run in order). floorplan.json / pins.md
    regenerated.
    Claude-Session: https://claude.ai/code/sess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
2026-10-09 PLAN.md: the shared-antenna stretch goal under the new pin map (RX ua[0]/[1], TX ua[3]/[4])
    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
2026-10-09 Floorplan page: change the digital macro's area, not just its shape
    The macro's Selection panel gets an area field (with the % change against the
    hardened 49,400 um2) and buttons back to 260 x 190 and to the hardened area;
    the width slider keeps the chosen area. The top-right corner stays put and
    moved pins stay on their edges, scaled along them. Stored as est.macro.area;
    floorplan.json carries the new w x h with a re-harden note, and import reads
    it back. pinreport.js reports the area.
    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
2026-10-09 Floorplan page: select and move a group of blocks
    Shift-drag over empty space draws a selection box (blocks and visible decaps
    it touches join the group); shift-click adds or removes one. Dragging any
    member moves the whole group (0.5 um snap); arrows nudge it, the Selection
    panel shows the group outline and a move-by-x/y, Esc clears. Clicks now
    hit-test the block under a flyline, so flylines no longer swallow them.
    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
2026-10-09 Floorplan page: fold the chain (same area, half width) as a per-variant option
    A 'Fold in two' checkbox on lna_chain turns it into a 134.06 x 70.52 um block:
    the input half (input section, stages 1-2) is the top row with the inputs on
    the top edge, and stages 3-6 turn back along the bottom row. Pins, met4 /
    MIM and the rule zones are mapped through the fold; the block is hatched and
    marked as needing a re-layout; floorplan.json carries the fold.
    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
2026-10-09 Floorplan: model the TT pin channel as a staircase of the wires crossing each x
    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
2026-10-09 Floorplan: matt layout 4 (handoff), macro 200x220 at full height, middle strap set; rewrite the handoff prompt
    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
2026-10-09 radio_digital: 200 x 220 die (y-220 size sweep), 2-row top/bottom margins; trial notes in the handoff
    450.5 x 109.66 doesn't route (horizontal congestion, no met5); 220/210/200 x 220
    pass full signoff, 190 fails. pin_order.cfg is the trial's N/S order, to be
    replaced with the east-edge order from the matt layout 4 handoff.
    [pin_order.cfg]
2026-10-09 lna_chain: fold as a U for the tile (145.36 x 70.47 um, R180 over ua[0]/ua[1])
    Front row: input section, st1, st2 (stages mirrored so their wiring runs
    along the moat); a 14 um moat with a p-tap ring (VSS at one point) and an
    n-well stripe; back row: st3..st6 rotated 180, taps on the log_det edge.
    Cin tabs land right over ua[0]/ua[1]; rails of the two rows meet only at
    the VSS/VDD columns under the west straps.
    Clean (DRC, antenna, LVS). Extracted out/o5/o4 -> input zone coupling 0 aF.
    Stable at tt and ss 10 C; gain 0.44/0.47 dB below the straight chain
    (re-extracted with today's pex.sh), from the ~35 um o2 turn.
    Floorplan: blocks.json, floorplan.json, pins.md regenerated (variant
    'matt la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
2026-10-09 docs/future_flow.md: notes on a future analog layout flow (constraints-driven floorplan, generator rework, scripted router)
    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
2026-10-09 lpf_rc: in on the south edge, out at the top of the east edge (floorplan pins)
    in drops on met2 through a gap in the VSS rail's met2. DRC/antenna/LVS clean;
    tb pex tt: f-3dB 14.65 kHz (was 14.76), 434 MHz -106.9 dB (was -106.2).
    tb_lpf_rc / tb_dbg_tg / tb_r2r take OSIC from the environment, as the others do.
2026-10-09 dbg_tg: a / b on the south edge, en on the east edge (floorplan pins)
    b's met2 bar runs on down through the VSS rail (no rail met2 there); a turns down the
    west edge on met3 through a gap in the rail's met3 (x 1.0 vs the 3.7 target, still west
    of b: the en track now runs east and blocks a drop further in); en's track runs east
    over the b bar to the pin. DRC/antenna/LVS clean.
    tb pex tt: Ron 0.57 / 4.14 / 1.15 k, off -85.8 / -73.5 / -73.5 dB. The committed pex was
    stale: the old GDS re-extracted today gives the same (-73.6 dB), so no regression.
    lay.py: Block.clear() (a gap in a rail; also cuts the pin shapes, magic reads them as
    metal). rows.py: Net(pin=False) for an L / R track the generato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
2026-10-09 log_det: det on the south edge, ibias_det on the east edge (floorplan pins)
    det (met2, x 0.2): hops the bottom row's vb bus on met3, then down the left edge on met2
    (a met3 drop breaks capm.11 next to t4's Cc). ibias_det (met2, 87.08 / 24.29): from the
    vb riser up over the end column and right under the VDD strip. DRC/antenna/LVS clean;
    tb pex tt unchanged (idle 1.4888 V, 100 mV at t6: -1.46 mV).
2026-10-09 bias_gen: ib_chain / vcm / ib_det north, ib_comp east (top corner), en south (floorplan pins)
    The north edge is the top VSS rail: met2 pins cross it through gaps in its met2.
    ib_chain rises from the mirror's row-2 bus under the caps; vcm goes up on met4 from the
    Cvcm top-plate strip (pin layer met3 -> met4: met3 can't come within 1.34 of the capm);
    ib_det / ib_comp up the right margin, ib_comp hopping ib_det's column on met1; en drops
    from its track on met2 through the bottom rail. DRC/antenna/LVS clean; tb pex unchanged
    (1.8 V 27 C: ib_chain 59.31, ib_det 1.984, ib_comp 0.994 uA, vcm 1.201 V).
2026-10-09 comp_ct: pins for floorplan layout 5 (placed MYR90)
    inp (avg) / inn (lpf) on the N edge (faces west): met4 risers from the tracks' east ends,
    met3 east under the VDD rail, up through gaps in its met3. out / trim / ibias tracks run
    east and drop on three met4 columns at the east end (no crossings): ibias / trim on the
    E edge (faces south: the corridor west of Ctrim / Ctrim's trim pin), out on the S edge at
    the east corner (faces east, toward the macro). out / trim / ibias pins now met4. The
    channel packs one track tighter: 73.55 x 41.16 (was 73.45 x 41.97).
    DRC/antenna/LVS clean; tb pex tt unchanged: offset +0.560 mV, +0.0656 mV/LSB, 0.75/0.15 us.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
2026-10-09 ctrim_1p: Ctrim laid out (1 pF MIM, shunt cap trim -> VGND)
    22.035 um capm, 22.435 x 22.435 um block. Top plate (trim) contacted by an L of met4 strips
    (12 % met4): trim pins on the S edge near the W corner (placed MX: faces north, to
    comp_ct.trim) and on the E edge (to r2r out). Bottom plate (VGND, met3) pins on W / N.
    DRC/antenna/LVS clean against layout/ref/ctrim_1p.spice.
    Claude-Session: https://claude.ai/code/session_018bqJcUBhVcuyb7QsuMtUrw
2026-10-09 Floorplan layout 5: every block laid out to it; r2r MYR90; engine nets as the schematic
    - r2r flipped to MYR90: its S edge still faces the macro; out lands level with Ctrim's
    E-edge trim pin (straight met2 over r2r). Its N edge is a met1 VGND rail, so out can't
    move there (r2r stays met1-only). Macro trim_out[i] slots re-ordered to match.
    - Pins now come from the GDS (blocks.json regenerated): only the macro has moved pins.
    - engine.js nets as xschem/gen/top.py: comp inp = avg, inn = lpf (were swapped); Ctrim is
    a shunt cap on trim (was modelled in series); the real ctrim_1p cell when laid out.
    - floorplan_blocks.py: a label on a pin shape wins over same-name labels on internal wires.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
2026-10-09 avg_sc: in on the S edge (floorplan layout 5)
    in drops on met2 down the east edge to the S edge (toward lpf_rc out below): met3 can't
    (out's track runs to the edge; Cs's capm keeps met3 away), met4 can't (out's riser). phi1/2
    were already on the N edge (met4, v2). DRC/antenna/LVS clean; tb pex tt unchanged:
    Cs/(Cs+Cavg) 0.0302, tau 0.423 ms, drift +0.070 mV over 20 cycles.
    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
2026-10-09 radio_digital: re-hardened for floorplan layout 5; final views in macros/radio_digital/
    200 x 220 um, all 57 pins on the E edge (faces west, placed MY), met3, level with what
    they connect to: rx_en, comp_in, trim_out[7..0] (level with r2r b7..b0, MYR90), sc_phi2/1,
    dbg_en / tx_en_n / tx_en, then the 42 TT pins. Run l5b_200x220: 0 DRT / Magic DRC / LVS /
    antenna, setup ws 27.05 ns, hold ws 0.107 ns, every pin on its floorplan slot. 245
    max-slew warnings (marginal, as before). GDS / LEF / DEF / netlists copied to
    macros/radio_digital/ (runs/ is ignored); the cocotb GL default netlist points there.
    Claude-Session: https://claude.ai/code/s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
    [pin_order.cfg]
2026-10-09 Docs: blocks + macro done to floorplan layout 5; handoff for the top-level session
    docs/handoff_toplevel.md: the prompt for the next session (tile assembly, first routing
    with the net-by-net intent, DRC / LVS, end-to-end tests on a connectivity-only extraction,
    then full parasitics). STATUS / history / layout.md / floorplan_spec updated.
    tools/floorplan_dump.js + floorplan_draw.py: the tile with every net as a flyline.
    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
2026-10-09 Top level: 3x2 3v3 template, blocks placed from floorplan.json (TX in a tx_top subcell); west VAPWR strap
    layout/gen/top.py builds build/top/tt_um_mattvenn_radio.gds and build/top/pins.json (every
    block pin in tile um). The TX draws ~11 mA from VAPWR 215-270 um from the mid strap, so a
    VAPWR strap goes at x 2.5 (Matt, 2026-10-09).
    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
2026-10-09 Top level: grid router (layout/gen/route.py), check pipeline (check_top.sh, lvs_top_src.py), mid/east power joins
    route.py: A* on a 0.2 um grid over met1-met4, obstacles from the placed geometry bloated per
    net (MIM bottom plates keep a 1.2 um halo), per-net width / layers / costs / keep-outs.
    check_top.sh: TT power-pin precheck, KLayout + magic DRC, antenna, LVS against the xschem
    top with the block refs and the macro's powered netlist (baseline: macro and every block match).
    The mid and east straps are joined by met3 bars under / over the macro; its met4 stripes
    are extended to the bars and are power pins too.
    Claude-Session: https:/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
2026-10-09 Top level: all 93 nets routed, KLayout DRC 0 (first pass, decaps not yet in)
    - TT bus as a fixed two-layer channel above xdeca part 2 (met2 tracks for the west 24 pins,
    met3 for the east 18; columns over the MOS-only top of xdeca part 1)
    - enables leave the macro below the TT pins, cross part 1, go up the x 237-242 columns and
    west along the bottom of part 2; sc_phi over avg_sc and down the x 240 gap
    - tx_n down the chain's west column (4.6 um); tx_p necks to 2 um through a 2.6 um gap
    between the chain's stage MIMs (open point for Matt)
    - the full-width VDPWR bar (y 1.7-2.6) joins every VDPWR strap and feeds bias_gen
    - router: MIM halo (capm.2b_a), via pads, min area, notch closing, wi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
2026-10-09 Top level routing fixes from the first LVS / magic DRC
    - RX supply nets actually route now (the search tree started at their own pins: 0 length)
    - uio_oe[7]'s drop jogs clear of the west VGND strap (was a short); fixed geometry is
    checked against foreign metal
    - TX-internal and TX supply wiring drawn inside tx_top (hierarchical LVS)
    - no via2 within 0.1 um of a MIM (capm.8, magic); MIM halo keep-outs are not metal;
    0.4 um from > 3 um metal; sliver-free patches
    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
2026-10-09 Top level: TX supply nets reach the strap last (tx_top connected on its own); via3 keep-out at MIM edges (capm.5)
    LVS before this: every signal net, the macro and every block match; left are the decaps
    (not laid out yet) and VAPWR west / mid not joined (the decap rails will join them).
    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
2026-10-09 Decaps laid out (8 parts) and placed; their rails join the west / mid VAPWR and VGND straps
    layout/gen/decap.py: MOS-cap rows (thick oxide on VAPWR, thin on VDPWR; L 5, finger width
    fitted to the part) on comb met1 rails, MIM over them where the part allows it (VGND met3
    sheet, met4 top-plate bus); via stacks only in the edge bands, so met2 stays free for the routes
    that cross. Each part DRC / antenna / LVS clean on its own.
    Achieved: VAPWR ~20 pF MOS (6750 um2 g5 gate) + 23.3 pF MIM ~= 43 pF (target 50);
    VDPWR ~8 pF MOS + 2.7 pF MIM ~= 11 pF (target 30). Top of xdeca part 1 MOS only (TT staircase),
    xdecd parts 1/2 MOS only, xdecd part 4 dropped (in the TT channel).
    Tile: 95 / 95 nets routed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
2026-10-09 Decaps: MIM + met4 bus only in the strap-free span next to the supply stack (the bus ran under the VDPWR / VGND straps: short); pex_tile.sh
    Found with a metal-connectivity trace of the placed tile. Routed tile: VDPWR, VAPWR, VGND each
    one net, no merge; KLayout DRC 0. layout/pex_tile.sh extracts the tile minus the macro as a
    drop-in radio_analog for the end-to-end decks.
    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
2026-10-09 Top level: tile LVS clean (Circuits match uniquely), magic + KLayout DRC 0, power-pin precheck pass
    layout/pex_tile.sh flattens before extraction (the substrate becomes VGND, not a floating
    per-block VSUBS); sim/top/tb_tile.py runs tb_radio_analog with radio_analog from the
    schematic or from the extracted tile.
    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
2026-10-09 tools/power_r.py: DC resistance of every block supply pin to the power straps (mesh solve over the tile's traced metal)
    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
2026-10-09 Docs: handoff prompt for a power-delivery measurement session (magic rc + ngspice)
    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
2026-10-09 tb_tile: tie the tile's digital-pin stubs to VGND (1G) in a copy of the extracted netlist
    The c / rc netlists give those stubs (nc_* in the wrapper: the macro isn't extracted) wiring C
    and no DC path, so the op failed (singular matrix) and ngspice fell back to a transient op that
    returned unsettled nodes. That was the c-mode 'anomaly': lpf 0.89 V and the off current 1.59 uA.
    Tied, the c-mode op matches lvs: lpf 1.4915 V, off 0.910 uA, det at -60 dBm 1.204 V (sch 1.206).
    Also maps the deck's probes xana.<net> to xana.x1.<net> for the extracted modes.
    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
2026-10-09 sim/top/tb_tile_tx.py: TX-only runs of the extracted tile with caps dropped / kept per net, extra C or scaled devices (what-ifs)
    Split of the c-mode TX loss (sch 541 MHz +3.68 dBm; c 532 MHz +2.32 dBm, p arm duty 22 %):
    - ring C only: +3.93 dBm (frequency is not the loss); all TX C but the ring dropped: +3.87
    - output C (ua[3]/ua[4], ~80 fF): +0.05 dB; enable path: slow on/off 8 -> 2.5 ns, 0 dB
    - tx_drv internal C: +0.7 dB; ls internals: +0.2 dB
    - a/b (ls -> drv, 9 / 13 fF, about what the block extractions already had): +1.48 dB
    - schematic + 9 / 13 fF on a/b: 3.68 -> 2.86 dBm (duty 38 -> 29 %): the ls's weak A rise
    - extracted, ls PMOS pull-ups x2 (1.68 -> 3.36 um): +3.77 dBm, duty 36 / 52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
2026-10-09 sim/power: power-delivery study, extraction copy with the TT PDN and a supply mesh
    pdn.py: the TT PDN around the tile (tt-multiplexer): switched VDPWR / VAPWR met5 stripes
    from the power gates west of the tile, global VGND stripes, gate on-resistance.
    pdn_gds.py / pex_power.sh: magic rc of the tile with the PDN drawn in (one port per supply;
    substrate labels and p-taps removed so VGND resolves). mesh.py / r_mesh.py: magic's extresist
    lumps the supply nets into their ports, so the supply metal is traced and meshed (KLayout) and
    solved in ngspice: DC R from each block's device terminals to its gate / the VGND grid.
2026-10-09 sim/power/ir_rx.py: IR drop per block at the RX operating point and the TX arm currents (supply meshes in ngspice)
2026-10-09 sim/power: stitched tile (magic devices + C, supply mesh, TT PDN model) and the AC supply-impedance / TX->RX run
2026-10-09 docs/power.md: power-delivery benchmark of the routed tile (case A: R, IR, |Z|, TX->RX), method and TT PDN model; sim/power/tran_tx.py
2026-10-09 docs/how_it_works.md: theory, specs, schematics (xschem viewer), layout; info.md trimmed to test steps with current pins
2026-10-09 Precheck fixes: route.py clips the top cell to the die (bottom-edge pin pads hung to y = -1.6); layout/export_tt.sh writes gds/ + lef/ with USE POWER/GROUND on the supplies
2026-10-09 docs/how_it_works.md: overview uses the floorplan tool's block diagram; fix the dB power/voltage wording
2026-10-09 docs/verification.md: testing and verification (model, RTL, GL, per-block schematic vs layout, mixed signal, system level), linked from how_it_works and README
2026-10-10 Power benchmark: case B, TX-keyed transient, EM (west VAPWR strap 2x over), proposals in docs/power.md; STATUS line
2026-10-10 top_nets: antenna met4 jumpers into the macro (copied, with Matt's OK, from the main checkout's uncommitted working tree; the clean tile was built with them)
    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
2026-10-10 tb_tile_tx: report a variant whose arms stop switching (latched shifter) instead of crashing the sweep
    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
2026-10-10 tx_ls: kn 10 / kp 4 -> 14 / 8 (pull-downs 5.88 um, cross-coupled pull-ups 3.36 um)
    The p arm's duty collapsed (38 -> 22 %, -1.5 dB) under the extracted a / b load. Sized in the
    schematic with 14 fF on a / b (the load of the new TX floorplan) over ss/ff/sf/fs x 10/50 C:
    kn 10 / kp 8 latches at fs; kn 12-16 / kp 8 pass every corner. kn 14 / kp 8: tt +3.58 dBm,
    corners +3.24..+4.02, p duty >= 34.5 %; 18 fF on a / b still +3.49 tt. Layout 18.5 x 15.85 um
    (was 19.0 x 14.25); magic + KLayout DRC 0, antenna 0, LVS match. tx_ls_en unchanged (XOR 0).
    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
2026-10-10 Floorplan: tx_ls on top beside the ring (ring flipped so its out faces up), the two tx_ls_en underneath with an 11 um channel for a / b between them, each A over its driver's en pin
    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
2026-10-10 History: RX current on the new layout is 2.985 mA (as before); RC result confirmed on the regenerated tile
    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
2026-10-10 docs/verification.md: how to run every check (tools wrapper, tile build / extraction, per-block, corners, mixed, joined, tile runners, power); current results (tx_ls kn 14 / kp 8, TX +4.14..+4.26 dBm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
2026-10-10 Interactive explainer: docs/explainer.html, link -> TX/RX chains -> blocks with simulated waveforms, keyboard tour; source and sim script in docs/explainer/, linked via githack from README and how_it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
2026-10-10 Power what-ifs: wider straps (W), ideal straps, routing x3; strap widening options in the extraction copy; faster mesh solves (alter, no re-parse)
    Wider straps fix the TX EM / VAPWR R but not the RX: its ground R is the path through other
    blocks' rails. Recommendation in docs/power.md: wide west straps + VAPWR_TX met3 for the TX,
    dedicated wide RX trunks to the mid straps.
2026-10-10 docs/power.md: the remaining VAPWR met3 EM hotspot is tx_drv_p's own rail entry, not the route
2026-10-10 Docs: the top-level session's uncommitted notes (history / layout "Top level"), handoff_sim.md, STATUS state and next steps brought up to date (sims and power done; power fixes and the open RX runs n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
2026-10-10 sim/power/results/2026-10-10: raw benchmark and what-if results (baseline for the next layout)
2026-10-10 docs/handoff_power_fix.md: handoff for the power fixes (TX strap / rail feed / via3, RX dedicated trunks), how to verify against the 2026-10-10 baseline
2026-10-10 STATUS: power what-if result and pointer to docs/handoff_power_fix.md
2026-10-10 explainer: fixed header grid so the step buttons don't move as the breadcrumb changes
2026-10-10 Floorplan: wider power straps (west VAPWR 0.3-5.3, VDPWR 5.8-10.5, VGND 12.0-15.1, east VAPWR 481.0-489.22), as the power what-if W
    The page's strap check flags the east VAPWR strap as blocked by the macro: it tests the macro's
    bbox; the macro's nearest met4 is at x 480.04-480.37 (0.63 um clear). pins.md / variant_layout5.json
    also catch up with the TX moves of 75011bc (floorplan.json was edited without regenerating them).
2026-10-10 Top level power fix: TX driver VAPWR feed, dedicated RX supply trunks, VGND landing
    - VAPWR_TXF (fixed, in tx_top): each TX driver's VAPWR rail fed along its length, never through
    the other driver's rail (before: xdrv_p's current ran up xdrv_n's 3 um rail into its corner,
    the EM hot spot at (56.5, 120.5)). xdrv_n: met3 sheet + via3 into the 5 um west strap all
    along it; xdrv_p: met3 bar under the west straps, met4 bus, met4 strip over its rail.
    - RX trunks: one net per block (avg, comp, lpf, det, bias, ctrim, dac VGND; avg, comp, det, bias
    VDPWR) from the mid straps, w 4 (w_try necks to 3 / 2 / 1 only where needed); another block's
    rail is a foreign tag, so no block's current runs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
2026-10-10 explainer: LED readout opens the 2-of-3 detail and flags marginal levels, shorter distance slider, header subtitle removed
2026-10-10 Power fix results: docs/power.md "After the fix", raw A_fix results, routing picture
    Case A, 0.5 um mesh, on 08c44d1: the TX VAPWR EM fail is gone (via4 210 -> 42 %, met4 202 -> 29 %,
    met3 155 -> 30 %, via3 110 -> 15 %); RX VGND avg_sc 67 -> 14 ohm, comp_ct 57 -> 8; TX VAPWR drop
    at tx_drv_p 29 -> 6 mV average. Open: VGND_TX (62 % via3), dbg_tg (42 ohm, worse), mcon in tx_drv.
    tools/power_routing_draw.py draws route.py's RDUMP=1 shapes.
    Claude-Session: https://claude.ai/code/session_01RDXcRRAheChTcHDkULqBX4
2026-10-10 explainer: layout stays put as numbers change (fixed-width number slots, readouts never wrap, LED detail as readouts), equal-length dipole arms
2026-10-10 explainer: the link scene is the only navigation (boards, gap, LED, chip strip); bottom button row removed
2026-10-10 explainer: slider sets received power; distance is an estimate (bench fit to the ground-reflection breakpoint, two-ray model beyond); chip strip built with the page so the fit doesn't change on the f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
2026-10-10 explainer: one subject per page; the floorplan tool's system diagram is the chip page and, shrunk with the block lit, the map on each block page (replaces the TX/RX chain pages and split panels)
2026-10-10 Power fix 2: VGND_TX feed, dbg_tg trunks, em.py point-injection note
    - VGND_TXF (fixed, in tx_top): a 6 um met4 bus straight off the west VGND strap across both
    drivers' VSS rails, via3 onto each, met4 strips over their upper halves (VGND_TX landed on
    xdrv_n's VSS rail at one end: via3 62 %, met3 54 % of the EM limit, ~50 mV rise at TX peak).
    VGND_TX now only joins the ring and the level shifters to it.
    - dbg_tg: its own VGND / VDPWR trunks from the west straps (2 um, ~81 um; it was the one RX
    block left on the 1 um nets and got worse in the first fix: 42 / 37 ohm).
    - Router: close_notches uses the wide spacing for wide nets.
    - em.py: mcon / via1 lines over 50 % are flagged as point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
2026-10-10 explainer: block pages drop the close button (breadcrumb and Esc go back)
2026-10-10 explainer: Layout button (3D GDS viewer) next to Schematic; the step counter, caption and URL follow the page however it was reached
2026-10-10 explainer: links sit at the foot of the text column, smaller and on one line; the -94 dBm correlator step comes before the LED
2026-10-10 explainer: drop the repeated correlator step; the tour ends on the LED
2026-10-10 Power fix 2 results: all four power tests (R, IR, EM, |Z|) on 3ae64ca in docs/power.md "After the fix"
    EM every line < 50 % (mcon: point-injection artefact, ~9 % real); TX VGND rise 49 -> 15 mV peak;
    dbg_tg 32 / 26 -> 15 / 19 ohm; RX |Z| 2-3x lower, TX -> RX into log_det 0.59 -> 0.069 ohm.
    Worse: tx_ring / tx_ls VDPWR (7.3 -> 12.8 ohm, |Z| 18 -> 26): VDPWR_TX (0.8 um) to widen.
    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
2026-10-10 explainer: baseband sims at -94..-70 dBm in 4 dB steps (level follows the slider); lna_chain and log_det plots follow the slider; diagram fills the page, 'Radio functional diagram' and a Whole layout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
2026-10-10 explainer: link page counts the bursts (peak and pass/fail per burst, LED box) and the LED lights when the second detection lands; boards stay fully visible at the weakest power and get much closer a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
2026-10-10 explainer: boards centred vertically on the over-the-air box
2026-10-10 explainer: baseband plots show the real detector voltage (V), not the change from the no-signal level
2026-10-10 explainer: power slider greys out on pages it doesn't change (chip, transmitter, bias_gen)
2026-10-10 explainer: radio waves leave the TX at full strength and fade with the path model, more of them as the gap grows (true wavelength count shown), arcs centred on the TX, one per 'on' chip; lna_chain an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
2026-10-10 explainer: baseband sets at -110 and -100 dBm too (nine levels); level buttons show the number, one 'input level (dBm)' label
2026-10-10 explainer: bit slicer page shows the slicer itself: real comparator samples, 8 per bit, and the four phase-offset majority votes (animated); page 2 says a bit is ~45,000 carrier cycles
2026-10-10 explainer: Gold code page has seven DIP switches that build the code live (LFSR 1 xor delayed LFSR 2, as model/gold.py); bit slicer page shows the majority vote close up
2026-10-10 explainer: graphs between simulated levels interpolate the two nearest runs (straight blend for the detector, geometric amplitude for the stage waveforms; sampled bits use the nearest run); level but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
2026-10-10 explainer: Gold code page drops ' (this board)' after the DIP code
    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
2026-10-10 explainer: bit slicer page drops the vote close-up row, its 'n/n right' counts stay put (right-aligned, tabular digits); number keys 1-4 always jump to a page, even with the distance slider focused
    (made in the power session by mistake; template and the built page edited identically, not rebuilt:
    the baseband raws were being re-simulated)
    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
2026-10-10 explainer: lpf_rc page shows the carrier, the detector's rectified output and the filtered envelope at the slider's power; TX on/off times measured from the circuit sim (dipole swing vs enable), benc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
2026-10-10 Power fix 3: VDPWR_TX 0.8 -> 2 um (tx_ring / tx_ls); all four power tests and the lvs end-to-end deck
    tx_ring VDPWR 12.8 -> 1.8 ohm (baseline 7.3), tx_ls 21.2 -> 3.5, tx_lse 3.2 / 3.4; tx_ring |Z| 25.9 ->
    14.8 ohm. Nothing else moved; EM unchanged (every line < 50 %, the mcon point-injection artefact
    aside). tb_tile.py sch lvs: the same as the pre-fix layout in lvs mode (det -60 dBm 1.097 V, TX
    680 MHz). Checks: KLayout + magic DRC 0, LVS match, precheck pass, antenna 7 (macro), 0 shorts.
    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
2026-10-10 docs/power.md: log_det |Z| footnote names the probe nodes instead of guessed coordinates
    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
2026-10-10 explainer: log_det shows the keyed RF going in (as its envelope) with the detector's step, and a 40 ns zoom of the switch-on; text explains the detector's own ~20 MHz low-pass; lpf_rc text corrected 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
2026-10-10 explainer: log_det time plots get a zoom toggle (whole 3.5 us / 40 ns at switch-on) instead of separate zoom plots
2026-10-10 explainer: lpf_rc back to one plot (noisy detector vs filtered); baseband y axis trimmed (fixed top, bottom follows the signal, at least 120 mV); pages 14-15 plots at 70% height; trim page shows the 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
2026-10-10 gds/, lef/: tile re-exported with the power fix (wider straps, TX driver feeds, RX supply trunks)
    Built on main after the power-fix merge (geometry identical to the checked power-fix build):
    KLayout + magic DRC 0, LVS match, power-pin precheck pass, antenna 7 (inside the macro, as before).
    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
2026-10-10 explainer: baseband plots (13-15) share one locked y axis, from the strongest run's lowest point to the no-signal level
2026-10-10 explainer: slimmer header (smaller buttons, larger text, 77 -> 54 px), breadcrumb room widened to match
2026-10-10 explainer: LED page shows only the score plot (the best-score sweep stays on the correlator page)
2026-10-10 explainer: lna_chain stages use the same colours as log_det's taps
2026-10-10 explainer: functional diagram's amplifier stages, tap wires and log_det cells use the shared stage colours
2026-10-10 STATUS: power fix merged and exported; next steps before the shuttle (TX frequency, c / rc tile runs, joined RX on the tile, re-export + precheck, layout sign-offs); two ngspice jobs OK on the Mac
    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
2026-10-10 explainer: no distance label above the boards on the on-off keying and over-the-air pages
2026-10-10 explainer: lpf_rc says why the detector output is noisy (no narrow filter, 330-560 MHz accepted) instead of the model's 450 MHz noise bandwidth
2026-10-10 explainer: link model swept over the slider's whole range (-110 to -26 dBm), so the correlator and LED pages follow it above -60 too
2026-10-10 explainer: best-score plot's marker shows the slider's power instead of 'now'
2026-10-10 explainer: best-score plot's power label sits at the foot of the marker, clear of the curve
2026-10-10 tx_p neck 2 -> 3.4 um: a dog-leg through the chain gap (pinched on alternate sides by the stages' top-plate straps); gds/ re-exported
    tx_p_neck w_try 3.8 .. 2.0 (3.4 fits). Arm R ~1.15 ohm (tx_p) vs ~1.25 (tx_n). Checks: KLayout + magic
    DRC 0, LVS match, precheck pass, antenna 7 (macro).
    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
2026-10-10 explainer: RTL button on the digital pages (Gold code, bit slicer, correlator, 2-of-3 + LED, trim servo) linking their verilog/rtl source
2026-10-12 Full re-verification 2026-10-11 (sim-0, image 2026.09): docs/verify_2026-10-11.md
    Everything rerun against the docs on 91786fa and passing: RTL / GL 15/15, vectors bit-identical, tile + block signoff, all 14 block tests sch + pex, corners, power (R / IR / EM / |Z| identical to 'After the fix'), tb_tile c / rc on the power-fix layout. New: TX at 10 / 50 C, overload at -10 dBm, mixed signal on the extracted baseband, joined RX -90 dBm (matches the model after the plot fix), a 30 us on/off pair on the extracted tile. Moved: mixed -94 dBm (schematic) no longer detects with ngspice 47, so sensitivity is quoted at -92 dBm (how_it_works shows the -92 run). Tool trap: magic 8.3.684 drops substrate C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
2026-10-12 tools/pod_setup.sh: one-shot setup for a fresh pod inside the image
    Sets the repo's git identity and a credential helper that reads $GITHUB_TOKEN (set from a k8s Secret in the pod spec, nothing stored), builds magic 8.3.642 into ~/.local/magic642 (8.3.684 drops substrate C), installs pyvisa, and prints the pod's CPU quota. STATUS.md points to it.
    Claude-Session: https://claude.ai/code/session_01GJQKc9SmxYnVXeM81Rsb6U
2026-10-12 docs/plan_verify_gaps.md: phased plan to close the verification gaps (supply, mismatch, extracted-chain detection, TT pinout, overload, power-up), ring tuning excluded; linked from STATUS and verify_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
    Claude-Session: https://claude.ai/code/session_01BRv3mnQE4fptBU6ZACnJVs
2026-10-12 Revert "explainer: sensitivity -92 dBm": back to -94, which matches the link model's LED (decodes at -94, misses at -96)
    This reverts commit 7f376f9.
2026-10-12 STATUS: comp_ct inp pin is a dead-end stub (avg lands on the top of the inp run via a met4 hop over the VDD rail); fix for the next tile rebuild
2026-10-12 xschem: draw the schematics the classical way (wires, rails, textbook topologies)
    Generators now wire the circuits instead of labelling every pin: VDD / VSS
    rails, diff pairs drawn symmetric with the tail below, mirrors with a gate
    bar and diode wire, PMOS-over-NMOS inverters, side-by-side transmission
    gates, the R-2R ladder, cross-coupled level shifter; hierarchy levels wire
    the signal paths and label supplies / bias / clocks.
    tools/xsch.py: route / bus / rail / port / inv helpers, mos(body=...) uses
    the PDK's 3-terminal symbols (same netlist line), Sch.pin_order keeps the
    ports' netlist order. Every schematic's LVS and sim netlist is unchanged
    (byte-identical apart from the sch_path comme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
2026-10-12 lpf_rc schematic: flip C1 so its long C= text sits right of the cap, clear of R1
2026-10-12 explainer: storyboard order for the video: ambition (with the layout render) -> how weak the signal gets -> trick 1 OOK -> trick 2 the code -> chip -> payoff on the two-board page
    New link-level pages 'intro' and 'code'; the air and OOK pages reworded as the problem and trick 1;
    the two-board page becomes the closing 'Does it get through?' (tour ends at -88 dBm, ~32 m on the
    model, LED toggles). Breadcrumbs use a short name. Tour steps 2-4 pin -94 dBm so a take restarts
    the same. gendata embeds docs/explainer/layout.jpg (gds_render.png from gds run 38240028087);
    all other payload data unchanged.
2026-10-12 explainer: key 1 jumps to the start of the tour again (the two-board page is now the last step); → / Space / next after step 21 wraps to step 1
2026-10-12 explainer: number keys go to that step (two quick digits for 10+); moving between steps leaves the slider where it is (a step's power only applies when the page opens on it); ← / → change the step ev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
2026-10-12 explainer: no intro text on the transmitter / receiver diagram pages (same size as the whole diagram); lna_chain: 80 dB = 10,000x in voltage
2026-10-12 explainer: lna_chain stage plot keeps only the tone transient (the log_det CW sweep matched it within ~1-3 %)
2026-10-12 explainer: the two-board 'Does it get through?' page moves from the end of the tour to step 5, after the two tricks and before the chip
2026-10-12 explainer: the two-board LED keeps its state and flips once per send at the second detection (on, then off on the next send), as rd_rx.v does; it no longer goes dark at every loop. The burst strip sa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
2026-10-12 explainer: the page opens at -68 dBm (~10 m on the path model) whatever the step; tour steps no longer carry their own power
2026-10-12 explainer: page 1 drops the two-board animation (layout image only) and greys out the slider there
2026-10-12 explainer: the words move to docs/explainer/text.md (one section per page, tour order); press e to type into the page, saved through docs/explainer/edit.py
    text.md holds every heading, subtitle, page text and tour caption; template.html keeps the plots, links
    and order. The three texts with simulated numbers use {placeholders} (FILL in template.html). gendata.py
    embeds text.md; edit.py serves docs/ on localhost, gives the page the live file (/text.json), writes
    each edit back (/save) and rebuilds explainer.html in the background. Checked: all 21 slides show the
    same text as before; typing (including shortcut letters) saves to text.md; Enter / Esc leave a field.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
2026-10-12 explainer: distances account for the stronger transmitter (bench path loss + 12 dB: ~-32 dBm at 1 m, -94 dBm at ~90 m); page 2 plot shows the old-TX bench fit dashed and the new-TX line; README range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
    The bench sweep used the ttsky25b ring on a 1.8 V pad (-8.5 dBm into 50 ohm); the new TX gives
    +3.1 (extracted) to +4.1 dBm (schematic) into the 73 ohm dipole model. TX_DB = 12 in template.html.
    The page opens at -56 dBm (~10 m). text.md also carries Matt's own edits to pages 1 and 2.
    Edit mode now sends only the fields edited, and textfile.save merges them, so a stale tab can't
    overwrite other changes to text.md.
2026-10-12 explainer: TX power one value everywhere (TX_DBM +3.5, readout from it; text +3.5; tx_drv +4.1..+4.3 schematic / +3.1..+3.4 extracted per verify_2026-10-11); dipole swing as simulated (2.4 V p-p per 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
2026-10-12 explainer: units spaced (10 MHz, 16.5 cm, −94 dBm) in pages 1 and 2
2026-10-12 explainer: functional diagram: the chain tap labels (o1..out) sit halfway between lna_chain and log_det, clear of the chain's outline
2026-10-12 explainer: bit slicer figure: wider right margin so the 'n/n right' counts aren't cut off
2026-10-12 explainer: proofread: lna_chain uses capacitive degeneration (not interstage coupling caps); tx_drv is a NAND + five inverters to 144 um; carrier ~450-470 MHz (48,000 cycles per bit); ring is 22 inve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
2026-10-12 explainer: breadcrumbs follow the tour: Story › page (steps 1-5), Chip › Transmitter / Receiver › block; Story jumps to step 1; short names Range and Both boards
2026-10-13 plan_verify_gaps: ring dropped -> NINV dependency; <=28 ngspice threads on sim-0
    Claude-Session: https://claude.ai/code/session_013JYCC9QcWEbHXY6SmyF8bN
2026-10-13 Keep NINV 22: ~448 MHz on silicon, calibrated on both ttsky25b rings; no block change, verification gaps run on the current tile
    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
2026-10-13 Verification gaps phase 1: pinout check, TT-level cocotb, ladder-step check, extracted-tile pair mode
    - tools/check_pinout.py: info.yaml <-> top schematic <-> radio_digital macro (GL netlist, LEF);
    runs in the lvs action; --verilog writes the tt_um wrapper for test/
    - test/: tt_um-level cocotb (test_tx_codes, test_raw_and_straps, test_debug_strap through the
    TT pins, plus test_uio_oe vs info.yaml): 4/4 RTL and GL
    - plot_mixed.py: pin-order verdict on step sizes (>1 LSB fails) and missing steps; extra +-1
    steps counted, not failed. -94 dBm schematic: OK (4 extra); trim_out[1:0] swap: 588 steps of 2, fails
    - tb_tile_joined.py pair: the 2026-10-11 stand-in (its build/ scripts were lost),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
2026-10-13 Verification gaps phase 2: supply sweeps and comparator-path Monte Carlo
    Supply (VDPWR 1.71-1.89, VAPWR 3.0-3.6): RX gain/NF/det/comp hold, e2e -92 dBm
    12/12 at all 9 points, chain stable at 1.89 V ss 10 C, real-bias tile tracks.
    TX: tx_ls_en fails at 1.71/3.6 V (ss, fs extracted), weak at 1.71/3.3; extracted
    ring 332-545 MHz on silicon (x0.845), ss 1.71 V at the RX band's bottom edge.
    Mismatch: comp_ct offset sigma ~3 mV (65 % the pfet_lvt mirror); nominal sits at
    the trim knee, so ~26 % (tt/fs) / ~48 % (sf 10 C) of chips get a step > 0.13
    mV/LSB and lose 1-3 dB. avg_sc and lna_chain fine. Open at Gate 2.
    Tooling: VDD/OUT/NT on rx_corners.sh, --vdd/--vapwr/--pex-ring on tb_tx.py,
    --vdd/--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
2026-10-13 Verification gaps phase 3: system level on the extracted chip
    docs/verify_system_2.md: extracted-tile CW sensitivity within 0.5 dB of the model
    (block extractions 2.4 dB lower: open), G3 pair 1.36 mV, seeds -92 dBm 5/5 on schematic
    and extracted baseband, real-bias corners and rc tile at fs/ss/ff, overload (dead time
    < 0.1 ms, +6 dBm at the pads recovers), power-up at 10 us / 10 ms ramps and one supply
    missing. Sensitivity -92 dBm at 10-50 C, -90 dBm for every chip and at 85 C. Findings
    recorded, nothing in the design changed.
    New: sim/chain/cw_drop.py, sim/top/tb_powerup.py, sim/top/tb_pad_overload.py; tb_tile --cw,
    gen_det --seed/--overload, gen_mixed --seed/--tag, joined.sh PEX/NT, rx_co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
2026-10-13 explainer: Open in 3D viewer button under the opening layout image
2026-10-13 Formal: SymbiYosys proof of TX/RX safety, correlator timing and sc clocks
    formal/radio_digital.sby + fv_radio_digital.sv (RTL untouched; internals probed with
    connect -set; chip registers abstracted). prove: PASS. raw_rx: expected FAIL, raw mode
    keys tx_en from uio_in[2] in the RX role. A 1-clock reset can shorten the sc_phi dead
    time to 2 clocks (no overlap). Mutants of each property group fail as they should.
    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
2026-10-13 Comparator Monte Carlo rerun: distinct samples, each chip's own trim step
    The phase 2 MC drew duplicated samples: unseeded ngspice starts every process from the same
    AGAUSS sequence, so --jobs 8 gave 8 copies of 25 chips. tb_comp_ct.py now runs one sample per
    process with its own .options seed, and --step measures each sample's trim step at its
    switching point (vd = +-0.1 mV).
    Rerun at tt / ss / fs 27 C, 200 samples: 66-74 % of chips at -92 dBm, 17-24 % at about -90,
    8-10 % at about -88 dBm (steps up to 0.6 mV/LSB), 1/200 can't trim; the corner barely matters.
    Docs corrected (verify_supply_mc, verify_system_2 finding 1, verification, STATUS); seed trap in
    sim_learnings. avg_sc / lna_chain M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
2026-10-13 Handoff: comparator trim redesign (finding 1) for sim-0
    docs/handoff_comp_trim.md: why the trim is one-sided (the trim pair's sources sit at ~0.3 V, so
    ~1 mV of fine trim below the nominal point), the candidates (vref up, Rdeg 1.0-1.2 M, trim pair W 8),
    the first Monte Carlo (candidate A at tt: 99 % of chips at -92 dBm against 70 %), and the steps
    to a gate for Matt and then the implementation.
    sim/comp_ct/trim_curve.py: the trim transfer and trim-pair op for a comp_ct variant; writes the
    modified subckt for tb_comp_ct.py, which now takes COMP_SUB / COMP_PRM / COMP_TAG.
2026-10-13 comp_ct trim: curve summary and MC binning scripts, --vdd / vdd= on the benches
    trim_summary.py: vref, nominal code, flat step, fine and -92 dBm windows per trim_curve tag.
    mc_bins.py: step bins, can't-trim, code > 242 and duplicate rows per Monte Carlo file.
    tb_comp_ct.py --vdd and trim_curve.py vdd=: bench supply, trim sweep and LSB scale with it
    (default 1.8 V output unchanged).
2026-10-13 comp_ct trim redesign: candidates, Monte Carlo and e2e, gate table (handoff steps 1-6)
    verify_supply_mc.md 2.2: buildable vref taps, 200-sample Monte Carlo of 10 candidates at
    tt/ss/fs, ss 10, fs 50, sf 10 CM 1.45 and VDD 1.71/1.89, e2e at the worst corner. G129
    (Rdeg 0.9 MOhm, mirror W8 L2, trim pair W8, 28-segment vref string at 1.286 V) passes every
    condition; awaiting Matt's pick. New finding #10: comparator at sf 10 C, VDPWR 1.71 V.
2026-10-13 verify_system_2: the sf 1.71 V comparator finding is #12 (10 and 11 were taken)
2026-10-13 comp_ct trim gate: supply is nominal (measured 1.80-1.81 / 3.30 V); fs 50 C e2e at 1.8 V, H135
2026-10-13 comp_ct schematic: trim redesign H135 (Matt's pick at the gate)
    Mirror Mp1/Mp2 W 4 L 1 -> 8 / 2, trim pair M3/M4 W 2 -> 8, rdeg 2 -> 0.85 MOhm,
    vref VDD/2 -> 0.75 VDD (lref -> lref1 68 / lref2 204), dummies Mdn2 / Mdp1 to match.
    trim_curve on the regenerated netlist matches the H135 candidate exactly.
    tb_comp_ct.py and joined.sh params follow (joined.sh still had rdeg 1.4Meg).
2026-10-13 comp_ct layout: H135 trim redesign and the inp dead-end stub fix
    - trim halves W 1 -> 4 (M3/M4 W 8), mirror halves 2/1 -> 4/2 (Mp1/Mp2 W 8 L 2), Rdeg 0.85 MOhm,
    vref tap rr.links[15] -> links[7] (lref1 68 / lref2 204, asserted to be a bottom link)
    - mirror edge dummies W 4 L 1 (not L 2): build() lines each N device up behind the P device in
    the same place, so L 2 dummies pushed the N row and the block 1 um east; schematic Mdp1 follows
    - resistor band kept at its old depth (lanes 14.65 below the rail): footprint and pins unchanged
    (the bottom edge is 0.01 lower than the committed GDS: guard-ring pcell drift in this image,
    the unchanged generator gives the same)
    - merge_stubs: same-net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
2026-10-13 decap: write the VAPWR parts flattened (plan_verify_gaps 4.1)
    Per-device hvi markers merge with the part's own, so magic with gds maskhints (as the TT
    precheck) no longer flags hvi.5 on decap_vapwr_p1-p5 checked on their own. Geometry XOR-identical
    to before for every part; all 8 parts DRC 0 (magic, KLayout) and LVS match.
2026-10-13 Tile rebuild with the H135 comparator, the inp stub fix and flattened decaps; gds/ lef/ re-exported
    - route: avg 12.2 -> 7.6 um, 2 -> 1 vias, landing on inp's new met4 pin (the riser's end): the
    dead-end met3 stub and its VDD-rail gap are gone; lpf / inn unchanged. ib_comp / trim move
    0.2 um (comp_ct's bottom edge is 0.01 lower: guard-ring pcell drift). Everything else identical.
    - check_top: TT precheck PASS, KLayout + magic DRC 0, LVS match; magic antenna 7 (the known ones
    inside the macro)
    - LEF: VDPWR antenna gate area +4 um2 (comp_ct's mirror dummies W 2 -> 4); GDS 9.4 -> 10.5 MB
    (flattened decaps)
    - mixed signal, schematic, -92 dBm: pin order OK, servo 128 -> mean 177.8 (170-18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
2026-10-13 CI lvs: pinout check follows wires; run this repo's tile LVS on gds/
    - check_pinout.py: the top schematic has wires since eb17f19 (2026-10-12); the parser only took
    labels placed on pins and exited. It now joins wire ends and anything lying on a wire (union-find)
    and names each group from its lab_pin / iopin. Agrees with xschem's netlist (--xschem); a crossed
    tx_en / tx_en_n wire pair is caught.
    - lvs.yaml: was the TT template's mag/ flow (no .mag or src/project.v in this repo) with a PDK hash
    volare doesn't have, so it failed at the PDK install since at least 2026-10-07. Now: magic 8.3.684,
    netgen 1.5.323, xschem 3.4.7 built (cached), sky130 1689ac3f via ciel (cached), then
    chec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
2026-10-13 sim/rerun: a CPU-budget job scheduler and the full-rerun job list (plan_verify_gaps 4.2)
    sched.py: jobs with threads / est / deps / lock / stagger; starts the longest ready job while the
    running threads stay within --budget and the load average allows; re-reads the job file when it
    changes; a failed job whose command changed runs again; status in build/rerun/status.json.
    jobs_2026-10-13.py: 236 jobs (layout signoff, digital, per-block sch/pex, corners, supply, mismatch,
    mixed signal incl. seeds / extracted / overload / the bit-swap check, joined RX, extracted tile,
    power-up, pad overload, power delivery), ~410 thread-hours.
2026-10-14 sim/rerun: scheduler fixes found during the 2026-10-13 rerun; job-list fixes
    sched.py: a job that doesn't fit the load limit no longer stops the scan (break -> continue: 12 CPUs
    sat idle); long jobs reserve their threads (an 8-thread job starved behind 4-thread ones); a skipped
    job is requeued once its deps recover; a restart adopts jobs an earlier instance left running (alive =
    still its own session leader; state 'exited', judged by its log) instead of starting duplicates;
    stagger groups. Tested with dummy jobs (kill mid-run, restart, deps, budget).
    jobs: tools/osic exit status ignored where the output files tell (gl_models, netlists); TX bench
    staggered and split per corner; tile_scan / ti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
2026-10-14 Full verification rerun 2026-10-13/14 (plan_verify_gaps 4.2): docs/verify_2026-10-13.md
    261 jobs OK, 0 failed (sim/rerun scheduler, ~10 h on sim-0). Everything matches 2026-10-11/12
    except by design (H135 comparator: -92 dBm 6/6 sch and extracted, MC 99.5-100 % at every corner;
    -94 dBm now a best case) and:
    - new finding #13: overload recovery 0.25-0.3 ms after a -10 dBm burst (was < 0.1 ms)
    - amp_dp / amp_dpc extracted netlists re-extracted with magic 8.3.642 (committed ones were from the
    2026.05 image): block tests -0.23 / -0.45 dB
    - avg_sc VGND R 14.21 -> 14.36 ohm
    Mixed-signal plots updated for the new comparator. STATUS, verification.md, plan_verify_gaps updated.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
2026-10-14 comp_ct schematic: show the vref divider and Rdeg values
    Text notes generated from COMP_PARAMS (Rr1 / Rr2 68 / 204 um -> vref 1.35 V,
    Rdeg 0.85 Meg = 115.3 um), so the parameterised L values are readable on the
    sheet. Title: "trim vs VDD/2" -> "trim vs vref" (stale since H135). Text only,
    netlist unchanged.
2026-10-14 comp_ct schematic: show the main pair's w1 / l1 values
    Text note between M1 and M2 (W = w1 = 20 um, L = l1 = 1 um, nf = 4), generated
    from COMP_PARAMS. Text only, netlist unchanged.
2026-10-14 comp_ct schematic: show Mt1, Mta and Cl values
    Every parameterised device on the sheet now has its value next to it:
    Mt1 W = 0.455 x mt1 = 4.55 um, Mta mult = mta = 2, Cl = 2 x 22 x 11 um
    (0.99 pF). Generated from COMP_PARAMS. Text only, netlist unchanged.
2026-10-14 Schematics: show every parameterised device's value next to it
    tools/xsch.py value_notes(): evaluates each device whose W / L / mult / MF /
    value is a parameter or formula with the sheet's chip values and writes the
    result beside it (fets as 'm x W / L' like the symbol's own label, poly R
    from the fitted R(L) the generators size with, MIM C, a subcircuit's
    parameters inside its box). Per-device offsets where a note landed on
    something; every sheet rendered and checked.
    Sheets: amp_dp, amp_dpc, lna_chain, bias_gen, det_cell, log_det, avg_sc,
    lpf_rc, tx_ls (both uses: tx_ls / tx_ls_en), tx_ring, dbg_tg, the decaps,
    radio_analog (Ctrim). comp_ct already had hand-placed notes.
    amp_dp's symbol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
2026-10-14 tx_ls schematic: say why its value notes have two lines
    Note under the title: the sheet is placed 3 times in tx_top at two sizes,
    xls (ring -> arms) and xlse_p / xlse_n (arm enables), with each size's
    parameters, generated from LS_PARAMS / LS_EN_PARAMS. Text only.
2026-10-14 explainer: Zero to ASIC brand: logo and header art in the top bar, brand palette and font, course link in the footer
    The violet-grey neutrals and cyan accent are sampled from the Zero to ASIC
    header art; trace colours are unchanged. brand_header.jpg is a 37 kB strip of
    that art, embedded by gendata.py in place of /*__BRAND__*/. The footer's
    duplicate 'More details' link is gone (each page has the button).
2026-10-17 LVS: fail on property errors; decap schematics match the layout
    netgen prints "Final result: Circuits match uniquely" even when device
    properties differ, then "Property errors were found". check_top.sh,
    check.sh and the lvs action only looked for the match line, so they would
    pass with W / L / m mismatches. They now fail on property errors too.
    The tile LVS also swapped the schematic's decaps for the layout
    generator's own layout/ref/decap_*.spice, so the decaps were checked
    against themselves. The schematic said n = 100 / 30 units (~50 / ~30 pF);
    the layout has less. xschem/gen/decap.py now lists the laid-out devices
    (4 MOS + 5 MIM sizes on VAPWR, 3 MOS + 1 MIM on VDPWR, ~43 / ~11 pF est.)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
2026-10-17 Tile LVS: schematic side from the top netlist alone; catch subcell property errors
    lvs_top_src.py swapped each laid-out block for layout/ref/<block>.spice, which
    the layout generators write with their own copy of the parameters, and threw
    away the instance parameters in the top schematic. A parameter changed in the
    schematic but not in the layout still passed.
    It now builds the schematic side from the xschem netlist only: every
    parameterised subckt is elaborated per instance (instance values, evaluated in
    the parent's parameters, over the .subckt defaults), and two instances mapping
    to one layout cell must give the same devices. Plain C/R/L wiring estimates
    (tx_ring's cw) are dropped, xlse_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
2026-10-17 Chain stability: use the real VDPWR decap, rerun
    stability.sh put an ideal 30 pF (the planned decap) between chip VDPWR and
    chip ground. The decap that fits is decap_vdpwr, 10.6 pF (decap_ac.sh:
    10.56 pF, ESR 0.18 ohm; VAPWR 42.6 pF), which moves the 2 nH supply
    resonance from ~650 MHz to ~1.1 GHz, so the earlier runs didn't cover the
    chip. The script now netlists xschem/decap_vdpwr.sch (simulation netlist,
    from the repo root for the xschemrc) and uses that subckt by default;
    CDEC=<value> keeps an ideal C.
    Rerun of the 2026-10-13 sets (tt, ss 10 C, ss 10 C 1.89 V), real decap and
    ideal 30 pF side by side (docs/stability_2026-10-17.md): every case decays
    up to 0.1 fF of out -> in coupling, 1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
2026-10-17 explainer: Google Analytics 4 (the zerotoasiccourse.com stream, G-2HQ02ESFZB) with events for step, power, DIP and zoom; newsletter box after 5 interactions (Mailchimp JSONP, same list/groups/tag as 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
2026-10-17 explainer: newsletter box: when Mailchimp asks for a captcha, a Continue button finishes the sign-up on Mailchimp's page in a new tab (was: showed 'captcha' as an error)
2026-10-21 explainer: sensitivity -92 dBm (H135), LED as a rate, block areas and cell counts
    - Link model: 12 sends per level with the H135 tt settings (as e2e_h135_tt): 12/12 at -92 dBm, 7/12 at -94.
    The LED readouts and the two-board picture show n/12 (green / amber / red); the animation replays a
    majority send. Sweep cached in build/explainer_model.json, rerun when MODEL changes.
    - SENS -92 dBm (>= 99 % of chips, verify_2026-10-13.md); range ~80 m in text.md and README.
    - Block pages: analog area (layout bbox x instances) or digital cells per RTL module (yosys, hierarchy kept);
    opening page: analog 52.6k um^2 (20.6k decap), digital 2,356 cells. docs/explainer/sizes.py -> sizes.json.
    - how_it_w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
2026-10-23 radio_digital: signoff reports for the shipped macro (DRC, LVS, 9-corner STA)
    The original run folder wasn't kept and a re-harden doesn't reproduce the
    layout (same logic, different antenna diodes), so LibreLane's signoff steps
    were run directly on the shipped GDS / DEF / netlists. DRC 0, LVS match,
    setup ws 27.05 ns, hold ws 0.107 ns, as recorded for the original run.
    repro/run.sh re-runs it in ~1 min.
2026-10-24 info.yaml: pinout describes the reset straps (magic uio[7:4]=1010, debug, monopole) and raw mode
    check_pinout.py PINOUT updated to match; pinout check passes.
2026-10-24 how_it_works: one spec list with the source of every number (schematic / extracted / model / bench / RTL)
    TX frequency ~448 MHz (was ~460); sensitivity split into mixed-signal, comparator Monte Carlo (schematic) and
    model. bringup.md points at the list instead of its own table; R11 overload dead time 0.25-0.3 ms.
2026-10-29 explainer: phones and tablets: slider and step buttons in a bar at the foot of the screen (the slider stays in reach of the plot it changes), header is brand + breadcrumb up to 1000 px, chip pages ge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
2026-10-29 lna_lo strap, schematic + RTL: lna_shunt (1p41 393 ohm + PMOS W 15 / L 0.15 + 20k gate R) across o2p/o2n, lna_lo_n pin through lna_chain / radio_analog / tt top; radio_digital latches lna_lo at reset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
2026-10-29 lna_lo strap, lna_chain layout: lna_shunt drawn at the moat's turn end beside the o2 columns (Rg xhigh 20k, Msw PMOS W 18 nf 6 in its own n-tap ring on the moat's VDD m3, Rh_a / Rh_b high_po_1p41 L 0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
2026-10-29 lna_shunt: gate filter cap Mcap (PMOS W 5 / L 5, ~210 fF, gi -> VDD) with Rg 20k: ~40 MHz low-pass on the strap at the switch. Layout: Mcap west of Rg in its own n-tap ring (VDD riser to the moat's V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
2026-10-29 lna_lo strap: radio_digital re-hardened with lna_lo_n (E edge slot 2, macro y 3.06; every other pin unchanged), LibreLane 3.0.3 run lnalo: magic DRC 0, LVS 0, route DRC 0, antenna 0, setup WS 27.11 n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
2026-10-29 lna_lo strap: tile re-placed / re-routed (layout/gen/top.py + route.py, 112/112 nets, lna_lo 338 um) with the new lna_chain and radio_digital, exported to gds/ + lef/. check_top: precheck PASS, KLayo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
2026-10-29 docs/substrate_2026-10-29.md: output -> input coupling through wires (kpex 2.5D, halo 8-200: <= 0.3 aF asymmetric from the output wires; magic's 0 aF was its 8 um sidehalo) and substrate (3D conducti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
2026-10-29 route.py: a via whose pad misses the global cut grid gets a local centred array when >= 2 x 2 cuts fit, not one cut (the array's cuts keep the router's single-cut MIM margins: capm.8 / capm.5). 1 um 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
2026-10-29 Tile re-routed with the router via fix and exported to gds/ + lef/ (112/112 nets): KLayout DRC 0, magic DRC 0, LVS match, precheck PASS; antenna 7, all inside the macro (as main)
2026-10-29 lna_lo strap docs: docs/handoff_lna_lo.md (what changed, results so far, the verification list for the big computer); bringup.md R0 oscillation check / R13 low-gain test / D6b, the 1011 strap in info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
2026-11-04 explainer: page 4 (Trick 2) shows despreading: comparator input as ±1 plus noise (spread from the link model's wrong bits at the slider's power), the receiver's code copy coloured by agreement, and t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
2026-11-04 lna_lo strap: port-order fallout in the benches. tb_logdet ties lna_lo_n to a Vglo source (.param vglo, 1.8 = off; it was an unconnected net, the switch gate floating); pex_tile.sh / pdn_gds.py / pow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
2026-11-04 Strap options for the verification: tb_tile / tb_tile_joined --vglo= (files tagged _glo0); noise_tran.sh VGLO / TB / TAG; gen_det.py --gain / --nf / --tag (low-gain detector waveform); mc_chain.py on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
2026-11-04 Verification job list for lna-lo-shunt (sim/rerun/jobs_lna_lo.py): the 2026-10-13 set plus the handoff's new checks (GL strap test, extracted-chain stability and MC in both strap states, low-gain noi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
    Claude-Session: https://claude.ai/code/session_011q23dTmz3SSHp3t9Ueb5Nz
2026-11-04 Formal harness: the strap magic is 1010 or 1011 (the RTL's uio[7:5] = 101), and a new property: lna_lo_n is 0 exactly when 1011 was latched at reset. prove: PASS (abc pdr, 2139 s); it failed before o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
2026-11-04 kpex / substrate scripts for the lna_lo strap layout: flatref.py knows lna_shunt (xsh -> sh_ nets), keeps a pfet's n-well bulk, rounds a resistor L within 1 nm of the 0.01 um grid to nearest (Rg 2.71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
2026-11-04 kpex FasterCap check of the st5 / st6 Cs plates <-> g1 corner: fccut.py (met3 / via3 / met4 / capm cut of the flat chain, nets labelled from the LVSDB), fcsum.py (asymmetric coupling from the FasterC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
2026-11-04 explainer: header title links back to the first page (logo and Zero to ASIC still go to the course); lna_chain dots describe themselves on hover (antenna open-circuit, chip input after the pad, each 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
2026-11-04 sim/power/stitch.py: match the radio_analog instance's supply ports without the '+' (the lna_lo_n port moved tx_n onto the continuation line; pwr_tran_tx failed the (1, 1, 1) check); re-queue pwr_tra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
2026-11-05 sched.py: only one waiting long job reserves threads (three 8-thread noise_tran jobs each reserved, 24 of 26, and the queue sat at load 7 from ~midnight to 07:25); noise_tran jobs declare 3 threads (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
2026-11-05 gen_mixed.py: lpf / avg .ic from the det waveform before the burst (was a fixed 1.438 V, the full-gain level: in low gain the averager charged ~2 ms and the servo settled after the burst), one 0.9 V 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
2026-11-05 sim_learnings: d_cosim can lose a slow analog edge at an adc_bridge (the low-gain trim servo runaway); TODO a minimal repro for an ngspice bug report
    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
2026-11-05 docs/verify_lna_lo.md: the handoff's 9 items on sim-0. Pass: 1, 3, 6, 7, 8, 9; item 2 matches 2026-10-13 (chain / RX -0.5...-0.7 dB extracted as predicted) except the overload gap scan; FAIL: 4 (extr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
2026-11-06 lna_shunt schematic: drawn the classical way like the other sheets (series path a - Rh_a - Msw - Rh_b - b top to bottom, gate column VDD - Mcap - gi - Rg - g, wired ports) instead of a label on every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
2026-11-06 verify_lna_lo item 4 follow-up: the FAIL is on the block extraction (verify_system_2 finding #5's pessimistic bound); tile extraction step 11.9 dB tt / 10.1 dB sf; low gain stabilises the chain at sf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
2026-11-06 verify_lna_lo / STATUS: item 4 passes on the full GDS extraction (Matt, 2026-11-06): step 11.9 dB tt / 10.1 dB sf; the block extraction (finding #5's pessimistic bound) fails 9 dB at sf but low gain 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
2026-11-06 item 5 passes as the model predicts (Matt, 2026-11-06): the -88 dBm dip was the mixed bench's fixed burst timing against the slicer's 4 of 8 phases; sim/mixed/replay_corr.py replays the RTL detection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
2026-11-06 docs: low-gain strap numbers as verified (verify_lna_lo.md): ~3 dB of sensitivity (reliable ~-86 dBm, 50 % ~-89, vs -92), not the model's ~5 dB / -88 vs -93; chain cut 10.1-11.9 dB on the full GDS ex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
2026-11-07 bias_gen noise at the comparator: sim/bias/bias_noise.sh (.noise at det, ideal vs real bias, tb_logdet at idle) and bias_noise.py (LPF - average weighting, per block / device). 0.04 mV rms at all 5 c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
2026-11-08 docs: verification.md brought up to the lna-lo run; overload restatement and few-chip e2e decision recorded
    - verification.md: last full run is now 2026-11-04/05 (verify_lna_lo.md); RTL / GL 16/16, TT 5/5,
    formal lna_lo_n property; lna_chain row gets the strap (step, stability, cost); low-gain sensitivity;
    mixed bench fixes + replay_corr.py; overload is ~2-3 dB desensitisation for ~1 ms, not a dead time;
    tile / pair / power-delivery numbers from the rerun; finding #5 progress; "full GDS extraction"
    - verify_system_2.md: pre-H135 overload lines point at finding #13, whose row is restated (2026-11-06);
    finding #8 records the few-chip dipole-to-RTL run as considered and judged low value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
2026-11-08 DC oddities from the lna-lo rerun are sim artefacts: rc off current was an invalid op, "off in nan" a short window
    - rc tile op_off 9.11 uA (tt 10 C) / 1.517 uA (fs 50 C): the op passed with KCL unbalanced at the TX enable
    NAND output (ring 1.78125 V, 4.1 uA per pull-up, nothing sinks it; values on a 1/512 V grid). With
    .nodeset ring = VDD: 0.908 / 0.945 uA. tb_tile.py now sets the nodeset, prints ring on op_off, warns if
    it is > 1 mV off VDD. tt 27 / tt 50 / ss 10 / ff 50 already clean.
    - sch ss 10 C 1.71 / 3.0 V "off in nan ns": arms release ~18.5 ns after the key (finding #4, as supply_mc),
    the envelope crosses 10 % after the 80 ns run ends; 21.0 ns run to 120 ns. tx_explore print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
2026-11-13 docs: Harald Pretl design review (2026-11-13), small corrections, two handoffs
    - docs/review_harald_2026-11-13.md: summary, his 18 points checked against the repo, actions 1-15, Matt's decisions
    - how_it_works.md: input impedance row (not matched: 2 pF + 20 kOhm behind the pad, no band-pass)
    - verification.md: lna_chain row leads with the current stability result, strap included
    - bringup.md: adapter board in the equipment list; "If the chain oscillates" rescue networks on the input
    - handoff_chain_stability_ac.md (actions 4-6, branch chain-stability-ac), handoff_eqy.md (action 7, branch digital-eqy)
    - STATUS.md: pointer
    Claude-Session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
2026-11-13 eqy: clock-source check (eqy assumes one global clock), pnl.v vs nl.v, planted-bug self-test (4/4 caught)
    clocks.py: each flop on the same source (clk or the same clock gate) in RTL and netlist.
    strip_pg.py: pnl.v minus power pins is the same 6931 statements as nl.v.
    plant.py: corr_and (or2 -> and2 in the clock-gate enables), tx_mux (TX enable mux inputs
    swapped), acc_top (popcount top bit), clk_swap (sr0[5] on the wrong gated clock: eqy
    passes it, the clock check catches it). run.sh ~15 s in all.
    Claude-Session: https://claude.ai/code/session_011q23dTBe4dhUHAiw8Utyxs
2026-11-13 eqy GitHub action: formal/eqy/run.sh (check, clocks, pnl, planted bugs) on every push, oss-cad-suite 2026-09-30 + the lvs PDK cache
    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
